AritraD11/NarrowAisleBot/data/bench_logs/README.md

# NarrowAisleBot — Bench & Ground Test Log

Every telemetry CSV pulled off the Pi, plus a full analysis (report + plots)
for each, generated with `tools/analyze_bench_log.py`. This is the running
record for the PID/feedforward calibration effort — see
`docs/PID_Calibration.md` for the derivation these runs feed, and
`docs/Research_Journal.md` Part XVI for the narrative.

**Branch:** all calibration work (CSVs, analysis, gain updates) lives on
`claude/nab-hardware-calibration`.

## Layout

```
data/bench_logs/
  bench/              wheels in the air, robot on blocks
    run_*.csv
    analysis/
      run_*.md         per-run report
      run_*_tracking.png
      run_*_error_pwm.png
  ground/              robot on the floor, real load
    run_*.csv
    analysis/
      (same structure)
```

## How a new CSV gets in here

```bash
# 1. Pull new files from the Pi (Windows, incremental — skips what you have)
tools\sync_bench_logs.ps1

# 2. Analyze it (writes <name>.md + two PNGs into ./analysis/ next to the CSV)
./tools/analyze_bench_log.py data/bench_logs/bench/run_XXXXXXXX_XXXXXX.csv

# 3. Commit CSV + analysis together, on claude/nab-hardware-calibration
git add data/bench_logs/
git commit -m "..."
```

## Bench runs (wheels in air) — summary

| Run | Date | Firmware | Type | Worst RMS error | PWM sat | Sign faults | Verdict |
|---|---|---|---|---|---|---|---|
| [`run_20260702_183233`](bench/analysis/run_20260702_183233.md) | 2 Jul 2026 | v2.0, shared CPR=93132 | live drive | RR 4.5% of peak | 0% | 0 | Loop healthy under old gains. **Not usable to tune v3.0** — predates the per-motor CPR fix and is a continuous drive, not isolated steps. |
| [`run_20260804_193703`](bench/analysis/run_20260804_193703.md) | 4 Aug 2026 | v2.0, post encoder/CPR fix | live drive | RL 2.4% of peak | 0% | 0 | First run on the corrected encoder path. Confirms hardware health, still not isolated steps. |
| [`run_20260805_140048`](bench/analysis/run_20260805_140048.md) | 5 Aug 2026 | **v3.0** — recalibrated gains, two-term FF, per-motor CPR | scripted steps | RR 1.4% of peak | 0% | 0 | **Best tracking yet.** Confirmation run before the Block 1 plant/staircase/steps calibration sequence. |

Trend: worst-motor tracking error has gone 4.5% → 2.4% → 1.4% across the three runs, tracking each firmware/hardware fix in order (encoder/CPR fix, then the v3.0 gain recalibration). None of the three is a step-response or PWM-staircase test, so none of them can be used to *fit* `Kff`/`Ki`/τ — that's what `tools/nab_pid_logger.py`'s `plant`/`staircase`/`steps` tests are for. These three are the "is the loop healthy" checkpoints along the way.

### Plant ID and `Kp` verification, 14 Sep 2026

The run that finally *is* a step-response test, plus the closed-loop sweep
that checked what it implied before anything got flashed. Full derivation
and the reasoning: `docs/PID_Calibration.md` §5.

| File | What it is | Result |
|---|---|---|
| [`plant_20260914_164105.csv`](bench/plant_20260914_164105.csv) | Open-loop, PID bypassed, 6 PWM steps per motor | `K` measured to within 0.5% of the existing feedforward fit; τ ≈ 0.09 s by the tool's pre-send timing, ≈ 0.04 s by an independent timestamp-relative refit, see the caveat below |
| [`sweep_kp45_ki250_kd0.5_20260914_164953.csv`](bench/sweep_kp45_ki250_kd0.5_20260914_164953.csv) | Closed-loop steps, shipped gains (baseline) | Mean overshoot **0.107 rad/s** |
| [`sweep_kp22_ki250_kd0.5_20260914_165007.csv`](bench/sweep_kp22_ki250_kd0.5_20260914_165007.csv) | Closed-loop steps, `Kp` recomputed from the robust τ | Mean overshoot **0.164 rad/s**, +54% |
| [`sweep_kp26_ki250_kd0.5_20260914_165022.csv`](bench/sweep_kp26_ki250_kd0.5_20260914_165022.csv) | Closed-loop steps, `Kp` recomputed from the raw τ | Mean overshoot **0.153 rad/s**, +43% |

All four overshoot and steady-state-error figures were independently
re-derived from the raw CSVs (plateau-windowed on the true setpoint sequence
rather than trusting the console printout) and matched the tool's own
output exactly. `Kp = 45` wins on overshoot in 16 of 16 setpoint-motor rows
against both candidates. **Verdict: `Kp` stays at 45.** Nothing was flashed.

**The τ discrepancy, and why it doesn't matter here.** The plant CSV's own
timestamps are heavily batched: about 69% of consecutive samples share a
near-identical arrival time, with the gap concentrated into roughly every
third sample (~60 ms), rather than the nominal 20 ms telemetry period
being evenly spaced. Refitting τ relative to when the PWM column itself
changes (immune to the Pi-side pre-send latency the tool's own timing
includes) gives τ ≈ 0.04 s, about half the tool's ≈ 0.09 s. Neither number
is resolvable to better than roughly one telemetry burst period given this
batching, and it does not change the outcome: both readings imply a `Kp`
below the shipped 45, and both implied candidates already lost the
closed-loop sweep. The open-loop number was never what closed this
objective: the sweep was.

## Ground runs (on the floor)

| Run | Date | Firmware | Type | Worst RMS error | PWM sat | Sign faults | Diagonal dev. |
|---|---|---|---|---|---|---|---|
| [`run_20260806_152810`](ground/analysis/run_20260806_152810.md) | 6 Aug 2026, 15:28 | v3.0, air-calibrated gains | live drive, full weight | RL 4.0% of peak | 0% | 0 | 0.036/0.035 rad/s |
| [`run_20260806_183540`](ground/analysis/run_20260806_183540.md) | 6 Aug 2026, 18:35 | v3.0, air-calibrated gains | live drive, full weight | RR 3.1% of peak | 0% | 0 | 0.044/0.044 rad/s |
| [`run_20260806_184938`](ground/analysis/run_20260806_184938.md) | 6 Aug 2026, 18:49 | v3.0, air-calibrated gains | live drive, full weight | FL 4.1% of peak | 0% | 0 | 0.045/0.045 rad/s |

All three: loop stable on real ground, zero saturation, zero direction-sign faults. Diagonal deviation (matched-target samples — see below) is tight and consistent across all three sessions, several hours apart: **0.035–0.045 rad/s**, no sign of a per-wheel hardware asymmetry.

**Ground-load Kff gap — confirmed real, size is noisier than the first estimate.** The first run's three matched-amplitude plateaus gave a clean +12–15% (`run_20260806_152810` report). Checking the same matched levels across the two later runs tells a messier story: individual plateaus range from **+1% to +24%** above the air baseline, not a tight band. Plausible cause: casual driving covers different physical patches of floor and headings, unlike a staircase test held in one spot — floor-texture variation is now a real suspect alongside pure weight-loading. **This is exactly the reason the structured `staircase` test matters more, not less** — it isolates the measurement from this location-dependent noise by holding position while sweeping PWM, rather than averaging over wherever the robot happened to be driving.

See the `run_20260806_152810` report for the full matched-plateau method and the steady-state ripple investigation (still unconfirmed cause, present in all three sessions — reproducible, not a one-off).

## What every analysis checks

`tools/analyze_bench_log.py` runs the same checks by hand-analysis converged
on across these three runs:

- RMS tracking error, absolute and as % of peak commanded velocity
- PWM saturation % and headroom
- Direction-sign mismatches (target/actual opposite sign at speed — the
  tell for a `MOTOR_DIR_SIGN`/`ENC_DIR_SIGN` fault)
- Diagonal-pair deviation (FR−RL, FL−RR), **restricted to matched-target
  samples** (|Δtarget| < 0.1 rad/s) — same-sign alone isn't tight enough:
  blended joystick input (forward+strafe+turn together) can put a
  same-sign diagonal pair at genuinely different targets, and the
  resulting actual-velocity gap is then correct tracking, not a fault.
  Caught twice on this project now: first as same-sign vs. opposite-sign
  (rotation), then as same-sign-but-different-magnitude (blended driving)
  — see `docs/Research_Journal.md` Part XVI §16.2. The tool applies the
  matched-target filter by default.
- Sample-rate / gap check
- Embedded-timestamp sanity: does `pi_time_s` decode to a plausible date
  that matches the filename (the Pi has no battery-backed RTC — Part XVI
  §16.4 — so this is checked on every run, not assumed)
