AritraD11/NarrowAisleBot/cad/renders/README.md

Real CAD renders exported from SolidWorks. Commit the .JPG/.PNG files here.
