AritraD11/NarrowAisleBot/docs/aps_report/v2_src/README.md

# How the restructured report was built

`../APS Report Aritra - restructured.docx` is the September document regrouped
around the three strands rather than around the sections of a methods-and-results
paper. The prose that already existed is copied out of the previous file run for
run rather than retyped, so nothing that has already been read changes by
accident; the new material is in `content.py` in quotes, and everything else is a
paragraph index into the old document.

```
content.py      the figure plan, the abstract, and the body as a list of
                elements: new prose, reused paragraphs, figures, tables, equations
build_v2.py     turns that list into the .docx, and refuses to write if a check fails
_tables_eqs.py  the four tables and four native Word equations, lifted unchanged
                from final_src/build_report.py
qa.py           the checks, run against the written file rather than the source
pages.json      the real page of every heading, measured off a rendering
headings.json   every heading in document order, written by the build
```

Build:

```
NAB_BASE=<the September .docx> NAB_MEDIA=<its unzipped word/media> \
    python3 build_v2.py
```

## Source documents

Three documents outside this folder supply the material and are read, not
guessed at:

| | |
|---|---|
| `IoT Box Project Report.docx` | Chapter 2: the bill of materials, the protocol design, the control law, the thresholds and the verified defect register |
| `BB701 Full Proposal 25D0074.docx` | Chapter 3: the framework, the hardware, the fusion design, the validation plan and the graphical abstract used as Figure 20 |
| `docs/An Omnidirectional Asymmetric Mobile Robot for Narrow Aisle Spaces.pdf` | Chapter 1: the two chassis variants and the kinematic schematic, reproduced as Figure 1, and the transformation checked against the firmware |

## Structure

| | |
|---|---|
| Abstract | new, and placed before the contents |
| Introduction | the aisle constraint, why mecanum, why asymmetric, what the prior work left open, then the two supporting strands and the five objectives |
| Chapter 1 | the narrow-aisle robot, design rationale through to its own conclusion |
| Chapter 2 | the environmental monitoring system |
| Chapter 3 | the proposed contactless fatigue work |
| Chapter 4 | what year one established, what is open, and the plan for all three |

The old Chapters 5 and 6 are Chapter 1's sections 1.3 to 1.16, in the same order
and with the same content, so every cross-reference in the reused prose had to
move. Each move is a `(find, replace)` pair in `build_v2.py`, the number of times
each one fired is printed, and the build asserts that no reference to the old
numbering survives anywhere in the finished document.

## What is new rather than moved

Section 1.6 is the only substantial new body text: the velocity loop, and where
each gain came from, written against `aislebot_esp32.ino` rather than against any
earlier description of it. It states plainly that the proportional gain was
derived from an assumed plant time constant of 0.18 s, that the measured constant
turned out to be about 0.09 s, and that the gain was kept anyway because two
recomputed values were tested against it across sixteen setpoint-and-motor
combinations and both overshot more.

Chapters 2 and 3 gain their own motivation, literature, method and conclusion
sections. The Introduction and Chapter 4 are new throughout.

## Figures

Twenty, renumbered in document order. Fourteen are the previous document's,
placed at the same widths. Six are new, and five of those are generated by
`../figure_src/`:

| | |
|---|---|
| `f_priorpaper.py` | Figure 1, the prior work's own chassis variants and kinematic schematic |
| `f_priorkin.py` | Figure 2, the two wheel layouts and the transformation each implies |
| `f_pidloop.py` | Figure 7, the velocity loop as the firmware runs it |
| `f_iotarch.py` | Figure 17, the monitoring architecture |
| `f_iotlaw.py` | Figure 18, the control law and the verified defect register |
| `f_iotphotos.py` | Figures 16 and 19, the hardware and dashboard plates |
| `f_fatigue.py` | Figure 22, the objectives and what each is measured against |

A three-strand roadmap figure was drawn and then dropped, along with a section
that described where the strands would converge. Both put dates against work
that depends on securing a test space, on a sensor arriving and on a result
that may come back negative, and both asserted a convergence the evidence does
not support. Chapter 4 now orders the work by what unblocks what, and says so.

They share `dg2.py`, which is a second diagram toolkit alongside `dg.py`. The
difference is the face: block diagrams are set in STIX serif with matching
mathtext so an equation inside a box sets the same as the same equation in a
paragraph, while the plots stay on `dg.py`'s sans, where a serif would fight the
axis labels.

Figures 20 and 21 come out of the research proposal for the fatigue strand.
Both were generated for it with an AI tool, kept at the author's request; each
caption says so, and the tool's watermark is left in place rather than cropped
out. Figure 21 replaced that proposal's graphical abstract, which covered less.

`fix_infographic.py` repairs two defects in Figure 21 before it is placed. It
read "IR thremometer", and it claimed the data-protection compliance was
"(verified)" for work whose own chapter says nothing has been built. The
replacement line is set at a size and weight matched to the neighbouring bullet
by measuring the original's glyph band and ink coverage, so the repair is not
visible at the size the figure is placed.

## Three diagrams were checked against the firmware before being redrawn

Three rendered diagrams were supplied for inclusion. Two carried errors and are
corrected here.

**The velocity loop.** The feedforward was written with its two coefficients on
the wrong terms and the velocity symbol mangled, so the static gain multiplied
the velocity and the viscous gain multiplied its sign. The firmware's model is
`Kff·ω + Kstat·sgn(ω)`. The loop rate was also missing; it is 100 Hz.

**The monitoring architecture.** It showed the MQTT broker receiving Wi-Fi, LoRa
and SMS. Nothing supports that. The long-range radio is read from its gateway by
a dedicated service that writes straight to the database, and the cellular
channel delivers a message to a person and is never ingested at all. Both are
corrected, and the radio parameters from `figure_src/f_iot.py` are added.

**The deployed electronics.** It showed `PID @ 50 Hz · Kp50 Ki30 Kd3`. Those are
the bench-calibration sketch's defaults (`firmware/nab_bench_calibration_esp32.ino`),
not the deployed firmware's, which is 100 Hz with Kp 45, Ki 250, Kd 0.5. Its
title band was also overprinted. That version was placed into the September
document as image4; Figure 5 here uses the repository's own
`docs/hardware/nab_circuit_diagram.png`, which is already correct on both
counts. The supplied version's pin map and encoder channel map were checked
against `aislebot_esp32.ino` and are right.

**A fourth correction, found later.** Once the monitoring project's own report
was available, the earlier architecture figure turned out to be wrong in two
further ways and a fifth claim turned out to be stale. The cellular channel is
bidirectional, not outbound: the node accepts the same command vocabulary on
every channel including short messages. There are two dashboard control
endpoints, not one, selected at runtime by a dashboard variable. And the claim
that the fan tachometer never divides by its sample window, which appears in an
earlier audit figure, was checked against the source and is incorrect; the
residual error is a small high bias from loop latency. Figures 17 and 18 are
drawn from the verified register rather than from the earlier summary.

## The contents

The page numbers are measured, not typed. The build writes the document, a
rendering of it is read back and the page of every heading found by its face
rather than by its words (the contents repeats every heading verbatim, so a text
match finds the contents instead), and the build runs again with those numbers.
`qa.py` then checks each printed number against the render, and the render is
confirmed to be a fixpoint: adding the numbers does not move anything.

Carlito and Caladea are installed for the rendering, so LibreOffice substitutes
metric-compatible faces for Calibri and Cambria rather than DejaVu. With Times
New Roman already metric-compatible with Liberation Serif, the render is close to
what Word will produce, though not guaranteed identical.

## What the two checkers check

`qa.py` checks the structure:

1. Figure captions run 1 to 20 with no gap and no repeat.
2. Every `Figure N` in the prose points at a caption that exists, and every
   figure is referred to at least once outside its own caption.
3. Every `Section N.M` and `Chapter N` in the prose points at a heading that exists.
4. No reference to the old numbering survives.
5. No banned wording and no em dash.
6. Every placed picture, with the density it is placed at.
7. Every page number in the contents against the render.

`proof.py` reads the same file for what a careful reader would catch: a word
typed twice, a double space, a space before a full stop, a straight apostrophe,
an em dash, a bracket left open, an American spelling in a document written in
British English, a banned word, a dangling cross-reference, and text repeated
between a caption and the prose beside it. That last check found nine
repetitions, several of them a caption restating its own paragraph verbatim.

## Picture density

Every placed picture sits between 280 and 694 dpi except two, and both have the
same cause:

- **The institute crest**, 150 dpi. No larger copy exists anywhere.
- **Figure 11**, endpoint closure, 199 dpi. The figure exists nowhere in the
  repository, only inside the September document.

The generated figures render at 260 dpi against their own canvas, which lands
between 420 and 540 dpi once placed at full text width. The appliance and
dashboard photographs, which were the two softest pictures in the previous
draft, now come out of the monitoring project's own report at their native size
and are placed inside composite plates, which took them from 115 and 192 dpi to
426.

**Word will recompress the rest on save unless it is told not to.** File, Options,
Advanced, Image Size and Quality: select this document, tick "Do not compress
images in file", set default resolution to High fidelity. Export with "Optimize
for: Standard".

## The register pass

The previous document was written to be read aloud in a review. This one is
submitted for examination, so fourteen sentences in the reused prose are
restated in the third person and without the conversational turn. They are a
list of `(find, replace)` pairs in `build_v2.py` called `POLISH`, each asserted
to fire exactly once; new prose is edited in `content.py` directly. Only
sentences are touched, never a number.

The same pass repairs reference 21, whose exporter left the publisher's name
italicised at the head of the article title rather than at the head of the
venue, and sets the two subscripts that Section 1.5 refers to in running text
as `K_o` and `K_i`, which is how they are typed and not how they are set.

## Captions, tables and equations

A figure caption is one block below its figure: the label in bold, the title
of the figure in italic, the description upright, all at 9 pt. The centred
line that used to sit between picture and caption is gone, because it was a
second and unnumbered title for the same object; the same text is now the
italic title. No caption restates the sentence beside it.

A table caption sits above its table and is numbered by chapter, Table 1.1 to
Table 2.1, and each is referred to by number in the prose rather than as "the
table below".

Display equations are numbered (1.1) to (1.4) against the right margin, set by
a centre tab at half the text width and a right tab at the margin. A set
running over two lines carries one number, on the last line, because the lines
are one statement.

## Chapter 3's figures

Figures 20 and 21 were the two images supplied with the research proposal, both
produced with a generative tool. They are redrawn here as `f_fatproblem.py` and
`f_fatpipe.py` on the same toolkit as every other drawn figure in the report.
The argument each one makes is unchanged; what changes is that the report no
longer contains an image it cannot account for line by line, and the pair no
longer sets its own type and palette against the rest of the document.
