AritraD11/NarrowAisleBot/docs/MPPI_LiDAR_Audit_2026-10-05.md

# MPPI and LiDAR settings audit, 5 Oct 2026

Read from the repo at commit `192038f`. Nothing here was checked on the live
Pi yet except what the earlier steps of this session already confirmed (the
three deployed files, their hashes, odometry at 0,0,0). Section 4 is the
live check that still has to be run.

There is no "perfect" MPPI to compare against. What can be checked is whether
each value is consistent with the measurements we have, and which values are
still guesses. That is what this lists.

## 1. MPPI (`nav2_params.yaml`, `controller_server.FollowPath`)

### Proven by a run

| Setting | Value | Evidence |
|---|---|---|
| Model | `Omni` | strafing and reversing are in scope, and the model samples vx, vy and wz together |
| Speed caps | 0.12 m/s both axes, 0.30 rad/s | the 2 Oct 0.6 m goal ran under them |
| Accel limits | ±3.0, 3.5 | 2 Oct: goal SUCCEEDED in 35 s with these live. With 0.3 / -0.5 / 0.6 the same goal crept at 4.4 mm/s and aborted. Now in the repo (`7472b5e`). |
| `odom_topic` | `/wheel_odom` | verified on the live node 30 Sep. Not the cause of the crawl. |
| Critics | Constraint, Cost, Goal, GoalAngle, PathAlign, PathFollow, Twirling | every one checked axis-agnostic against Nav2 source (header comment). PreferForward and PathAngle are left out on purpose. |
| `consider_footprint` | true | the footprint is 1.12 x 0.48 m, circumscribed radius 0.62 m. A circle would be wrong along the whole length. |
| Goal check | 5 cm, 0.05 rad | the 2 Oct run ended about 5 cm out in odometry |

### Consistent on paper, not yet measured

| Setting | Value | What is open |
|---|---|---|
| Horizon | 40 steps x 0.05 s = 2.0 s | only 0.24 m of lookahead at 0.12 m/s. Fine for a 3 m local costmap, but it was never tuned. |
| Batch | 300 | cut from 500 for the Pi (loop rate). No data on how much 300 costs in path quality. |
| Sampling std | 0.06 / 0.06 / 0.15 | about half the speed cap by design. Never swept. |
| `temperature` 0.3, `gamma` 0.015 | | 0.015 is the stock gamma. Temperature never swept. |
| Real acceleration | unknown | the robot's own limit is not measured. See 2. |

### Mismatches that are known
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
