AritraD11/NarrowAisleBot/docs/APS_10Day_Plan.md

# APS run-up plan — 12 to 23 September 2026

The APS is booked for 23 September, 2:30–3:30 PM, and doubles as the
comprehensive exam. Three objectives go up that day, each with its own repo:

| Objective | Repo | Status going in |
|---|---|---|
| 1. Narrow-aisle warehouse robot (stacking, retrieval, monitoring, disinfection) | `NarrowAisleBot` (this repo) | Priority. Draft report, deck, and study guide already exist and are current to 3–9 Sept |
| 2. IoT warehouse environment monitoring | `IoT-Box` | Not yet reviewed for this report |
| 3. IoT contactless warehouse fatigue monitoring | `Fatigue-Detection-` | Not yet reviewed for this report |

NAB goes first and gets the most days, both because it is furthest along and
because it is the objective with a physical machine a panel can ask hard
questions about.

## Day by day
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
