AritraD11/NarrowAisleBot/docs/Audit_2026-09-15_night.md

# Where this project actually stands, 15 Sep 2026, night

Eight days to APS. 23 Sep, 14:30 to 15:30.

This is an audit, not a status report, so it leads with what is wrong.

---

## 1. The three things to fix first tomorrow

**The revert is not live on the robot.** `~/ros2_ws/slam_nodom.yaml` has the
correct hash (`a6b75d36…`, `use_scan_matching: false`) but `ros2 param get`
still returns `True` because MAP was never restarted. slam_toolbox reads
that file only at launch. Anyone who drives before restarting MAP is driving
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
