AritraD11/NarrowAisleBot/cad/AislebotBasePlatform_SteelChasis.JPG

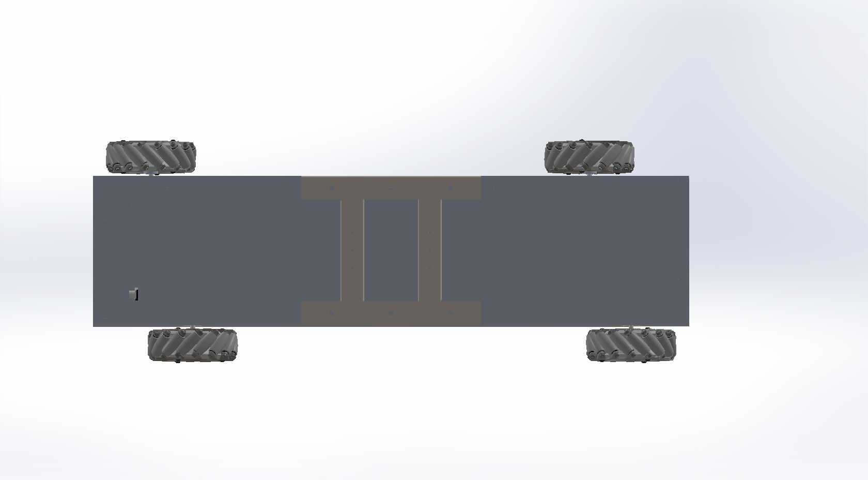
cad/AislebotBasePlatform_SteelChasis.JPG
