AritraD11/NarrowAisleBot/data/bench_logs/bench/analysis/run_20260702_183233_tracking.png

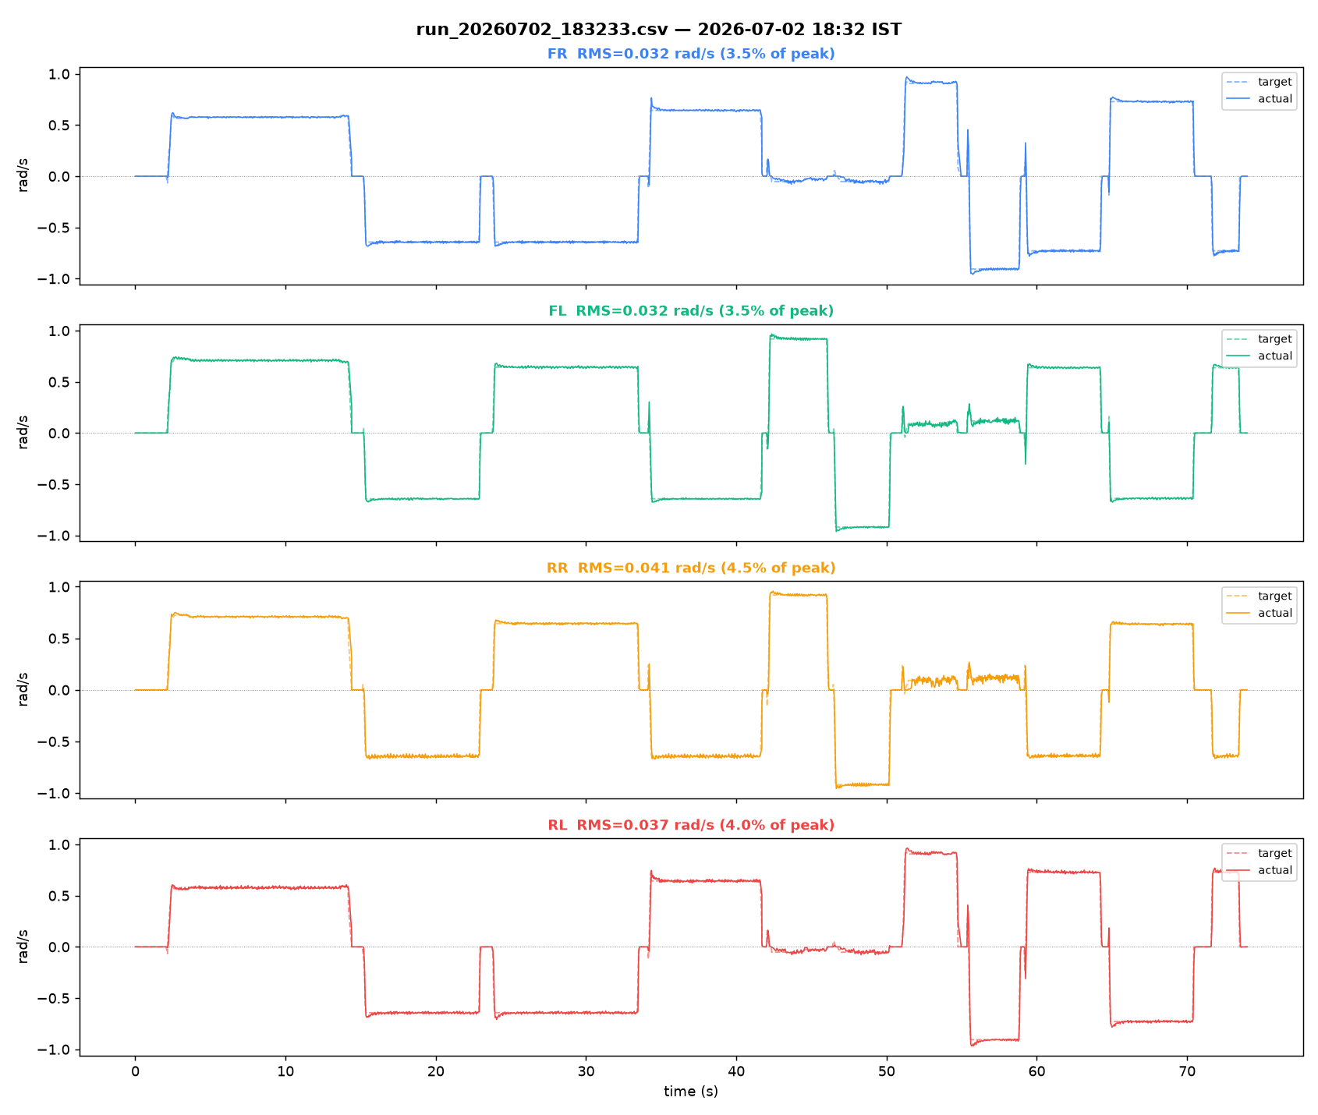
data/bench_logs/bench/analysis/run_20260702_183233_tracking.png
