AritraD11/NarrowAisleBot/data/bench_logs/bench/analysis/run_20260804_193703_error_pwm.png

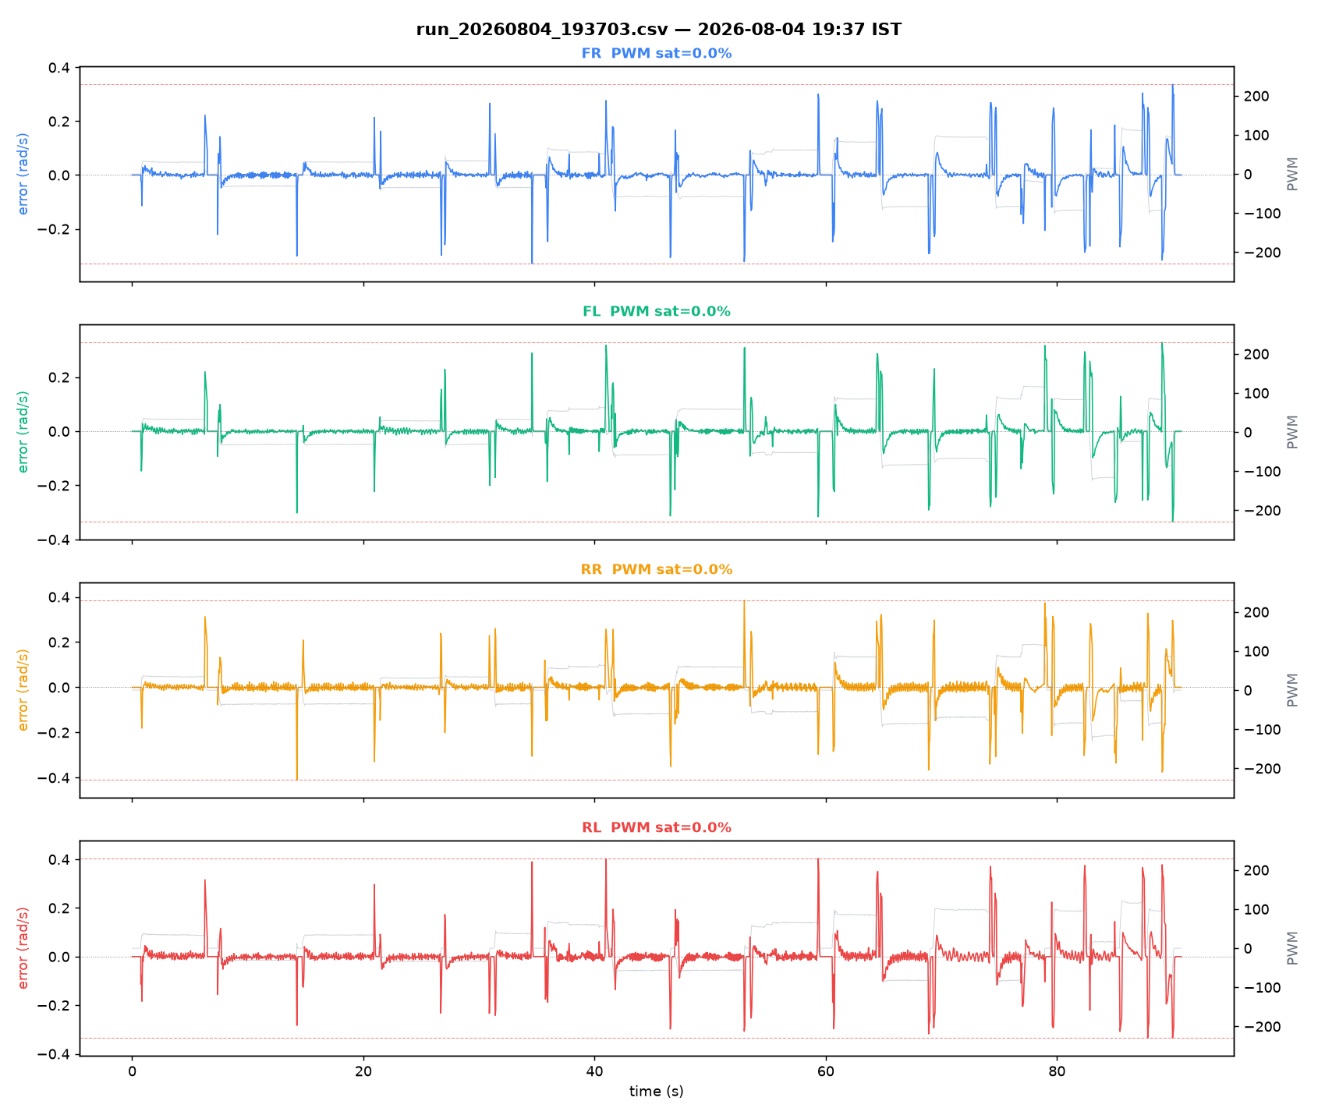
data/bench_logs/bench/analysis/run_20260804_193703_error_pwm.png
