AritraD11/NarrowAisleBot/data/bench_logs/bench/analysis/run_20260805_140048_error_pwm.png

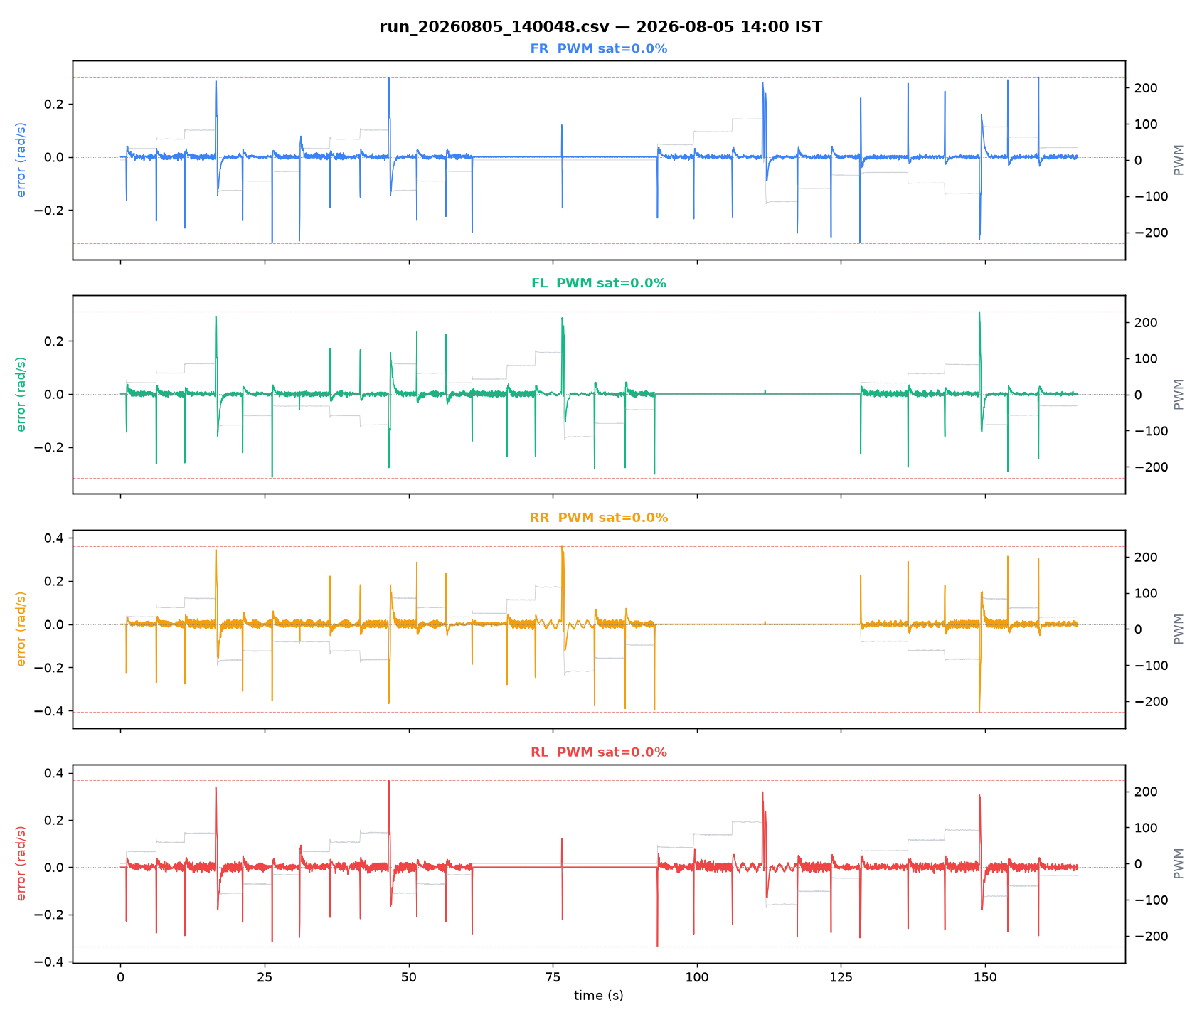
data/bench_logs/bench/analysis/run_20260805_140048_error_pwm.png
