AritraD11/NarrowAisleBot/data/bench_logs/bench/analysis/run_20260805_140048_tracking.png

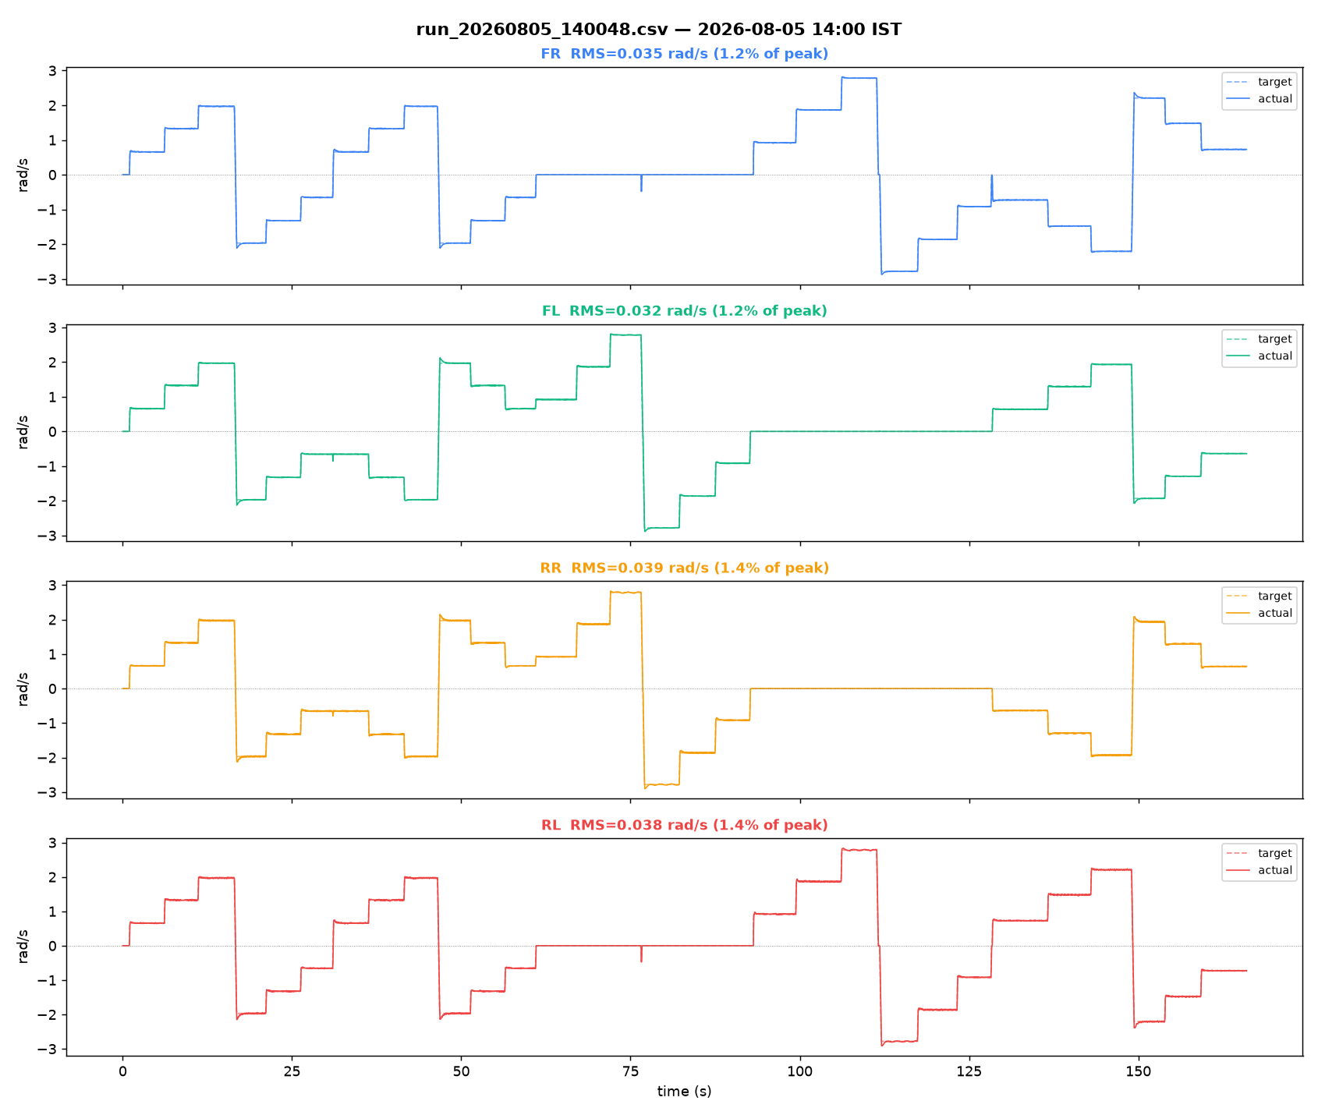
data/bench_logs/bench/analysis/run_20260805_140048_tracking.png
