AritraD11/NarrowAisleBot/data/bench_logs/ground/analysis/run_20260806_152810_error_pwm.png

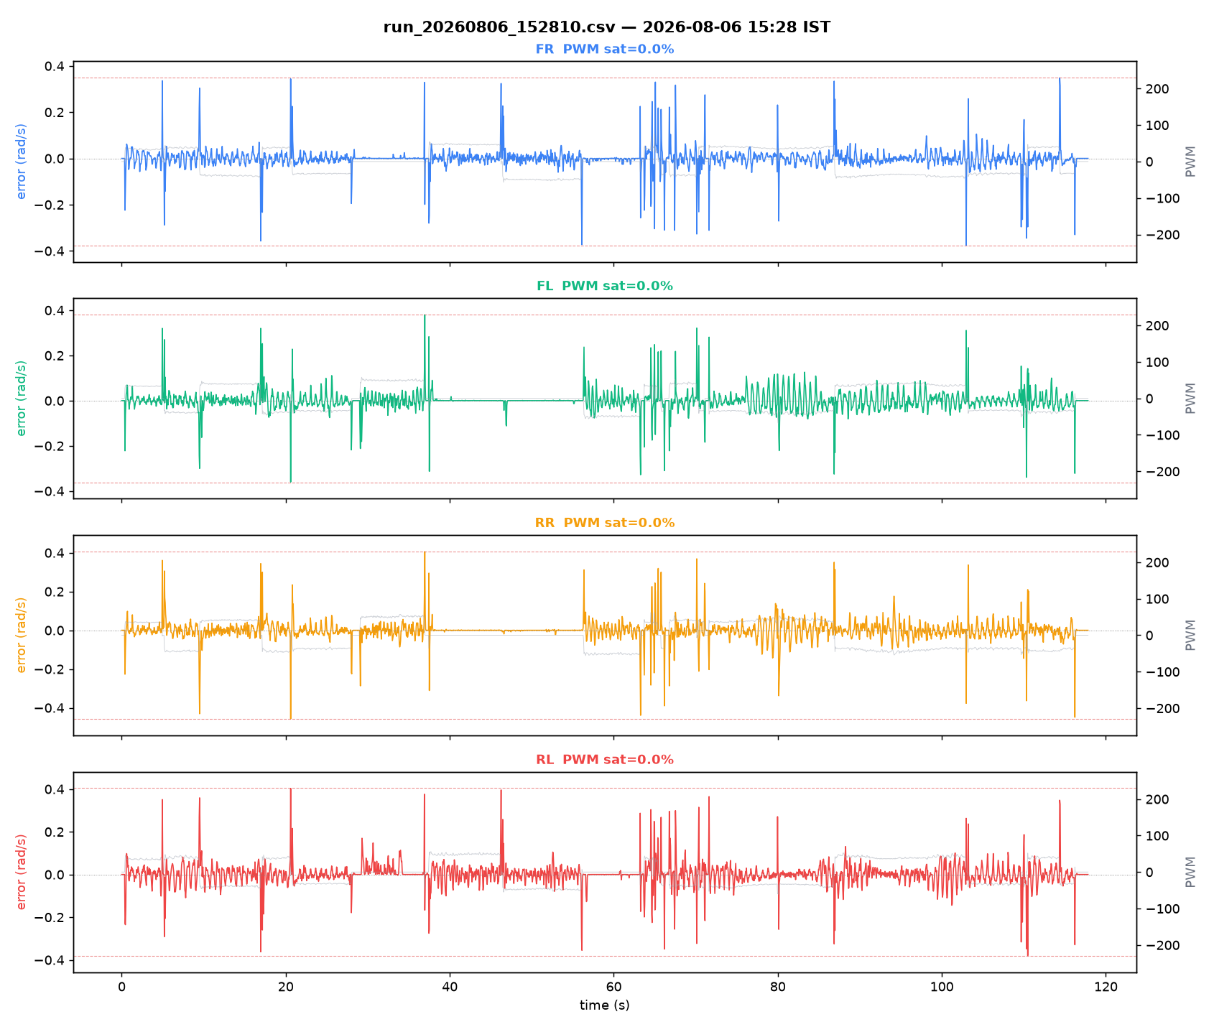
data/bench_logs/ground/analysis/run_20260806_152810_error_pwm.png
