AritraD11/NarrowAisleBot/data/bench_logs/ground/analysis/run_20260806_152810_ground_vs_air.png

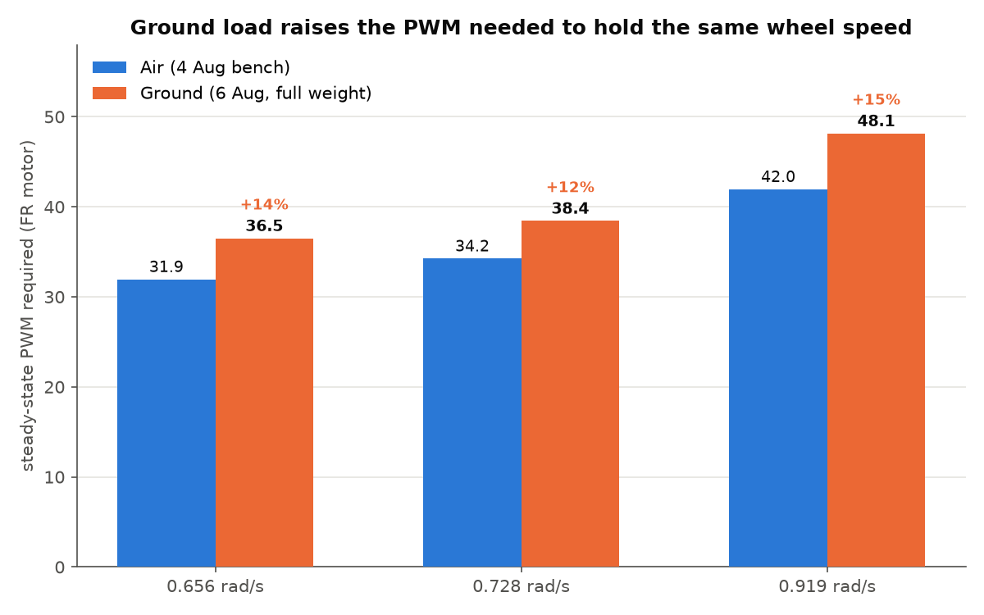
data/bench_logs/ground/analysis/run_20260806_152810_ground_vs_air.png
