AritraD11/NarrowAisleBot/data/bench_logs/ground/analysis/run_20260806_183540_tracking.png

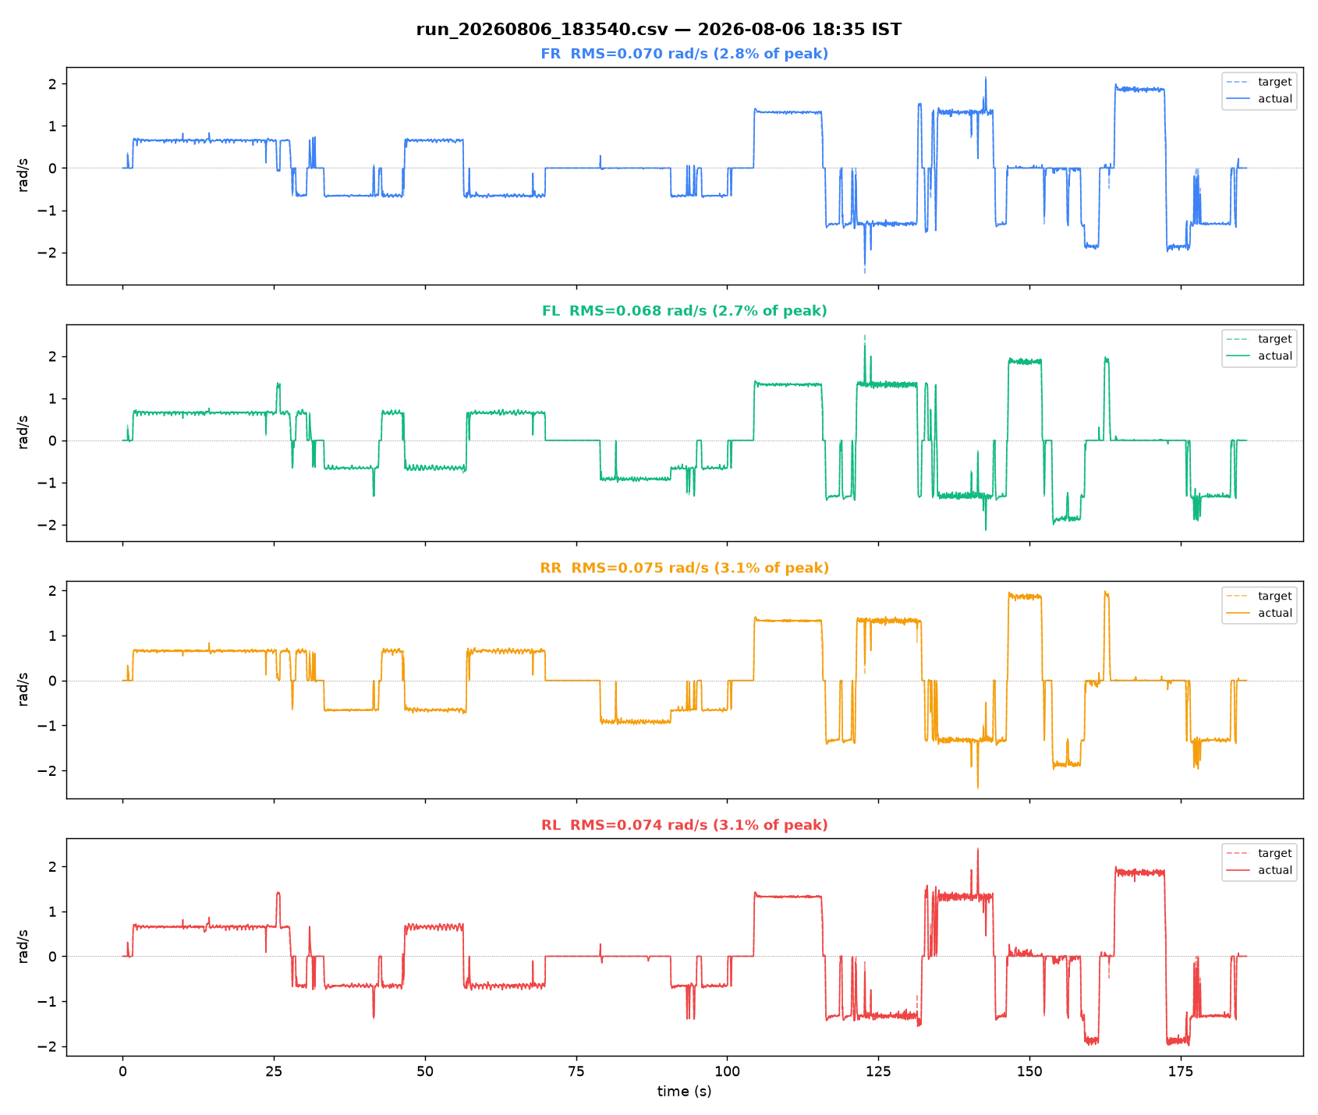
data/bench_logs/ground/analysis/run_20260806_183540_tracking.png
