AritraD11/NarrowAisleBot/docs/aps_report/figure_src/prior_kin.png

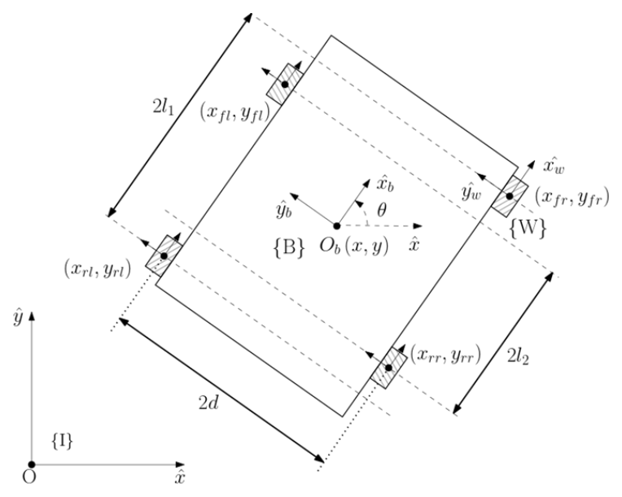
docs/aps_report/figure_src/prior_kin.png
