AritraD11/NarrowAisleBot/docs/aps_report/figure_src/prior_v2.png

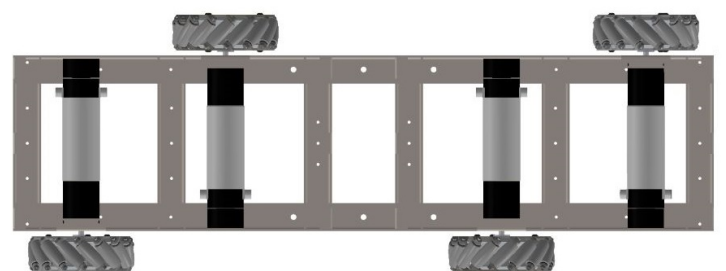
docs/aps_report/figure_src/prior_v2.png
