AritraD11/NarrowAisleBot/docs/aps_report/figures/fig04_control_loop.png

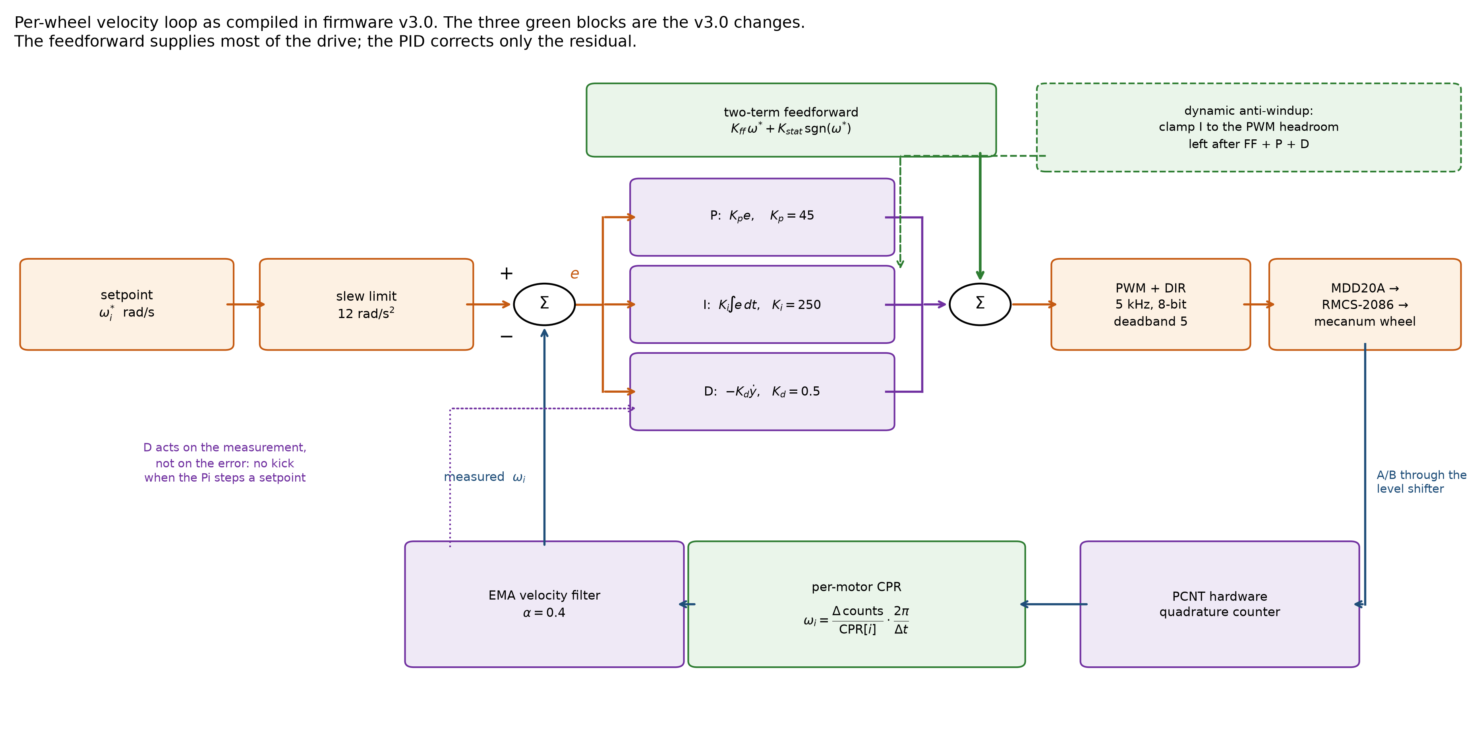
docs/aps_report/figures/fig04_control_loop.png
