AritraD11/NarrowAisleBot/docs/aps_report/figures/fig07_kff_artefact.png

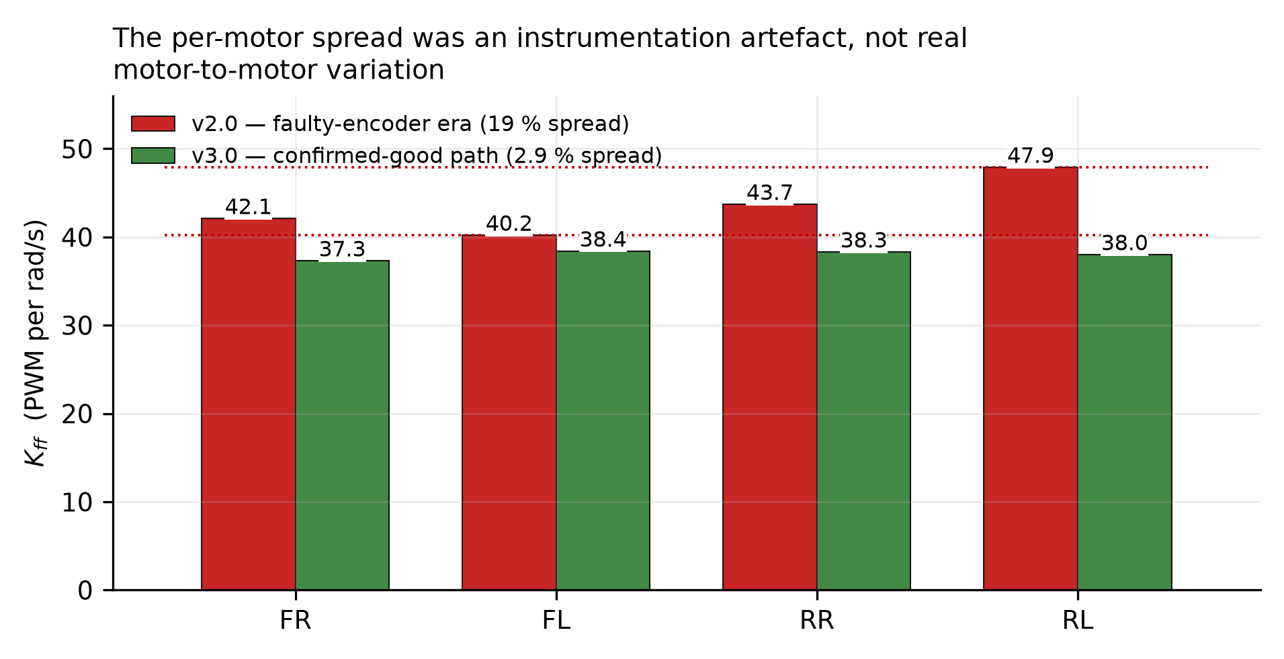
docs/aps_report/figures/fig07_kff_artefact.png
