AritraD11/NarrowAisleBot/docs/aps_report/figures/fig09_tracking_comparison.png

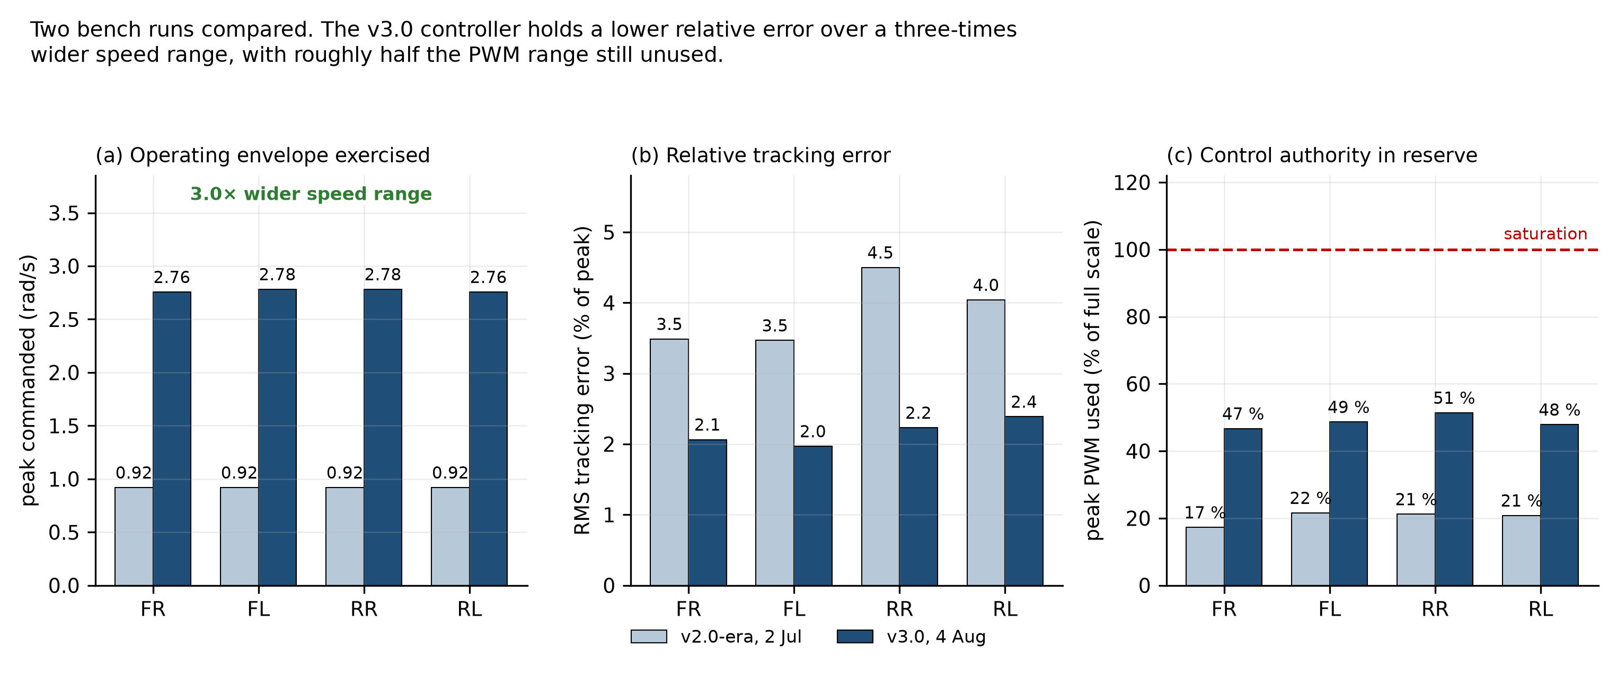
docs/aps_report/figures/fig09_tracking_comparison.png
