AritraD11/NarrowAisleBot/docs/aps_report/figures/fig11_mapping_pipeline.png

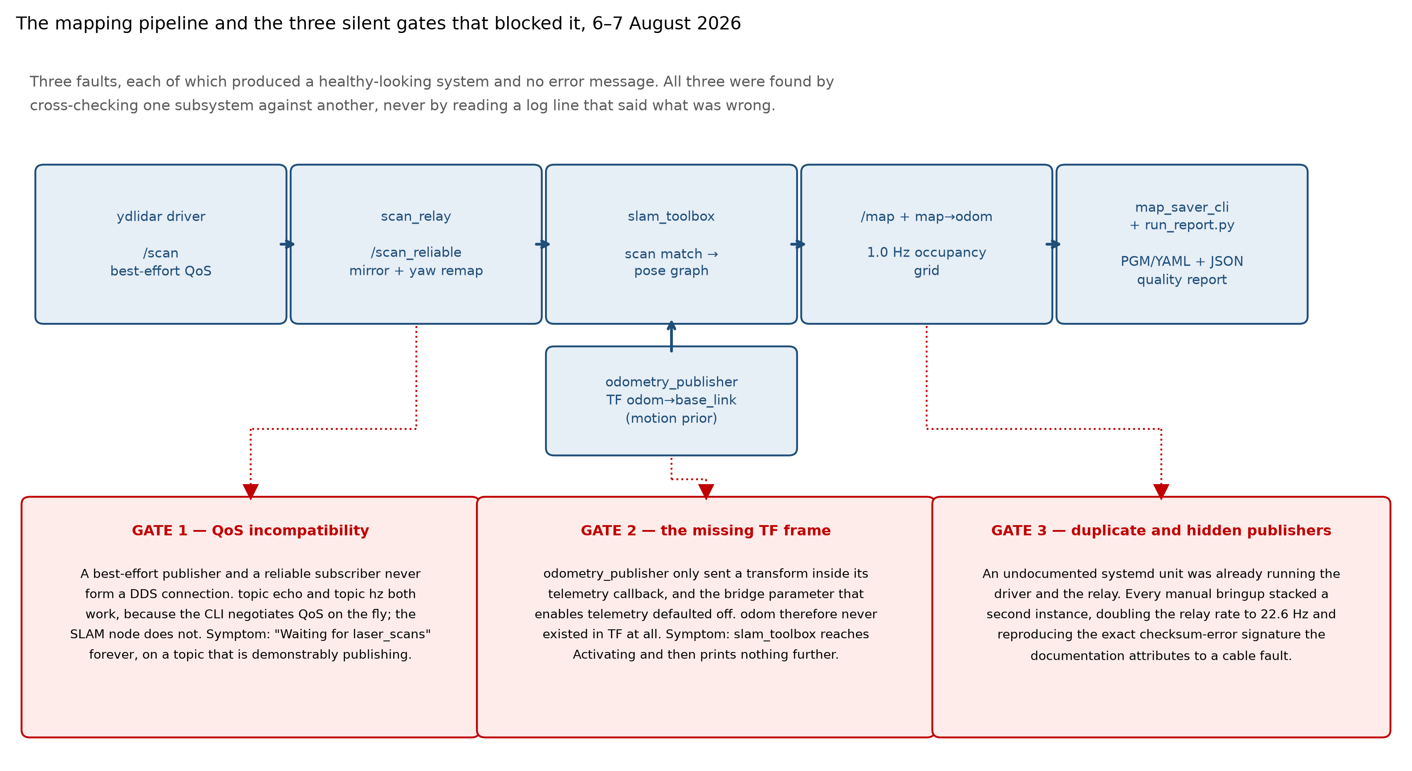
docs/aps_report/figures/fig11_mapping_pipeline.png
