AritraD11/NarrowAisleBot/docs/aps_report/figures/fig13_lidar_mirror.png

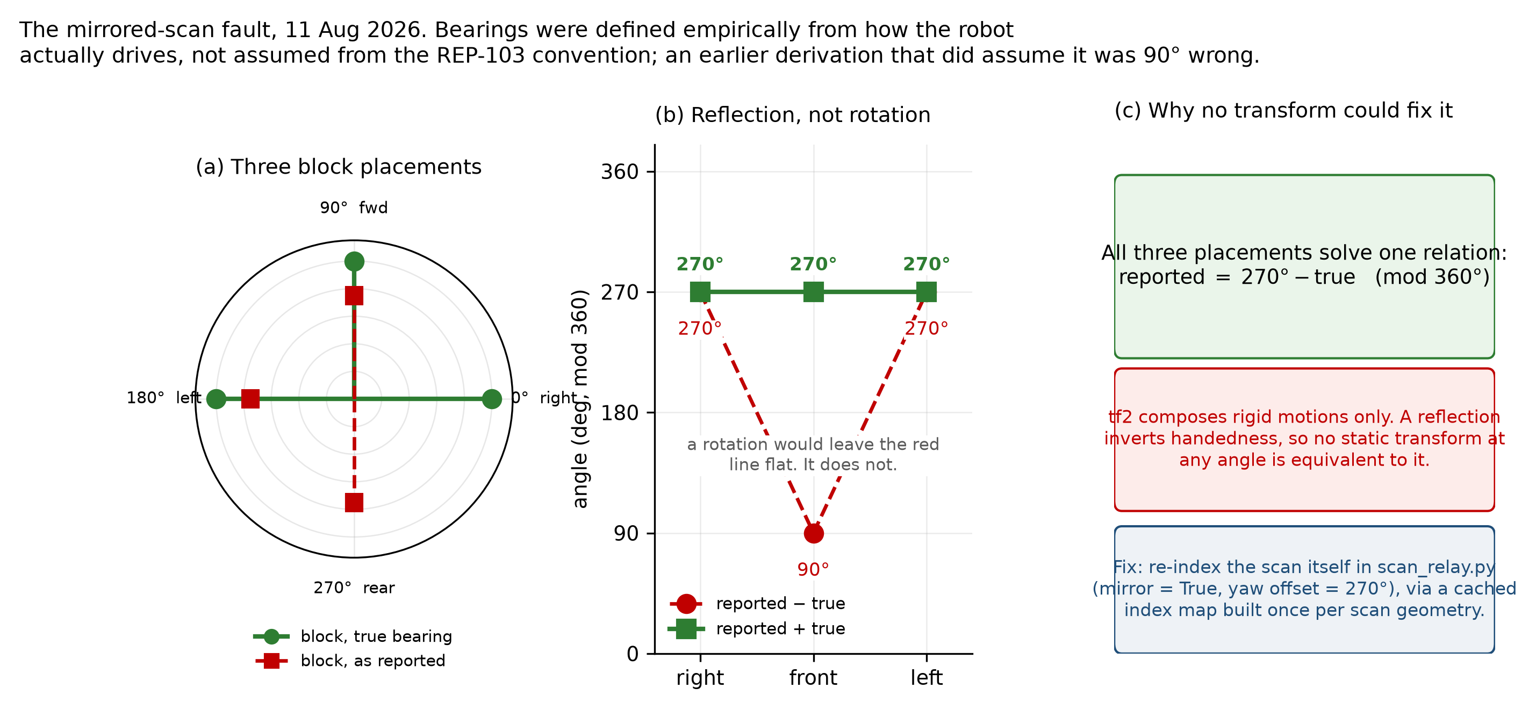
docs/aps_report/figures/fig13_lidar_mirror.png
