AritraD11/NarrowAisleBot/docs/aps_report/figures/fig14_lidar_placement.png

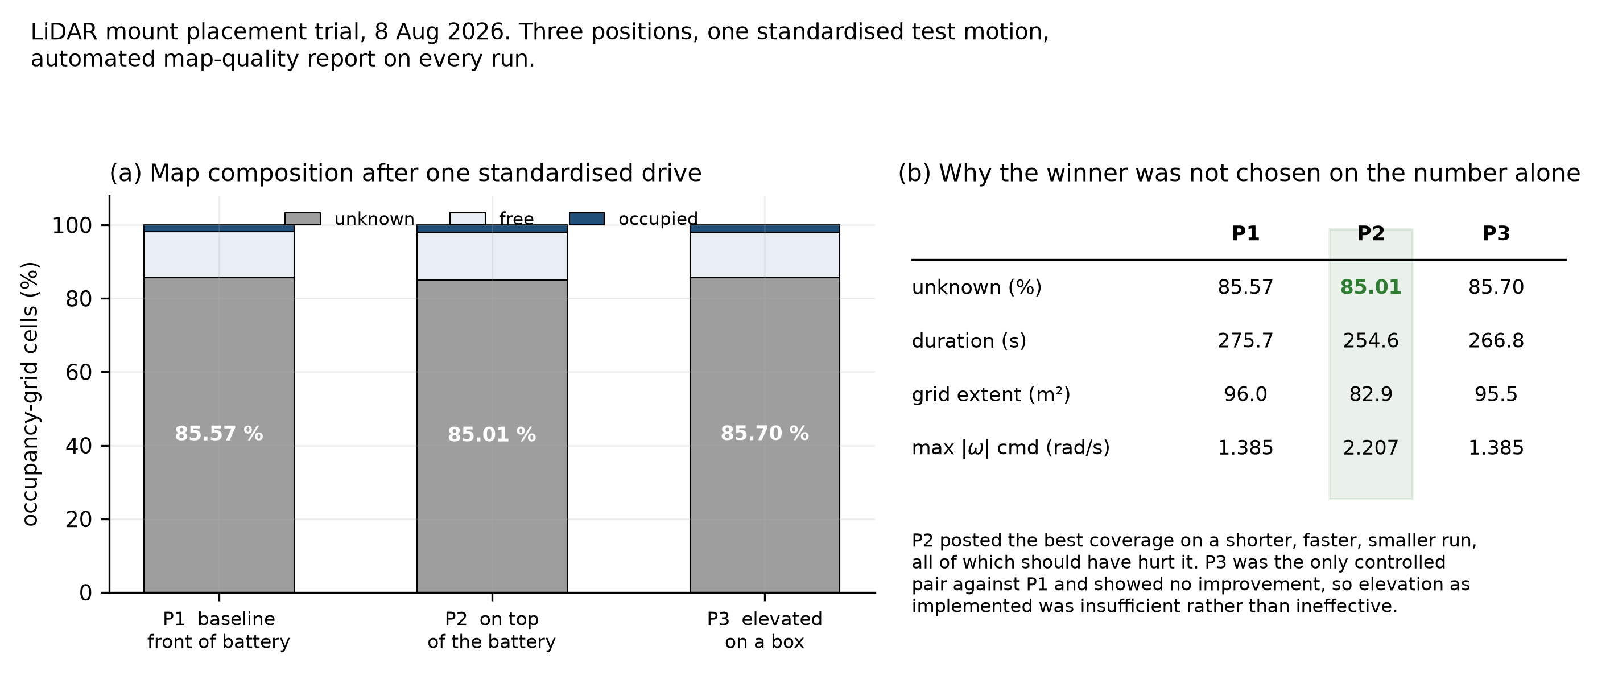
docs/aps_report/figures/fig14_lidar_placement.png
