AritraD11/NarrowAisleBot/docs/aps_report/figures/fig15_map_coverage.png

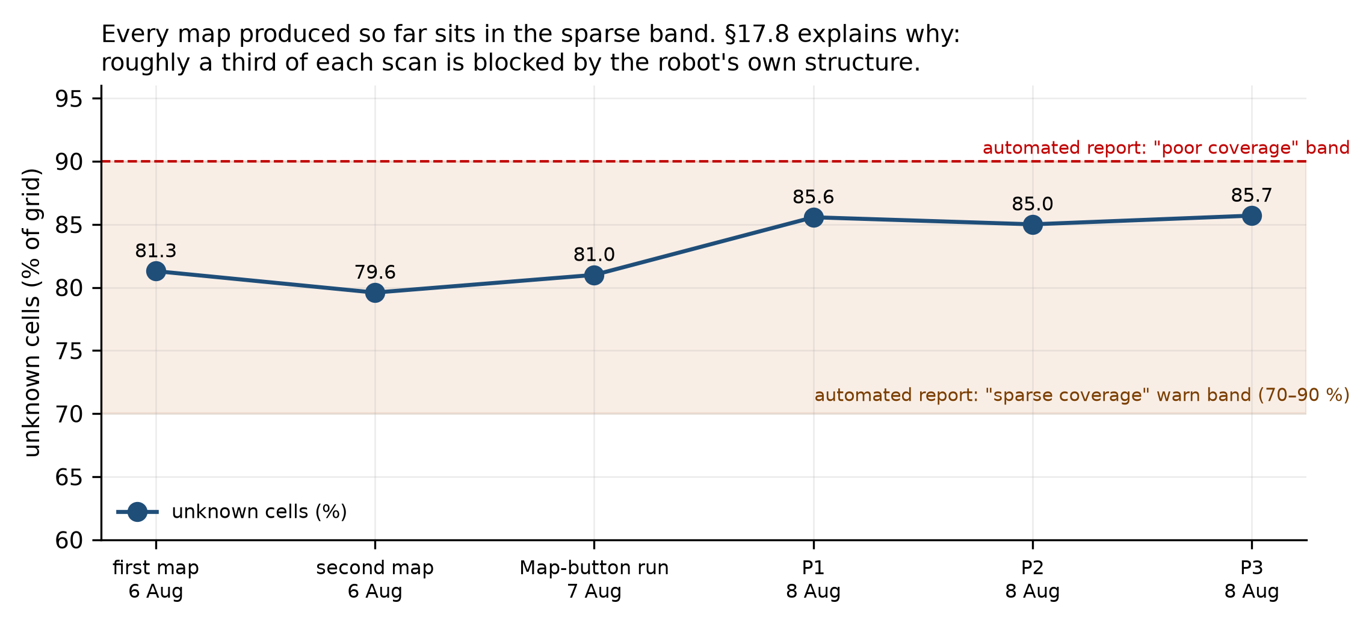
docs/aps_report/figures/fig15_map_coverage.png
