AritraD11/NarrowAisleBot/docs/aps_report/figures/fig20_costmap_inflation.png

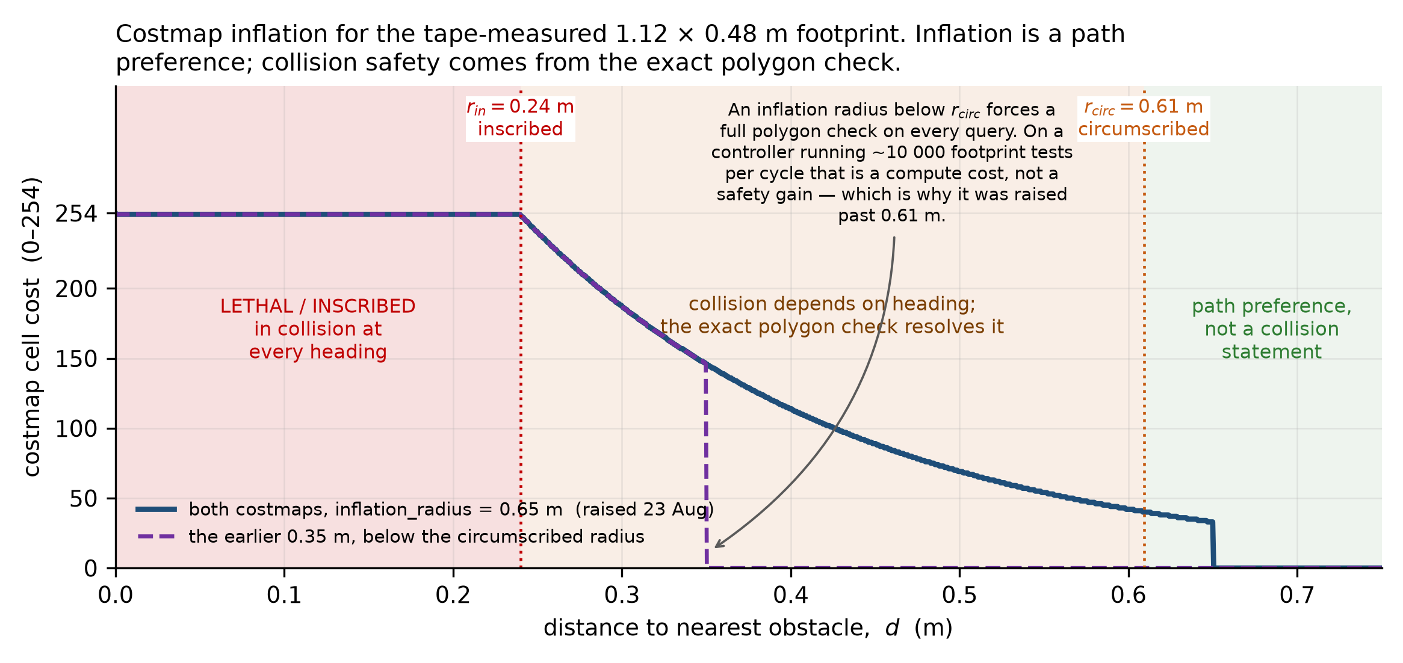
docs/aps_report/figures/fig20_costmap_inflation.png
