AritraD11/NarrowAisleBot/docs/aps_report/figures/fig30_dashboard_screenshots.png

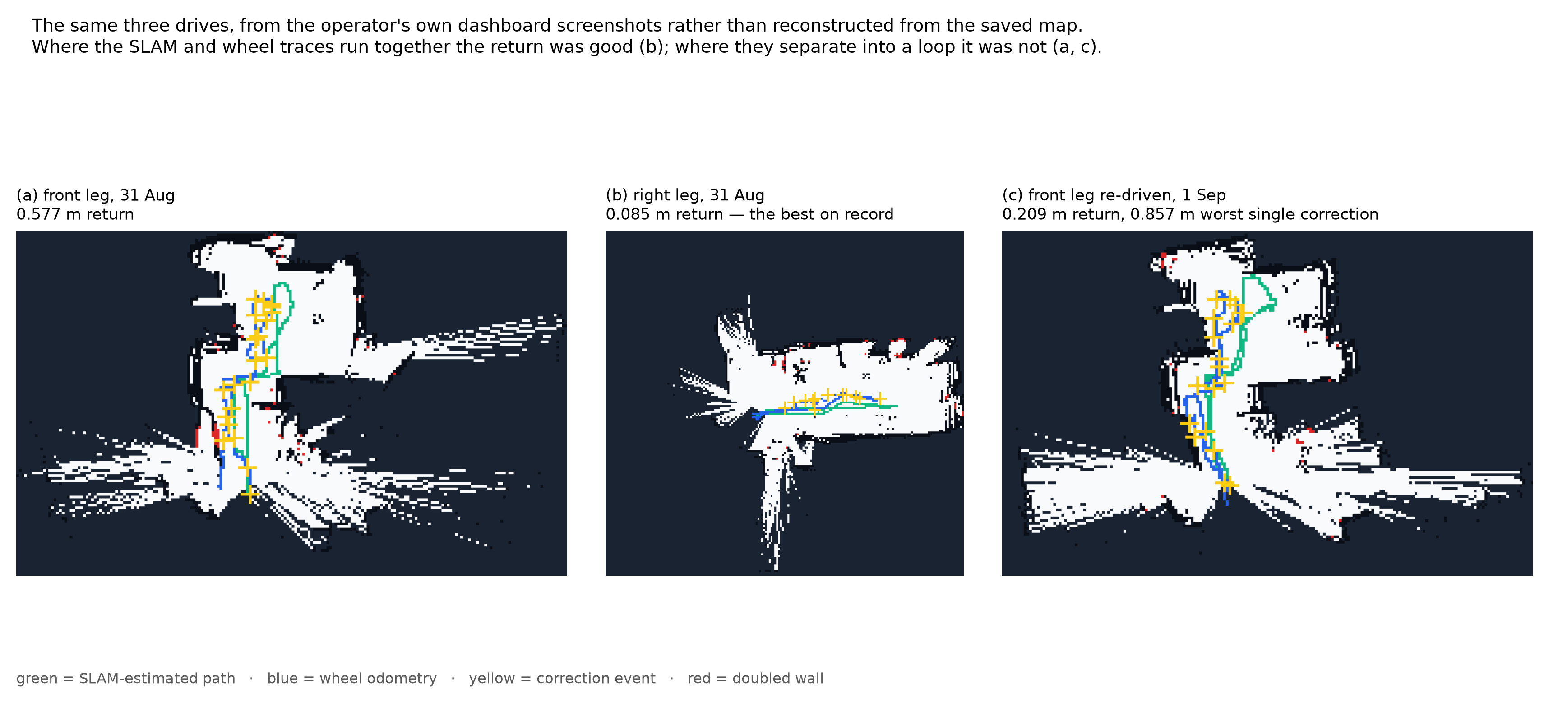
docs/aps_report/figures/fig30_dashboard_screenshots.png
