AritraD11/NarrowAisleBot/docs/aps_report/figures/fig33_pid_loop.png

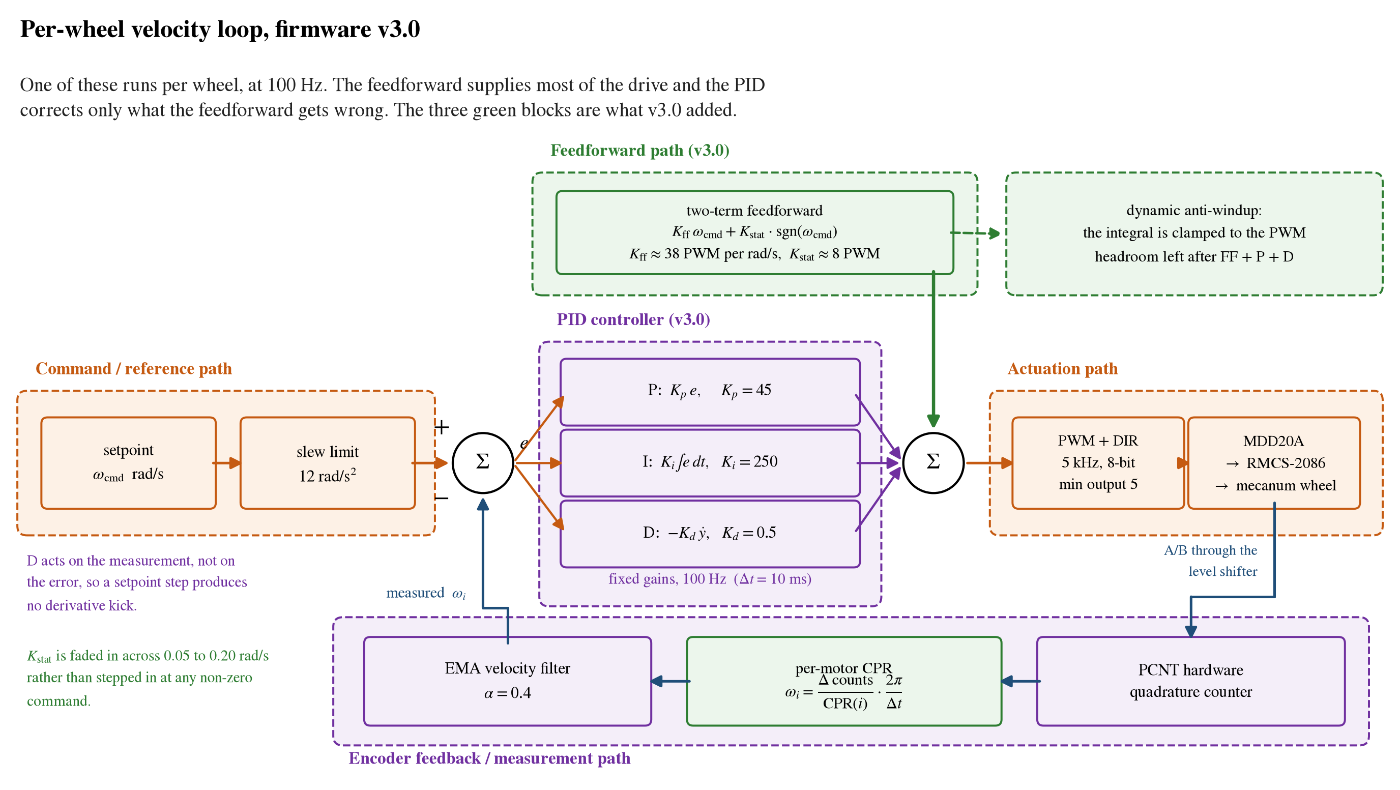
docs/aps_report/figures/fig33_pid_loop.png
