AritraD11/NarrowAisleBot/docs/aps_report/figures/fig33_pid_loop_corrected.png

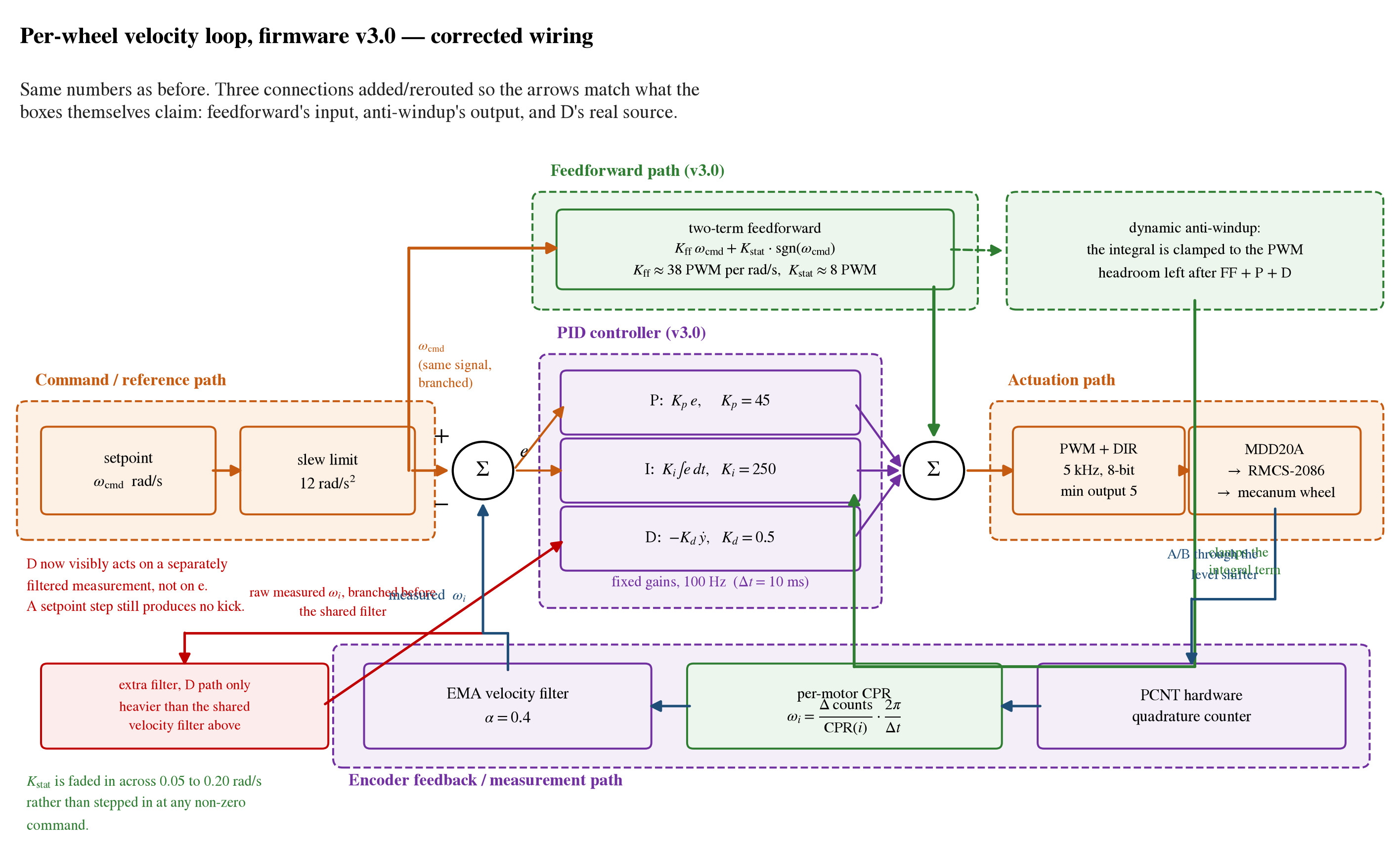
docs/aps_report/figures/fig33_pid_loop_corrected.png
