AritraD11/NarrowAisleBot/docs/aps_report/figures/fig34_iot_architecture.png

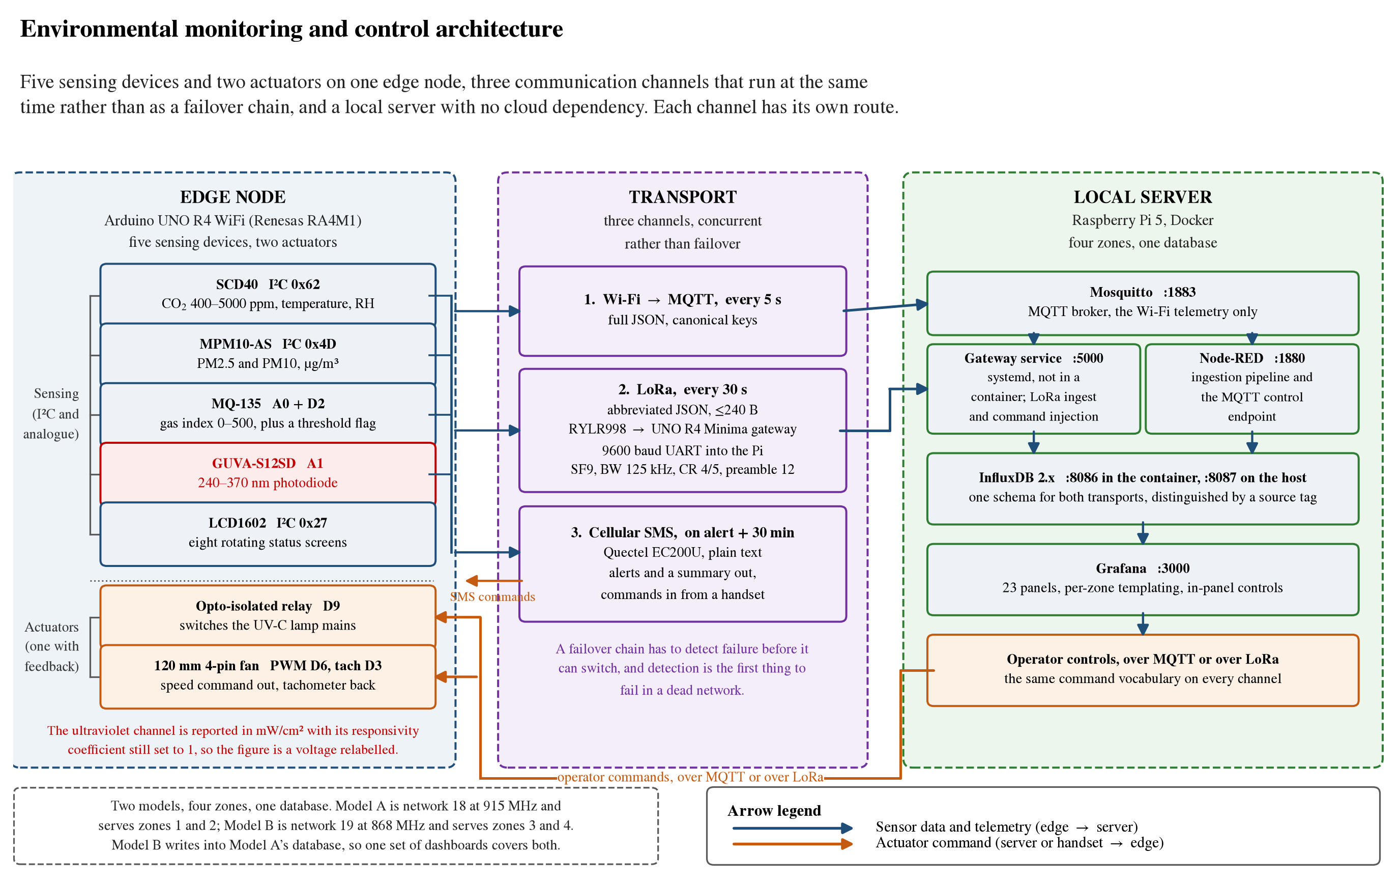
docs/aps_report/figures/fig34_iot_architecture.png
