AritraD11/NarrowAisleBot/docs/aps_report/figures/fig35_prior_kinematics.png

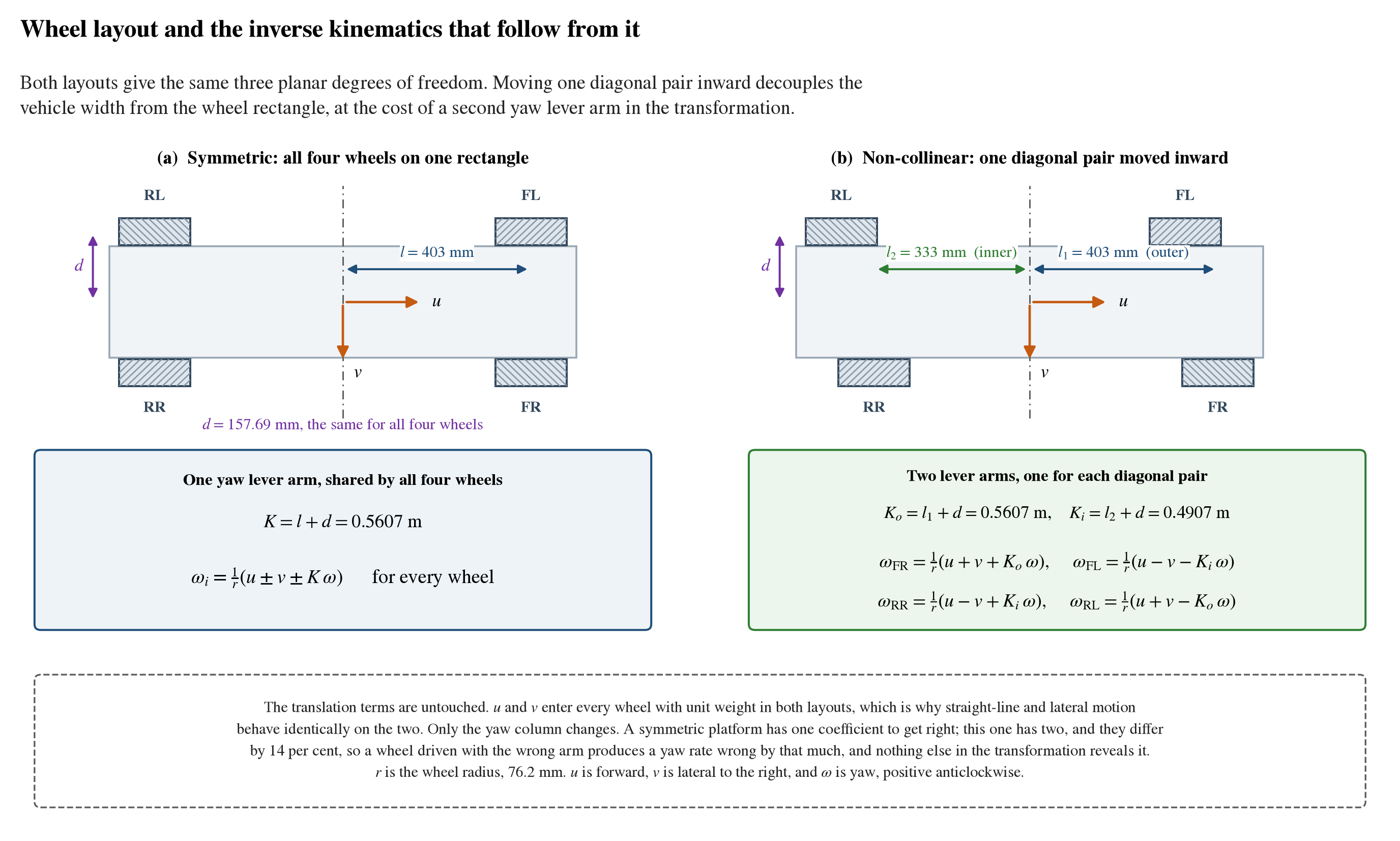
docs/aps_report/figures/fig35_prior_kinematics.png
