AritraD11/NarrowAisleBot/docs/aps_report/figures/fig36_fatigue_design.png

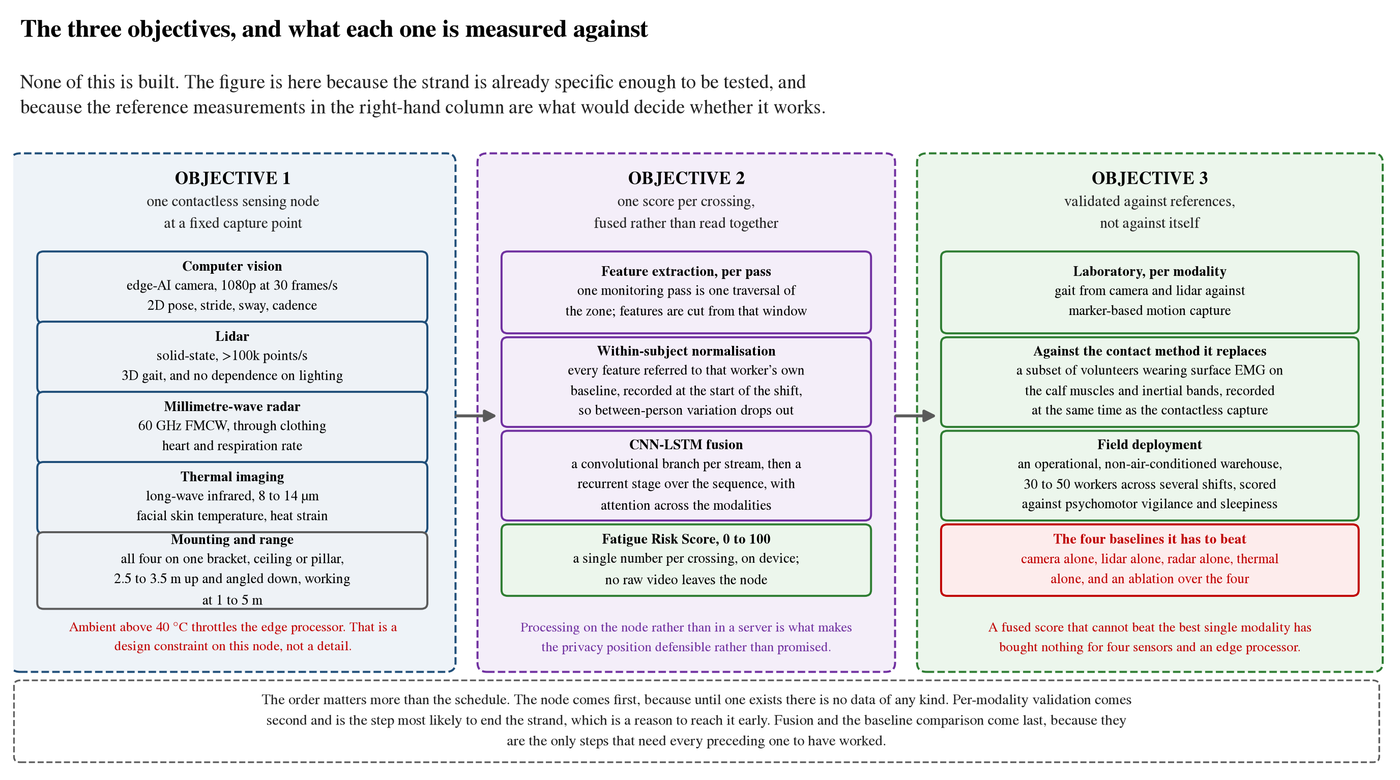
docs/aps_report/figures/fig36_fatigue_design.png
