AritraD11/NarrowAisleBot/docs/aps_report/figures/fig38_prior_chassis.png

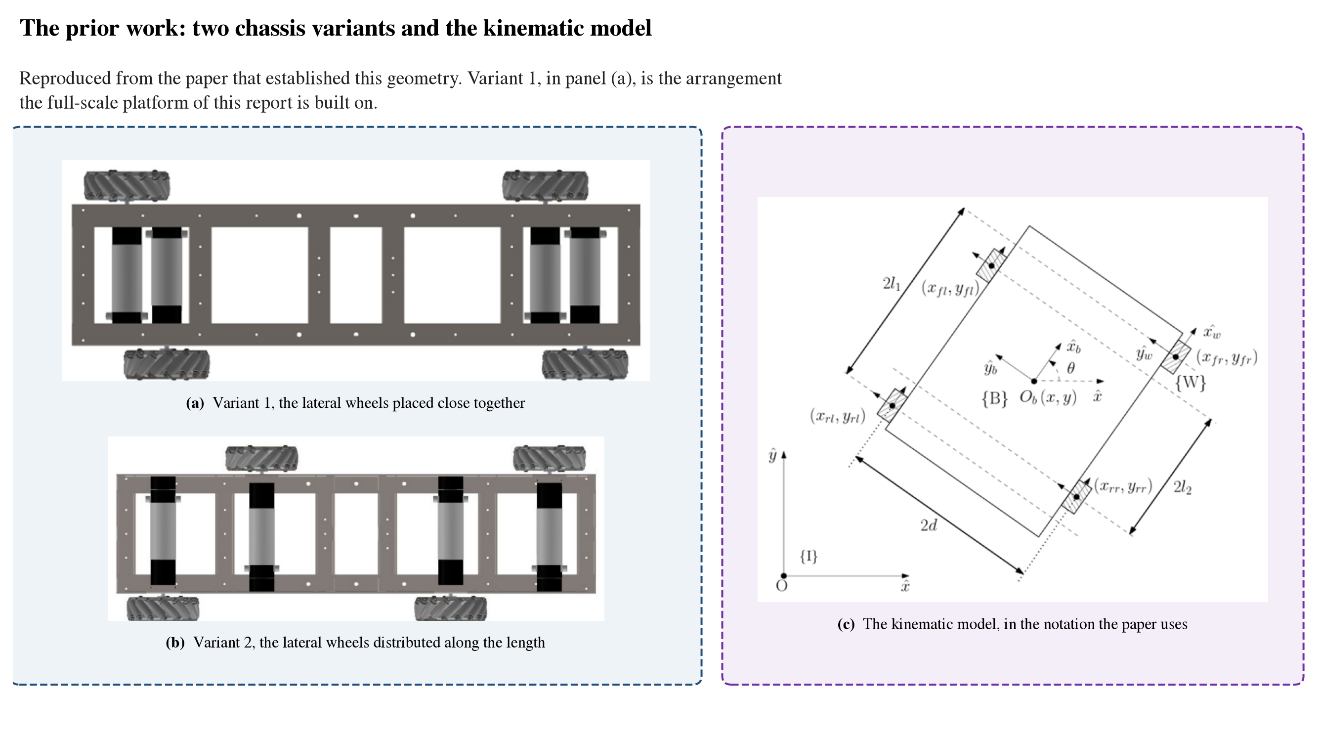
docs/aps_report/figures/fig38_prior_chassis.png
