AritraD11/NarrowAisleBot/docs/aps_report/figures/fig39_iot_control_law.png

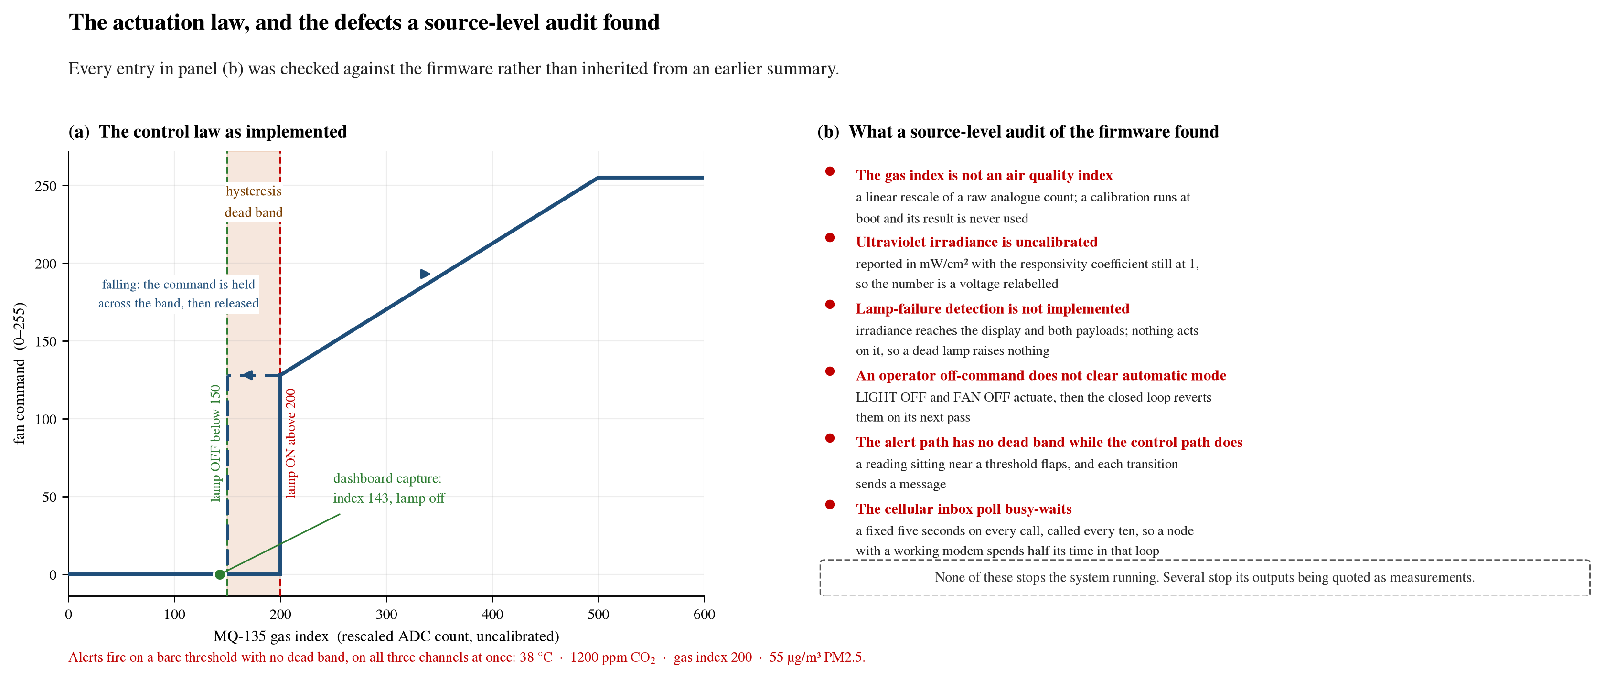
docs/aps_report/figures/fig39_iot_control_law.png
