AritraD11/NarrowAisleBot/docs/aps_report/figures/fig40_iot_hardware.png

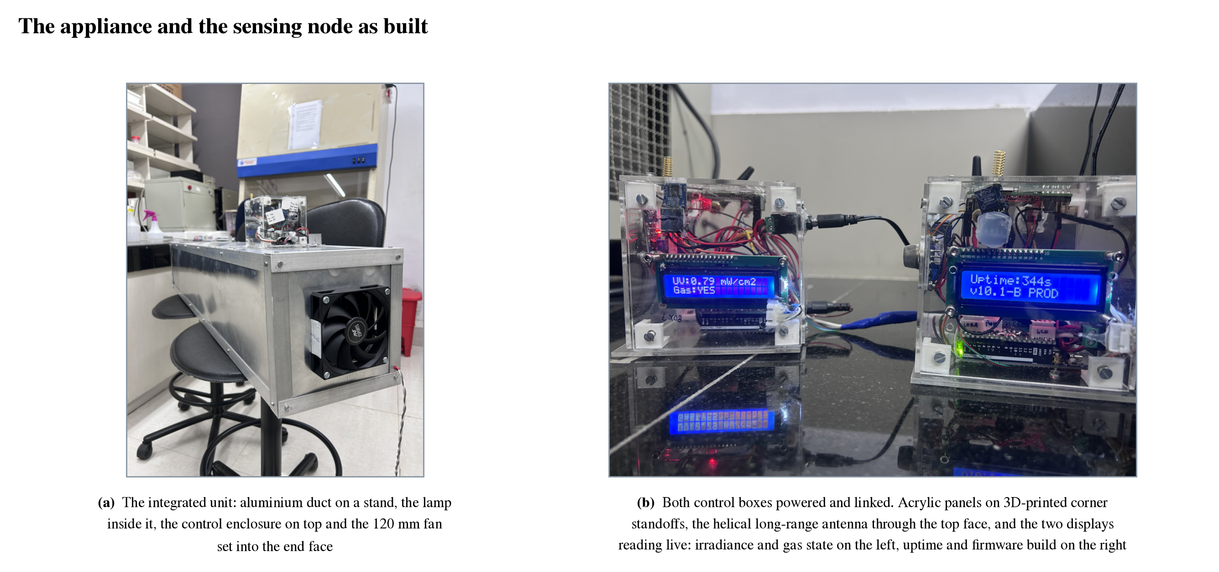
docs/aps_report/figures/fig40_iot_hardware.png
