AritraD11/NarrowAisleBot/docs/aps_report/figures/fig41_iot_dashboard.png

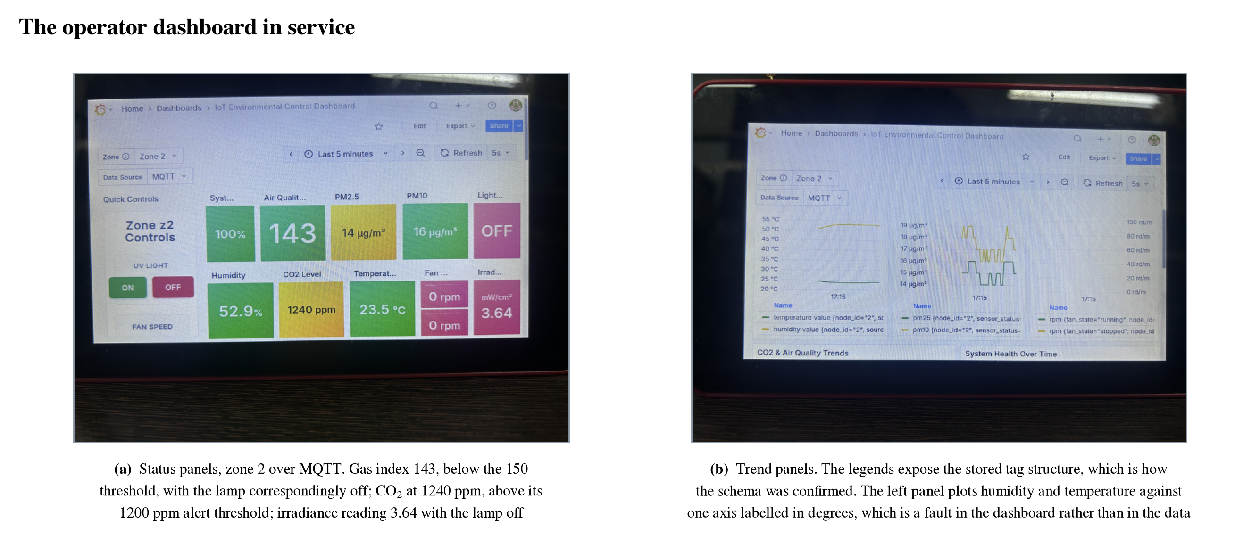
docs/aps_report/figures/fig41_iot_dashboard.png
