AritraD11/NarrowAisleBot/docs/aps_report/figures/fig44_fatigue_pipeline.png

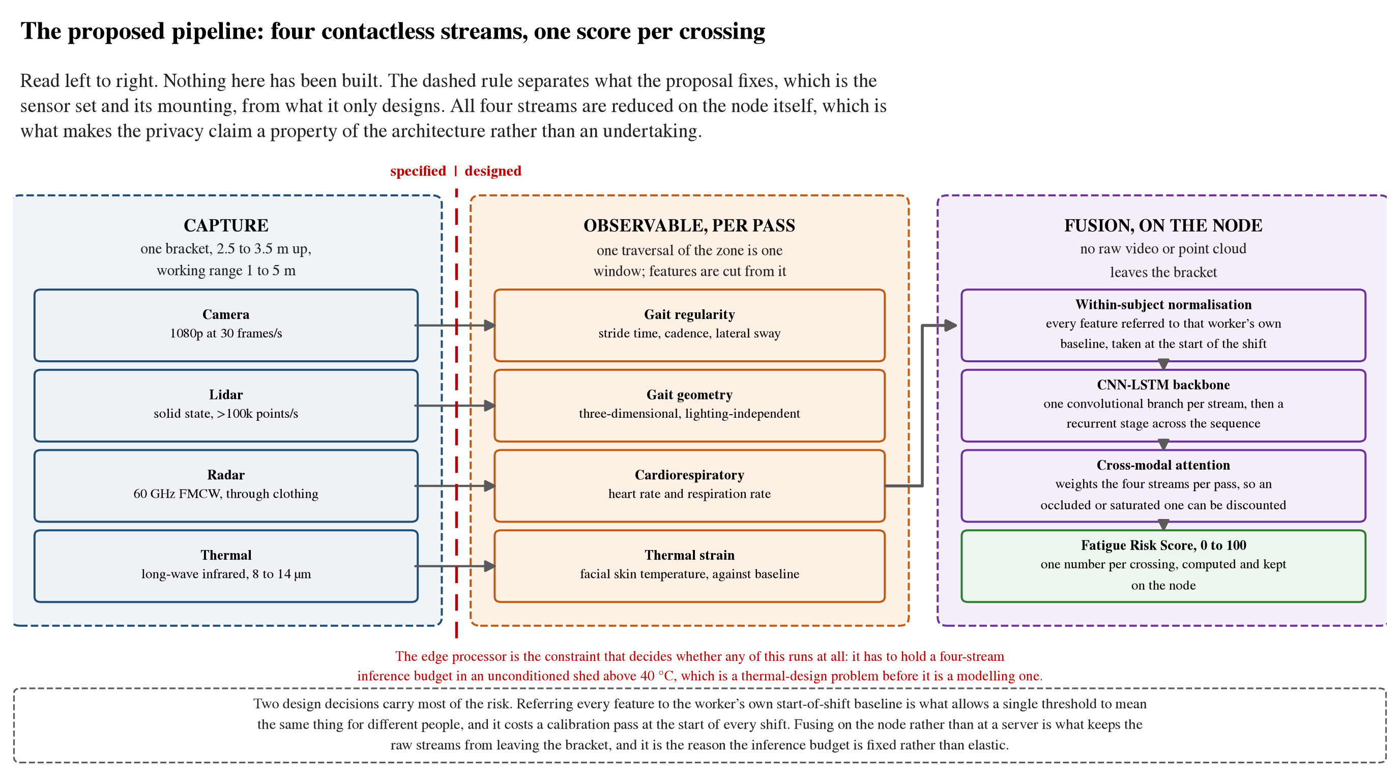
docs/aps_report/figures/fig44_fatigue_pipeline.png
