AritraD11/NarrowAisleBot/docs/aps_report/figures/status_15sep.png

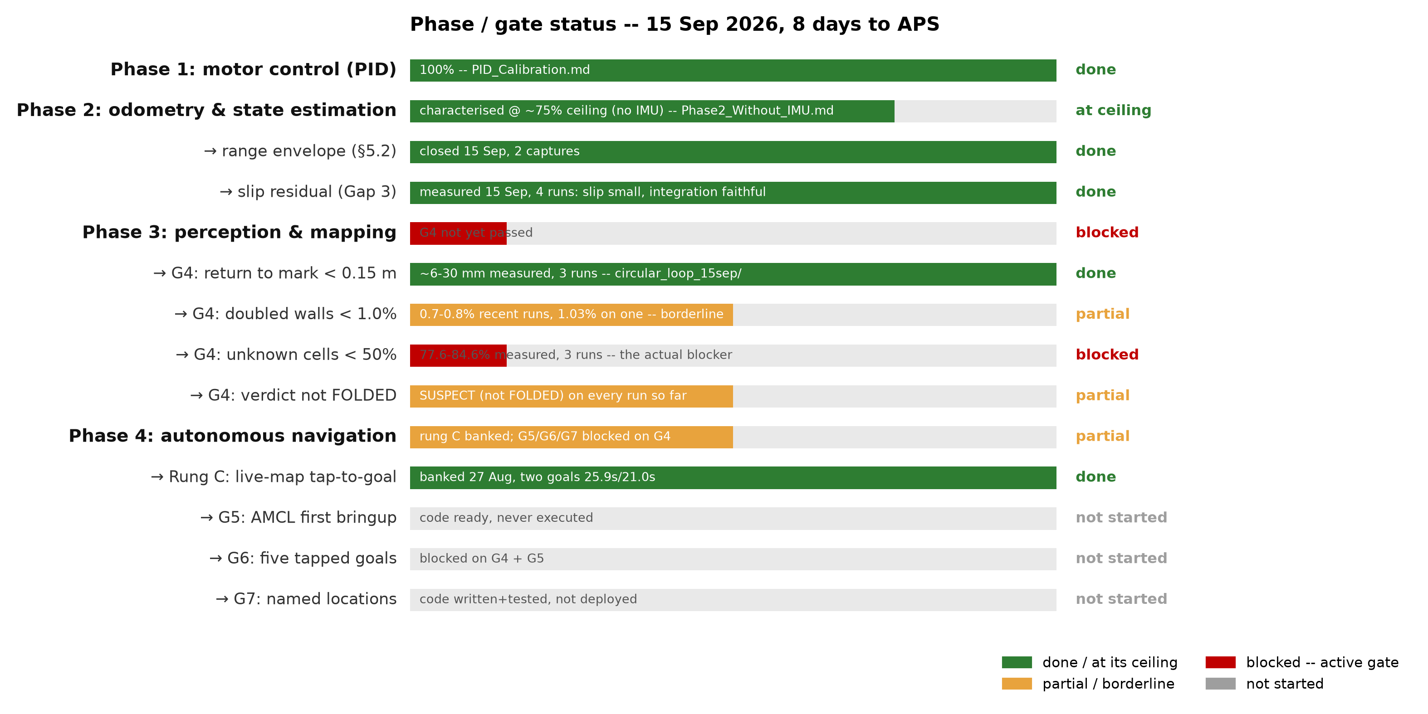
docs/aps_report/figures/status_15sep.png
