AritraD11/NarrowAisleBot/docs/aps_report/final_src/figures_from_pdf/p01_Image15.png

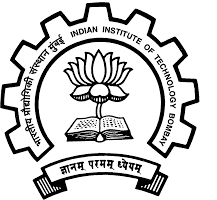
docs/aps_report/final_src/figures_from_pdf/p01_Image15.png
