AritraD11/NarrowAisleBot/docs/aps_report/final_src/figures_from_pdf/p11_Image103.jpg

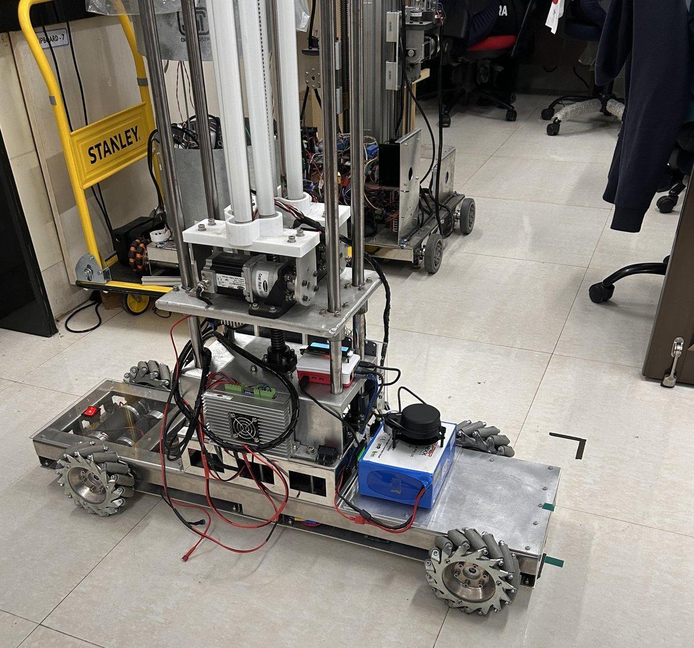
docs/aps_report/final_src/figures_from_pdf/p11_Image103.jpg
