AritraD11/NarrowAisleBot/docs/aps_report/final_src/figures_from_pdf/p14_Image108.png

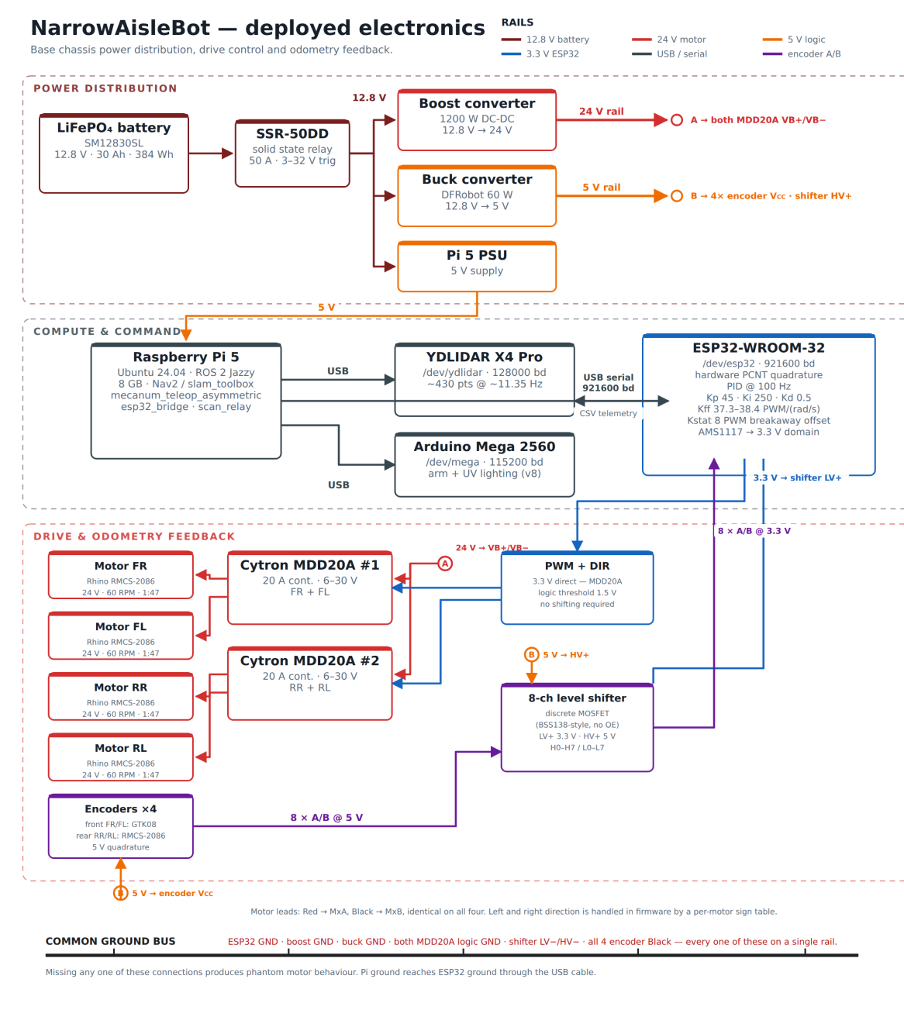
docs/aps_report/final_src/figures_from_pdf/p14_Image108.png
