AritraD11/NarrowAisleBot/docs/aps_report/final_src/figures_from_pdf/p24_Image135.png

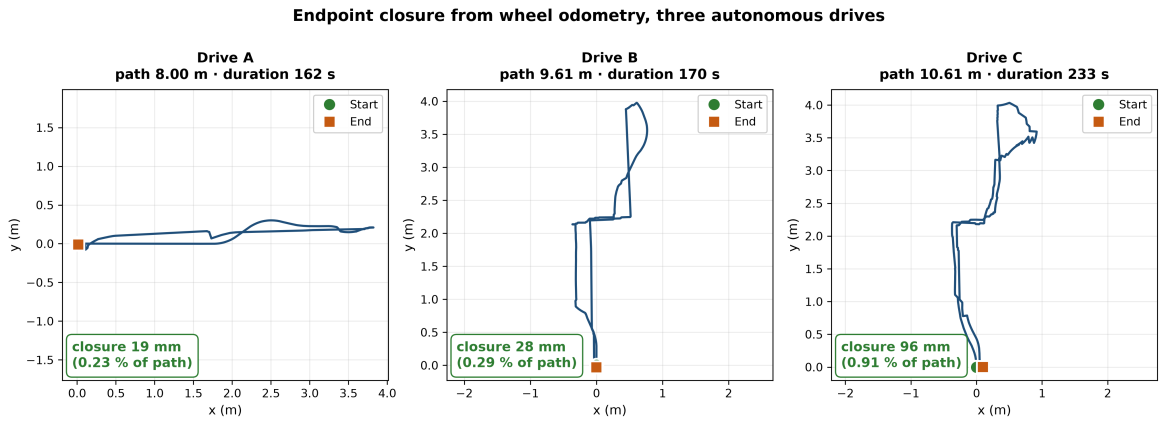
docs/aps_report/final_src/figures_from_pdf/p24_Image135.png
