AritraD11/NarrowAisleBot/docs/aps_report/final_src/figures_from_pdf/p31_Image146.jpg

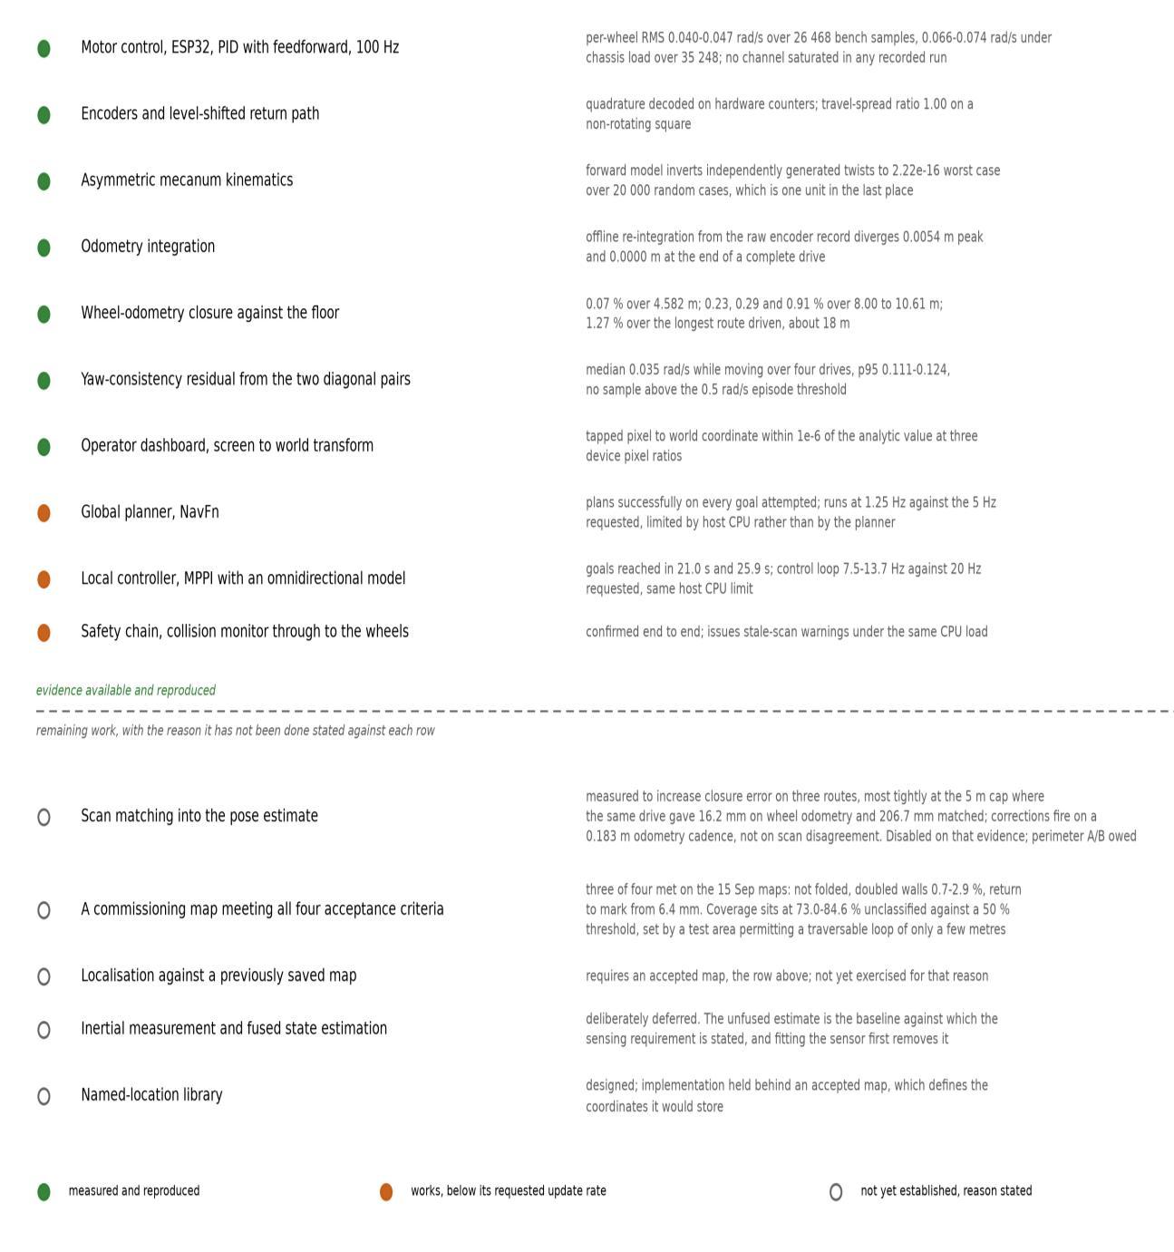
docs/aps_report/final_src/figures_from_pdf/p31_Image146.jpg
