AritraD11/NarrowAisleBot/docs/aps_report/seminar_final/assets/context/dims_schematic.png

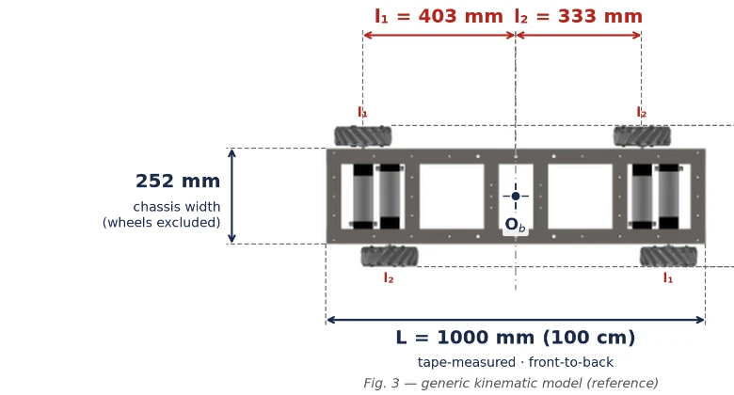
docs/aps_report/seminar_final/assets/context/dims_schematic.png
