AritraD11/NarrowAisleBot/docs/aps_report/seminar_final/assets/context/eq_inverse_kinematics.png

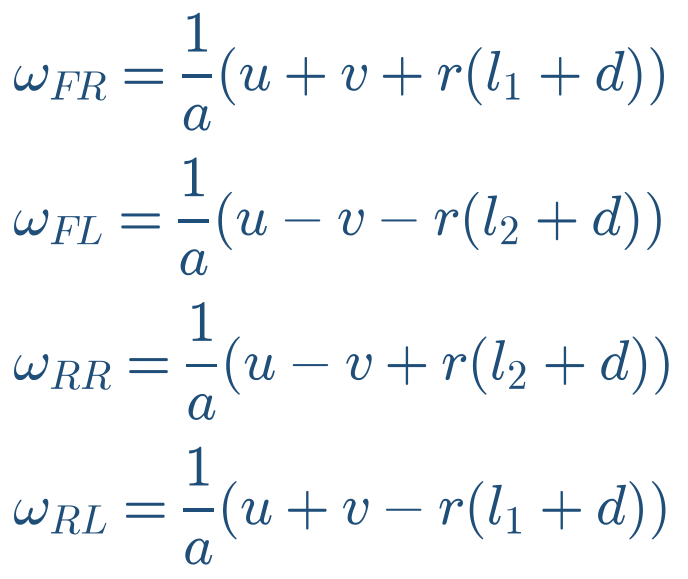
docs/aps_report/seminar_final/assets/context/eq_inverse_kinematics.png
