AritraD11/NarrowAisleBot/docs/aps_report/seminar_final/assets/context/eq_kinematics_legend.png

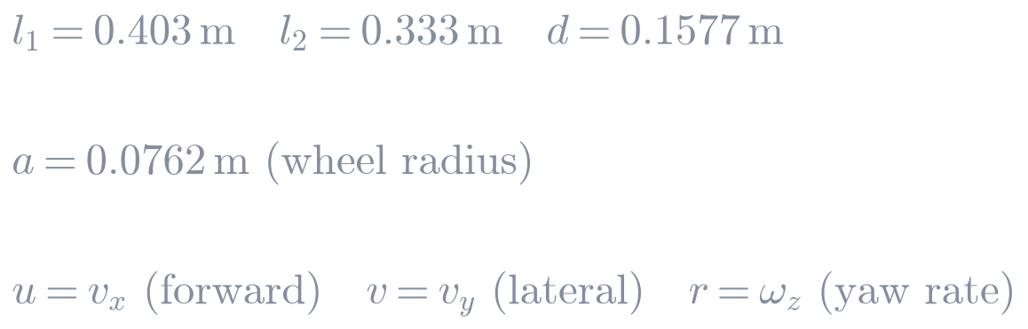
docs/aps_report/seminar_final/assets/context/eq_kinematics_legend.png
