AritraD11/NarrowAisleBot/docs/aps_report/seminar_final/assets/context/fedex_dock.jpg

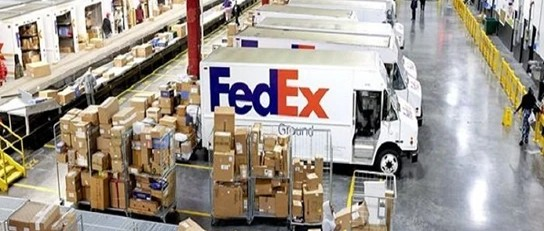
docs/aps_report/seminar_final/assets/context/fedex_dock.jpg
