AritraD11/NarrowAisleBot/docs/aps_report/seminar_final/assets/context/paper_fig3_schematic.png

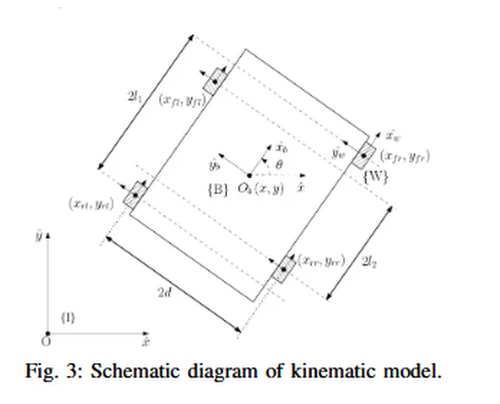
docs/aps_report/seminar_final/assets/context/paper_fig3_schematic.png
