AritraD11/NarrowAisleBot/docs/aps_report/seminar_final/assets/context/warehouse_floor.jpg

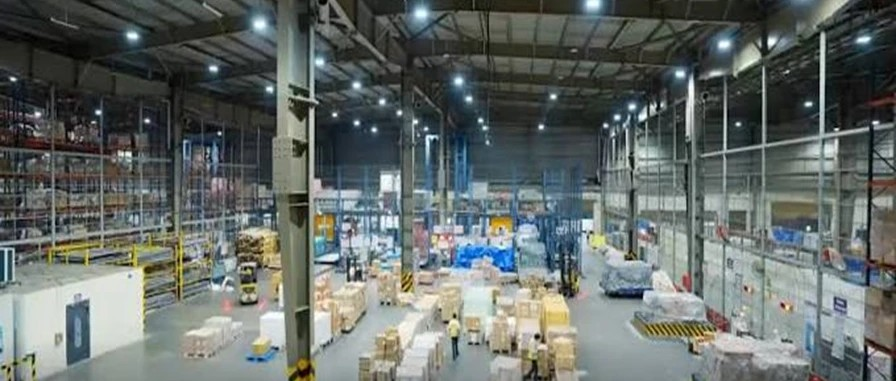
docs/aps_report/seminar_final/assets/context/warehouse_floor.jpg
