AritraD11/NarrowAisleBot/docs/evidence/monday_recon/lab_floor_sketch.png

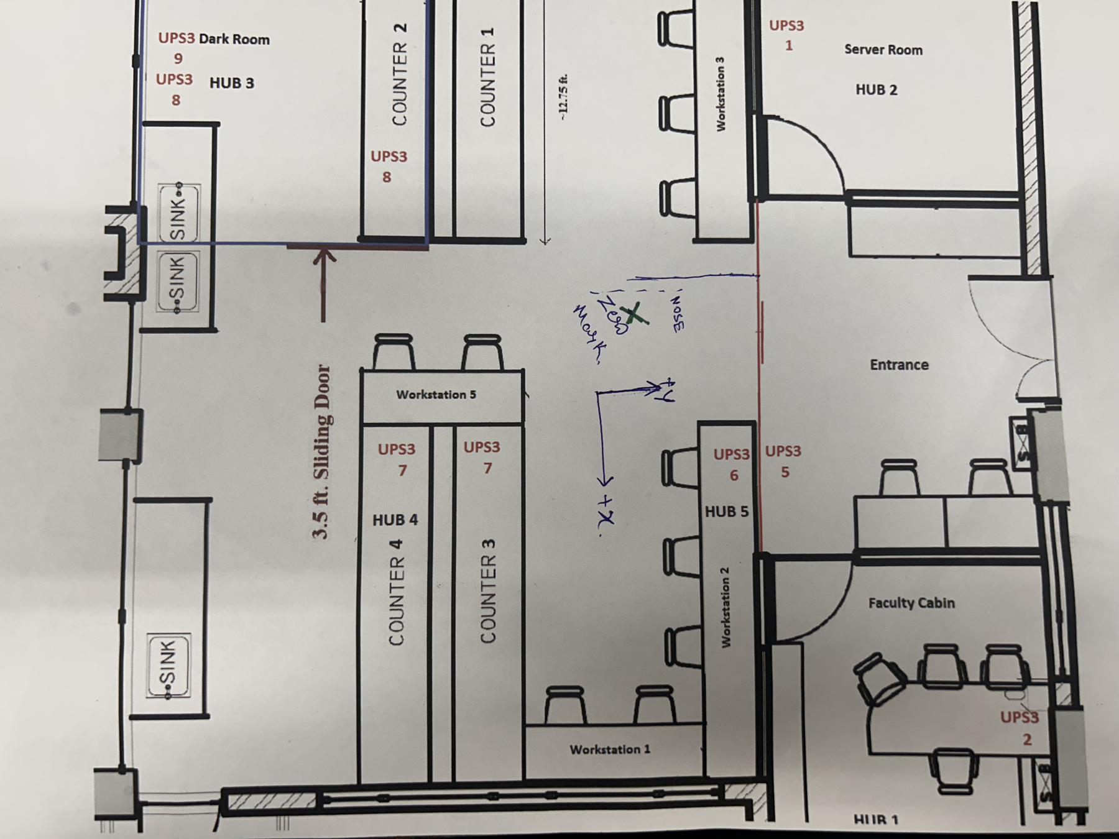
docs/evidence/monday_recon/lab_floor_sketch.png
