AritraD11/NarrowAisleBot/docs/evidence/monday_recon/right_leg_map_annotated.png

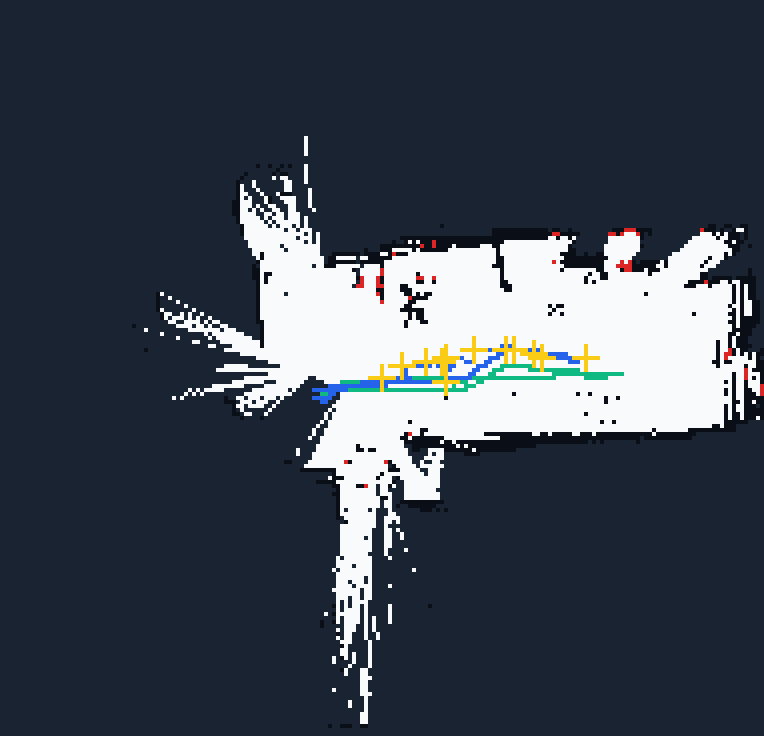
docs/evidence/monday_recon/right_leg_map_annotated.png
