AritraD11/NarrowAisleBot/docs/evidence/tuesday_repeat/front_leg_repeat_annotated.png

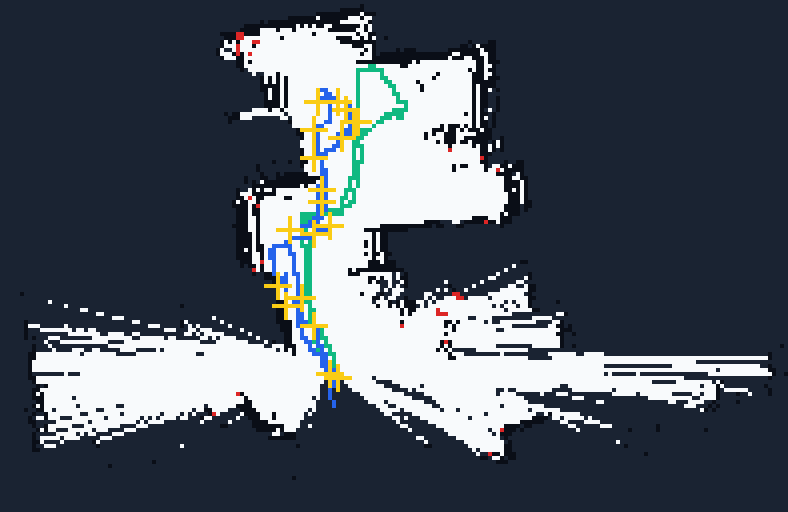
docs/evidence/tuesday_repeat/front_leg_repeat_annotated.png
