AritraD11/NarrowAisleBot/docs/hardware/photos/nab_chassis_battery_pi_top.jpg

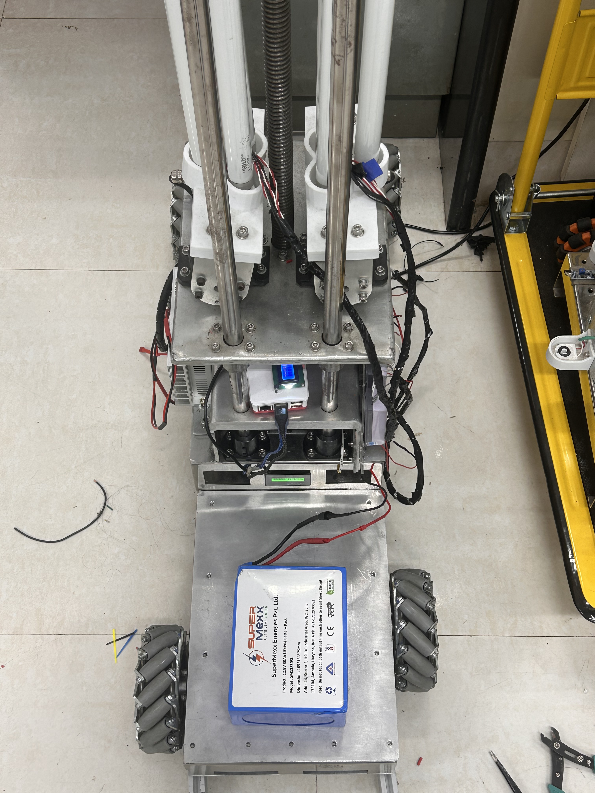
docs/hardware/photos/nab_chassis_battery_pi_top.jpg
