AritraD11/NarrowAisleBot/docs/hardware/photos/nab_chassis_drivers_wheels.jpg

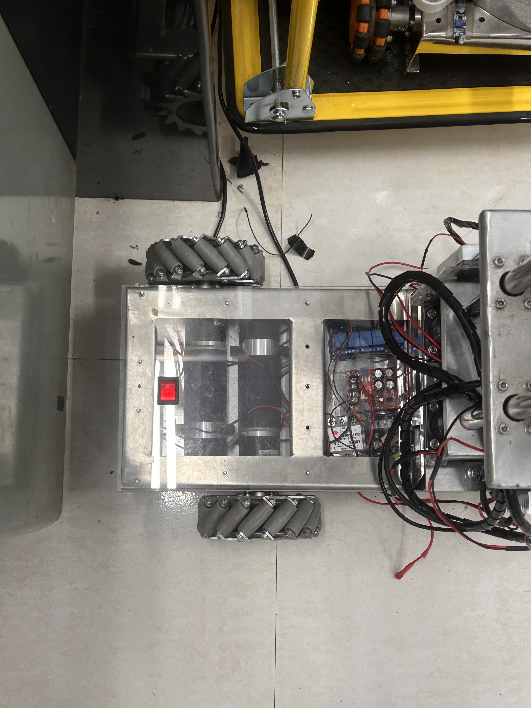
docs/hardware/photos/nab_chassis_drivers_wheels.jpg
