AritraD11/NarrowAisleBot/docs/hardware/photos/nab_full_side_arm_lab_01.jpg

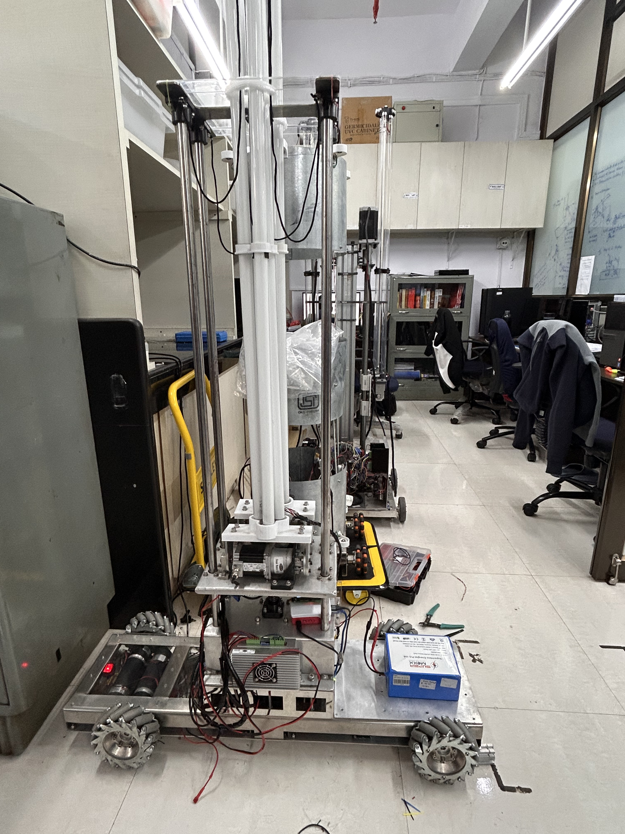
docs/hardware/photos/nab_full_side_arm_lab_01.jpg
