AritraD11/NarrowAisleBot/docs/robot_photos/2026-08-11_occlusion_trial_cw/base_position_marking.jpg

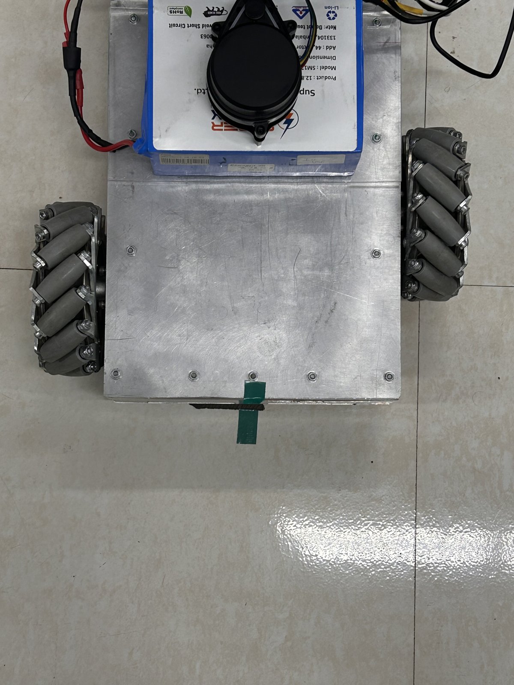
docs/robot_photos/2026-08-11_occlusion_trial_cw/base_position_marking.jpg
