AritraD11/NarrowAisleBot/docs/robot_photos/2026-08-11_occlusion_trial_cw/cw_270.jpg

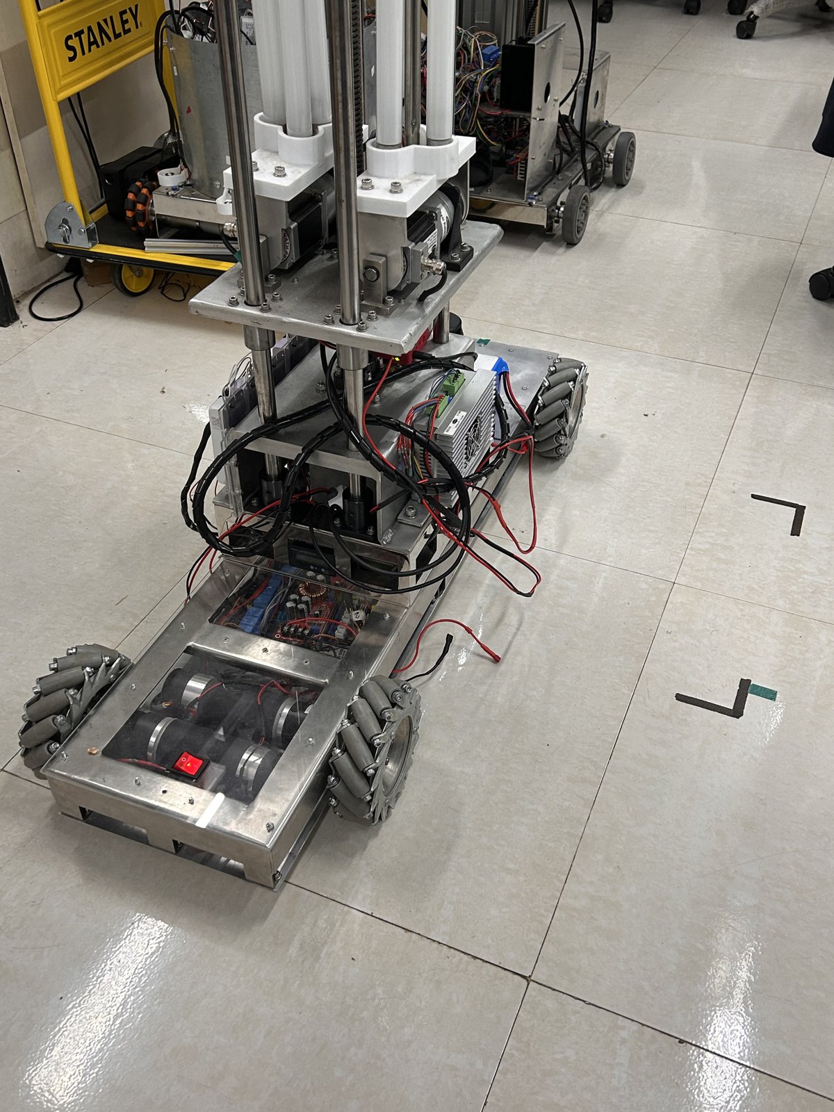
docs/robot_photos/2026-08-11_occlusion_trial_cw/cw_270.jpg
