AritraD11/NarrowAisleBot/cad/AislebotBasePlatform_SteelChasis.SLDASM

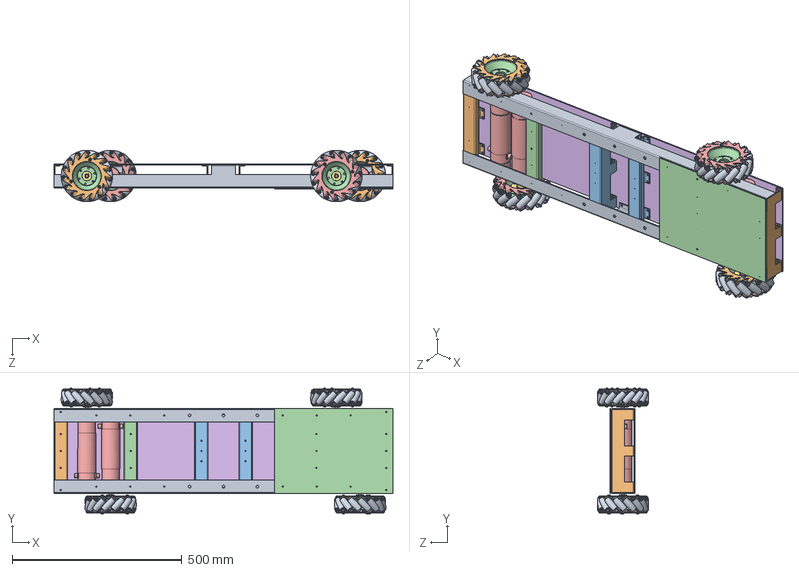
[picture p86: CAD file, 2026-09-10]
cad/AislebotBasePlatform_SteelChasis.SLDASM
1000.0 x 371.3 x 151.8 mm
SteelChasisLengthRod x 2
SteelChasisBreadthRod x 2
SteelChasisBreadthRodMiddle x 2
SteelChasisBreadthPlate x 2
geared_DC_motor x 4
AislebotChasisLowerPlate
AislebotWheelHub x 4
am-3698_core PC.STEP x 60
am-3698_skin TPU v2.STEP x 60
am-0603 MBC Bushing MU04TH04.STEP x 120
am-0701a 6IN SR Roller Axle.STEP x 60
ip-3479a_hub.STEP x 8
am-0676a Left Plate HD.STEP x 4
10-32x2250_shcs_HX-SHCS 0.19-32x1.375x1-C.STEP x 60
10-32 Nylock Jam Nut_90633A411.STEP x 60
91780A190_ALUM FEM THRDED HEX STANDOFF_91780A190.STEP x 12
BHCS 10-32 x 0.500_91255A265.STEP x 12
am-0676a Right Plate HD.STEP x 4
BHCS 10-32 x 0.625 patch_92360A219.STEP x 12
AislebotChasisUpperPlate_New
