AritraD11/NarrowAisleBot/cad/wheels/MecanumRightWithHub.SLDASM

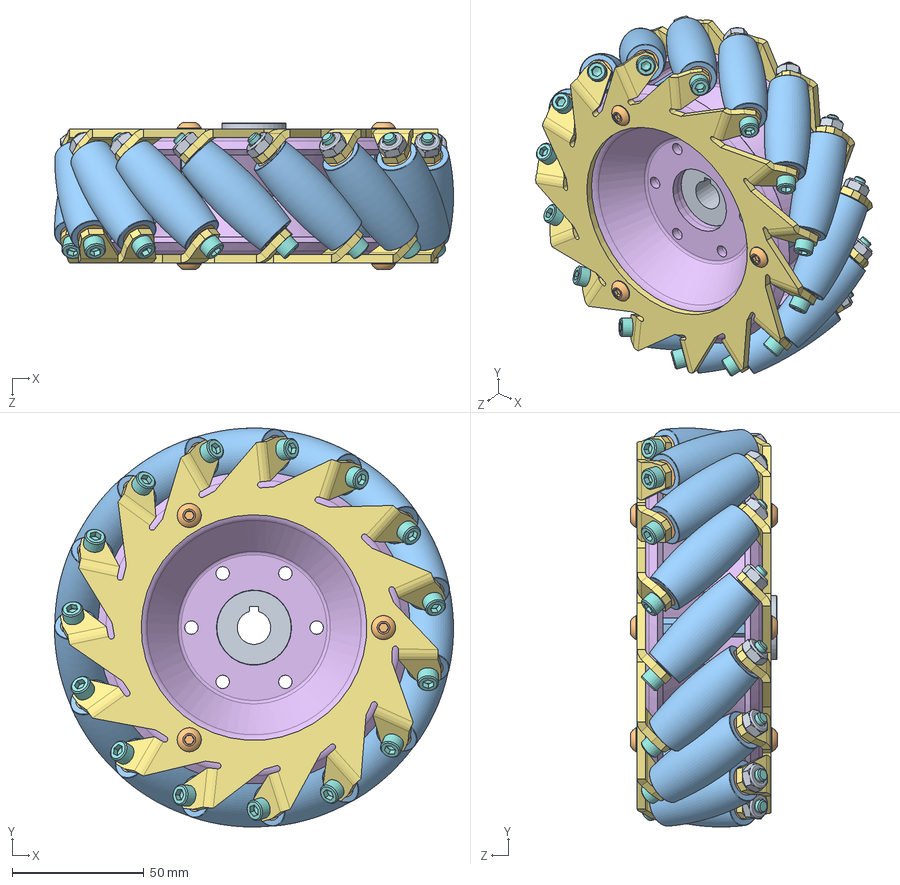
[picture p87: CAD file, 2026-09-10]
cad/wheels/MecanumRightWithHub.SLDASM
151.6 x 151.6 x 55.9 mm
AislebotWheelHub
am-3698_core PC.STEP x 15
am-3698_skin TPU v2.STEP x 15
am-0603 MBC Bushing MU04TH04.STEP x 30
am-0701a 6IN SR Roller Axle.STEP x 15
ip-3479a_hub.STEP x 2
am-0676a Right Plate HD.STEP x 2
10-32x2250_shcs_HX-SHCS 0.19-32x1.375x1-C.STEP x 15
10-32 Nylock Jam Nut_90633A411.STEP x 15
BHCS 10-32 x 0.625 patch_92360A219.STEP x 6
91780A190_ALUM FEM THRDED HEX STANDOFF_91780A190.STEP x 3
