AritraD11/NarrowAisleBot/cad/motor/geared_DC_motor.SLDPRT

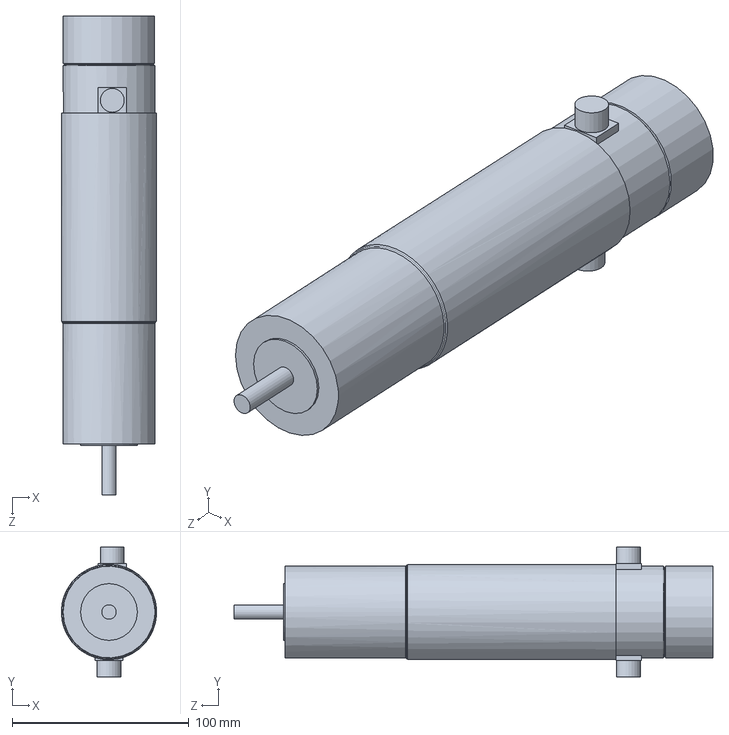
[picture p88: CAD file, 2026-09-10]
cad/motor/geared_DC_motor.SLDPRT
54.0 x 73.4 x 271.2 mm
