AritraD11/NarrowAisleBot/cad/wheels/am-3479Ra 6 SR Mecanum Right with Standoffs.STEP

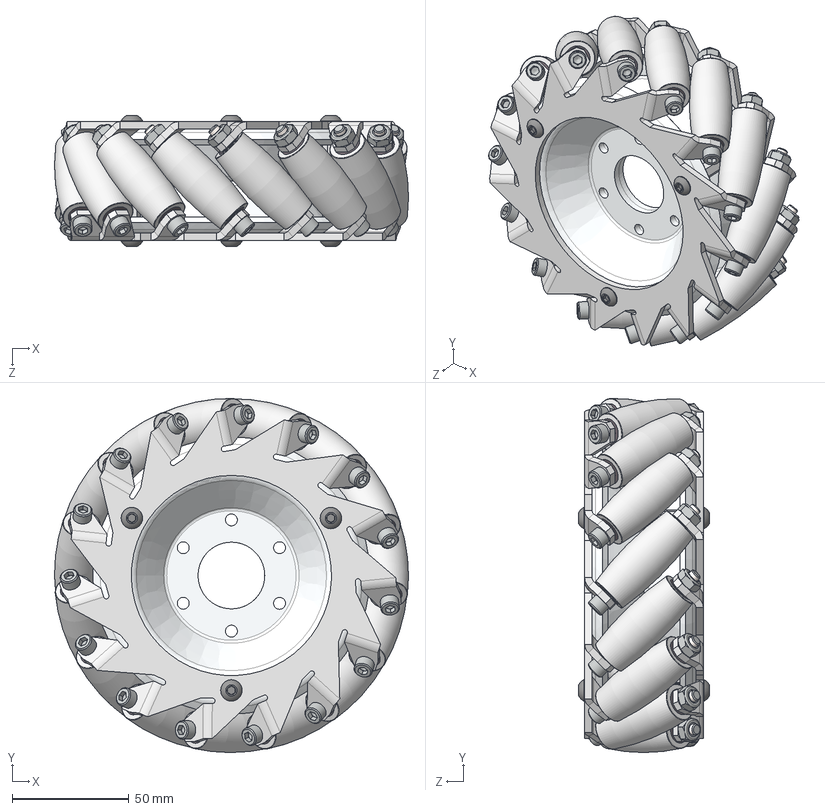
[picture p89: CAD file, 2026-09-10]
cad/wheels/am-3479Ra 6 SR Mecanum Right with Standoffs.STEP
151.6 x 151.7 x 55.9 mm
ip-3479a_hub x 2
am-0676a Right Plate HD x 2
am-3698_core PC x 15
am-3698_skin TPU v2 x 15
am-0603 MBC Bushing MU04TH04 x 30
am-0701a 6IN SR Roller Axle x 15
10-32x2250_shcs_HX-SHCS 0.19-32x1.375x1-C x 15
10-32 Nylock Jam Nut_90633A411 x 15
BHCS 10-32 x 0.625 patch_92360A219 x 6
91780A190_ALUM FEM THRDED HEX STANDOFF_91780A190 x 3
