AritraD11/NarrowAisleBot/(list of files, cad)

Other CAD files:
cad/wheels/MecanumLeftWithHub.SLDASM
cad/wheels/am-3479La 6 SR Mecanum Left with Standoffs.STEP
