AritraD11/NarrowAisleBot/docs/robot_photos/2026-08-11_recalibration_cw/nab_6cm_from_block_setup.jpg

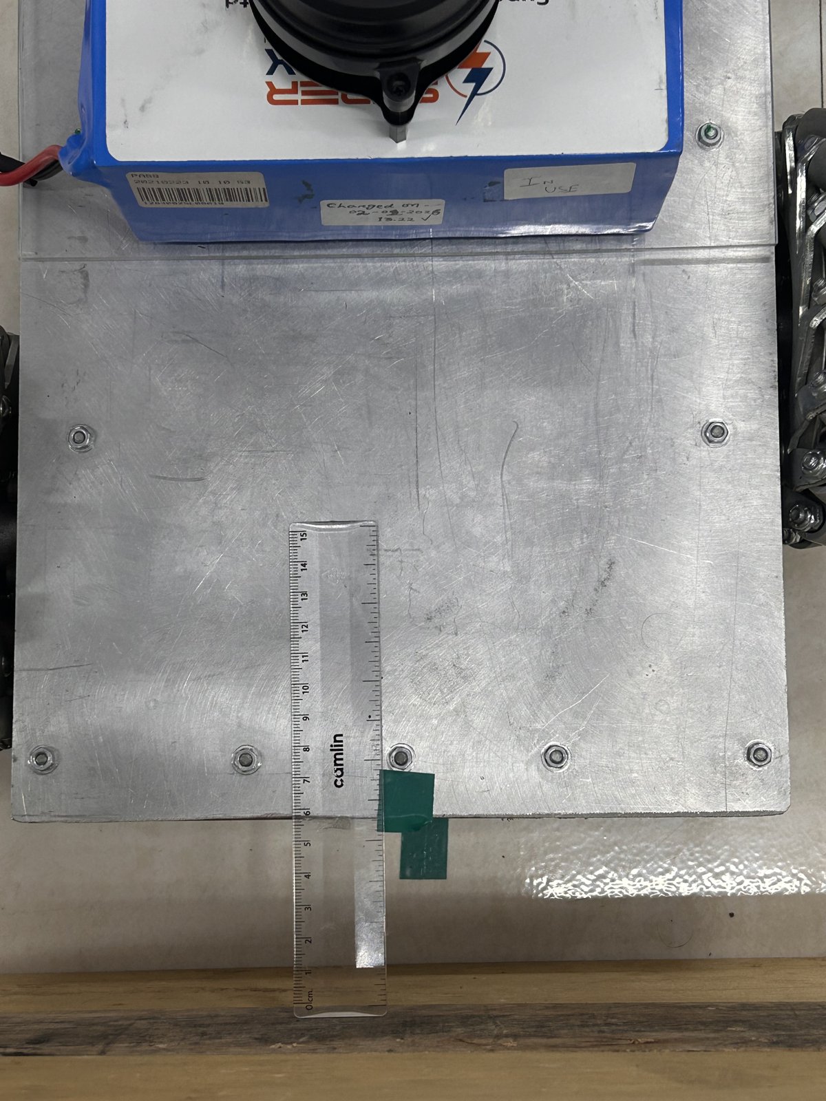
docs/robot_photos/2026-08-11_recalibration_cw/nab_6cm_from_block_setup.jpg
