AritraD11/NarrowAisleBot/docs/robot_photos/2026-08-11_recalibration_cw/nab_extra_setup_view.jpg

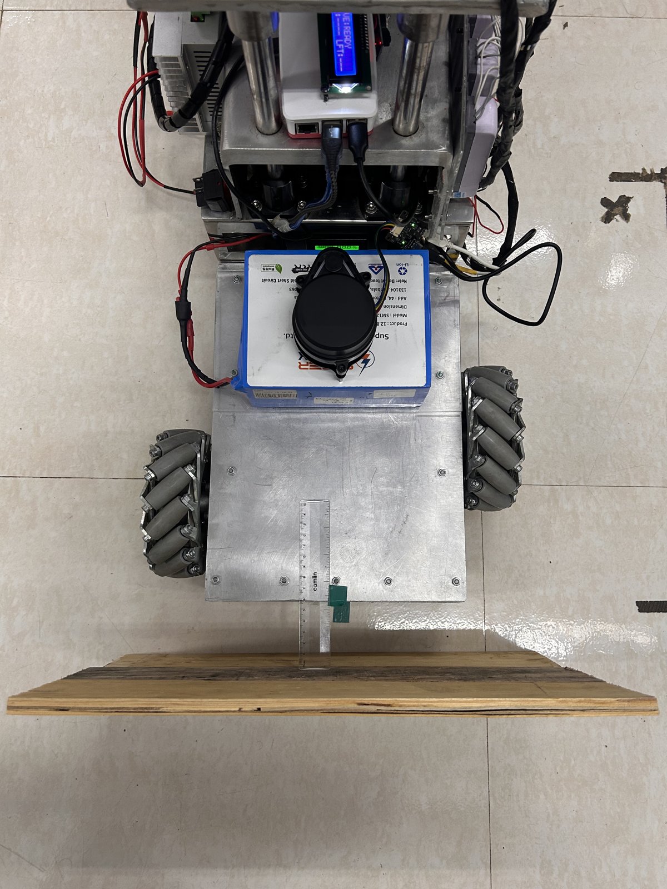
docs/robot_photos/2026-08-11_recalibration_cw/nab_extra_setup_view.jpg
