AritraD11/NarrowAisleBot/docs/aps_report/figures/fig03_openloop_characterisation.png

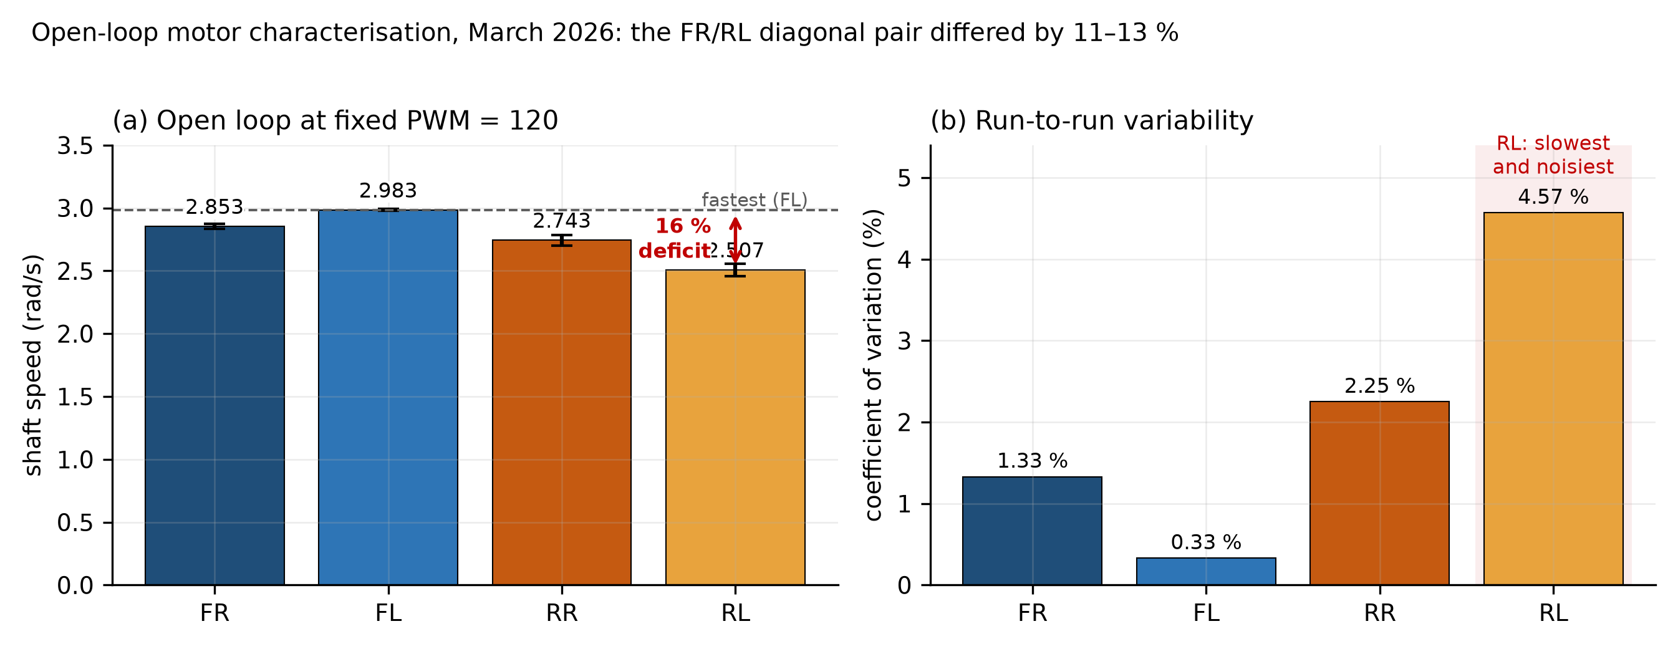
docs/aps_report/figures/fig03_openloop_characterisation.png
