AritraD11/NarrowAisleBot/docs/robot_photos/2026-08-11_orientation_fix/paper_bag_obstacle_test.jpg

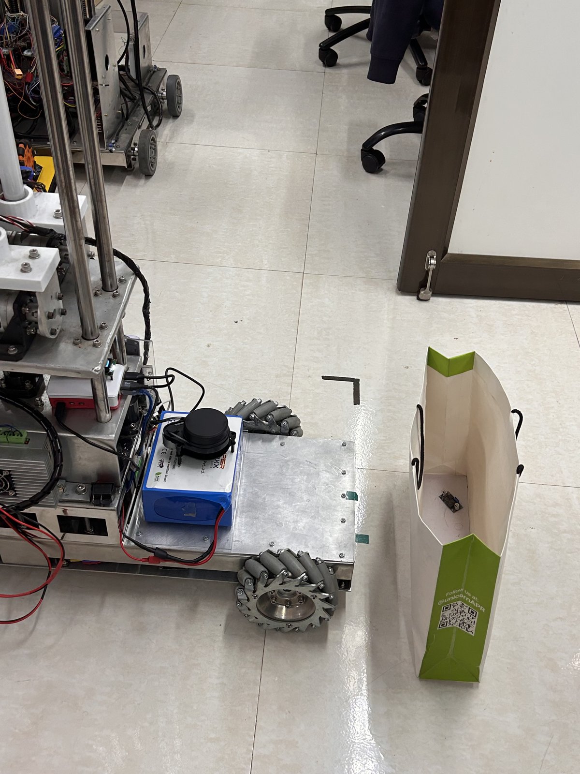
docs/robot_photos/2026-08-11_orientation_fix/paper_bag_obstacle_test.jpg
