AritraD11/NarrowAisleBot/docs/robot_photos/2026-08-11_recalibration_cw/map_block_appears_boundary.png

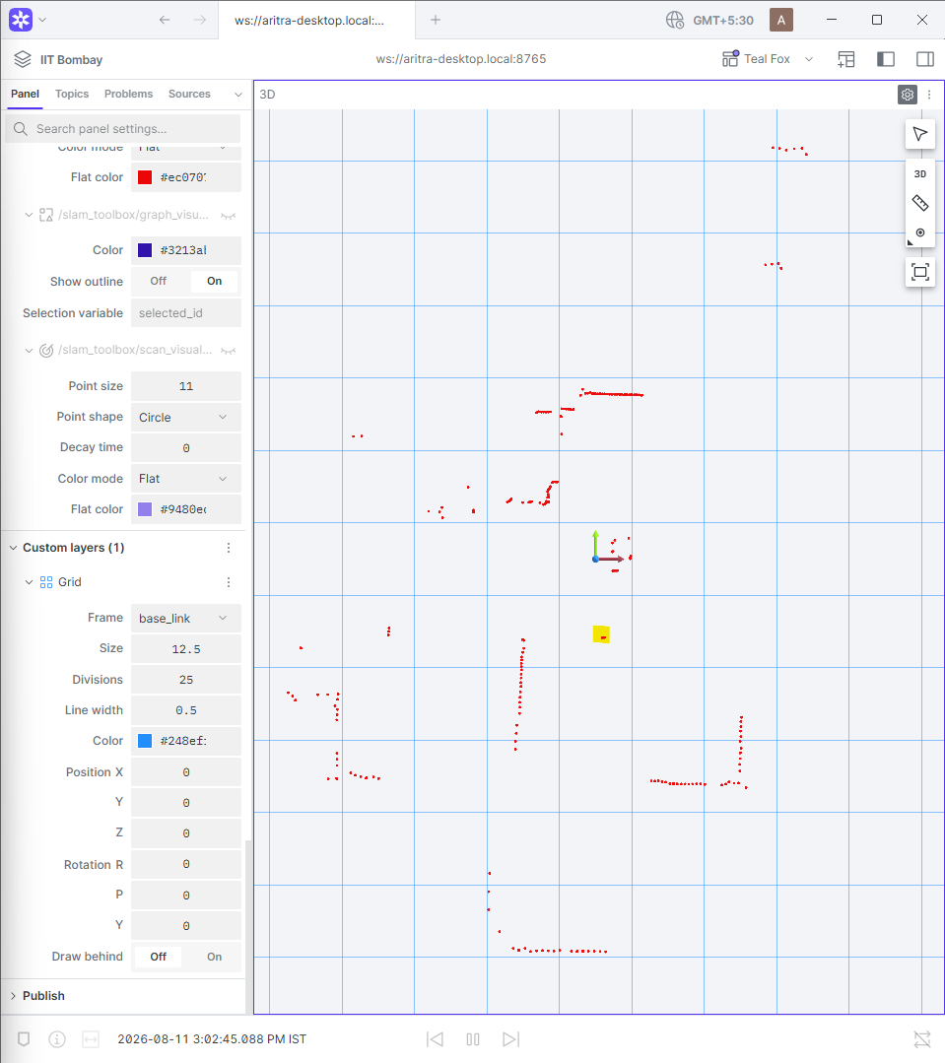
docs/robot_photos/2026-08-11_recalibration_cw/map_block_appears_boundary.png
