AritraD11/NarrowAisleBot/docs/robot_photos/2026-08-11_recalibration_cw/map_cw_000_marked.png

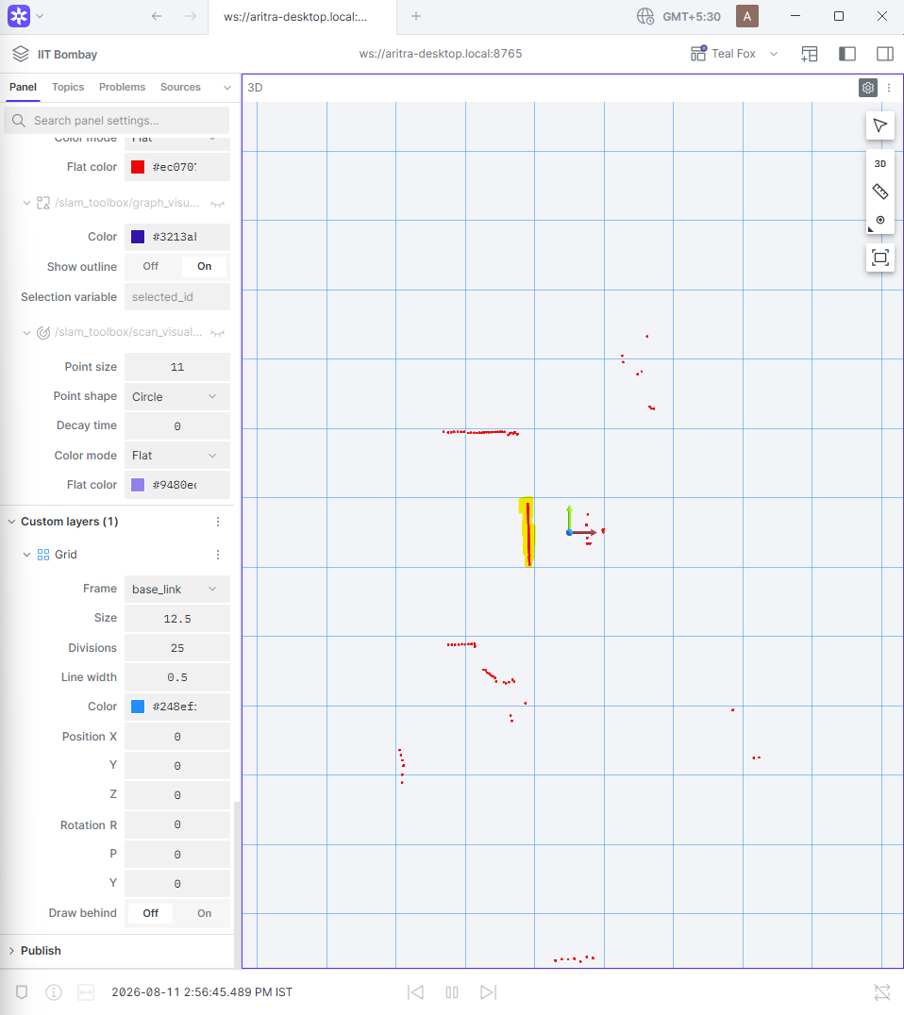
docs/robot_photos/2026-08-11_recalibration_cw/map_cw_000_marked.png
