AritraD11/NarrowAisleBot/docs/robot_photos/2026-08-11_recalibration_cw/map_cw_180.png

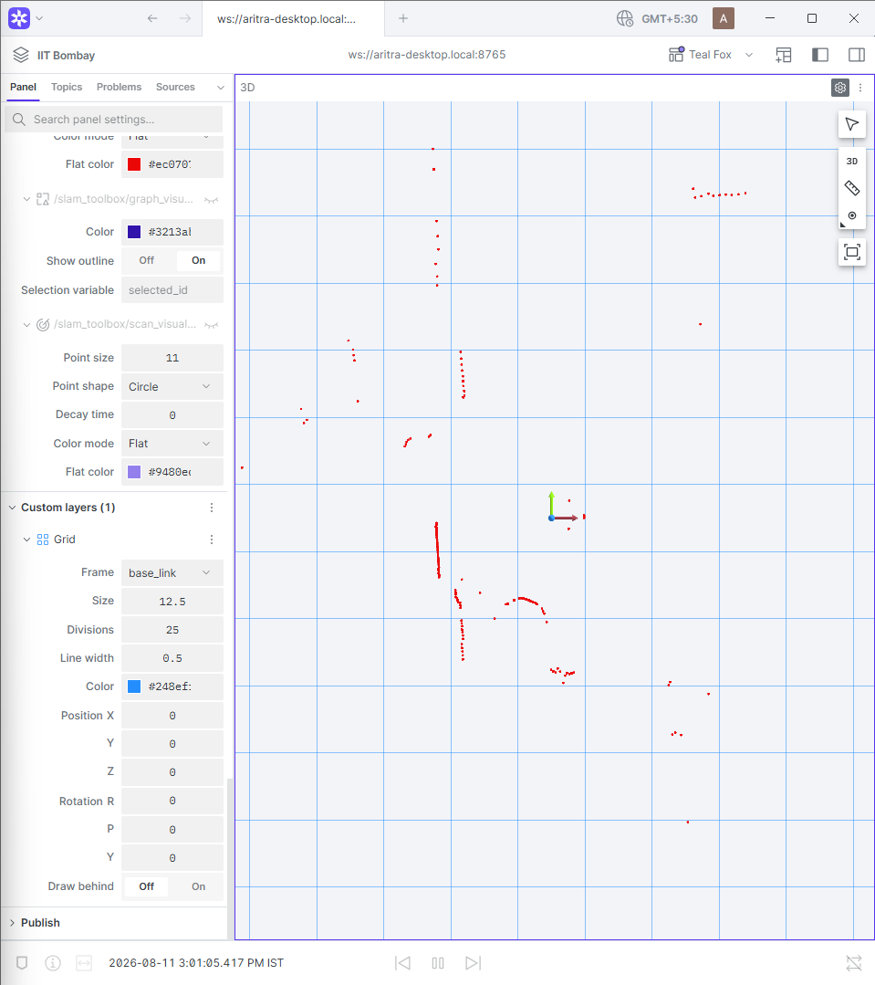
docs/robot_photos/2026-08-11_recalibration_cw/map_cw_180.png
