AritraD11/NarrowAisleBot/docs/robot_photos/2026-08-11_recalibration_cw/nab_block_disappears_cw_side.jpg

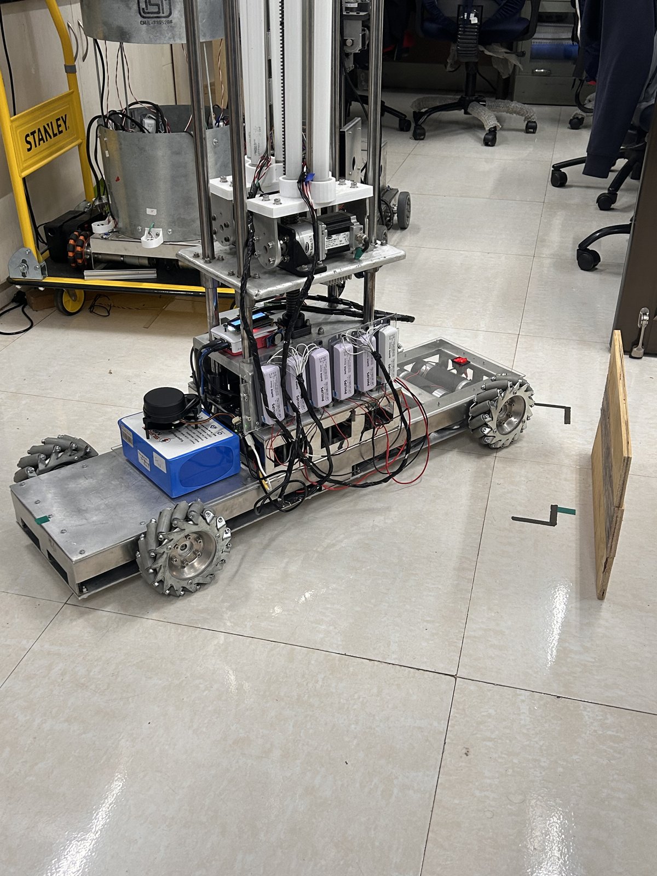
docs/robot_photos/2026-08-11_recalibration_cw/nab_block_disappears_cw_side.jpg
