AritraD11/NarrowAisleBot/docs/robot_photos/2026-08-11_recalibration_cw/nab_block_reappears_ccw_side.jpg

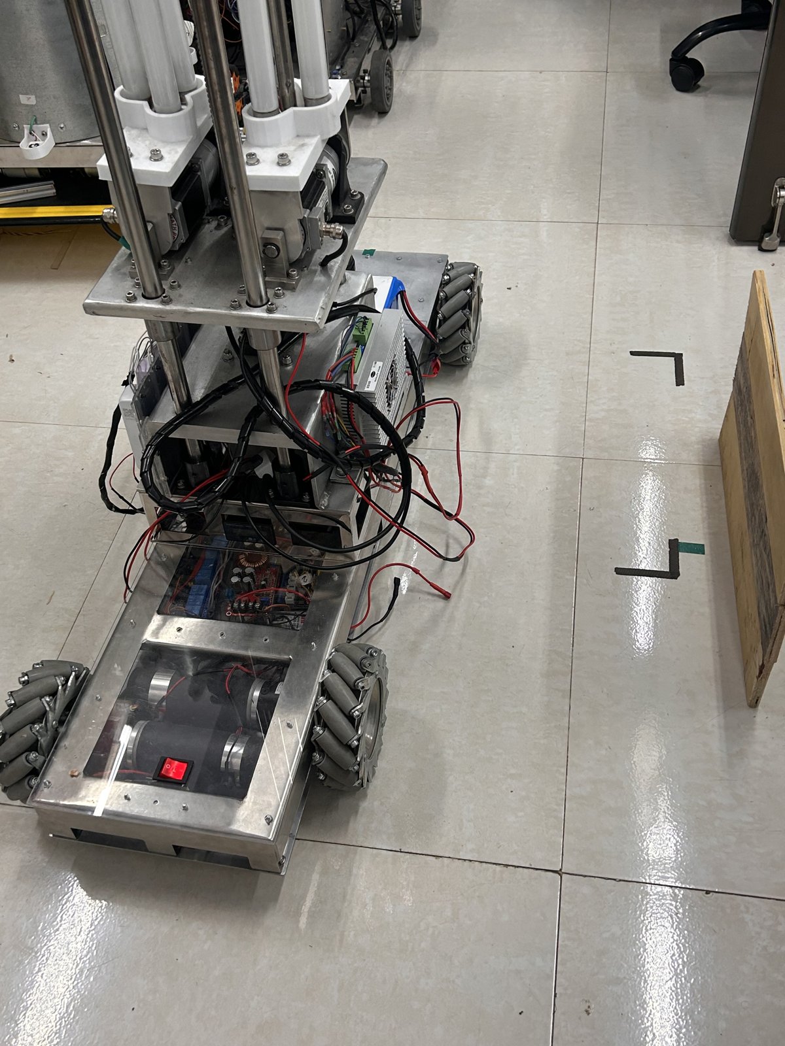
docs/robot_photos/2026-08-11_recalibration_cw/nab_block_reappears_ccw_side.jpg
