AritraD11/NarrowAisleBot/docs/robot_photos/2026-08-11_recalibration_cw/nab_cw_270.jpg

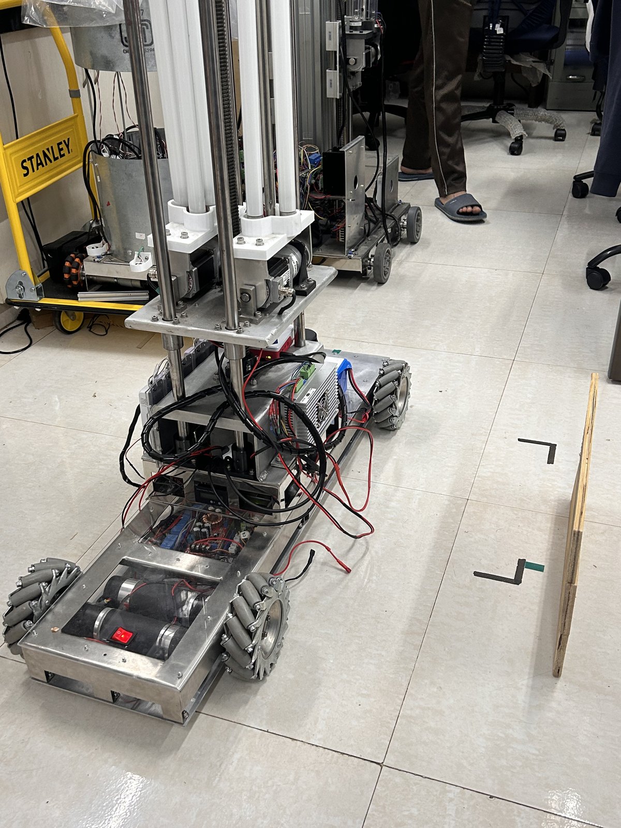
docs/robot_photos/2026-08-11_recalibration_cw/nab_cw_270.jpg
