AritraD11/NarrowAisleBot/docs/aps_report/figures/fig43_fatigue_problem.png

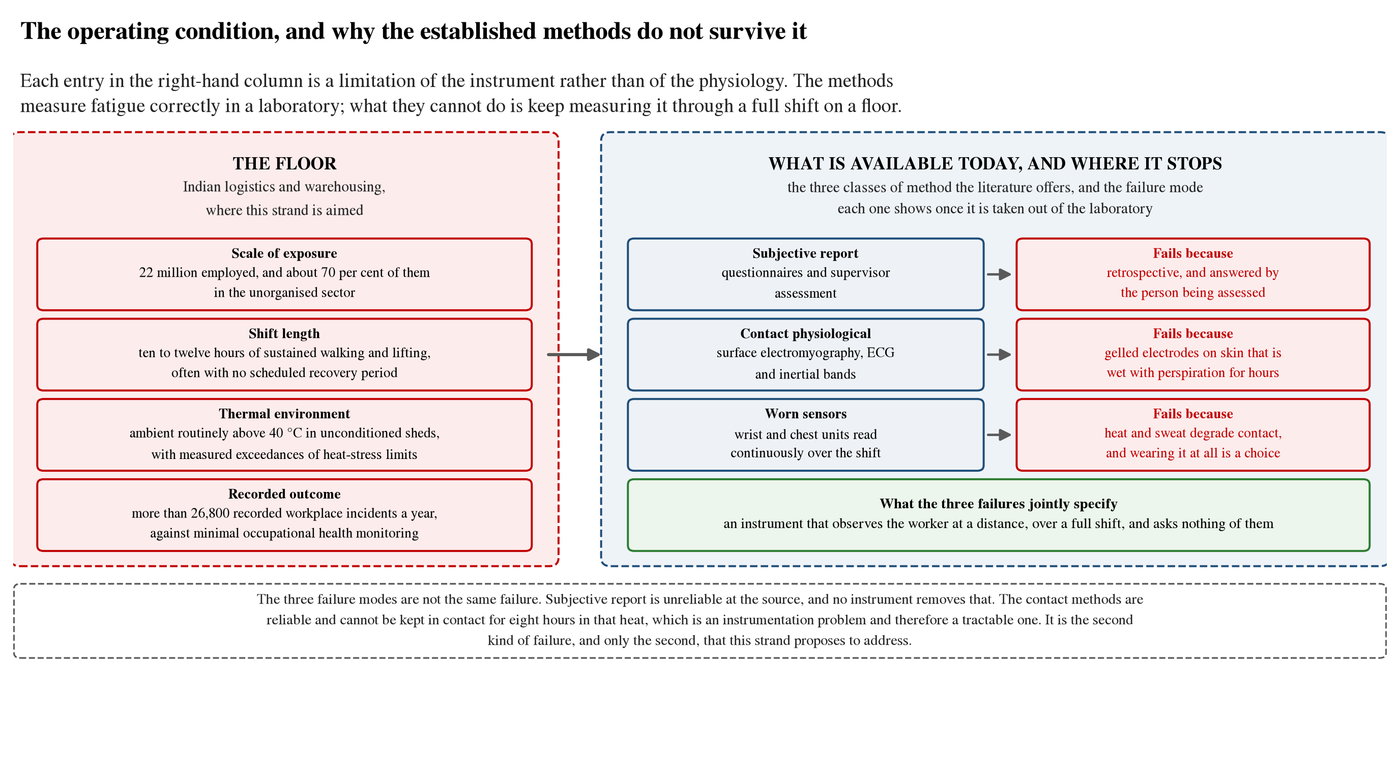
docs/aps_report/figures/fig43_fatigue_problem.png
