AritraD11/NarrowAisleBot/docs/robot_photos/2026-08-11_orientation_fix/block_at_left.jpg

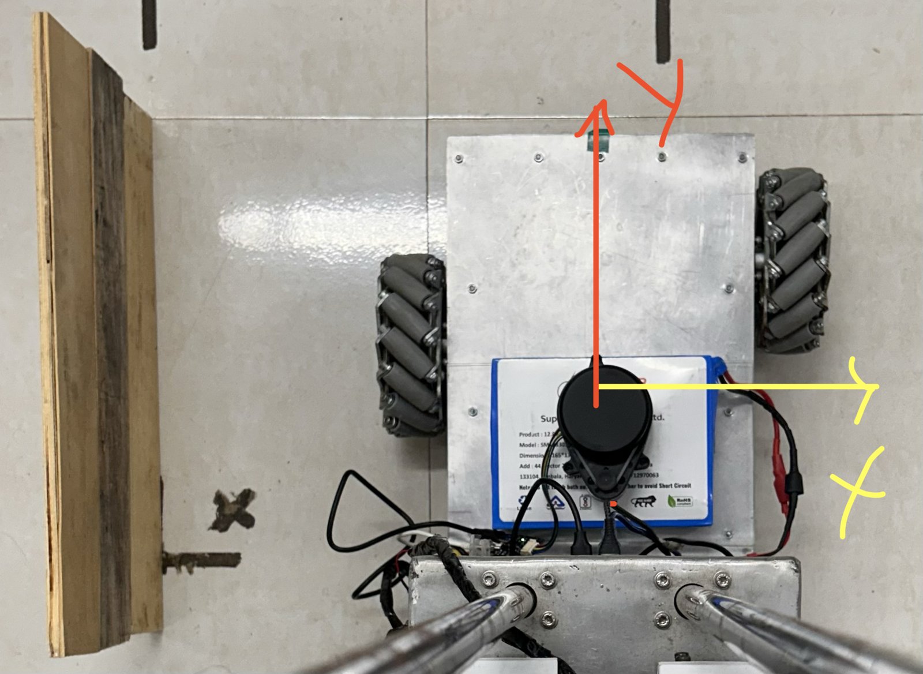
docs/robot_photos/2026-08-11_orientation_fix/block_at_left.jpg
