AritraD11/NarrowAisleBot/docs/robot_photos/2026-08-11_orientation_fix/forward_drive_frame_end.jpg

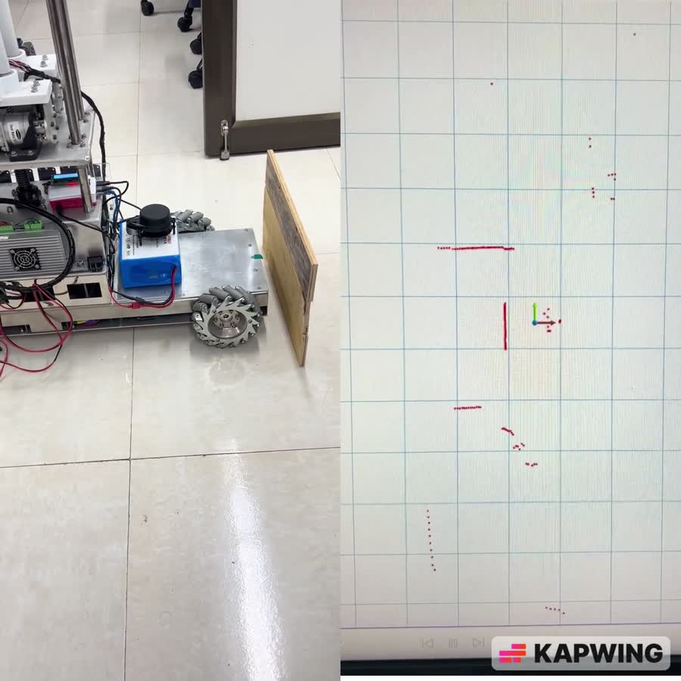
docs/robot_photos/2026-08-11_orientation_fix/forward_drive_frame_end.jpg
