AritraD11/NarrowAisleBot/docs/robot_photos/2026-08-11_orientation_fix/forward_drive_frame_start.jpg

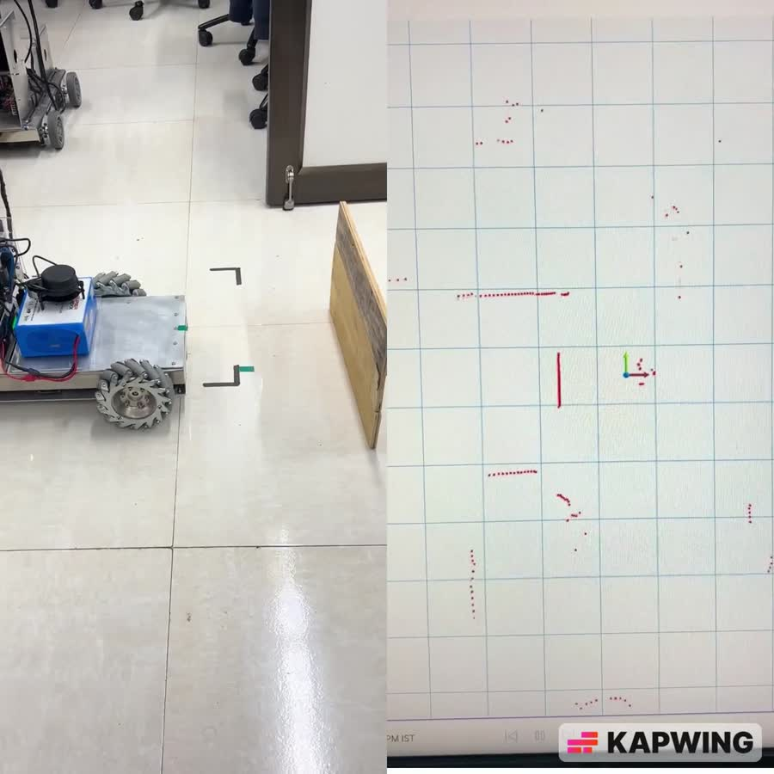
docs/robot_photos/2026-08-11_orientation_fix/forward_drive_frame_start.jpg
