AritraD11/NarrowAisleBot/docs/robot_photos/2026-08-11_orientation_fix/hand_drawn_axis_convention.jpg

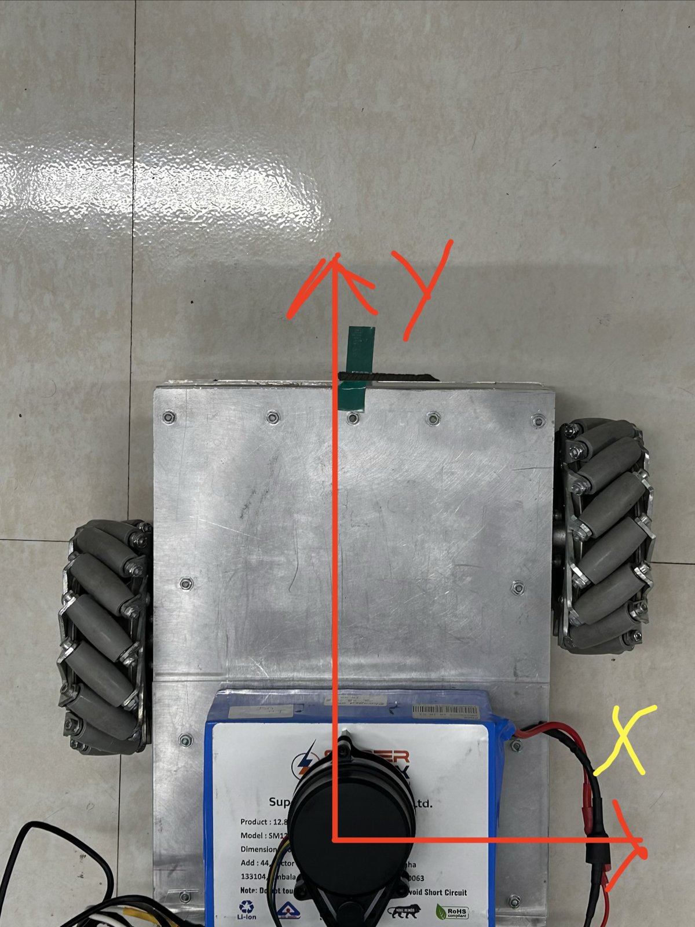
docs/robot_photos/2026-08-11_orientation_fix/hand_drawn_axis_convention.jpg
