AritraD11/NarrowAisleBot/src/mecanum_robot/urdf/aislebot.urdf

<?xml version="1.0"?>
<!--
  AisleBot URDF — Asymmetric Mecanum Mobile Robot
  IIT Bombay — Aritra Das (25D0074) — Prof. Ambarish Kunwar

  AXIS CONVENTION: standard REP-103 since 5 Oct 2026
  ===================================================
        +X = FORWARD (the nose)     +Y = LEFT     +Z = up
        yaw = angle of the nose from +X, counter-clockwise positive

  This file used to be written in the robot's old private convention
  (+X right, +Y forward, Research_Journal.md §17.10-§17.12, §17.38) and was
  converted to the standard one on 5 Oct 2026. The conversion applied to
  every number below is
        x_new =  y_old        y_new = -x_old        (yaw unchanged)
  so the chassis box and cushion swapped their X and Y extents, every joint
  origin was rotated the same way, and the wheel spin axes moved from X to
  Y. The robot did not change. Only the name of each axis did. See
  docs/Axis_Convention.md and docs/Axis_Refactor_Plan.md.

  The LiDAR is still a mirrored sensor and scan_relay still reflects its
  scan; that is a property of the sensor, not an axis choice, and it is
  handled in scan_relay (yaw_offset 180, mirror on), not here.

  Geometry (all tape-measured, not estimated):
    Chassis     : 1000mm long (X) × 360mm wide (Y) × 150mm high (Z)
                  Width is wheel-outer to wheel-outer, the widest part
                  (§17.7). Height is the model's own long-standing value,
                  never independently measured.
    base_link   : at the TRUE geometric centre of the chassis in both
                  axes — 500mm from the front edge (of 1000mm total) and
                  125mm from the chassis-plate edge (of 250mm total).
                  Located physically by rotating the robot in place and
                  marking the point that stayed fixed, then tape-measuring
                  to it (§17.12). Previously assumed; now confirmed.
    l1 = 403mm (outer: FR, RL), l2 = 333mm (inner: FL, RR)
    d  = 157.69mm (half-track), wheel_r = 76.2mm
    Total mass ≈ 45.5 kg

  NOTE the two different width numbers, which are NOT interchangeable:
    360mm = wheel outer to wheel outer — the collision-relevant width,
            what the chassis box and the Nav2 footprint use.
    250mm = the bare chassis plate — what the LiDAR's mounting position
            was measured against. Used only to derive laser_joint below.
-->
<robot name="aislebot" xmlns:xacro="http://ros.org/wiki/xacro">

  <!-- ==================== MATERIALS ==================== -->
  <material name="dark_gray">
    <color rgba="0.3 0.3 0.3 1.0"/>
  </material>
  <material name="blue">
    <color rgba="0.1 0.3 0.7 1.0"/>
  </material>
  <material name="orange">
    <color rgba="0.9 0.5 0.1 1.0"/>
  </material>
  <material name="black">
    <color rgba="0.1 0.1 0.1 1.0"/>
  </material>
  <!-- Translucent amber: the safety cushion is a boundary to look through,
       not a solid to look at. Alpha kept low enough that scan returns
       crossing into it stay readable. -->
  <material name="cushion_amber">
    <color rgba="1.0 0.65 0.0 0.28"/>
  </material>

  <!-- ==================== BASE LINK (ground reference) ==================== -->
  <link name="base_link"/>

  <link name="base_footprint"/>
  <joint name="base_footprint_joint" type="fixed">
    <parent link="base_link"/>
    <child link="base_footprint"/>
    <origin xyz="0 0 -0.0762" rpy="0 0 0"/>
  </joint>

  <!-- ==================== CHASSIS ====================
       box size is X Y Z = LENGTH WIDTH HEIGHT, the stock REP-103 order
       (+X is forward, see the axis banner at the top of this file).

       Width corrected 0.50 -> 0.36 m on 8 Aug 2026 from a tape measurement
       (Research_Journal.md §17.7). The old 0.50 was wrong: the real robot is
       36 cm across at its widest (wheel outer to wheel outer). The wheel joint
       origins below were already consistent with the measurement
       (±0.15769 ± 0.03 half-wheel-width = 0.375 m outer, within ~1 cm), so the
       error was confined to this <box> — the kinematic parameters the
       PID/odometry actually use were never affected.

       Inertia RE-DERIVED 12 Aug 2026, no longer stale. The previous values
       were computed for the pre-correction 0.50 m-wide box and were left in
       place deliberately (§17.7) on the grounds that an un-derived guess would
       be worse than a known-stale number. That reasoning no longer applies:
       the box's real dimensions are now tape-measured, so the tensor can be
       derived rather than guessed. Solid cuboid about its centre, m = 40.0 kg,
       x = 1.00, y = 0.36, z = 0.15:
         ixx = m(y² + z²)/12 = 40(0.1296 + 0.0225)/12 = 0.507
         iyy = m(x² + z²)/12 = 40(1.0000 + 0.0225)/12 = 3.408
         izz = m(x² + y²)/12 = 40(1.0000 + 0.1296)/12 = 3.765
       (ixx and iyy swapped on 5 Oct 2026 with the axes; izz is unchanged.)
       Still Gazebo-simulation-only in effect — nothing on the real robot
       reads it — but now correct rather than merely flagged.
  -->
  <link name="chassis">
    <visual>
      <geometry>
        <box size="1.0 0.36 0.15"/>
      </geometry>
      <material name="dark_gray"/>
    </visual>
    <collision>
      <geometry>
        <box size="1.0 0.36 0.15"/>
      </geometry>
    </collision>
    <inertial>
      <mass value="40.0"/>
      <inertia ixx="0.507" ixy="0" ixz="0" iyy="3.408" iyz="0" izz="3.765"/>
    </inertial>
  </link>

  <joint name="chassis_joint" type="fixed">
    <parent link="base_link"/>
    <child link="chassis"/>
    <origin xyz="0 0 0.075" rpy="0 0 0"/>
  </joint>

  <!-- ==================== SAFETY CUSHION (visual only) ====================
       The 6 cm clearance margin, drawn. This is the SAME rectangle
       nav2_params.yaml declares as the costmap footprint:

           chassis   0.36 x 1.00 m
           + 6 cm all round
           = 1.12 x 0.48 m   ->  x = +/-0.56, y = +/-0.24

       Purpose is to make the stop condition something you can SEE rather
       than infer. When a /scan_reliable return crosses inside this
       rectangle, the robot is at the cushion boundary in that direction —
       which is exactly the condition the guarded-drive feature will act on.

       ⚠ THIS IS A MIRROR, NOT A SOURCE. The numbers here are duplicated
         from nav2_params.yaml's footprint, and nothing enforces that they
         stay in step. Change one and change the other, or the picture will
         start lying about what the collision check actually does. Once Nav2
         is running, local_costmap/published_footprint is the authoritative
         live version of this same polygon — correct by construction because
         the planner publishes what it actually collision-checks against.
         This link is what gives you the picture in the meantime, and it
         stays useful afterwards for teleop, when Nav2 is not running.

       Visual only: no <collision>, so Gazebo cannot mistake a safety margin
       for a physical object. No <inertial> either — it is massless, same as
       base_footprint, and KDL folds fixed-joint links into the parent.

       Sits at floor level and 1 cm thin so it reads as a footprint decal
       under the chassis rather than a box around it, and so it cannot
       z-fight with the chassis visual above it.
  -->
  <link name="safety_cushion">
    <visual>
      <geometry>
        <box size="1.12 0.48 0.01"/>
      </geometry>
      <material name="cushion_amber"/>
    </visual>
  </link>
  <joint name="safety_cushion_joint" type="fixed">
    <parent link="base_link"/>
    <child link="safety_cushion"/>
    <origin xyz="0 0 0.005" rpy="0 0 0"/>
  </joint>

  <!-- ==================== WHEELS ==================== -->
  <!-- Wheel macro: name, parent, xyz offset -->

  <!-- Front-Right (outer: l1 forward, d right, so y is -d) -->
  <link name="wheel_fr">
    <visual>
      <geometry><cylinder radius="0.0762" length="0.06"/></geometry>
      <origin xyz="0 0 0" rpy="1.5708 0 0"/>
      <material name="orange"/>
    </visual>
    <collision>
      <geometry><cylinder radius="0.0762" length="0.06"/></geometry>
      <origin xyz="0 0 0" rpy="1.5708 0 0"/>
    </collision>
    <inertial>
      <mass value="1.385"/>
      <inertia ixx="0.002" ixy="0" ixz="0" iyy="0.004" iyz="0" izz="0.002"/>
    </inertial>
  </link>
  <joint name="wheel_fr_joint" type="continuous">
    <parent link="base_link"/>
    <child link="wheel_fr"/>
    <origin xyz="0.403 -0.15769 0" rpy="0 0 0"/>
    <axis xyz="0 1 0"/>
  </joint>

  <!-- Front-Left (inner: l2 forward, d left, so y is +d) -->
  <link name="wheel_fl">
    <visual>
      <geometry><cylinder radius="0.0762" length="0.06"/></geometry>
      <origin xyz="0 0 0" rpy="1.5708 0 0"/>
      <material name="orange"/>
    </visual>
    <collision>
      <geometry><cylinder radius="0.0762" length="0.06"/></geometry>
      <origin xyz="0 0 0" rpy="1.5708 0 0"/>
    </collision>
    <inertial>
      <mass value="1.385"/>
      <inertia ixx="0.002" ixy="0" ixz="0" iyy="0.004" iyz="0" izz="0.002"/>
    </inertial>
  </link>
  <joint name="wheel_fl_joint" type="continuous">
    <parent link="base_link"/>
    <child link="wheel_fl"/>
    <origin xyz="0.333 0.15769 0" rpy="0 0 0"/>
    <axis xyz="0 1 0"/>
  </joint>

  <!-- Rear-Right (inner: l2 backward, d right, so y is -d) -->
  <link name="wheel_rr">
    <visual>
      <geometry><cylinder radius="0.0762" length="0.06"/></geometry>
      <origin xyz="0 0 0" rpy="1.5708 0 0"/>
      <material name="orange"/>
    </visual>
    <collision>
      <geometry><cylinder radius="0.0762" length="0.06"/></geometry>
      <origin xyz="0 0 0" rpy="1.5708 0 0"/>
    </collision>
    <inertial>
      <mass value="1.385"/>
      <inertia ixx="0.002" ixy="0" ixz="0" iyy="0.004" iyz="0" izz="0.002"/>
    </inertial>
  </link>
  <joint name="wheel_rr_joint" type="continuous">
    <parent link="base_link"/>
    <child link="wheel_rr"/>
    <origin xyz="-0.333 -0.15769 0" rpy="0 0 0"/>
    <axis xyz="0 1 0"/>
  </joint>

  <!-- Rear-Left (outer: l1 backward, d left, so y is +d) -->
  <link name="wheel_rl">
    <visual>
      <geometry><cylinder radius="0.0762" length="0.06"/></geometry>
      <origin xyz="0 0 0" rpy="1.5708 0 0"/>
      <material name="orange"/>
    </visual>
    <collision>
      <geometry><cylinder radius="0.0762" length="0.06"/></geometry>
      <origin xyz="0 0 0" rpy="1.5708 0 0"/>
    </collision>
    <inertial>
      <mass value="1.385"/>
      <inertia ixx="0.002" ixy="0" ixz="0" iyy="0.004" iyz="0" izz="0.002"/>
    </inertial>
  </link>
  <joint name="wheel_rl_joint" type="continuous">
    <parent link="base_link"/>
    <child link="wheel_rl"/>
    <origin xyz="-0.403 0.15769 0" rpy="0 0 0"/>
    <axis xyz="0 1 0"/>
  </joint>

  <!-- ==================== SENSOR FRAMES ==================== -->

  <!-- LiDAR mount: on top of the battery (Position 2, Research_Journal.md §17.4).

       IN-PLANE POSITION TAPE-MEASURED 12 Aug 2026 (§17.12) — this is no
       longer the derived-from-deltas estimate it used to be. Measured to the
       marked centre point on the LiDAR housing (its true optical origin, NOT
       the robot's centre — a distinction worth keeping, they are 0.27 m apart):

         X (forward) : front edge -> base_link      = 0.500 m
                       front edge -> LiDAR centre   = 0.230 m
                       => LiDAR is 0.270 m FORWARD of base_link.

         Y (left)    : chassis-plate half-width     = 0.125 m  (of 0.250 m)
                       plate edge -> LiDAR centre   = 0.120 m
                       => 0.005 m off the centreline. Modelled as 0, which is
                          well inside tape-measure precision and inside the
                          5 cm costmap resolution this ultimately feeds.

       Z (height) IS STILL THE OLD ESTIMATE, not measured — carried over from
       the §17.4 derivation (pre-trial estimate 0.20 + the reported +0.075
       "one battery height" delta). Everything above it in this comment is
       measured; this one number is not. Measure it if the LiDAR's height ever
       matters — it does not for a 2-D occupancy grid, which is why it wasn't
       chased.

       ⚠ ydlidar_ros2_driver's own launch file publishes a COMPETING static
         base_link -> laser_frame transform, and as of §17.9 the live one is
         its stale placeholder (0, 0, 0.02) with zero rotation, not this. Two
         publishers of one transform fight. Before robot_state_publisher is
         added to aislebot_full.launch.py, the driver's must be suppressed, or
         this correct value will flicker against that wrong one. -->
  <link name="laser_frame">
    <visual>
      <geometry><cylinder radius="0.04" length="0.04"/></geometry>
      <material name="blue"/>
    </visual>
    <inertial>
      <mass value="0.2"/>
      <inertia ixx="0.0001" ixy="0" ixz="0" iyy="0.0001" iyz="0" izz="0.0001"/>
    </inertial>
  </link>
  <joint name="laser_joint" type="fixed">
    <parent link="base_link"/>
    <child link="laser_frame"/>
    <origin xyz="0.27 0 0.275" rpy="0 0 0"/>
  </joint>

  <!-- IMU (center of chassis) -->
  <link name="imu_link">
    <visual>
      <geometry><box size="0.02 0.02 0.005"/></geometry>
      <material name="blue"/>
    </visual>
    <inertial>
      <mass value="0.01"/>
      <inertia ixx="0.000001" ixy="0" ixz="0" iyy="0.000001" iyz="0" izz="0.000001"/>
    </inertial>
  </link>
  <joint name="imu_joint" type="fixed">
    <parent link="base_link"/>
    <child link="imu_link"/>
    <origin xyz="0 0 0.05" rpy="0 0 0"/>
  </joint>

  <!-- ==================== GAZEBO PLUGIN ==================== -->
  <gazebo>
    <plugin name="object_controller" filename="libgazebo_ros_planar_move.so">
      <ros>
        <namespace>/</namespace>
        <argument>cmd_vel:=cmd_vel</argument>
        <argument>odom:=sim_odom</argument>
      </ros>
      <update_rate>100</update_rate>
      <publish_rate>50</publish_rate>
      <publish_odom>true</publish_odom>
      <publish_odom_tf>false</publish_odom_tf>
      <odometry_frame>odom</odometry_frame>
      <robot_base_frame>base_link</robot_base_frame>
    </plugin>
  </gazebo>

  <!-- Gazebo colors -->
  <gazebo reference="chassis">
    <material>Gazebo/DarkGrey</material>
  </gazebo>
  <gazebo reference="wheel_fr"><material>Gazebo/Orange</material></gazebo>
  <gazebo reference="wheel_fl"><material>Gazebo/Orange</material></gazebo>
  <gazebo reference="wheel_rr"><material>Gazebo/Orange</material></gazebo>
  <gazebo reference="wheel_rl"><material>Gazebo/Orange</material></gazebo>
  <gazebo reference="laser_frame"><material>Gazebo/Blue</material></gazebo>

  <!-- Simulated LiDAR sensor -->
  <gazebo reference="laser_frame">
    <sensor type="ray" name="ydlidar">
      <pose>0 0 0 0 0 0</pose>
      <visualize>true</visualize>
      <update_rate>10</update_rate>
      <ray>
        <scan>
          <horizontal>
            <samples>360</samples>
            <resolution>1</resolution>
            <min_angle>-3.14159</min_angle>
            <max_angle>3.14159</max_angle>
          </horizontal>
        </scan>
        <!-- 0.12-10 m is the YDLIDAR X4 Pro's actual spec. The 12.0 that was
             here was inherited from the originally-planned RPLiDAR A1 and
             exceeded this hardware's real maximum, the same stale figure
             already corrected in nav2_params.yaml (§17.6). Simulation-only,
             but a simulated sensor that outranges the real one is a way to
             make the sim quietly easier than reality. -->
        <range>
          <min>0.12</min>
          <max>10.0</max>
          <resolution>0.01</resolution>
        </range>
        <noise>
          <type>gaussian</type>
          <mean>0.0</mean>
          <stddev>0.01</stddev>
        </noise>
      </ray>
      <plugin name="gazebo_ros_lidar" filename="libgazebo_ros_ray_sensor.so">
        <ros>
          <remapping>~/out:=scan</remapping>
        </ros>
        <output_type>sensor_msgs/LaserScan</output_type>
        <frame_name>laser_frame</frame_name>
      </plugin>
    </sensor>
  </gazebo>

  <!-- Simulated IMU -->
  <gazebo reference="imu_link">
    <sensor type="imu" name="imu_sensor">
      <always_on>true</always_on>
      <update_rate>100</update_rate>
      <imu>
        <angular_velocity>
          <x><noise type="gaussian"><mean>0</mean><stddev>0.0002</stddev></noise></x>
          <y><noise type="gaussian"><mean>0</mean><stddev>0.0002</stddev></noise></y>
          <z><noise type="gaussian"><mean>0</mean><stddev>0.0002</stddev></noise></z>
        </angular_velocity>
        <linear_acceleration>
          <x><noise type="gaussian"><mean>0</mean><stddev>0.017</stddev></noise></x>
          <y><noise type="gaussian"><mean>0</mean><stddev>0.017</stddev></noise></y>
          <z><noise type="gaussian"><mean>0</mean><stddev>0.017</stddev></noise></z>
        </linear_acceleration>
      </imu>
      <plugin name="imu_plugin" filename="libgazebo_ros_imu_sensor.so">
        <ros>
          <remapping>~/out:=imu/data</remapping>
        </ros>
        <initial_orientation_as_reference>false</initial_orientation_as_reference>
        <frame_name>imu_link</frame_name>
      </plugin>
    </sensor>
  </gazebo>

</robot>
