AritraD11/NarrowAisleBot/src/mecanum_robot/mecanum_robot/phone_dashboard.py

#!/usr/bin/env python3
"""
╔══════════════════════════════════════════════════════════════════╗
║  AisleBot Phone Dashboard v2.5                                   ║
║  ROS2 Node + FastAPI WebSocket on port 8080                      ║
║                                                                    ║
║  Controls:                                                       ║
║    • Drive joystick (vx / vy) + separate yaw slider              ║
║    • Speed: SLOW (33%) / NORMAL (67%) / FAST (100%)              ║
║    • Arm: LIFT / LOWER / OPEN / CLOSE (hold to move)             ║
║    • Map -> mapping_full.launch.py + telemetry recording,        ║
║      together, one action -> ~/aislebot_logs/run_*.csv           ║
║    • E-STOP (latches) / CLEAR                                    ║
║                                                                    ║
║  FIXES in v2.1:                                                  ║
║    • Speed buttons: touchstart replaces onclick (mobile fix)     ║
║    • MAX_LINEAR lowered to 0.15 m/s (prevents motor saturation)  ║
║    • Auto-ENABLE arm on WebSocket connect                        ║
║    • ESTOP CLEAR also re-enables arm                             ║
║                                                                    ║
║  NEW in v2.2 -- desktop/PC support (no touchscreen needed):      ║
║    • All controls also bound to mouse (click + drag)             ║
║    • Hidden keyboard control, not shown anywhere in the UI:      ║
║        W/A/S/D  -> drive joystick                                ║
║        Q/E      -> yaw (Q = CCW, E = CW)                         ║
║        M        -> toggle mapping                                ║
║                                                                    ║
║  NEW in v2.3 -- Map button (Research_Journal.md Part XVI 16.11): ║
║    • Replaces RECORD RUN. One press starts mapping_full.launch.py║
║      (lidar + relay + slam_toolbox, as a managed subprocess      ║
║      group) AND telemetry/PID recording together -- every run    ║
║      is recorded by default, no separate toggle.                 ║
║    • Second press (or E-STOP) SIGINTs the launch tree's process  ║
║      group and stops recording, together.                        ║
║    • Same UI slot is a deliberate placeholder for a future        ║
║      "Autonomous Drive" button once SLAM is trusted -- not built  ║
║      yet, this is trigger-only.                                   ║
║                                                                    ║
║  NEW in v2.4 -- CALIBRATE button (Research_Journal.md 17.20-17.21)║
║    • Runs tools/zero_point_scan.py as a managed subprocess: at    ║
║      each of four 90-deg headings it checks whether /map actually ║
║      grew, nudges <=0.15 m ONLY if it did not, and returns to the ║
║      exact start pose as its final action. Fills the 360-deg base ║
║      map from the zero mark without hand-driving it.              ║
║    • THIS IS THE FIRST BUTTON THAT COMMANDS AUTONOMOUS MOTION.    ║
║      Everything below exists because of that, not for polish:     ║
║        - Two-tap arm. One stray tap cannot start a 45 kg robot.   ║
║        - Refuses to start unless mapping is live AND bt_navigator ║
║          is on the graph -- without both, the script would fail   ║
║          obscurely several seconds in rather than plainly now.    ║
║        - Second press = SIGINT, which the script traps to drive   ║
║          home before exiting. E-STOP = SIGKILL + a cancel-all on  ║
║          /navigate_to_pose, because killing the script alone      ║
║          leaves Nav2 still executing its last accepted goal.      ║
║        - stdout/stderr -> ~/aislebot_logs/calib_*.log, and the    ║
║          last lines are polled back to the phone, so a run that   ║
║          misbehaves is diagnosable afterwards rather than silent. ║
║                                                                    ║
║  NEW in v2.6 -- the display compensations are GONE, because the   ║
║  frame underneath them was fixed (Research_Journal.md §17.38):    ║
║    • odometry_publisher.py used to publish rotated orientation    ║
║      but UNrotated translation, which defined odom's axes to be   ║
║      REP-103's and left a constant -90 deg seam that map          ║
║      inherited. Forward drive really did increase map X. Every    ║
║      compensation in this file existed to hide that.              ║
║    • It is fixed at the source now: odom, map and base_link all   ║
║      share one frame (then +X right, +Y forward; v2.8 made it     ║
║      REP-103). This file prints the raw map frame verbatim --     ║
║      no relabel, nothing to keep in sync.                         ║
║    • (v2.6 set DISPLAY_ROT = 0 because map +Y was forward. That  ║
║      was the old convention; v2.8 below supersedes it.)           ║
║    • NOSE prints raw yaw. The old +90 deg existed so that "on the ║
║      mark" read 0 deg while raw yaw was -90; raw yaw on the mark  ║
║      is 0, so the offset would introduce the error it removed.    ║
║    • Do NOT re-add a display-side axis fix here. If the printed   ║
║      X/Y ever disagrees with the robot again, the frame is wrong  ║
║      upstream and this is the wrong file to change -- read        ║
║      docs/Axis_Convention.md first.                               ║
║    • The Python ROS/control class below is unchanged (verified    ║
║      byte-identical against the deployed fork, 27 Aug) -- only    ║
║      this HTML/JS presentation layer ever differed.               ║
║                                                                    ║
║  NEW in v2.8 (5 Oct 2026) -- STANDARD AXES, SAME PICTURE:        ║
║    • The whole stack is REP-103 now: +X nose, +Y left, yaw CCW    ║
║      from +X. The map still draws with the nose UP the screen,    ║
║      because DISPLAY_ROT = -PI/2 spins the canvas: world +X is    ║
║      screen-up and world +Y is screen-left. Nothing printed is    ║
║      relabelled; the numbers are the real map frame.              ║
║    • vecToYaw / yawToVec are plain atan2 / (cos, sin). The robot  ║
║      footprint is 1.12 long on X, 0.48 wide on Y; the LiDAR sits  ║
║      0.27 m ahead on X. Joystick sendDrive() was already standard.║
║    • Saved goals, maps and bags from before 5 Oct are in the old  ║
║      frame: x_new = y_old, y_new = -x_old.                        ║
║                                                                    ║
║  NEW in v2.7 (5 Oct 2026) -- NAV2 button, LIDAR tuner removed:   ║
║    • NAV2 starts and stops nav2_slam.launch.py as a managed       ║
║      process group, like MAP does for mapping. It refuses until   ║
║      MAP has run 30 s (map first, then Nav2). Output goes to      ║
║      ~/aislebot_logs/nav2_*.log. Stop = cancel goals + SIGINT.    ║
║      MAP stop and E-STOP stop Nav2 first.                         ║
║    • The pose box shows Nav2 state and the latest goal (status,   ║
║      straight-line distance to the plan end, time), and folds     ║
║      down to two lines with its +/- button.                       ║
║    • The LIDAR tuner is gone. The LiDAR settings are fixed in     ║
║      scan_relay.py's defaults (2.5 m cap, no persistence gate).   ║
║                                                                    ║
║  ROS2 Topics:                                                    ║
║    Publishes  /cmd_vel_manual   geometry_msgs/Twist  (drive) —   ║
║      goes through twist_mux (config/twist_mux.yaml) before       ║
║      reaching the wheels, so it wins over Nav2 whenever this     ║
║      is actively publishing.                                     ║
║    Publishes  /arm/command      std_msgs/String       (arm)      ║
║    Publishes  /esp32/command    std_msgs/String  (<L1>/<L0>/…)   ║
║    Subscribes /motor_telemetry  std_msgs/Float64MultiArray       ║
║                                                                    ║
║  Aritra Das (25D0074) — IIT Bombay — Prof. Ambarish Kunwar        ║
╚══════════════════════════════════════════════════════════════════╝
"""

import rclpy
from rclpy.node import Node
from rclpy.qos import (QoSDurabilityPolicy, QoSHistoryPolicy, QoSProfile,
                       QoSReliabilityPolicy)
from geometry_msgs.msg import PoseStamped, Twist
from action_msgs.msg import GoalStatusArray
from nav_msgs.msg import OccupancyGrid, Path
from std_srvs.srv import Trigger
from sensor_msgs.msg import LaserScan
from std_msgs.msg import Empty, String, Float64MultiArray
import tf2_ros
from tf2_ros import TransformException

import threading
import uvicorn
from fastapi import FastAPI, WebSocket, WebSocketDisconnect
from fastapi.responses import HTMLResponse

import asyncio
import base64
import json
import csv
import math
import os
import contextlib
import shutil
import signal
import subprocess
import time
from datetime import datetime
from typing import Optional, Set

from .run_report import generate_report, write_report

# ═══════════════════════════════════════════════════════════════════
#  ROBOT CONSTANTS
#  FIX: MAX_LINEAR lowered from 0.48 → 0.15 m/s
#       At 0.48, forward drive needed 6.3 rad/s — 2x the motor cap.
#       0.15 m/s gives max wheel speed ~1.97 rad/s — safe headroom.
#       SLOW/MED/FAST are now clearly different and always within limits.
# ═══════════════════════════════════════════════════════════════════
MAX_LINEAR_SPEED  = 0.15   # m/s   — matches established working value
MAX_ANGULAR_SPEED = 0.30   # rad/s — matches joy_to_aislebot parameter

SPEED_MODES = [
    {"name": "SLOW",   "mult": 0.33, "label": "0.05 m/s"},
    {"name": "NORMAL", "mult": 0.67, "label": "0.10 m/s"},
    {"name": "FAST",   "mult": 1.00, "label": "0.15 m/s"},
]

# ═══════════════════════════════════════════════════════════════════
#  HTML DASHBOARD
# ═══════════════════════════════════════════════════════════════════
DASHBOARD_HTML = """<!DOCTYPE html>
<html lang="en">
<head>
<meta charset="UTF-8">
<meta name="viewport" content="width=device-width,initial-scale=1,maximum-scale=1,user-scalable=no">
<title>AisleBot</title>

<style>
:root{
  --bg:#f4f6f8;--panel:#ffffff;--panel-2:#f8fafc;--line:#d0d5dd;
  --text:#17202a;--muted:#667085;--blue:#1677ff;--blue-soft:#eaf2ff;
  --green:#12b76a;--green-soft:#e9f8f1;--amber:#f79009;--amber-soft:#fff4e5;
  --red:#d92d20;--red-soft:#fff0ee;--shadow:0 6px 24px rgba(16,24,40,.08);
}
*{margin:0;padding:0;box-sizing:border-box;-webkit-user-select:none;user-select:none;touch-action:none}
html,body{width:100vw;height:100vh;overflow:hidden;background:var(--bg);color:var(--text);font-family:Inter,ui-sans-serif,system-ui,-apple-system,BlinkMacSystemFont,'Segoe UI',sans-serif}
button{font:inherit}
.hdr{height:54px;display:flex;align-items:center;justify-content:space-between;padding:0 14px;
  background:rgba(255,255,255,.96);border-bottom:1px solid var(--line);gap:10px;flex-shrink:0}
.hdr-left{display:flex;align-items:center;gap:10px;min-width:0}.hdr-title{font-size:15px;font-weight:800;letter-spacing:1.4px;white-space:nowrap}.hdr-sub{font-size:9px;color:var(--muted);font-weight:700;letter-spacing:.8px;white-space:nowrap}
.status-pills{display:flex;gap:4px;overflow:hidden}.state-pill{font-size:9px;font-weight:800;border:1px solid var(--line);border-radius:999px;padding:4px 7px;background:#fff;color:var(--muted);white-space:nowrap}.state-pill.good{color:#087443;background:var(--green-soft);border-color:#b7e6d0}.state-pill.bad{color:#b42318;background:var(--red-soft);border-color:#f4c7c2}.state-pill.muted{color:#667085;background:#f2f4f7}
.hdr-right{display:flex;align-items:center;gap:8px}.speed-label{font-size:9px;color:var(--muted);font-weight:700}.spd-group{display:flex;gap:4px}.spd-btn{min-width:54px;padding:6px 8px;border-radius:7px;border:1px solid var(--line);background:#fff;color:#667085;font-size:9px;font-weight:800;cursor:pointer;touch-action:manipulation}.spd-btn.active-slow{background:#edf9f3;color:#087443;border-color:#9dd9ba}.spd-btn.active-normal{background:#fff5e8;color:#a15c00;border-color:#f2c27a}.spd-btn.active-fast{background:#fff0ee;color:#b42318;border-color:#efaaa3}
.view-btn{padding:7px 11px;border-radius:7px;border:1px solid var(--line);background:#fff;color:#344054;font-size:9px;font-weight:800;cursor:pointer;touch-action:manipulation}.view-btn.on{background:var(--blue-soft);color:#1457b9;border-color:#a8c8ff}
.map-badge{font-size:9px;font-weight:800;padding:4px 7px;border-radius:999px;background:var(--blue-soft);color:#1457b9;display:none}.map-badge.show{display:inline-block}
.status-dot{display:none}.spd-indicator{height:22px;display:flex;align-items:center;justify-content:center;background:#f8fafc;border-bottom:1px solid var(--line);font-size:9px;color:var(--muted);font-weight:700;letter-spacing:.5px;flex-shrink:0}.spd-indicator #spdValue{color:#1457b9}
.body{display:flex;height:calc(100vh - 54px - 22px - 74px);min-height:0}
.joy-area{flex:1;position:relative;display:flex;align-items:center;justify-content:center;background:var(--bg);overflow:hidden}
.drive-info{position:absolute;top:12px;left:12px;z-index:3;display:flex;gap:8px;align-items:stretch;pointer-events:none}.info-card{background:rgba(255,255,255,.94);border:1px solid var(--line);border-radius:9px;padding:7px 9px;box-shadow:var(--shadow);min-width:92px}.info-card .k{font-size:8px;color:var(--muted);font-weight:800;letter-spacing:.6px}.info-card .v{font-size:14px;font-weight:800;margin-top:2px}.info-card .s{font-size:9px;color:var(--muted);margin-top:1px}
.motion-card{position:absolute;right:12px;top:12px;z-index:3;background:rgba(255,255,255,.94);border:1px solid var(--line);border-radius:9px;padding:8px 10px;box-shadow:var(--shadow);pointer-events:none;min-width:128px}.motion-card .title{font-size:8px;color:var(--muted);font-weight:800;letter-spacing:.6px}.motion-state{font-size:12px;font-weight:900;margin:2px 0 5px}.cmd-row{display:grid;grid-template-columns:28px 1fr;gap:4px;font-size:9px;color:#475467}.cmd-row strong{font-weight:800;color:var(--text)}
.joy-ring{width:min(58vw,280px);height:min(58vw,280px);max-width:62vh;max-height:62vh;border-radius:50%;border:2px solid #b9c5d3;background:radial-gradient(circle,#fff 0%,#f7f9fb 65%,#eef2f5 100%);position:relative;flex-shrink:0;cursor:grab;box-shadow:inset 0 0 0 12px rgba(22,119,255,.025),0 10px 28px rgba(16,24,40,.06)}
.joy-ring::before,.joy-ring::after{content:'';position:absolute;background:#d7dee7;pointer-events:none}.joy-ring::before{width:1px;height:78%;left:50%;top:11%}.joy-ring::after{height:1px;width:78%;top:50%;left:11%}
.joy-thumb{width:66px;height:66px;border-radius:50%;position:absolute;top:50%;left:50%;transform:translate(-50%,-50%);background:radial-gradient(circle at 34% 30%,#5ea5ff,#1677ff 65%,#0f5fd1);box-shadow:0 7px 18px rgba(22,119,255,.28);transition:box-shadow .1s}.joy-thumb.active{box-shadow:0 10px 24px rgba(22,119,255,.42)}
.jlbl{position:absolute;font-size:8px;color:#98a2b3;font-weight:800;letter-spacing:.8px}.jlbl.t{top:6%;left:50%;transform:translateX(-50%)}.jlbl.b{bottom:6%;left:50%;transform:translateX(-50%)}.jlbl.l{left:5%;top:50%;transform:translateY(-50%)}.jlbl.r{right:5%;top:50%;transform:translateY(-50%)}
.right-panel{width:126px;display:flex;flex-direction:column;border-left:1px solid var(--line);background:#fff;flex-shrink:0;transition:width .18s ease}.right-panel .section-title{font-size:8px;color:#98a2b3;font-weight:800;letter-spacing:.8px;text-align:center}
body.map-mode .right-panel{width:70px}.yaw-wrap{flex:2;display:flex;flex-direction:column;align-items:center;justify-content:center;padding:10px 0;gap:7px;border-bottom:1px solid var(--line)}.yaw-lbl{font-size:8px;color:#98a2b3;letter-spacing:1px;font-weight:800}.yaw-track{width:24px;flex:1;max-height:120px;background:#f2f4f7;border-radius:12px;border:1px solid #c9d2dc;position:relative;cursor:pointer;touch-action:none}.yaw-thumb{width:38px;height:38px;border-radius:50%;position:absolute;left:50%;top:50%;transform:translate(-50%,-50%);background:radial-gradient(circle at 35% 30%,#ffd591,#f79009 70%);box-shadow:0 6px 14px rgba(247,144,9,.25)}
.arm-section,.lift-section{display:flex;flex-direction:column;padding:7px;gap:6px;justify-content:center}.arm-section{flex:3;border-bottom:1px solid var(--line)}.lift-section{flex:2}body.map-mode .arm-section,body.map-mode .lift-section{display:none}body.map-mode .yaw-wrap{flex:1;border-bottom:none;padding:14px 0}.arm-btn,.lift-btn{flex:1;border-radius:7px;cursor:pointer;touch-action:manipulation;font-weight:800}.arm-btn{border:1px solid #b7e6d0;background:#f1fbf6;color:#087443;font-size:9px}.arm-btn:active,.arm-btn.held{background:#dff5e9}.lift-btn{border:1px solid #b9d5ff;background:#f3f7ff;color:#1457b9;font-size:10px}.lift-btn:active,.lift-btn.held{background:#e5efff}
.bottom{height:74px;display:flex;flex-shrink:0;border-top:1px solid var(--line);background:#fff;box-shadow:0 -4px 18px rgba(16,24,40,.04)}.bottom>button{flex:1;border:none;border-right:1px solid var(--line);background:#fff;cursor:pointer;touch-action:manipulation}.map-btn,.cal-btn,.uv-btn{display:flex;flex-direction:column;align-items:center;justify-content:center;gap:4px;font-size:10px;font-weight:900}.map-btn{color:#1457b9}.map-btn.mapping{background:#edf5ff;color:#1457b9}.cal-btn{color:#a15c00}.cal-btn.disabled{color:#98a2b3;background:#f8fafc;pointer-events:none}.cal-btn.armed,.cal-btn.running{background:#fff5e8;color:#9a6700}.uv-btn{color:#7a4fb3}.uv-btn.on{background:#f7f1ff;color:#6d3ea0}.map-icon,.cal-icon,.uv-icon{font-size:18px;line-height:1}.estop-btn{flex:1;display:flex;flex-direction:column;align-items:center;justify-content:center;gap:3px}.estop-circle{width:48px;height:48px;border-radius:50%;background:#fff0ee;border:2px solid #e99b93;color:#b42318;display:flex;align-items:center;justify-content:center;font-size:9px;font-weight:900;box-shadow:0 3px 10px rgba(217,45,32,.08)}.estop-btn:active .estop-circle{transform:scale(.92)}.estop-btn.armed .estop-circle{background:#d92d20;border-color:#b42318;color:#fff;box-shadow:0 5px 18px rgba(217,45,32,.25)}.estop-lbl{font-size:8px;color:#667085;font-weight:800}
.map-view{position:absolute;inset:0;background:#f4f6f8;display:none;z-index:6}.map-view.show{display:block}#mapCanvas{width:100%;height:100%;display:block;touch-action:none}.stale{opacity:.45;filter:grayscale(1)}.map-hud{position:absolute;top:11px;left:11px;background:rgba(255,255,255,.94);border:1px solid var(--line);border-radius:9px;padding:9px 10px;box-shadow:var(--shadow);font-size:10px;color:var(--text);pointer-events:none;min-width:175px}.hud-title{font-size:8px;font-weight:900;color:var(--muted);letter-spacing:.7px;margin-bottom:6px}.hud-grid{display:grid;grid-template-columns:42px 1fr;gap:4px 8px}.hud-grid span{color:var(--muted);font-weight:800;font-size:9px}.hud-grid strong{font-size:13px}.hud-muted{font-size:9px;color:var(--muted)}.hud-sep{height:1px;background:var(--line);margin:7px 0 6px}.drift-ok{color:#087443}.drift-bad{color:#b42318}.map-status{position:absolute;left:12px;bottom:10px;background:rgba(255,255,255,.92);border:1px solid var(--line);border-radius:7px;padding:5px 8px;color:#667085;font-size:8px;font-weight:800;pointer-events:none}.map-tools{position:absolute;top:11px;right:11px;display:flex;flex-direction:column;gap:5px}.mt-btn{min-width:42px;height:30px;border-radius:7px;border:1px solid var(--line);background:rgba(255,255,255,.95);color:#344054;font-size:9px;font-weight:900;box-shadow:0 2px 8px rgba(16,24,40,.06);touch-action:manipulation}.mt-btn.armed,.mt-btn.active{background:var(--amber-soft);color:#9a6700;border-color:#f2c27a}.map-hint{position:absolute;bottom:10px;left:50%;transform:translateX(-50%);font-size:9px;font-weight:800;letter-spacing:.4px;padding:5px 10px;border-radius:999px;background:rgba(255,255,255,.94);color:#667085;border:1px solid var(--line);pointer-events:none;white-space:nowrap}.map-hint.armed{background:var(--amber-soft);color:#9a6700;border-color:#f2c27a}
.layer-panel{position:absolute;top:50px;right:58px;width:204px;background:#fff;border:1px solid var(--line);border-radius:10px;box-shadow:var(--shadow);padding:10px;display:none;z-index:12}.layer-panel.show{display:block}.layer-head{display:flex;align-items:center;justify-content:space-between;margin-bottom:8px}.layer-title{font-size:10px;font-weight:900}.layer-close{border:0;background:none;color:#667085;font-size:14px}.layer-row{display:flex;align-items:center;justify-content:space-between;padding:7px 2px;border-top:1px solid #eef2f6;font-size:9px;color:#475467}.layer-row input{accent-color:#1677ff}.layer-note{margin-top:8px;font-size:8px;line-height:1.35;color:#98a2b3}.layer-clear{width:100%;margin-top:9px;padding:7px 6px;border:1px solid var(--line);border-radius:7px;background:#fff;color:#475467;font-size:8px;font-weight:900;letter-spacing:.4px;cursor:pointer}.layer-clear:active{background:#f2f4f7}.research-chip{position:absolute;top:12px;left:50%;transform:translateX(-50%);z-index:10;background:#17202a;color:#fff;border-radius:999px;padding:5px 10px;font-size:8px;font-weight:900;letter-spacing:.5px;display:none;pointer-events:none}.research-chip.show{display:block}
.cal-status{position:absolute;top:0;left:0;right:0;z-index:20;display:none;background:rgba(255,255,255,.97);border-bottom:1px solid #f2c27a;padding:7px 9px;font-size:8px;line-height:1.35;color:#9a6700;box-shadow:0 3px 12px rgba(16,24,40,.06);font-family:inherit;max-height:82px;overflow:hidden}.cal-status.show{display:block}.cal-status .cal-hd{font-weight:900;letter-spacing:.7px;color:#a15c00}
.flash{position:fixed;inset:0;background:rgba(217,45,32,.12);pointer-events:none;opacity:0;transition:opacity .25s;z-index:999}.flash.show{opacity:1}
.hud-head{display:flex;align-items:center;justify-content:space-between;gap:8px;margin-bottom:6px}.hud-head .hud-title{margin-bottom:0}.hud-toggle{pointer-events:auto;cursor:pointer;width:22px;height:20px;padding:0;border:1px solid var(--line);border-radius:5px;background:#fff;color:#475467;font-size:13px;font-weight:900;line-height:16px;touch-action:manipulation}.hud-mini{font-size:11px;font-weight:800;font-variant-numeric:tabular-nums;margin-top:2px}.mt-btn.nav-up{background:#e7f5ec;color:#12794a;border-color:#a6dcbc}.mt-btn.nav-bad{background:#fdecec;color:#b42318;border-color:#f5b5ae}
@media (max-width:560px){.hdr-sub{display:none}.status-pills{max-width:150px}.speed-label{display:none}.spd-btn{min-width:48px;padding:6px 5px}.hdr{padding:0 9px}.drive-info{left:7px;top:7px;gap:5px}.motion-card{right:7px;top:7px;min-width:116px}.info-card{min-width:78px;padding:6px 7px}.info-card .v{font-size:12px}.motion-card{padding:7px 8px}.layer-panel{right:55px;width:190px}}
</style>

</head>
<body>
<div class="hdr">
  <div class="hdr-left">
    <div><div class="hdr-title">AISLEBOT</div><div class="hdr-sub">NARROW-CHASSIS MOBILE ROBOT</div></div>
    <div class="status-pills"><span class="state-pill bad" id="rosPill">ROS ×</span><span class="state-pill muted" id="mapPill">MAP —</span><span class="state-pill muted" id="posePill">POSE —</span></div>
  </div>
  <div class="hdr-right">
    <span class="speed-label">SPEED</span>
    <div class="spd-group"><button class="spd-btn active-slow" id="spd0">SLOW</button><button class="spd-btn" id="spd1">NORMAL</button><button class="spd-btn" id="spd2">FAST</button></div>
    <button class="view-btn" id="viewBtn">VIEW</button>
    <span class="map-badge" id="mapBadge">MAP</span>
    <span class="status-dot" id="dot"></span>
  </div>
</div>
<div class="spd-indicator">COMMAND LIMIT: <span id="spdValue">SLOW — 0.05 m/s</span></div>
<div class="body">
  <div class="joy-area" id="joyArea">
    <div class="drive-info">
      <div class="info-card"><div class="k">MAP X</div><div class="v" id="liveX">—</div></div>
      <div class="info-card"><div class="k">MAP Y</div><div class="v" id="liveY">—</div></div>
      <div class="info-card"><div class="k">NOSE</div><div class="v" id="liveNose">—</div></div>
      <div class="info-card"><div class="k">PATH</div><div class="v" id="liveDist">0.00 m</div></div>
      <div class="info-card"><div class="k">DRIFT map−odom</div><div class="v" id="liveDrift">—</div></div>
    </div>
    <div class="motion-card">
      <div class="title">MOTION COMMAND</div><div class="motion-state" id="motionState">IDLE</div>
      <div class="cmd-row"><span>Vx</span><strong id="cmdVx">0.00 m/s</strong></div>
      <div class="cmd-row"><span>Vy</span><strong id="cmdVy">0.00 m/s</strong></div>
      <div class="cmd-row"><span>Wz</span><strong id="cmdWz">0.00 rad/s</strong></div>
    </div>
    <div class="research-chip" id="researchChip">RESEARCH VIEW</div>
    <div class="joy-ring" id="joyRing"><span class="jlbl t">FWD</span><span class="jlbl b">REV</span><span class="jlbl l">LEFT</span><span class="jlbl r">RIGHT</span><div class="joy-thumb" id="joyThumb"></div></div>
    <div class="cal-status" id="calStatus"><div class="cal-hd" id="calHd">CALIBRATING</div><div id="calTail"></div></div>
    <div class="map-view" id="mapView">
      <canvas id="mapCanvas"></canvas>
      <div class="map-hud" id="mapHud">WAITING FOR /map</div>
      <div class="map-status" id="mapStatus">MAP GRID WAITING</div>
      <div class="map-tools">
        <button class="mt-btn" id="btnZoomIn" aria-label="Zoom in">+</button>
        <button class="mt-btn" id="btnZoomOut" aria-label="Zoom out">−</button>
        <button class="mt-btn" id="btnFollow">CENTER</button>
        <button class="mt-btn" id="btnGoal">GOAL</button>
        <button class="mt-btn" id="btnZero">ZERO</button>
        <button class="mt-btn" id="btnLayers">LAYERS</button>
        <button class="mt-btn" id="btnNav2">NAV2</button>
        <button class="mt-btn" id="btnResearch">RESEARCH</button>
      </div>
      <div class="layer-panel" id="layerPanel">
        <div class="layer-head"><div class="layer-title">VIEW SETTINGS</div><button class="layer-close" id="btnLayersClose">×</button></div>
        <label class="layer-row">Grid <input id="layer-grid" type="checkbox" checked></label>
        <label class="layer-row">Live LiDAR scan <input id="layer-scan" type="checkbox" checked></label>
        <label class="layer-row">Scale bar <input id="layer-scale" type="checkbox" checked></label>
        <label class="layer-row">Trajectory &mdash; current <input id="layer-trajectory" type="checkbox"></label>
        <label class="layer-row">Trajectory &mdash; past runs <input id="layer-pastTrails" type="checkbox"></label>
        <label class="layer-row">Goal markers <input id="layer-goals" type="checkbox" checked></label>
        <label class="layer-row">Robot footprint <input id="layer-footprint" type="checkbox" checked></label>
        <label class="layer-row">Map axes <input id="layer-axes" type="checkbox"></label>
        <label class="layer-row">Zero mark <input id="layer-zero" type="checkbox" checked></label>
        <label class="layer-row">Research mode <input id="researchToggle" type="checkbox"></label>
        <button class="layer-clear" id="btnClearTrails">CLEAR TRAILS &amp; GOALS</button>
        <div class="layer-note">A new run starts at MAP or re-ZERO; the previous trail moves to &ldquo;past runs&rdquo;. Clearing is display-only &mdash; it discards nothing ROS has recorded, and no option here changes ROS behavior.</div>
      </div>

      <div class="map-hint" id="mapHint">DRAG TO PAN · PINCH TO ZOOM</div>
    </div>
  </div>
  <div class="right-panel">
    <div class="yaw-wrap"><span class="section-title">YAW</span><span class="yaw-lbl">CCW</span><div class="yaw-track" id="yawTrack"><div class="yaw-thumb" id="yawThumb"></div></div><span class="yaw-lbl">CW</span></div>
    <div class="arm-section"><button class="arm-btn" id="btnOpen">ARM<br>OPEN</button><button class="arm-btn" id="btnClose">ARM<br>CLOSE</button></div>
    <div class="lift-section"><button class="lift-btn" id="btnUp">▲ LIFT</button><button class="lift-btn" id="btnDown">▼ LOWER</button></div>
  </div>
</div>
<div class="bottom">
  <button class="map-btn" id="mapBtn"><span class="map-icon" id="mapIcon">▦</span><span id="mapLabel">MAP</span></button>
  <button class="cal-btn disabled" id="calBtn"><span class="cal-icon" id="calIcon">⟳</span><span id="calLabel">CALIBRATE</span></button>
  <button class="uv-btn" id="uvBtn"><span class="uv-icon" id="uvIcon">☼</span><span id="uvLabel">UV LIGHTS</span></button>
  <button class="estop-btn" id="estopBtn"><div class="estop-circle" id="estopCircle">E-STOP</div><span class="estop-lbl" id="estopLbl">TAP TO STOP</span></button>
</div>
<div class="flash" id="flash"></div>
<script>

// ── CONFIG ────────────────────────────────────────────────────────
// FIX: MAX_LINEAR lowered from 0.48 → 0.15 m/s to prevent motor saturation.
// Old: SLOW=0.12, MED=0.29, FAST=0.48 → MED and FAST both hit the 3 rad/s
//      wheel speed cap and felt identical.
// New: SLOW=0.05, MED=0.10, FAST=0.15 → all clearly different, all safe.
const MAX_LINEAR  = 0.15;   // m/s
const MAX_ANGULAR = 0.30;   // rad/s
const DEADZONE    = 0.07;
const SPEEDS      = [0.33, 0.67, 1.00];
const SPD_LABELS  = ['SLOW — 0.05 m/s', 'MED — 0.10 m/s', 'FAST — 0.15 m/s'];
const SPD_ACTIVE  = ['active-slow', 'active-normal', 'active-fast'];

// ── STATE ─────────────────────────────────────────────────────────
let ws, wsOk = false;
let speedIdx    = 0;
let joyX = 0, joyY = 0, joyActive = false, joyTouchId = null;
let yawVal = 0, yawActive = false, yawTouchId = null;
let estopped  = false;
let mapping   = false;
let armInterval = null;

// ── Cosmetic / operator-view state (does not alter ROS commands) ──
const mapLayers = {
  grid: true,
  scale: true,
  // Live LiDAR returns. ON by default, deliberately: this is the layer
  // that shows the operator the scan instability §17.45 measured, and a
  // diagnostic nobody switches on is a diagnostic nobody uses.
  scan: true,
  trajectory: false,
  pastTrails: false,
  goals: true,
  footprint: true,
  axes: false,
  zero: true,
};
let mapResearchMode = false;

// TRAILS. `trajectory` is the CURRENT run only. Completed runs move into
// `pastTrails` as separate polylines rather than being concatenated, so a
// re-zero or a fresh MAP does not draw a straight line across the room
// between where the old run ended and the new one starts. Each is toggled
// independently: after several attempts the accumulated past trails are
// what makes the canvas unreadable, and that is exactly when you still
// want to see the live one.
let trajectory = [];
let pastTrails = [];
let lastTrajectoryPose = null;
let pathLength = 0;

// PATH is accumulated from ODOMETRY, never from the map pose. A map delta
// includes the map->odom rewrites, which are not motion: on
// run_20260902_114339 the map path came to 5.915 m against 3.227 m actually
// driven, so this card read 83% high with nothing on screen to say so.
let lastOdomPose  = null;
let haveOdomPath  = false;
// Rewrites seen in the current run. Countable on purpose -- it is the
// number that says how much of the trail is estimate rather than travel.
let jumpCount     = 0;
let lastCorr      = null;

// Did slam_toolbox rewrite map->odom on this sample? Between rewrites the
// map pose IS odometry, exactly; at one, the whole frame is redefined and
// the drawn pose moves without the robot moving. Two runs on 2 Sep gave 17
// rewrites each, 3.66 s apart, up to 0.198 m of apparent motion in a single
// 0.1 s tick against 0.005 m of real travel.
//
// Compared with a tolerance, not for equality: the transform is resampled
// every tick and arrives as floats. The thresholds -- 0.1 mm and ~0.0006 deg
// -- sit far below the smallest real correction measured across those two
// runs (translation 0.0466 m, heading 0.230 deg), so no genuine rewrite is
// missed, and far above float resampling noise, so none is invented. cyaw
// may be absent if the robot runs an older node, in which case this
// degrades to translation-only detection rather than throwing.
function corrChanged(m) {
  if (m.cx === undefined) { lastCorr = null; return false; }
  const prev = lastCorr;
  lastCorr = { x: m.cx, y: m.cy, yaw: m.cyaw };
  if (!prev) return false;
  const dyaw = Math.abs((m.cyaw === undefined ? 0 : m.cyaw) -
                        (prev.yaw === undefined ? 0 : prev.yaw));
  return Math.abs(m.cx - prev.x) > 1e-4 ||
         Math.abs(m.cy - prev.y) > 1e-4 ||
         dyaw > 1e-5;
}

// One pose sample, applied. Lifted out of ws.onmessage so the trail rules
// below can be driven directly by tools/tests/dashboard_goal_roundtrip.py:
// a renderer fault that only reproduces through a live socket is a fault
// nothing guards. ox/oy/cx/cy/cyaw are odom and map->odom (§17.49), spread
// rather than listed so a missing transform leaves them undefined and the
// DRIFT block hides itself instead of rendering NaN.
function applyPose(m) {
      robotPose = { x: m.x, y: m.y, yaw: m.yaw,
                    ox: m.ox, oy: m.oy,
                    cx: m.cx, cy: m.cy, cyaw: m.cyaw };

      // Order matters: read the rewrite flag BEFORE anything else consumes
      // the sample, because corrChanged() latches the correction it saw.
      const jumped = corrChanged(m);

      // Distance travelled is a wheel question. See lastOdomPose above.
      if (m.ox !== undefined) {
        if (lastOdomPose) {
          pathLength += Math.hypot(m.ox - lastOdomPose.x, m.oy - lastOdomPose.y);
        }
        lastOdomPose = { x: m.ox, y: m.oy };
        haveOdomPath = true;
      }

      // AFTER pathLength and jumpCount, not before: the card renders both,
      // and drawing it first left PATH one sample stale -- 3.11 m against a
      // measured 3.13 m in the guard below. Small, and exactly the kind of
      // off-by-one a card nobody cross-checks keeps forever.
      updateLivePoseCard();

      if (lastTrajectoryPose) {
        const d = Math.hypot(m.x - lastTrajectoryPose.x, m.y - lastTrajectoryPose.y);
        // `|| jumped` so a rewrite is never dropped for being small: the
        // break has to be recorded even when the frame barely moved, or the
        // trail silently reconnects across it.
        if (d >= 0.005 || jumped) {
          trajectory.push({ x: m.x, y: m.y, brk: jumped });
          if (jumped) jumpCount++;
          if (trajectory.length > MAX_TRAIL_PTS) trajectory.shift();
          lastTrajectoryPose = { x: m.x, y: m.y };
        }
      } else {
        trajectory.push({ x: m.x, y: m.y, brk: false });
        lastTrajectoryPose = { x: m.x, y: m.y };
      }
      if (mapFollow) { camX = m.x; camY = m.y; }
      if (mapView) drawMap();
}

// GOALS. goalDrag is transient (only while placing). activeGoal is the one
// actually SENT and survives the release, because "where did I tell it to
// go" is worth seeing while it drives there. Superseded goals fall back to
// pastGoals so a sequence of commands stays legible.
let activeGoal = null;
let pastGoals  = [];

// Bounded so a long session cannot grow these without limit.
const MAX_TRAIL_PTS   = 2500;
const MAX_PAST_TRAILS = 8;
const MAX_PAST_GOALS  = 12;
const MIN_TRAIL_KEEP  = 4;    // shorter than this is a twitch, not a run

// Close the current trail and start a new one. Called on the events that
// genuinely begin a new run — MAP start and re-zero — never on a goal,
// because a trail records where the robot went, not why.
function startNewTrail() {
  if (trajectory.length >= MIN_TRAIL_KEEP) {
    pastTrails.push(trajectory);
    while (pastTrails.length > MAX_PAST_TRAILS) pastTrails.shift();
  }
  trajectory = [];
  lastTrajectoryPose = null;
  pathLength = 0;
  lastOdomPose = null; haveOdomPath = false; jumpCount = 0; lastCorr = null;
}

function clearAllTrails() {
  trajectory = []; pastTrails = [];
  lastTrajectoryPose = null; pathLength = 0;
  lastOdomPose = null; haveOdomPath = false; jumpCount = 0; lastCorr = null;
  activeGoal = null; pastGoals = [];
  if (mapView) drawMap();
}

// ── Operator display helpers ──────────────────────────────────────
function updateLivePoseCard() {
  if (!robotPose) return;
  const x = document.getElementById('liveX');
  const y = document.getElementById('liveY');
  const n = document.getElementById('liveNose');
  const d = document.getElementById('liveDist');
  // Raw map frame, printed verbatim: standard REP-103 (map +X is the way the
  // nose pointed at the zero mark, +Y is its left). No relabel here or in
  // updateHud() -- if one ever looks needed, the frame upstream is wrong.
  // See docs/Axis_Convention.md.
  if (x) x.textContent = robotPose.x.toFixed(3) + ' m';
  if (y) y.textContent = robotPose.y.toFixed(3) + ' m';
  const noseDeg = ((robotPose.yaw * 180 / Math.PI + 180) % 360 + 360) % 360 - 180;
  if (n) n.textContent = noseDeg.toFixed(1) + '°';
  // Em dash, not 0.00, when there is no odom transform to measure with.
  // A confident zero would be a claim we cannot make.
  if (d) d.textContent = haveOdomPath ? (pathLength.toFixed(2) + ' m') : '\u2014';
  const dr = document.getElementById('liveDrift');
  if (dr) {
    if (robotPose.cx === undefined) { dr.textContent = '—'; dr.className = 'v'; }
    else {
      const c = Math.hypot(robotPose.cx, robotPose.cy);
      dr.textContent = c.toFixed(3) + ' m';
      dr.className = 'v ' + (c >= 0.05 ? 'drift-bad' : 'drift-ok');
    }
  }
}

function updateDriveCommandCard(vx, vy, wz) {
  const ex = document.getElementById('cmdVx');
  const ey = document.getElementById('cmdVy');
  const ew = document.getElementById('cmdWz');
  if (ex) ex.textContent = `${vx.toFixed(2)} m/s`;
  if (ey) ey.textContent = `${vy.toFixed(2)} m/s`;
  if (ew) ew.textContent = `${wz.toFixed(2)} rad/s`;
  const moving = Math.abs(vx) > 0.001 || Math.abs(vy) > 0.001 || Math.abs(wz) > 0.001;
  const ms = document.getElementById('motionState');
  if (ms) ms.textContent = moving ? (Math.abs(wz) > 0.02 && Math.hypot(vx, vy) < 0.01 ? 'ROTATING' : 'MOVING') : 'IDLE';
}

function setPill(id, state, text) {
  const el = document.getElementById(id);
  if (!el) return;
  el.className = 'state-pill ' + state;
  el.textContent = text;
}

function updateConnectionUI() {
  setPill('rosPill', wsOk ? 'good' : 'bad', wsOk ? 'ROS ●' : 'ROS ×');
  setPill('mapPill', (wsOk && mapGrid) ? 'good' : 'muted', mapGrid ? 'MAP ●' : 'MAP —');
  // POSE used to read green off `robotPose` alone, so a dropped socket left
  // the last coordinate on screen looking live -- and those numbers are what
  // the operator drives by. robotPose is deliberately NOT cleared (the trail
  // and the last known position are still worth seeing); the pill and the
  // card just stop claiming they are current.
  const fresh = wsOk && !!robotPose;
  setPill('posePill', fresh ? 'good' : 'muted',
          robotPose ? (fresh ? 'POSE ●' : 'POSE ⌛') : 'POSE —');
  document.querySelectorAll('.info-card, .map-hud')
          .forEach(el => el.classList.toggle('stale', !!robotPose && !wsOk));
}

function syncLayerPanel() {
  for (const [k, v] of Object.entries(mapLayers)) {
    const el = document.getElementById('layer-' + k);
    if (el) el.checked = v;
  }
  const research = document.getElementById('researchToggle');
  if (research) research.checked = mapResearchMode;
}

function openLayers() {
  const p = document.getElementById('layerPanel');
  if (p) p.classList.toggle('show');
}

// ── NAV2 (nav2_slam.launch.py, managed by the server) ─────────────
// The button and the pose box only ever show what the server last said
// (the 'nav' payload, 2 Hz). Tapping sends a request; the state changes
// when the server reports it, never optimistically here, so a refused
// start (MAP not running, map too young) cannot leave the button lying.
let navLast = null;   // {state, note, log, for_s, goal}
const NAV_BTN = {
  off:      ['NAV2',   ''],
  starting: ['NAV2 …', 'armed'],
  up:       ['NAV2 ●', 'nav-up'],
  stopping: ['STOP …', 'armed'],
  failed:   ['NAV2 ✕', 'nav-bad'],
  external: ['NAV2 ⓘ', 'nav-up'],
};
const NAV_WORDS = {
  starting: 'STARTING', up: 'UP', stopping: 'STOPPING',
  failed: 'FAILED', external: 'UP (terminal)',
};

function navRender(m) {
  navLast = m;
  const b = document.getElementById('btnNav2');
  if (b) {
    const st = NAV_BTN[m.state] || NAV_BTN.off;
    b.textContent = st[0];
    b.classList.remove('armed', 'nav-up', 'nav-bad');
    if (st[1]) b.classList.add(st[1]);
  }
  updateHud();
}

function navTap() {
  if (estopped) { goalHint('E-STOP ACTIVE · CLEAR FIRST', true); return; }
  const st = navLast ? navLast.state : 'off';
  if (st === 'off' || st === 'failed') {
    send({ type: 'nav2_start' });
    goalHint('NAV2 REQUESTED · WATCH THE POSE BOX', false);
  } else if (st === 'starting' || st === 'up') {
    send({ type: 'nav2_stop' });
    goalHint('NAV2 STOPPING · ANY GOAL IS CANCELLED', false);
  } else if (st === 'external') {
    goalHint('NAV2 WAS STARTED IN A TERMINAL · STOP IT THERE', true);
  }
}

// Nav rows for the pose box. Empty while Nav2 is off and no goal has run,
// so the box is no bigger than it was before this existed.
function navStateText() {
  if (!navLast || navLast.state === 'off') return '';
  let st = NAV_WORDS[navLast.state] || String(navLast.state).toUpperCase();
  if (navLast.state === 'starting' && navLast.for_s != null) st += ' ' + Number(navLast.for_s).toFixed(0) + ' s';
  return st;
}
function navGoalBits(g) {
  const dist = (g.dist == null) ? '-' : Number(g.dist).toFixed(2) + ' m';
  const secs = Number(g.elapsed ?? 0).toFixed(0) + ' s';
  return { status: g.status, dist: dist, secs: secs,
           cls: g.status === 'SUCCEEDED' ? 'drift-ok' : (g.status === 'ABORTED' ? 'drift-bad' : '') };
}
function navHudBlock() {
  if (!navLast) return '';
  const st = navStateText();
  const g = navLast.goal;
  if (!st && !g) return '';
  let rows = '';
  if (st) {
    const sCls = navLast.state === 'failed' ? 'drift-bad'
               : (navLast.state === 'up' || navLast.state === 'external') ? 'drift-ok' : '';
    rows += `<span>NAV2</span><strong class="${sCls}">${st}</strong>`;
  }
  if (g) {
    const b = navGoalBits(g);
    rows += `<span>GOAL</span><strong class="${b.cls}">${b.status}</strong>`
          + `<span>TO GO</span><strong>${b.dist}</strong>`
          + `<span>TIME</span><strong>${b.secs}</strong>`;
  }
  let foot = '';
  if (g) foot += '<div class="hud-muted">TO GO = straight line to the end of /plan</div>';
  if (navLast.state === 'failed' && navLast.log) foot += `<div class="hud-muted">log: ${navLast.log}</div>`;
  return `<div class="hud-sep"></div><div class="hud-grid">${rows}</div>${foot}`;
}
function navHudMini() {
  if (!navLast) return '';
  const st = navStateText();
  const g = navLast.goal;
  if (!st && !g) return '';
  let line = st ? 'NAV2 ' + st : 'NAV2 OFF';
  if (g) { const b = navGoalBits(g); line += ` · ${b.status} ${b.dist} · ${b.secs}`; }
  return `<div class="hud-mini">${line}</div>`;
}

// Pose box fold. Remembered per browser; storage can be missing or
// blocked (private window), so every access is guarded and the box simply
// starts unfolded if it is.
let hudMin = false;
try { hudMin = localStorage.getItem('hudMin') === '1'; } catch (e) { hudMin = false; }
function hudToggle() {
  hudMin = !hudMin;
  try { localStorage.setItem('hudMin', hudMin ? '1' : '0'); } catch (e) {}
  updateHud();
}

// ── MAP STATE ─────────────────────────────────────────────────────
// base_link is standard REP-103 (since 5 Oct 2026): +X is the NOSE, +Y is
// LEFT. nav2_params.yaml's footprint polygon
//   [[0.56, 0.24], [0.56, -0.24], [-0.56, -0.24], [-0.56, 0.24]]
// has the 0.56 (half the LENGTH) on X and the 0.24 (half the WIDTH) on Y.
// Getting this backwards draws the robot sideways in its own aisle.
const FOOT_HALF_X = 0.56;   // half length (tail..nose)
const FOOT_HALF_Y = 0.24;   // half width  (right..left)

let mapView    = false;
let mapGrid    = null;   // {w,h,res,ox,oy}
let mapBitmap  = null;   // offscreen canvas holding the rendered cells
let robotPose  = null;   // {x,y,yaw} in the map frame
let camX = 0, camY = 0, camScale = 55;   // camScale = screen px per metre
let mapFollow  = true;
let goalArmed  = false;
let goalDrag   = null;   // {wx,wy,yaw} while placing a goal
const ptrs     = new Map();
let pinchBase  = null;
let zeroArmed  = false;
let zeroTimer  = null;
let noticeTimer = null;

// ── WEBSOCKET ─────────────────────────────────────────────────────
function connect() {
  const url = 'ws://' + location.host + '/ws';
  ws = new WebSocket(url);
  ws.onopen = () => {
    wsOk = true;
    document.getElementById('dot').classList.add('on');
    updateConnectionUI();
    // Auto-enable the arm on connect so no manual ENABLE button is needed --
    // BUT NEVER BEHIND A LATCHED E-STOP. This used to send ENABLE
    // unconditionally, so a Wi-Fi blip while the operator had the robot
    // E-STOPped re-armed it with nobody touching anything, and the button
    // still read CLEAR / TAP TO RESUME. Re-assert the stop instead: if the
    // drive stack restarted during the outage its own latch is gone, so
    // re-sending is strictly safer than assuming it held.
    if (estopped) send({ type: 'estop' });
    else          send({ type: 'arm', cmd: 'ENABLE' });
  };
  ws.onmessage = (ev) => {
    let m;
    try { m = JSON.parse(ev.data); } catch (e) { return; }
    if (m.type === 'notice') {
      goalHint(m.text, /FIRST|CANNOT/.test(m.text));
      clearTimeout(noticeTimer);
      noticeTimer = setTimeout(() => goalHint(defaultHint(), false), 4000);
    } else if (m.type === 'pose') {
      applyPose(m);
    } else if (m.type === 'scan') {
      liveScan = m;
      scanStamp = performance.now();
      if (mapView && mapLayers.scan) drawMap();
    } else if (m.type === 'map') {
      ingestMap(m);
      if (mapView) drawMap();
      updateConnectionUI();
    } else if (m.type === 'nav') {
      navRender(m);
    }
  };
  ws.onclose = () => {
    wsOk = false;
    document.getElementById('dot').classList.remove('on');
    updateConnectionUI();
    setTimeout(connect, 1500);
  };
  ws.onerror = () => ws.close();
}
connect();

// Returns TRUE only if the command actually reached the socket. This used to
// be `if (wsOk) ws.send(...)` with no return and no notice, so a GOAL or an
// E-STOP tapped while the socket was down vanished silently and the UI went
// on to report success. A control surface that swallows an E-STOP and then
// says "TAP TO RESUME" is lying about the state of a 45 kg robot.
//
// wsOk alone is not enough: it is set in onopen and cleared in onclose, which
// leaves a window in CLOSING where ws.send() throws. Check readyState too.
//
// quiet=true is for the 20 Hz drive loop, which must not spam the hint line.
// A dropped socket there is already covered three ways: the ROS pill, the
// velocity_smoother's 1.0 s velocity_timeout, and esp32_bridge's own 500 ms
// watchdog, which stops the wheels when commands stop arriving (§17.14).
function send(obj, quiet) {
  if (wsOk && ws && ws.readyState === WebSocket.OPEN) {
    try { ws.send(JSON.stringify(obj)); return true; } catch (e) { /* fall through */ }
  }
  wsOk = false;
  updateConnectionUI();
  if (!quiet) goalHint('NOT CONNECTED — COMMAND NOT SENT', true);
  return false;
}

// ── SPEED MODE ────────────────────────────────────────────────────
// FIX: Speed buttons now use touchstart event listeners instead of onclick.
// onclick has a 300ms delay on mobile and fails entirely when touch-action:none
// is set globally. touchstart fires instantly and reliably.
function setSpeed(idx) {
  speedIdx = idx;
  for (let i = 0; i < 3; i++) {
    const btn = document.getElementById('spd' + i);
    SPD_ACTIVE.forEach(c => btn.classList.remove(c));
    if (i === idx) btn.classList.add(SPD_ACTIVE[i]);
  }
  document.getElementById('spdValue').textContent = SPD_LABELS[idx];
}

// Attach touchstart (not onclick) to speed buttons — phone behavior unchanged
[0, 1, 2].forEach(i => {
  const btn = document.getElementById('spd' + i);
  btn.addEventListener('touchstart', e => {
    e.preventDefault();
    e.stopPropagation();
    setSpeed(i);
  }, { passive: false });
  // Desktop: plain click. Browsers suppress the synthetic click that would
  // follow a touchstart once preventDefault() has fired, so this never
  // double-fires on the phone — it only fires for real mouse clicks.
  btn.addEventListener('click', () => setSpeed(i));
});

// ── JOYSTICK ──────────────────────────────────────────────────────
const joyArea  = document.getElementById('joyArea');
const joyRing  = document.getElementById('joyRing');
const joyThumb = document.getElementById('joyThumb');

function getJoyOffset(touch) {
  const r   = joyRing.getBoundingClientRect();
  const cx  = r.left + r.width  / 2;
  const cy  = r.top  + r.height / 2;
  const max = r.width / 2 - 32;
  let dx = touch.clientX - cx;
  let dy = touch.clientY - cy;
  const dist = Math.hypot(dx, dy);
  if (dist > max) { const s = max / dist; dx *= s; dy *= s; }
  return { dx, dy, nx: dx / max, ny: -dy / max };
}

joyArea.addEventListener('touchstart', e => {
  e.preventDefault();
  // #mapView is a CHILD of #joyArea, so every touch on the map canvas
  // bubbles here. z-index makes the map cover the joystick visually; it
  // does NOT stop event propagation. Without this guard, panning the map
  // drove the robot — confirmed on phone and desktop. The map handlers
  // also stopPropagation(); this is the second line of defence, and the
  // one that cannot be defeated by event-ordering quirks between
  // pointer* and touch* on a given browser.
  if (mapView) return;
  if (joyActive) return;
  const t = e.changedTouches[0];
  joyTouchId = t.identifier;
  joyActive  = true;
  joyThumb.classList.add('active');
  const p = getJoyOffset(t);
  joyX = p.nx; joyY = p.ny;
  joyThumb.style.transform = `translate(calc(-50% + ${p.dx}px), calc(-50% + ${p.dy}px))`;
}, { passive: false });

joyArea.addEventListener('touchmove', e => {
  e.preventDefault();
  if (mapView) return;
  for (const t of e.changedTouches) {
    if (t.identifier !== joyTouchId) continue;
    const p = getJoyOffset(t);
    joyX = p.nx; joyY = p.ny;
    joyThumb.style.transform = `translate(calc(-50% + ${p.dx}px), calc(-50% + ${p.dy}px))`;
  }
}, { passive: false });

joyArea.addEventListener('touchend', e => {
  for (const t of e.changedTouches) {
    if (t.identifier !== joyTouchId) continue;
    joyActive = false; joyTouchId = null;
    joyX = 0; joyY = 0;
    joyThumb.classList.remove('active');
    joyThumb.style.transform = 'translate(-50%, -50%)';
    sendDrive();
  }
}, { passive: false });

// Desktop: mousedown starts the drag. 'mouse' is a sentinel id that can
// never collide with a real touch.identifier (always numeric), so we can
// safely reuse joyActive/joyTouchId from the touch code above unchanged.
joyArea.addEventListener('mousedown', e => {
  if (mapView) return;          // see the touchstart guard above
  if (joyActive) return;
  joyTouchId = 'mouse';
  joyActive  = true;
  joyThumb.classList.add('active');
  const p = getJoyOffset(e);
  joyX = p.nx; joyY = p.ny;
  joyThumb.style.transform = `translate(calc(-50% + ${p.dx}px), calc(-50% + ${p.dy}px))`;
});

// ── YAW SLIDER ────────────────────────────────────────────────────
const yawTrack = document.getElementById('yawTrack');
const yawThumb = document.getElementById('yawThumb');

yawTrack.addEventListener('touchstart', e => {
  e.preventDefault();
  if (yawActive) return;
  yawActive   = true;
  yawTouchId  = e.changedTouches[0].identifier;
  updateYaw(e.changedTouches[0]);
}, { passive: false });

yawTrack.addEventListener('touchmove', e => {
  e.preventDefault();
  for (const t of e.changedTouches) {
    if (t.identifier === yawTouchId) updateYaw(t);
  }
}, { passive: false });

yawTrack.addEventListener('touchend', e => {
  for (const t of e.changedTouches) {
    if (t.identifier !== yawTouchId) continue;
    yawActive = false; yawTouchId = null; yawVal = 0;
    yawThumb.style.top = '50%';
    sendDrive();
  }
}, { passive: false });

// Desktop: mousedown starts the drag (same 'mouse' sentinel pattern as joystick)
yawTrack.addEventListener('mousedown', e => {
  if (yawActive) return;
  yawActive  = true;
  yawTouchId = 'mouse';
  updateYaw(e);
});

// ── MOUSE DRAG (desktop) — shared move/release for joystick + yaw ───
// Bound on document, not the element, so dragging past the edge of the
// joystick ring or yaw track (very normal with a mouse) still tracks.
document.addEventListener('mousemove', e => {
  if (joyTouchId === 'mouse' && joyActive) {
    const p = getJoyOffset(e);
    joyX = p.nx; joyY = p.ny;
    joyThumb.style.transform = `translate(calc(-50% + ${p.dx}px), calc(-50% + ${p.dy}px))`;
  }
  if (yawTouchId === 'mouse' && yawActive) {
    updateYaw(e);
  }
});

document.addEventListener('mouseup', () => {
  if (joyTouchId === 'mouse') {
    joyActive = false; joyTouchId = null;
    joyX = 0; joyY = 0;
    joyThumb.classList.remove('active');
    joyThumb.style.transform = 'translate(-50%, -50%)';
    sendDrive();
  }
  if (yawTouchId === 'mouse') {
    yawActive = false; yawTouchId = null; yawVal = 0;
    yawThumb.style.top = '50%';
    sendDrive();
  }
});

function updateYaw(touch) {
  const r   = yawTrack.getBoundingClientRect();
  const pct = Math.max(0, Math.min(1, (touch.clientY - r.top) / r.height));
  yawThumb.style.top = (pct * 100) + '%';
  yawVal = -(pct - 0.5) * 2;
}

// ── DRIVE SEND LOOP (20 Hz) ──────────────────────────────────────
function applyDead(v) { return Math.abs(v) < DEADZONE ? 0 : v; }

function sendDrive() {
  const m  = SPEEDS[speedIdx];
  const vx = applyDead(joyY)   * m * MAX_LINEAR;
  const vy = applyDead(-joyX)  * m * MAX_LINEAR;
  const wz = applyDead(yawVal) * m * MAX_ANGULAR;
  updateDriveCommandCard(vx, vy, wz);
  // quiet: this fires at 20 Hz; a dead socket is reported by the ROS pill,
  // not by 20 hint updates a second. See send().
  send({ type: 'drive', vx: +vx.toFixed(3), vy: +vy.toFixed(3), wz: +wz.toFixed(3) }, true);
}

setInterval(() => {
  if ((joyActive || yawActive || kbDriveActive || kbYawActive) && !estopped) sendDrive();
}, 50);

// ── ARM BUTTONS (hold to move, release stops) ─────────────────────
function armHold(cmd) {
  send({ type: 'arm', cmd });
}

function armRelease() {
  send({ type: 'arm', cmd: 'STOP' });
}

function bindHold(id, cmd) {
  const btn = document.getElementById(id);

  const start = () => {
    btn.classList.add('held');
    armHold(cmd);
    if (armInterval) clearInterval(armInterval);
    armInterval = setInterval(() => armHold(cmd), 200);
  };
  const stop = () => {
    btn.classList.remove('held');
    if (armInterval) { clearInterval(armInterval); armInterval = null; }
    armRelease();
  };

  btn.addEventListener('touchstart', e => { e.preventDefault(); start(); }, { passive: false });
  btn.addEventListener('touchend',    stop, { passive: false });
  btn.addEventListener('touchcancel', stop, { passive: false });

  // Desktop: mousedown/mouseup do the same hold-while-pressed job.
  // mouseleave covers dragging the cursor off the button while still held
  // down, which has no touch equivalent (touchcancel handles that case
  // on phones) but is a real thing with a mouse.
  btn.addEventListener('mousedown', start);
  btn.addEventListener('mouseup',   stop);
  btn.addEventListener('mouseleave', stop);
}

bindHold('btnOpen',  'OPEN');
bindHold('btnClose', 'CLOSE');
bindHold('btnUp',    'LIFT');
bindHold('btnDown',  'LOWER');

// ── MAP (mapping_full.launch.py + recording, together) ────────────
// One button: starts the lidar+relay+slam_toolbox launch tree and PID/
// telemetry recording as a single action, stops both together. Every
// mapping run is recorded by default — there's no separate record toggle.
// Placeholder slot for a future "Autonomous Drive" button once SLAM is
// trusted; this is trigger-only, no autonomy behavior here.
function mapReset() {
  mapping = false;
  document.getElementById('mapBtn').classList.remove('mapping');
  document.getElementById('mapIcon').textContent  = '▦';
  document.getElementById('mapLabel').textContent = 'MAP';
  document.getElementById('mapBadge').classList.remove('show');
  calSyncEnabled();
}

function toggleMapping() {
  if (estopped) return;
  if (mapping) {
    send({ type: 'map_stop' });
    mapReset();
  } else {
    mapping = true;
    // A new mapping session re-anchors the map frame, so the old trail is
    // no longer in the same coordinates as the new one. Close it off.
    startNewTrail();
    send({ type: 'map_start' });
    document.getElementById('mapBtn').classList.add('mapping');
    document.getElementById('mapIcon').textContent  = '⏹';
    document.getElementById('mapLabel').textContent = 'STOP MAP';
    document.getElementById('mapBadge').classList.add('show');
  }
  calSyncEnabled();
}

const mapBtnEl = document.getElementById('mapBtn');
mapBtnEl.addEventListener('touchstart', e => { e.preventDefault(); toggleMapping(); }, { passive: false });
mapBtnEl.addEventListener('click', toggleMapping);

// ── CALIBRATE (tools/zero_point_scan.py) ──────────────────────────
// The first control here that makes the robot drive itself, so it is the
// only one with a two-tap arm: tap once to arm (4 s window), tap again to
// commit. A single stray tap on a phone in a pocket cannot start it.
let calArmed = false, calRunning = false, calArmTimer = null, calPoll = null;

function calSetLabel(t) { document.getElementById('calLabel').textContent = t; }

function calDisarm() {
  calArmed = false;
  clearTimeout(calArmTimer);
  document.getElementById('calBtn').classList.remove('armed');
  if (!calRunning) calSetLabel('CALIBRATE');
}

function calReset() {
  calRunning = false;
  calDisarm();
  clearInterval(calPoll); calPoll = null;
  const b = document.getElementById('calBtn');
  b.classList.remove('running');
  document.getElementById('calIcon').textContent = '⟳';
  calSetLabel('CALIBRATE');
  document.getElementById('calStatus').classList.remove('show');
  calSyncEnabled();
}

// Enabled only while mapping is live — zero_point_scan.py measures map
// growth, so without /map it has nothing to decide on. The server enforces
// this too (calib_preflight); this just stops the tap being offered.
function calSyncEnabled() {
  const b = document.getElementById('calBtn');
  if (mapping || calRunning) b.classList.remove('disabled');
  else { b.classList.add('disabled'); calDisarm(); }
}

function calPollStatus() {
  fetch('/calib_status').then(r => r.json()).then(s => {
    document.getElementById('calHd').textContent =
      'CALIBRATING — ' + (s.state || '').toUpperCase();
    document.getElementById('calTail').innerHTML =
      (s.tail || []).map(l => l.replace(/[<>&]/g, '')).join('<br>');
    if (!s.active) {
      document.getElementById('calHd').textContent =
        'CALIBRATION ' + (s.state || '').toUpperCase();
      setTimeout(calReset, 4000);
      clearInterval(calPoll); calPoll = null;
    }
  }).catch(() => {});
}

function calTap() {
  if (estopped) return;
  if (calRunning) { send({ type: 'calib_stop' }); calSetLabel('RETURNING…'); return; }
  if (!mapping) return;
  if (!calArmed) {
    calArmed = true;
    document.getElementById('calBtn').classList.add('armed');
    calSetLabel('TAP AGAIN');
    calArmTimer = setTimeout(calDisarm, 4000);
    return;
  }
  calDisarm();
  calRunning = true;
  send({ type: 'calib_start' });
  const b = document.getElementById('calBtn');
  b.classList.add('running');
  document.getElementById('calIcon').textContent = '⏹';
  calSetLabel('STOP CAL');
  document.getElementById('calStatus').classList.add('show');
  document.getElementById('calHd').textContent = 'CALIBRATING — STARTING';
  document.getElementById('calTail').textContent = '';
  clearInterval(calPoll);
  calPoll = setInterval(calPollStatus, 1500);
  setTimeout(calPollStatus, 700);
}

const calBtnEl = document.getElementById('calBtn');
calBtnEl.addEventListener('touchstart', e => { e.preventDefault(); calTap(); }, { passive: false });
calBtnEl.addEventListener('click', calTap);

// Recover button state on load. Both MAP and CALIBRATE previously tracked
// their state only in this page's memory, so a refresh — or reopening the
// dashboard on a second device — showed "MAP" while mapping was actually
// running, and left CALIBRATE greyed out with no way to enable it short of
// stopping and restarting a healthy mapping session.
function syncFromServer() {
  fetch('/calib_status').then(r => r.json()).then(s => {
    if (s.mapping && !mapping) {
      mapping = true;
      document.getElementById('mapBtn').classList.add('mapping');
      document.getElementById('mapIcon').textContent  = '⏹';
      document.getElementById('mapLabel').textContent = 'STOP MAP';
      document.getElementById('mapBadge').classList.add('show');
    }
    if (s.active && !calRunning) {
      calRunning = true;
      document.getElementById('calBtn').classList.add('running');
      document.getElementById('calIcon').textContent = '⏹';
      calSetLabel('STOP CAL');
      document.getElementById('calStatus').classList.add('show');
      clearInterval(calPoll);
      calPoll = setInterval(calPollStatus, 1500);
    }
    calSyncEnabled();
  }).catch(() => {});
}
syncFromServer();

// ── UV LIGHTS (staged on the Mega: T1, +5s T2, +10s T3) ──────────
let uvOn = false;
let uvTimers = [];

function uvClearTimers() { uvTimers.forEach(t => clearTimeout(t)); uvTimers = []; }
function uvLabel(txt)    { document.getElementById('uvLabel').textContent = txt; }

function uvReset() {
  uvClearTimers();
  uvOn = false;
  document.getElementById('uvBtn').classList.remove('on');
  uvLabel('UV LIGHTS');
}

function toggleUv() {
  if (estopped) return;                       // no UV while latched
  uvOn = !uvOn;
  if (uvOn) {
    send({ type: 'uv', cmd: 'on' });
    document.getElementById('uvBtn').classList.add('on');
    // Cosmetic mirror of the firmware staircase — real timing lives on the Mega.
    uvLabel('TUBE 1');
    uvTimers.push(setTimeout(() => uvLabel('TUBE 1\u00b72'), 5000));
    uvTimers.push(setTimeout(() => uvLabel('ALL ON'),       10000));
  } else {
    send({ type: 'uv', cmd: 'off' });
    uvReset();
  }
}

const uvBtnEl = document.getElementById('uvBtn');
uvBtnEl.addEventListener('touchstart', e => { e.preventDefault(); toggleUv(); }, { passive: false });
uvBtnEl.addEventListener('click', toggleUv);

// ── E-STOP ────────────────────────────────────────────────────────
const estopBtn    = document.getElementById('estopBtn');
const estopCircle = document.getElementById('estopCircle');
const estopLbl    = document.getElementById('estopLbl');
const flash       = document.getElementById('flash');

function toggleEstop() {
  if (!estopped) {
    // Latch locally FIRST, unconditionally, then try to send. If the socket
    // is down the stop did not reach the robot, and the operator has to know
    // that rather than read TAP TO RESUME on a robot that is still driving.
    // The latch still sets, so the reconnect handler re-asserts it the
    // moment the socket returns.
    estopped = true;
    const stopSent = send({ type: 'estop' });
    uvReset();                       // firmware drops UV on <S>; mirror it here
    calReset();                      // server already SIGKILLed it; clear the UI
    joyX = 0; joyY = 0; yawVal = 0;
    joyActive = false; yawActive = false;
    joyThumb.style.transform = 'translate(-50%,-50%)';
    yawThumb.style.top = '50%';
    if (mapping) { send({ type: 'map_stop' }); mapReset(); }
    estopBtn.classList.add('armed');
    estopCircle.textContent = 'CLEAR';
    estopLbl.textContent    = stopSent ? 'TAP TO RESUME' : 'NOT SENT ×';
    if (!stopSent) goalHint('E-STOP NOT DELIVERED — NO LINK TO ROBOT', true);
    flash.classList.add('show');
    setTimeout(() => flash.classList.remove('show'), 400);
  } else {
    estopped = false;
    send({ type: 'estop_clear' });
    estopBtn.classList.remove('armed');
    estopCircle.textContent = 'E-STOP';
    estopLbl.textContent    = 'TAP TO STOP';
    // FIX: Re-enable arm after clear (ESP32 ESTOP latches, <E1> un-latches)
    send({ type: 'arm', cmd: 'ENABLE' });
  }
}

estopBtn.addEventListener('touchstart', e => {
  e.preventDefault();
  e.stopPropagation();
  toggleEstop();
}, { passive: false });
estopBtn.addEventListener('click', toggleEstop);

// ── KEYBOARD (desktop) ───────────────────────────────────────────
// Not shown anywhere in the UI on purpose. W/A/S/D drive the joystick,
// Q/E are yaw, R toggles record. Keyboard yields to an active mouse/touch
// drag on the same control rather than fighting it. UV lights stay
// click/tap-only — no keyboard shortcut for that on purpose.
const keysDown = new Set();
let kbDriveActive = false, kbYawActive = false;

function kbApplyDrive() {
  let kx = 0, ky = 0;
  if (keysDown.has('w')) ky += 1;
  if (keysDown.has('s')) ky -= 1;
  if (keysDown.has('a')) kx -= 1;
  if (keysDown.has('d')) kx += 1;
  const mag = Math.hypot(kx, ky);
  if (mag > 1) { kx /= mag; ky /= mag; }
  kbDriveActive = (kx !== 0 || ky !== 0);
  if (joyActive) return;          // a real drag on the joystick wins
  joyX = kx; joyY = ky;
  const r   = joyRing.getBoundingClientRect();
  const max = r.width / 2 - 32;
  joyThumb.style.transform = kbDriveActive
    ? `translate(calc(-50% + ${kx * max}px), calc(-50% + ${-ky * max}px))`
    : 'translate(-50%, -50%)';
  joyThumb.classList.toggle('active', kbDriveActive);
}

function kbApplyYaw() {
  let kz = 0;
  if (keysDown.has('q')) kz += 1;   // CCW
  if (keysDown.has('e')) kz -= 1;   // CW
  kbYawActive = (kz !== 0);
  if (yawActive) return;            // a real drag on the slider wins
  yawVal = kz;
  yawThumb.style.top = (50 - kz * 50) + '%';
}

window.addEventListener('keydown', e => {
  if (e.target.tagName === 'INPUT' || e.target.tagName === 'TEXTAREA') return;
  if (e.ctrlKey || e.metaKey || e.altKey) return;
  const k = e.key.toLowerCase();
  if (k === 'm') {
    if (!e.repeat) toggleMapping();
    e.preventDefault();
    return;
  }
  if (!'wasdqe'.includes(k)) return;
  e.preventDefault();
  keysDown.add(k);
  kbApplyDrive();
  kbApplyYaw();
  sendDrive();
});

window.addEventListener('keyup', e => {
  const k = e.key.toLowerCase();
  if (!'wasdqe'.includes(k)) return;
  keysDown.delete(k);
  kbApplyDrive();
  kbApplyYaw();
  sendDrive();
});

// Don't leave a key "stuck" if the window loses focus mid-press
window.addEventListener('blur', () => {
  if (keysDown.size === 0) return;
  keysDown.clear();
  kbApplyDrive();
  kbApplyYaw();
  sendDrive();
});
// ═══════════════════════════════════════════════════════════════════
//  MAP VIEW  (§17.32 — replaces Foxglove for seeing the map + pose)
// ═══════════════════════════════════════════════════════════════════

const mapCanvas = document.getElementById('mapCanvas');
const mctx      = mapCanvas.getContext('2d');
let   cssW = 0, cssH = 0, dpr = window.devicePixelRatio || 1;

function sizeCanvas() {
  const r = mapCanvas.getBoundingClientRect();
  if (!r.width || !r.height) return;
  dpr = window.devicePixelRatio || 1;
  cssW = r.width; cssH = r.height;
  mapCanvas.width  = Math.round(cssW * dpr);
  mapCanvas.height = Math.round(cssH * dpr);
  // Transform reset ONLY (no rotation here) -- drawMap() re-applies the
  // rotated transform every frame from this same baseline, since setTransform
  // replaces the matrix outright rather than composing with what came before.
  mctx.setTransform(dpr, 0, 0, dpr, 0, 0);
}
window.addEventListener('resize', () => { sizeCanvas(); if (mapView) drawMap(); });

// THE RESIZE EVENT IS NOT ENOUGH, and the gap is a real click-accuracy bug.
// sizeCanvas() caches cssW/cssH, and s2w()/w2s() work off that cache while
// the pointer handler reads a LIVE getBoundingClientRect() for r.left. The
// canvas backing store is cssW*dpr px, which the browser then rescales to
// the element's real CSS width -- so when the two disagree the marker lands
// at sx * (r.width / cssW): zero error at the left edge, growing to the
// right. That is the "goal marker sits right of my mouse" report.
//
// Two ways the cache goes stale with no resize event: the handler above
// bails out via `if (!r.width || !r.height) return` every time the map view
// is hidden (display:none => a 0x0 rect), and a devicePixelRatio change from
// dragging the window to a monitor with different scaling does not reliably
// fire resize at all. A ResizeObserver watches the element itself and closes
// both. Guarded because it is absent on very old browsers, where the
// pointerdown check below still catches it.
if (window.ResizeObserver) {
  new ResizeObserver(() => { sizeCanvas(); if (mapView) drawMap(); })
    .observe(mapCanvas);
}

// ── Map-frame display orientation ────────────────────────────────────────
// The map frame is standard REP-103: +X is where the nose pointed when odometry
// was zeroed, +Y is to its left, yaw is counter-clockwise from +X.
//
// The canvas is spun -90 deg (DISPLAY_ROT = -PI/2) so that the nose points UP
// the screen, which is how this map has always been read. World +X draws
// screen-up and world +Y draws screen-left. That is the ONLY presentation
// choice in this file: every printed number is the raw map frame, and every
// pointer is un-rotated before it becomes a world coordinate (unrotatePtr /
// unrotateDelta), so a tap and a drag land where they look.
//
// History, because the temptation to patch the display again is exactly what
// this comment is for. Until 5 Oct 2026 the whole stack used a private frame
// (+X right, +Y forward, §17.10/§17.38) and this value was 0. Before §17.38 it
// was -90 over a frame that was genuinely rotated, and every printed number
// was relabeled to hide it. If the printed X/Y ever looks wrong, do not fix it
// here: a display patch would hide a real frame fault for a third time. Read
// docs/Axis_Convention.md, then check odometry_publisher.py.
//
// drawUpright() and the labelXGridline()/labelYGridline() helpers below are
// what makes text land upright and in the right place on a rotated canvas.
// Zeroing the rotation to "fix" garbled labels is how the display once drifted
// from the frame; leave them alone.
const DISPLAY_ROT = -Math.PI / 2;

// ── THE ROBOT'S YAW CONVENTION, IN ONE PLACE ────────────────────────────
// Yaw is the standard REP-103 angle: measured from +X (the NOSE), counter-
// clockwise positive. So the direction <-> yaw conversion is plain atan2 and
// cos/sin, with no 90 deg term anywhere. (Until 5 Oct 2026 yaw was measured
// from +Y and this pair carried a 90 deg offset; that was how §17.49 happened,
// the nose drawn one way and the goal arrow another.)
//
// Route EVERY vector<->yaw conversion through these two. They are exact
// inverses, so the renderers and the command path cannot drift apart. Do NOT
// add a compensating offset anywhere else -- least of all in goal_pose_adapter,
// whose yaw_offset_deg is 0.0 and must stay 0.0.
function vecToYaw(dx, dy) { return Math.atan2(dy, dx); }
function yawToVec(yaw)    { return { x: Math.cos(yaw), y: Math.sin(yaw) }; }

// Draws text upright in real screen space at the real-screen point that
// local point (localX, localY) maps to under DISPLAY_ROT -- use this for
// any fillText() call made while the map canvas is in its rotated state.
function drawUpright(text, localX, localY, align, dxReal, dyReal) {
  const c = Math.cos(DISPLAY_ROT), s = Math.sin(DISPLAY_ROT);
  const dx = localX - cssW / 2, dy = localY - cssH / 2;
  const realX = cssW / 2 + (dx * c - dy * s) + (dxReal || 0);
  const realY = cssH / 2 + (dx * s + dy * c) + (dyReal || 0);
  mctx.save();
  mctx.setTransform(dpr, 0, 0, dpr, 0, 0);
  mctx.textAlign = align || 'left';
  mctx.fillText(text, realX, realY);
  mctx.restore();
}

function w2s(wx, wy) {
  return { x: cssW / 2 + (wx - camX) * camScale,
           y: cssH / 2 - (wy - camY) * camScale };   // canvas y grows DOWN
}
function s2w(sx, sy) {
  return { x: camX + (sx - cssW / 2) / camScale,
           y: camY - (sy - cssH / 2) / camScale };
}
// Raw pointer coords (canvas-relative) -> the local space w2s/s2w assume.
// Undoes DISPLAY_ROT around the canvas centre. Rotation is linear, so the
// same formula applied to a DELTA (no centre offset) undoes it for that too
// -- used for pan-dragging, where only the difference between two points
// matters.
function unrotatePtr(sx, sy) {
  const dx = sx - cssW / 2, dy = sy - cssH / 2;
  const c = Math.cos(DISPLAY_ROT), s = Math.sin(DISPLAY_ROT);
  // Apply the inverse canvas rotation to recover local map coordinates.
  return {
    x: cssW / 2 + c * dx + s * dy,
    y: cssH / 2 - s * dx + c * dy,
  };
}
function unrotateDelta(dx, dy) {
  const c = Math.cos(DISPLAY_ROT), s = Math.sin(DISPLAY_ROT);
  return { x: c * dx + s * dy, y: -s * dx + c * dy };
}

// ── Decode one OccupancyGrid into an offscreen bitmap ──────────────
function ingestMap(m) {
  const bin = atob(m.data);
  const n   = bin.length;
  mapGrid = { w: m.w, h: m.h, res: m.res, ox: m.ox, oy: m.oy };

  const img = new ImageData(m.w, m.h);
  const px  = img.data;
  for (let gy = 0; gy < m.h; gy++) {
    // OccupancyGrid row 0 is the LOWEST y; ImageData row 0 is the TOP.
    const irow = m.h - 1 - gy;
    for (let gx = 0; gx < m.w; gx++) {
      const v = bin.charCodeAt(gy * m.w + gx);   // int8 shipped raw: -1 -> 255
      const o = (irow * m.w + gx) * 4;
      let r, g, b;
      // Palette rule: luminance rises with occupancy probability, so the
      // map reads darkest-is-emptiest at a glance. UNKNOWN is deliberately
      // OFF-HUE (neutral slate, no blue) because it is not a low
      // probability of occupancy — it is the absence of a measurement, a
      // different kind of thing, and should not sit on the same ramp.
      //
      // The old palette put free at rgb(12,40,64) against unknown at
      // rgb(16,22,36): a WCAG contrast ratio of 1.20:1, which is why
      // drivable space and never-seen space looked identical on a phone in
      // daylight. Ratios now: free/unknown 3.8:1, occupied/free 3.6:1,
      // occupied/unknown 13.6:1.
      if (v === 255)     { r = 228; g = 231; b = 236; }   // unknown  - light neutral
      else if (v >= 65)  { r =  52; g =  64; b =  78; }   // occupied - dark structure
      else if (v <= 25)  { r = 248; g = 250; b = 252; }   // free     - clean floor
      else               { r = 152; g = 162; b = 176; }   // uncertain- between the two
      px[o] = r; px[o + 1] = g; px[o + 2] = b; px[o + 3] = 255;
    }
  }
  const off = document.createElement('canvas');
  off.width = m.w; off.height = m.h;
  off.getContext('2d').putImageData(img, 0, 0);
  mapBitmap = off;
}

// ── Draw ───────────────────────────────────────────────────────────
function drawMap() {
  if (!cssW || !cssH) { sizeCanvas(); if (!cssW) return; }

  // Paint the WHOLE canvas in real screen space first, THEN rotate. The
  // background used to be filled in the rotated frame, where the canvas
  // rectangle covers only a central square of a non-square screen: the rest
  // was never painted at all (transparent), so dark stripes showed down both
  // sides of a wide desktop (6 Oct 2026, first look on one).
  // tools/tests/dashboard_wide_render.py measures this.
  mctx.setTransform(dpr, 0, 0, dpr, 0, 0);
  mctx.fillStyle = '#f4f6f8';
  mctx.fillRect(0, 0, cssW, cssH);
  mctx.translate(cssW / 2, cssH / 2);
  mctx.rotate(DISPLAY_ROT);
  mctx.translate(-cssW / 2, -cssH / 2);

  if (mapBitmap && mapGrid) {
    const tl = w2s(mapGrid.ox, mapGrid.oy + mapGrid.h * mapGrid.res);
    mctx.imageSmoothingEnabled = false;
    mctx.drawImage(mapBitmap, tl.x, tl.y,
                   mapGrid.w * mapGrid.res * camScale,
                   mapGrid.h * mapGrid.res * camScale);
  }

  if (mapLayers.grid) drawGrid();
  if (mapLayers.axes) drawAxes();
  // Above the occupancy grid (it is the live truth the grid is built from)
  // but below every trail, goal and the footprint, which are commands and
  // history and must stay readable on top of it.
  if (mapLayers.scan) drawScan();
  // Past first, so the live trail always draws on top of the clutter.
  if (mapLayers.pastTrails) drawPastTrails();
  if (mapLayers.trajectory) drawTrajectory();

  // Zero mark is a coordinate reference, never a command.
  if (mapLayers.zero) drawZeroMark();

  if (mapLayers.goals) drawGoals();
  // The goal being placed right now is always drawn, toggle or not: it is
  // direct feedback on a gesture in progress, not a display layer.
  if (goalDrag) drawGoalMarker(goalDrag, true);
  if (mapLayers.footprint && robotPose) drawRobot(robotPose);

  updateHud();

  // Screen-fixed overlays: not rotated with the map.
  mctx.setTransform(dpr, 0, 0, dpr, 0, 0);
  if (mapLayers.scale) drawScaleBar();
  drawMapModeBadge();
}

function worldBounds() {
  const corners = [unrotatePtr(0, 0), unrotatePtr(cssW, 0),
                   unrotatePtr(0, cssH), unrotatePtr(cssW, cssH)];
  const lx = corners.map(c => c.x), ly = corners.map(c => c.y);
  const tl = s2w(Math.min(...lx), Math.min(...ly));
  const br = s2w(Math.max(...lx), Math.max(...ly));
  return { minX: tl.x, maxX: br.x, minY: br.y, maxY: tl.y };
}

function niceGridStep() {
  // Choose a physical interval that lands in a readable 70–150 px range.
  const targetPx = 105;
  const raw = targetPx / Math.max(camScale, 1);
  const powers = [0.1, 0.2, 0.5, 1, 2, 5, 10, 20, 50];
  let best = powers[powers.length - 1];
  let bestErr = Infinity;
  for (const p of powers) {
    const err = Math.abs(Math.log((p * camScale) / targetPx));
    if (err < bestErr) { bestErr = err; best = p; }
  }
  return best;
}

function formatMeters(v) {
  if (v >= 10) return `${v.toFixed(0)} m`;
  if (v >= 1) return `${v.toFixed(v % 1 === 0 ? 0 : 1)} m`;
  return `${v.toFixed(2)} m`;
}

function drawGrid() {
  if (camScale < 8) return;
  const b = worldBounds();
  const step = niceGridStep();
  const minor = step / 5;
  // Gridlines are drawn in the rotated frame, where the canvas rectangle is
  // only part of the screen on a non-square canvas. Run each line past both
  // ends by E so it crosses the whole screen; the canvas clips the excess.
  const E = Math.max(cssW, cssH);

  mctx.lineWidth = 1;
  mctx.font = '10px Inter, Arial, sans-serif';
  mctx.textBaseline = 'top';

  // Minor grid only when it remains visually useful.
  if (minor * camScale >= 18) {
    mctx.beginPath();
    mctx.strokeStyle = 'rgba(52, 73, 94, 0.10)';
    for (let x = Math.floor(b.minX / minor) * minor; x <= b.maxX + minor; x += minor) {
      const p = w2s(x, 0);
      mctx.moveTo(p.x, -E); mctx.lineTo(p.x, cssH + E);
    }
    for (let y = Math.floor(b.minY / minor) * minor; y <= b.maxY + minor; y += minor) {
      const p = w2s(0, y);
      mctx.moveTo(-E, p.y); mctx.lineTo(cssW + E, p.y);
    }
    mctx.stroke();
  }

  // Major grid.
  mctx.beginPath();
  mctx.strokeStyle = 'rgba(22, 119, 255, 0.20)';
  for (let x = Math.floor(b.minX / step) * step; x <= b.maxX + step; x += step) {
    const p = w2s(x, 0);
    mctx.moveTo(p.x, -E); mctx.lineTo(p.x, cssH + E);
  }
  for (let y = Math.floor(b.minY / step) * step; y <= b.maxY + step; y += step) {
    const p = w2s(0, y);
    mctx.moveTo(-E, p.y); mctx.lineTo(cssW + E, p.y);
  }
  mctx.stroke();

  // Coordinate labels on major gridlines. Map axes ARE display axes now
  // (§17.38), so a constant-world-X line is labelled "X <value>" and a
  // constant-world-Y line "Y <value>" -- no relabel, no sign flip.
  //
  // These are MARGIN labels (anchored to a screen EDGE, not to a world
  // point), so drawUpright()'s small-local-offset trick does not apply: a
  // small LOCAL offset is a large offset from the rotation centre on a
  // non-square viewport and lands the text somewhere else entirely. That
  // exact bug shipped and was fixed live on hardware 26 Aug. The helpers
  // below therefore clip each gridline in REAL screen space and pin the
  // label to where it actually leaves the canvas -- correct at DISPLAY_ROT
  // 0, and still correct if it is ever set non-zero again.
  mctx.fillStyle = '#3b4754';
  mctx.font = '10px Inter, Arial, sans-serif';
  for (let x = Math.ceil(b.minX / step) * step; x <= b.maxX; x += step) {
    labelXGridline(`X ${x.toFixed(x % 1 === 0 ? 0 : 1)}`, x);
  }
  for (let y = Math.ceil(b.minY / step) * step; y <= b.maxY; y += step) {
    labelYGridline(`Y ${y.toFixed(y % 1 === 0 ? 0 : 1)}`, y);
  }
}

// Real on-screen position of a local (pre-rotation) canvas point.
function localToReal(lx, ly) {
  const c = Math.cos(DISPLAY_ROT), s = Math.sin(DISPLAY_ROT);
  const dx = lx - cssW / 2, dy = ly - cssH / 2;
  return { x: cssW / 2 + (dx * c - dy * s),
           y: cssH / 2 + (dx * s + dy * c) };
}

// Clip the infinite line P + t*D to the canvas rect. Returns [tMin, tMax]
// or null when the line misses the canvas entirely.
function lineClipToCanvas(px, py, dx, dy) {
  let tMin = -Infinity, tMax = Infinity;
  const slabs = [[dx, -px, cssW - px], [dy, -py, cssH - py]];
  for (const [d, lo, hi] of slabs) {
    if (Math.abs(d) < 1e-9) { if (lo > 0 || hi < 0) return null; continue; }
    let a = lo / d, b2 = hi / d;
    if (a > b2) { const t = a; a = b2; b2 = t; }
    if (a > tMin) tMin = a;
    if (b2 < tMax) tMax = b2;
  }
  return tMin <= tMax ? [tMin, tMax] : null;
}

// Draws one margin label for a gridline, given a local anchor point on the
// line and the line's local direction. `preferBottom` picks which end of
// the visible span the label sits at.
function labelGridline(text, localAnchorX, localAnchorY, localDirX, localDirY,
                       preferBottom) {
  const c = Math.cos(DISPLAY_ROT), s = Math.sin(DISPLAY_ROT);
  const P = localToReal(localAnchorX, localAnchorY);
  const D = { x: localDirX * c - localDirY * s,
              y: localDirX * s + localDirY * c };
  const span = lineClipToCanvas(P.x, P.y, D.x, D.y);
  if (!span) return;
  const e0 = { x: P.x + span[0] * D.x, y: P.y + span[0] * D.y };
  const e1 = { x: P.x + span[1] * D.x, y: P.y + span[1] * D.y };
  const e = preferBottom ? (e0.y > e1.y ? e0 : e1)
                         : (e0.x < e1.x ? e0 : e1);
  mctx.save();
  mctx.setTransform(dpr, 0, 0, dpr, 0, 0);
  mctx.textAlign = 'left';
  mctx.fillText(text,
                Math.min(Math.max(e.x + 3, 3), cssW - 26),
                Math.min(Math.max(e.y - 4, 12), cssH - 10));
  mctx.restore();
}

// A constant-world-X gridline: local vertical line, labelled at the bottom.
function labelXGridline(text, worldX) {
  const p = w2s(worldX, 0);
  labelGridline(text, p.x, cssH / 2, 0, 1, true);
}
// A constant-world-Y gridline: local horizontal line, labelled at the left.
function labelYGridline(text, worldY) {
  const p = w2s(0, worldY);
  labelGridline(text, cssW / 2, p.y, 1, 0, false);
}

function drawAxes() {
  const o = w2s(0, 0);
  if (o.x < -40 || o.x > cssW + 40 || o.y < -40 || o.y > cssH + 40) return;
  // X+ is map +X (forward), Y+ is map +Y (left). With DISPLAY_ROT = -PI/2
  // the X arrow points up the screen and the Y arrow points left. They are
  // the real map axes, so the arrows point at the world coordinates they
  // are named after.
  const ax = w2s(0.65, 0);
  const ay = w2s(0, 0.65);
  mctx.lineWidth = 2;
  mctx.strokeStyle = '#3b82f6';
  mctx.beginPath(); mctx.moveTo(o.x, o.y); mctx.lineTo(ax.x, ax.y); mctx.stroke();
  mctx.strokeStyle = '#12b76a';
  mctx.beginPath(); mctx.moveTo(o.x, o.y); mctx.lineTo(ay.x, ay.y); mctx.stroke();
  mctx.font = 'bold 10px Inter, Arial, sans-serif';
  mctx.fillStyle = '#2563eb'; drawUpright('X+', ax.x + 4, ax.y, 'left');
  mctx.fillStyle = '#059669'; drawUpright('Y+', ay.x + 4, ay.y, 'left');
}

function drawZeroMark() {
  const o = w2s(0, 0);
  mctx.strokeStyle = '#f79009';
  mctx.lineWidth = 2;
  mctx.beginPath();
  mctx.moveTo(o.x - 8, o.y); mctx.lineTo(o.x + 8, o.y);
  mctx.moveTo(o.x, o.y - 8); mctx.lineTo(o.x, o.y + 8);
  mctx.stroke();
  mctx.fillStyle = '#9a6700';
  mctx.font = 'bold 10px Inter, Arial, sans-serif';
  drawUpright('ZERO (0,0)', o.x + 10, o.y + 4, 'left');
}

// A point carrying brk was sampled on the tick slam_toolbox rewrote
// map->odom. The segment leading up to it is a line the robot never
// travelled, in any frame -- the frame moved underneath a stationary robot
// -- so lift the pen across it rather than drawing motion that did not
// happen. Drawing it was the same class of fault as the 90 deg goal arrow
// in 17.49: the picture agreed with the number and both misdescribed what
// the robot did. With the pen lifted, run_20260902_114339 reads as 18 arcs
// of one circle, displaced from each other, which is what it was.
function strokePolyline(pts) {
  if (pts.length < 2) return;
  mctx.beginPath();
  let pen = false;
  for (const p of pts) {
    const q = w2s(p.x, p.y);
    if (!pen || p.brk) { mctx.moveTo(q.x, q.y); pen = true; }
    else mctx.lineTo(q.x, q.y);
  }
  mctx.stroke();
}

function drawTrajectory() {
  if (trajectory.length < 2) return;
  mctx.strokeStyle = 'rgba(22, 119, 255, 0.68)';
  mctx.lineWidth = 2.5;
  strokePolyline(trajectory);

  // One hollow tick where each rewrite landed. The gap beside it is how far
  // the ESTIMATE moved while the robot did not, and making that countable
  // by eye is the entire point of the break.
  mctx.strokeStyle = 'rgba(217, 89, 38, 0.85)';
  mctx.lineWidth = 1.4;
  for (const p of trajectory) {
    if (!p.brk) continue;
    const q = w2s(p.x, p.y);
    mctx.beginPath(); mctx.arc(q.x, q.y, 3, 0, Math.PI * 2); mctx.stroke();
  }

  const start = w2s(trajectory[0].x, trajectory[0].y);
  mctx.fillStyle = '#12b76a';
  mctx.beginPath(); mctx.arc(start.x, start.y, 4, 0, Math.PI * 2); mctx.fill();
}

// Past runs: thinner and grey, and each drawn as its OWN polyline so no
// line is ever drawn between the end of one run and the start of the next.
// Older runs fade further, so the most recent past run stays readable
// underneath the live one.
function drawPastTrails() {
  const n = pastTrails.length;
  pastTrails.forEach((pts, i) => {
    const age = n > 1 ? i / (n - 1) : 1;          // 0 = oldest, 1 = newest
    mctx.strokeStyle = 'rgba(102, 112, 133, ' + (0.16 + 0.26 * age).toFixed(3) + ')';
    mctx.lineWidth = 1.6;
    strokePolyline(pts);
  });
}

// Goal markers. The active goal is the one currently commanded; past goals
// are drawn hollow and faint so a sequence reads as a sequence.
// ── LIVE LiDAR SCAN (§17.50) ──────────────────────────────────────────
// Drawn in the ROBOT's current frame, not a frame cached with the scan.
// Pose arrives at 10 Hz and scan at 5 Hz, so binding the dots to whatever
// pose is current at DRAW time keeps them welded to the footprint instead
// of trailing half a pose-update behind it while driving.
//
// THE TRANSFORM IS DELIBERATELY THE SAME ONE drawRobot() USES. Body coords
// go (bx*c - by*s, bx*s + by*c) about robotPose, with base_link's
// standard REP-103 convention: +X is the NOSE, +Y is LEFT. Bearing 0 in
// the corrected /scan_reliable frame points along the nose (+X) and +90 deg
// along the left (+Y), so a beam lands at (r*cos, r*sin) in base_link before
// the laser's own offset is added.
// Anything that changes drawRobot()'s rotation must change this too, and
// the shared convention is why they cannot silently disagree.
let liveScan = null;
let scanStamp = 0;

// laser_frame origin in base_link, tape-measured (§17.12): 0.27 m forward
// along the NOSE axis (+X), on the centreline to within ~0.5 cm. Matches
// aislebot.urdf's laser_joint xyz="0.27 0 0.275". If the mount ever moves,
// this and the URDF change together or the dots sit off the walls.
const LASER_BX = 0.27, LASER_BY = 0.00;

function drawScan() {
  if (!liveScan || !robotPose) return;
  // A frozen scan is worse than no scan: §17.25 had /scan and slam_toolbox
  // stop publishing together while Nav2 kept driving, and the last good
  // sweep sat on screen looking authoritative. Stop drawing after 1.5 s.
  if (performance.now() - scanStamp > 1500) return;

  const c = Math.cos(robotPose.yaw), s = Math.sin(robotPose.yaw);
  const r = liveScan.r, a0 = liveScan.angle_min, da = liveScan.angle_inc;
  const trust = liveScan.trust || 1e9;
  const dot = Math.max(1.1, Math.min(2.6, camScale * 0.012));

  // Two passes so the discarded returns never paint over the trusted ones.
  for (let pass = 0; pass < 2; pass++) {
    mctx.beginPath();
    for (let i = 0; i < r.length; i++) {
      const d = r[i];
      // null = masked rear wedge, or out of the sensor's own range. Both
      // mean "no information", and neither may be drawn as a hit.
      if (d === null) continue;
      const beyond = d > trust;
      if (beyond !== (pass === 0)) continue;
      const th = a0 + i * da;
      const bx = LASER_BX + d * Math.cos(th);
      const by = LASER_BY + d * Math.sin(th);
      const pt = w2s(robotPose.x + bx * c - by * s,
                     robotPose.y + bx * s + by * c);
      mctx.moveTo(pt.x + dot, pt.y);
      mctx.arc(pt.x, pt.y, dot, 0, 6.2832);
    }
    // Pass 0 = beyond max_laser_range: published by the driver, THROWN AWAY
    // by slam_toolbox. Faint, so the cost of the 5 m precision cut is
    // visible on screen rather than taken on trust.
    // Pass 1 = what SLAM and the costmaps actually consume.
    mctx.fillStyle = pass === 0 ? 'rgba(120,130,140,.30)' : 'rgba(232,42,42,.85)';
    mctx.fill();
  }
}

function drawGoalMarker(g, active) {
  const a = w2s(g.wx, g.wy);
  mctx.strokeStyle = active ? '#f79009' : 'rgba(247, 144, 9, 0.32)';
  mctx.lineWidth = active ? 2.5 : 1.4;
  mctx.beginPath(); mctx.arc(a.x, a.y, active ? 9 : 6, 0, 6.2832); mctx.stroke();
  const r = active ? 0.6 : 0.35;
  // yawToVec, NOT cos/sin -- this arrow and drawRobot()'s nose line must
  // come from the same function or they disagree by 90 deg (§17.49).
  const v = yawToVec(g.yaw);
  const b = w2s(g.wx + v.x * r, g.wy + v.y * r);
  mctx.beginPath(); mctx.moveTo(a.x, a.y); mctx.lineTo(b.x, b.y); mctx.stroke();
}

function drawGoals() {
  pastGoals.forEach(g => drawGoalMarker(g, false));
  if (activeGoal) drawGoalMarker(activeGoal, true);
}

function drawScaleBar() {
  const candidates = [0.1, 0.2, 0.5, 1, 2, 5, 10];
  let step = candidates[candidates.length - 1];
  for (const c of candidates) {
    const px = c * camScale;
    if (px >= 70 && px <= 170) { step = c; break; }
  }
  const px = step * camScale;
  const x = 18, y = cssH - 34;
  mctx.strokeStyle = '#17202a';
  mctx.fillStyle = 'rgba(255,255,255,.88)';
  mctx.lineWidth = 3;
  mctx.beginPath(); mctx.moveTo(x, y); mctx.lineTo(x + px, y); mctx.stroke();
  mctx.lineWidth = 1;
  mctx.beginPath();
  mctx.moveTo(x, y - 5); mctx.lineTo(x, y + 5);
  mctx.moveTo(x + px, y - 5); mctx.lineTo(x + px, y + 5);
  mctx.stroke();
  mctx.font = 'bold 11px Inter, Arial, sans-serif';
  mctx.fillText(formatMeters(step), x + px / 2 - 18, y - 22);
}

function drawMapModeBadge() {
  const pad = 10;
  const label = mapResearchMode ? 'RESEARCH VIEW' : 'OPERATOR VIEW';
  mctx.fillStyle = 'rgba(255,255,255,.92)';
  mctx.strokeStyle = '#d0d5dd';
  mctx.lineWidth = 1;
  mctx.beginPath(); mctx.roundRect(cssW - 142, 10, 132, 28, 7); mctx.fill(); mctx.stroke();
  mctx.fillStyle = '#344054';
  mctx.font = '700 10px Inter, Arial, sans-serif';
  mctx.fillText(label, cssW - 132, 20);
}

function drawRobot(p) {
  const c = Math.cos(p.yaw), s = Math.sin(p.yaw);
  const corners = [[ FOOT_HALF_X,  FOOT_HALF_Y], [ FOOT_HALF_X, -FOOT_HALF_Y],
                   [-FOOT_HALF_X, -FOOT_HALF_Y], [-FOOT_HALF_X,  FOOT_HALF_Y]];
  mctx.beginPath();
  corners.forEach(([bx, by], i) => {
    const pt = w2s(p.x + bx * c - by * s, p.y + bx * s + by * c);
    i ? mctx.lineTo(pt.x, pt.y) : mctx.moveTo(pt.x, pt.y);
  });
  mctx.closePath();
  mctx.fillStyle = 'rgba(22,119,255,.18)';
  mctx.strokeStyle = '#1677ff';
  mctx.lineWidth = 2.2;
  mctx.fill(); mctx.stroke();

  const ctr = w2s(p.x, p.y);
  // Same helper the goal marker uses, so the two can never diverge.
  const nv = yawToVec(p.yaw), nl = FOOT_HALF_X + 0.22;
  const nose = w2s(p.x + nv.x * nl, p.y + nv.y * nl);
  mctx.beginPath();
  mctx.moveTo(ctr.x, ctr.y); mctx.lineTo(nose.x, nose.y);
  mctx.strokeStyle = '#17202a'; mctx.lineWidth = 2.5; mctx.stroke();
  mctx.beginPath(); mctx.arc(nose.x, nose.y, 3.8, 0, 6.2832);
  mctx.fillStyle = '#17202a'; mctx.fill();
}

function updateHud() {
  const hud = document.getElementById('mapHud');
  if (!mapGrid && !robotPose) { hud.innerHTML = '<strong>WAITING FOR /map</strong>'; return; }
  const status = document.getElementById('mapStatus');
  if (robotPose) {
    // Raw map frame, verbatim: standard REP-103, map +X is the way the nose
    // pointed at the ZERO mark and +Y is its left. NOSE is raw yaw, so on the
    // ZERO mark it reads 0 deg and turning left (counter-clockwise) increases
    // it.
    const noseDeg = ((robotPose.yaw * 180 / Math.PI + 180) % 360 + 360) % 360 - 180;
    // DRIFT block (§17.49). The map pose alone cannot tell you the robot is
    // in the wrong place: on 1 Sep it read (-0.011, 0.013) with the robot
    // 9 cm off the mark, because map->odom carried -0.114 m and the estimate
    // is self-consistent by construction. odom is the independent witness --
    // it agreed with the tape to ~1 cm on both runs -- so show the gap.
    // This is NOT a correction applied to anything; nothing here changes a
    // published value. It is the raw third transform, displayed.
    let drift = '';
    if (robotPose.cx !== undefined) {
      const c = Math.hypot(robotPose.cx, robotPose.cy);
      // 0.05 m is a deliberate operator threshold, not a spec: below it the
      // estimate and the odometry agree to about the goal tolerance, above
      // it the robot is somewhere the map does not think it is.
      const cls = c >= 0.05 ? 'drift-bad' : 'drift-ok';
      drift = `
      <div class="hud-sep"></div>
      <div class="hud-grid">
        <span>ODOM</span><strong>${robotPose.ox.toFixed(3)}, ${robotPose.oy.toFixed(3)}</strong>
        <span>DRIFT</span><strong class="${cls}">${c.toFixed(3)} m</strong>
        <span>JUMPS</span><strong>${jumpCount}</strong>
      </div>
      <div class="hud-muted">map−odom ${robotPose.cx.toFixed(3)}, ${robotPose.cy.toFixed(3)}</div>`;
    }
    // SCAN block (§17.50). The two numbers §17.45 had to recover offline
    // from a recording, shown live while driving. VALID is the fraction of
    // rays returning anything at all (measured 47.4% parked). FLICKER is
    // the fraction that changed valid<->invalid since the previous sweep
    // (measured 74.8-78% parked, i.e. with nothing moving).
    //
    // Park on the mark and watch FLICKER for sixty seconds: that number,
    // on a stationary robot, is the project's primary suspect for why
    // every map folds, and it is now readable without a post-hoc script.
    // These are DIAGNOSTICS. Nothing here feeds a publisher.
    let scanLine = '';
    if (liveScan) {
      // Denominator is LIVE beams, not total. The ~107-beam rear wedge is
      // NaN by design (§17.15) and can never be valid, so counting it makes
      // every percentage look worse than the sensor is. 215 of 430 reads as
      // 50%; the honest figure is 215 of 323 = 67%.
      const live = Math.max(1, liveScan.live ?? liveScan.total);
      const vPct = 100 * liveScan.valid / live;
      const cPct = liveScan.churn == null ? null : 100 * liveScan.churn;
      // Operator thresholds, not specs.
      const vCls = vPct < 50 ? 'drift-bad' : 'drift-ok';
      const cCls = (cPct !== null && cPct > 35) ? 'drift-bad' : 'drift-ok';
      // CHURN, never "flicker". scan_quality.py's flicker_pct is a windowed
      // cumulative metric over rays-ever-valid; this is a per-sweep rate
      // over live beams. Different denominators, different windows, not
      // comparable — §17.45's 74.8-78% must NOT be read against this.
      scanLine = `
      <div class="hud-sep"></div>
      <div class="hud-grid">
        <span>VALID</span><strong class="${vCls}">${vPct.toFixed(0)}% of ${live}</strong>
        <span>CHURN</span><strong class="${cCls}">${cPct === null ? '—' : cPct.toFixed(0) + '%/sweep'}</strong>
      </div>
      <div class="hud-muted">${liveScan.masked ?? 0} masked (rear wedge) · grey = past ${Number(liveScan.trust ?? 0).toFixed(1)} m</div>
      <div class="hud-muted">CHURN ≠ scan_quality flicker — different metric</div>`;
    }
    const head = `<div class="hud-head"><span class="hud-title">ROBOT POSE · MAP FRAME</span>`
      + `<button class="hud-toggle" aria-label="${hudMin ? 'Expand' : 'Fold'} pose box">${hudMin ? '+' : '−'}</button></div>`;
    if (hudMin) {
      // Folded: the two lines worth glancing at mid-drive, nothing else.
      hud.innerHTML = head
        + `<div class="hud-mini">${robotPose.x.toFixed(3)}, ${robotPose.y.toFixed(3)} · ${noseDeg.toFixed(1)}°</div>`
        + navHudMini();
    } else {
      hud.innerHTML = head + `
      <div class="hud-grid">
        <span>X</span><strong>${robotPose.x.toFixed(3)} m</strong>
        <span>Y</span><strong>${robotPose.y.toFixed(3)} m</strong>
        <span>NOSE</span><strong>${noseDeg.toFixed(1)}°</strong>
      </div>${navHudBlock()}${drift}${scanLine}`;
    }
    if (status) status.textContent = mapGrid ? `${mapGrid.w} × ${mapGrid.h} · ${mapGrid.res.toFixed(2)} m/cell` : 'MAP GRID WAITING';
  } else {
    hud.innerHTML = '<div class="hud-title">ROBOT POSE</div><div class="hud-muted">NO POSE (map → base_link)</div>';
  }
}

// ── View toggle ────────────────────────────────────────────────────
function setMapView(on) {
  mapView = on;
  document.body.classList.toggle('map-mode', on);
  if (on) {
    // Entering map view with a drag in flight would otherwise leave the
    // joystick latched at its last value and the robot rolling.
    if (joyActive || yawActive) {
      joyActive = false; joyTouchId = null; joyX = 0; joyY = 0;
      yawActive = false; yawTouchId = null; yawVal = 0;
      joyThumb.classList.remove('active');
      joyThumb.style.transform = 'translate(-50%, -50%)';
      sendDrive();
    }
  }
  document.getElementById('mapView').classList.toggle('show', on);
  document.getElementById('viewBtn').classList.toggle('on', on);
  document.getElementById('viewBtn').textContent = on ? 'DRIVE' : 'VIEW';
  if (on) {
    if (mapFollow && robotPose) { camX = robotPose.x; camY = robotPose.y; }
    sizeCanvas(); drawMap();
  } else {
    goalDisarm();
  }
}
document.getElementById('viewBtn').addEventListener('click',
  () => setMapView(!mapView));

// Research/display controls are cosmetic only: they change rendering layers,
// never ROS publishers or command semantics.
document.getElementById('btnLayers').addEventListener('click', openLayers);
document.getElementById('btnResearch').addEventListener('click', () => {
  mapResearchMode = !mapResearchMode;
  document.getElementById('btnResearch').classList.toggle('active', mapResearchMode);
  mapLayers.trajectory = mapResearchMode;
  mapLayers.axes = mapResearchMode;
  syncLayerPanel();
  if (mapView) drawMap();
});
for (const key of Object.keys(mapLayers)) {
  const el = document.getElementById('layer-' + key);
  if (el) el.addEventListener('change', () => {
    mapLayers[key] = el.checked;
    if (mapView) drawMap();
  });
}
document.getElementById('researchToggle').addEventListener('change', (e) => {
  mapResearchMode = e.target.checked;
  document.getElementById('btnResearch').classList.toggle('active', mapResearchMode);
  mapLayers.trajectory = mapResearchMode;
  mapLayers.axes = mapResearchMode;
  syncLayerPanel();
  if (mapView) drawMap();
});
document.getElementById('btnClearTrails').addEventListener('click', (e) => {
  e.preventDefault();
  clearAllTrails();
  goalHint('TRAILS AND GOAL MARKERS CLEARED', false);
});

document.getElementById('btnLayersClose').addEventListener('click', () => {
  document.getElementById('layerPanel').classList.remove('show');
});


// ── NAV2 + pose-box fold bindings ──────────────────────────────────
document.getElementById('btnNav2').addEventListener('click', navTap);
// The box is rebuilt by innerHTML on every pose update, so the fold button
// is a new element each time; listen on the box and match the button.
// The box itself stays pointer-events:none so it never eats a map pan.
document.getElementById('mapHud').addEventListener('click', e => {
  if (e.target && e.target.closest && e.target.closest('.hud-toggle')) hudToggle();
});


// ── Zoom / centre ──────────────────────────────────────────────────
function zoom(f) {
  camScale = Math.max(6, Math.min(400, camScale * f));
  drawMap();
}
document.getElementById('btnZoomIn').addEventListener('click',  () => zoom(1.35));
document.getElementById('btnZoomOut').addEventListener('click', () => zoom(1 / 1.35));
document.getElementById('btnFollow').addEventListener('click', () => {
  mapFollow = true;
  if (robotPose) { camX = robotPose.x; camY = robotPose.y; }
  drawMap();
});

// ── Click-to-goal ──────────────────────────────────────────────────
// Two-tap arm, exactly like CALIBRATE: one stray tap must never start a
// 45 kg robot. Gesture then matches Foxglove's 2D Pose tool, which the
// operator already knows: tap to place, drag to aim the NOSE, release.
function defaultHint() { return 'DRAG TO PAN · PINCH TO ZOOM'; }
function goalHint(txt, armed) {
  const h = document.getElementById('mapHint');
  if (!h) return;   // send() can call this before the map view exists
  h.textContent = txt;
  h.classList.toggle('armed', !!armed);
}
function goalDisarm() {
  goalArmed = false; goalDrag = null;
  document.getElementById('btnGoal').classList.remove('armed');
  goalHint(defaultHint(), false);
  if (mapView) drawMap();
}
document.getElementById('btnGoal').addEventListener('click', () => {
  if (estopped) { goalHint('E-STOP ACTIVE — CLEAR FIRST', true); return; }
  goalArmed = !goalArmed;
  document.getElementById('btnGoal').classList.toggle('armed', goalArmed);
  goalHint(goalArmed ? 'TAP MAP TO PLACE · DRAG TO AIM NOSE'
                     : defaultHint(), goalArmed);
});

// ── Re-zero (Important_Commands.md §8, without a terminal) ─────────
// Two-tap armed like CALIBRATE and GOAL. It doesn't move the robot, but it
// redefines what every coordinate on this map means, so a stray tap must
// not do it.
function zeroDisarm() {
  zeroArmed = false;
  clearTimeout(zeroTimer);
  document.getElementById('btnZero').classList.remove('armed');
}
document.getElementById('btnZero').addEventListener('click', () => {
  if (!zeroArmed) {
    zeroArmed = true;
    document.getElementById('btnZero').classList.add('armed');
    goalHint('TAP ZERO AGAIN — MAKES THIS SPOT MAP (0,0)', true);
    zeroTimer = setTimeout(() => { zeroDisarm(); goalHint(defaultHint(), false); }, 5000);
    return;
  }
  zeroDisarm();
  // Re-zero redefines what every coordinate on this map means, so points
  // recorded before it cannot be plotted against points recorded after.
  startNewTrail();
  send({ type: 'rezero' });   // server replies over the notice channel
});

// ── Pointer handling: pan, pinch, or place-a-goal ──────────────────
mapCanvas.addEventListener('pointerdown', (e) => {
  e.stopPropagation();
  mapCanvas.setPointerCapture(e.pointerId);
  ptrs.set(e.pointerId, { x: e.clientX, y: e.clientY });

  if (goalArmed && ptrs.size === 1) {
    const r = mapCanvas.getBoundingClientRect();
    // Belt-and-braces behind the ResizeObserver: a goal is the one gesture
    // where a stale cssW puts the commanded point somewhere the operator did
    // not click, so re-sync before converting rather than trusting the cache.
    // Costs one float compare on a gesture that happens seconds apart.
    if (Math.abs(r.width - cssW) > 0.5 || Math.abs(r.height - cssH) > 0.5) sizeCanvas();
    const p = unrotatePtr(e.clientX - r.left, e.clientY - r.top);
    const w = s2w(p.x, p.y);
    goalDrag = { wx: w.x, wy: w.y, yaw: robotPose ? robotPose.yaw : 0 };
    drawMap();
  } else if (ptrs.size === 2) {
    const p = [...ptrs.values()];
    pinchBase = { d: Math.hypot(p[0].x - p[1].x, p[0].y - p[1].y), s: camScale };
  }
});

mapCanvas.addEventListener('pointermove', (e) => {
  e.stopPropagation();
  if (!ptrs.has(e.pointerId)) return;
  const prev = ptrs.get(e.pointerId);
  ptrs.set(e.pointerId, { x: e.clientX, y: e.clientY });

  if (goalDrag && ptrs.size === 1) {
    const r = mapCanvas.getBoundingClientRect();
    const p = unrotatePtr(e.clientX - r.left, e.clientY - r.top);
    const w = s2w(p.x, p.y);
    const dx = w.x - goalDrag.wx, dy = w.y - goalDrag.wy;
    // vecToYaw, NOT a bare atan2: this writes into the same field that
    // pointerdown initialises from robotPose.yaw, so both must be in the
    // robot's convention (0 = nose along +X, CCW positive). See vecToYaw above.
    if (Math.hypot(dx, dy) > 0.05) goalDrag.yaw = vecToYaw(dx, dy);
    drawMap();
    return;
  }

  if (ptrs.size === 2 && pinchBase) {
    const p = [...ptrs.values()];
    const d = Math.hypot(p[0].x - p[1].x, p[0].y - p[1].y);
    if (pinchBase.d > 0) {
      camScale = Math.max(6, Math.min(400, pinchBase.s * (d / pinchBase.d)));
      drawMap();
    }
    return;
  }

  if (ptrs.size === 1) {                     // pan
    mapFollow = false;
    const d = unrotateDelta(e.clientX - prev.x, e.clientY - prev.y);
    camX -= d.x / camScale;
    camY += d.y / camScale;
    drawMap();
  }
});

function endPtr(e) {
  e.stopPropagation();
  if (goalDrag && ptrs.size === 1) {
    // yaw is where the NOSE should end up, already in base_link's
    // convention (0 = +X, CCW positive) via vecToYaw. goal_pose_adapter
    // adds NOTHING -- its yaw_offset_deg is 0.0 and the live node logs
    // "yaw +0.0 deg".
    const sent = !estopped &&
                 send({ type: 'goal', x: goalDrag.wx, y: goalDrag.wy,
                        yaw: goalDrag.yaw });
    if (estopped) {
      goalHint('E-STOP ACTIVE — GOAL NOT SENT', true);
    } else if (sent) {
      // Keep the sent goal on the canvas. Previously goalDrag was nulled on
      // release and the marker disappeared the instant it was commanded,
      // which is the one moment you most want to see where it is heading.
      if (activeGoal) {
        pastGoals.push(activeGoal);
        while (pastGoals.length > MAX_PAST_GOALS) pastGoals.shift();
      }
      activeGoal = { wx: goalDrag.wx, wy: goalDrag.wy, yaw: goalDrag.yaw };
      goalHint('GOAL SENT → ' + goalDrag.wx.toFixed(2) + ', ' +
               goalDrag.wy.toFixed(2), false);
    }
    // send() has already put NOT CONNECTED on the hint line. Stay ARMED in
    // that one case so a retry costs one tap instead of a re-arm; disarm on
    // success and on the E-STOP refusal, where re-arming is the point.
    goalDrag = null;
    if (sent || estopped) {
      goalArmed = false;
      document.getElementById('btnGoal').classList.remove('armed');
    }
    drawMap();
  }
  ptrs.delete(e.pointerId);
  if (ptrs.size < 2) pinchBase = null;
}
mapCanvas.addEventListener('pointerup', endPtr);
mapCanvas.addEventListener('pointercancel', endPtr);

// A pointerdown that calls preventDefault() does NOT suppress the touch*
// events that follow it, so the pointer handlers above cannot close the
// touch path on their own. These do, at the map-view boundary.
['touchstart', 'touchmove', 'touchend', 'touchcancel'].forEach(evt => {
  document.getElementById('mapView').addEventListener(
    evt, e => e.stopPropagation(), { passive: false });
});

// Desktop convenience; harmless on touch.
mapCanvas.addEventListener('wheel', (e) => {
  e.preventDefault();
  zoom(e.deltaY < 0 ? 1.12 : 1 / 1.12);
}, { passive: false });



// Initial cosmetic sync.
syncLayerPanel();
updateConnectionUI();
updateLivePoseCard();

</script>
</body>
</html>
"""
# ═══════════════════════════════════════════════════════════════════
#  NAV2 (nav2_slam.launch.py, managed from the dashboard)
# ═══════════════════════════════════════════════════════════════════
#
# The clean-start order from Session_Handoff_2026-10-01.md section 6 is
# map first, wait 30 s, then Nav2. The start button enforces the wait
# rather than trusting it to memory.
NAV2_MAP_SETTLE_S = 30.0
# SIGINT to the launch group, then SIGKILL if it is still alive after this.
NAV2_STOP_GRACE_S = 20.0
# After our own Nav2 exits, the ROS graph can still list its nodes for a few
# seconds (longer after a SIGKILL, until DDS liveliness lapses). For this
# long, a lingering bt_navigator is read as ours shutting down, not as a
# terminal launch.
NAV2_GRAPH_SETTLE_S = 30.0
# nav2_lifecycle_manager's std_srvs/Trigger: success once every managed
# node is ACTIVE. The manager's name is set in nav2_slam.launch.py.
NAV2_ACTIVE_SERVICE = '/lifecycle_manager_navigation/is_active'

# action_msgs/msg/GoalStatus codes, as the pose box words them.
NAV_GOAL_STATUS = {0: 'UNKNOWN', 1: 'ACCEPTED', 2: 'EXECUTING', 3: 'CANCELING',
                   4: 'SUCCEEDED', 5: 'CANCELED', 6: 'ABORTED'}
NAV_GOAL_TERMINAL = (4, 5, 6)
# The frame a locations file was taught in. Files written before the 5 Oct
# 2026 axis change have no marker and are in the old frame (+X right, +Y
# forward); a goto from one would send the robot to a point rotated 90 deg
# from the one that was taught, so they are ignored (and backed up, never
# deleted) rather than converted by guesswork.
LOCATIONS_FRAME = 'rep103'
LOCATIONS_LEGACY_SUFFIX = '.pre_rep103'
# How long after an operator stop a goal's terminal status still counts as
# "because of that stop". Nav2 aborts a dropped goal within a couple of
# seconds, but the launch group takes up to NAV2_STOP_GRACE_S to go down.
NAV_STOP_WINDOW_S = 30.0


def pick_latest_goal(entries):
    """entries: iterable of (goal_id_bytes, stamp_sec, stamp_nanosec, status).

    Returns (goal_id_bytes, stamp_s, status) for the goal ACCEPTED most
    recently, or None. The status array carries every goal the server still
    remembers, so "the last element" is not "the current goal"; the accept
    stamp is the only ordering it guarantees.
    """
    best = None
    for gid, sec, nsec, status in entries:
        t = float(sec) + float(nsec) * 1e-9
        if best is None or t > best[1]:
            best = (bytes(gid), t, int(status))
    return best


# ═══════════════════════════════════════════════════════════════════
#  ROS2 NODE
# ═══════════════════════════════════════════════════════════════════
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
