AritraD11/NarrowAisleBot/docs/hardware/circuit_diagram.py

"""Generate the NarrowAisleBot deployed-electronics circuit diagram as SVG.

Every part, pin, rail and baud rate below is taken from the repo's own
hardware documentation, not from memory:

  docs/Master_Reference.md  2.3, 2.5, 3.1, 3.2, 4.1, 4.2, 4.3
  docs/Bench_Test_Map.md    "Discrete MOSFET board wiring",
                            "Full 8-channel wiring - all four encoders"
  docs/RMCS-2086_Encoder_Replacement.md
  README.md                 hardware table

Two documented facts that a generic mecanum-robot diagram would get wrong,
and which this one shows explicitly:

  1. The two FRONT motors no longer use their integrated RMCS-2086 encoders
     (those failed). They run GTK08 units, whose A/B wire colours differ from
     the rear RMCS-2086 encoders. Bench_Test_Map.md flags this as having
     already corrupted a channel once.
  2. The TXS0108E level shifter described in Master_Reference 4.4 is RETIRED.
     Deployed hardware is an 8-channel discrete-MOSFET (BSS138-style) board
     with LV+/LV-/HV+/HV- rails and no OE pin.
"""
import re
import subprocess
from pathlib import Path

OUT = Path("docs/hardware/nab_circuit_diagram.svg")
PNG = Path("docs/hardware/nab_circuit_diagram.png")

W, H = 1190, 1330

# Voltage-domain colours, used consistently for every wire and rail.
C_BATT = "#7B1E1E"   # 12.8 V raw battery
C_24 = "#D32F2F"     # 24 V motor rail
C_5 = "#EF6C00"      # 5 V logic / encoder rail
C_33 = "#1565C0"     # 3.3 V ESP32 domain
C_SIG = "#37474F"    # serial / USB data
C_ENC = "#6A1B9A"    # encoder quadrature signals
C_GND = "#212121"
C_BOX = "#FFFFFF"
C_EDGE = "#455A64"
C_INK = "#17202A"
C_MUTE = "#5D6D7E"
C_WARN = "#B71C1C"

s = []
add = s.append

add(f'<svg xmlns="http://www.w3.org/2000/svg" width="{W}" height="{H}" '
    f'viewBox="0 0 {W} {H}" font-family="DejaVu Sans, Arial, sans-serif">')
add(f'<rect width="{W}" height="{H}" fill="#FFFFFF"/>')

# arrowheads, one per colour
add("<defs>")
for name, col in [("b", C_BATT), ("v24", C_24), ("v5", C_5), ("v33", C_33),
                  ("sig", C_SIG), ("enc", C_ENC)]:
    add(f'<marker id="a_{name}" viewBox="0 0 10 10" refX="9" refY="5" '
        f'markerWidth="6" markerHeight="6" orient="auto-start-reverse">'
        f'<path d="M0,0 L10,5 L0,10 z" fill="{col}"/></marker>')
add("</defs>")


def box(x, y, w, h, title, lines, accent=C_EDGE, fill=C_BOX, ts=17, ls=13.2):
    add(f'<rect x="{x}" y="{y}" width="{w}" height="{h}" rx="7" fill="{fill}" '
        f'stroke="{accent}" stroke-width="2"/>')
    add(f'<rect x="{x}" y="{y}" width="{w}" height="5" rx="2.5" fill="{accent}"/>')
    add(f'<text x="{x+w/2}" y="{y+24}" font-size="{ts}" font-weight="bold" '
        f'fill="{C_INK}" text-anchor="middle">{title}</text>')
    for i, ln in enumerate(lines):
        add(f'<text x="{x+w/2}" y="{y+43+i*15}" font-size="{ls}" fill="{C_MUTE}" '
            f'text-anchor="middle">{ln}</text>')


def wire(pts, col, marker=None, width=2.6, dash=None):
    d = "M " + " L ".join(f"{x},{y}" for x, y in pts)
    m = f' marker-end="url(#a_{marker})"' if marker else ""
    da = f' stroke-dasharray="{dash}"' if dash else ""
    add(f'<path d="{d}" fill="none" stroke="{col}" stroke-width="{width}" '
        f'stroke-linejoin="round"{da}{m}/>')


def vislen(t):
    """Rendered glyph count. Entities like &#8594; and <tspan> markup are one
    glyph or none, so len() on the raw string badly overestimates and the
    white label backing then paints over neighbouring text."""
    t = re.sub(r"<[^>]*>", "", t)
    t = re.sub(r"&(#\d+|[A-Za-z]+);", "x", t)
    return len(t)


def tag(x, y, text, col, size=12.5, anchor="middle", bold=True, bg=True):
    if bg:
        wpx = vislen(text) * size * 0.60 + 10
        add(f'<rect x="{x-wpx/2 if anchor=="middle" else x-5}" y="{y-size+1}" '
            f'width="{wpx}" height="{size+7}" rx="3" fill="#FFFFFF" opacity="0.95"/>')
    fw = "bold" if bold else "normal"
    add(f'<text x="{x}" y="{y+3}" font-size="{size}" font-weight="{fw}" '
        f'fill="{col}" text-anchor="{anchor}">{text}</text>')


def band(x, y, w, h, label, col):
    add(f'<rect x="{x}" y="{y}" width="{w}" height="{h}" rx="10" fill="none" '
        f'stroke="{col}" stroke-width="1.4" stroke-dasharray="7 6" opacity="0.55"/>')
    add(f'<text x="{x+14}" y="{y+21}" font-size="13" font-weight="bold" '
        f'fill="{col}" opacity="0.85" letter-spacing="1.5">{label}</text>')


# ----------------------------------------------------------------- title
add(f'<text x="40" y="46" font-size="27" font-weight="bold" fill="{C_INK}">'
    f'NarrowAisleBot &#8212; deployed electronics</text>')
add(f'<text x="40" y="70" font-size="13.5" fill="{C_MUTE}">'
    f'Base chassis power distribution, drive control and odometry feedback.</text>')

# legend
lx = 660
add(f'<text x="{lx}" y="34" font-size="13" font-weight="bold" fill="{C_INK}">RAILS</text>')
for i, (col, txt) in enumerate([(C_BATT, "12.8 V battery"), (C_24, "24 V motor"),
                                (C_5, "5 V logic"), (C_33, "3.3 V ESP32"),
                                (C_SIG, "USB / serial"), (C_ENC, "encoder A/B")]):
    cx = lx + (i % 3) * 172
    cy = 52 + (i // 3) * 19
    add(f'<line x1="{cx}" y1="{cy}" x2="{cx+26}" y2="{cy}" stroke="{col}" stroke-width="3.4"/>')
    add(f'<text x="{cx+33}" y="{cy+4}" font-size="11.5" fill="{C_MUTE}">{txt}</text>')

# =====================================================================
# POWER BAND
# =====================================================================
band(30, 100, 1720, 300, "POWER DISTRIBUTION", C_BATT)

box(52, 150, 196, 104, "LiFePO&#8324; battery",
    ["SM12830SL", "12.8 V &#183; 30 Ah &#183; 384 Wh"], C_BATT)
box(310, 158, 150, 88, "SSR-50DD", ["solid state relay", "50 A &#183; 3&#8211;32 V trig"], C_BATT)

box(524, 118, 208, 80, "Boost converter", ["1200 W DC-DC", "12.8 V &#8594; 24 V"], C_24)
box(524, 218, 208, 80, "Buck converter", ["DFRobot 60 W", "12.8 V &#8594; 5 V"], C_5)
box(524, 318, 208, 66, "Pi 5 PSU", ["5 V supply"], C_5)
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
