AritraD11/NarrowAisleBot/(commit log)

2026-07-08 Sync repo to current state: LiDAR bringup, docs overhaul, rename to NarrowAisleBot
    - Add docs/ with Markdown conversions (+ original .docx/.pdf preserved) of
    the Research Journal, Master Reference, LiDAR/SLAM Bringup, Network AP
    setup, and Setup Manual — journal is the authoritative living record.
    - Wire in the YDLIDAR X4 Pro: new system/ydlidar_params.yaml (confirmed
    driver params), port-pinned udev rules for esp32/ydlidar (they share a
    CP2102 VID:PID), reconstructed src/scan_relay/scan_relay.py (QoS bridge,
    flagged as reconstructed from docs pending verification against the Pi),
    install.sh now builds YDLidar-SDK + clones ydlidar_ros2_driver instead of
    installing the abandon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
    [aislebot.urdf]
2026-07-08 Sync aislebot_esp32.ino formatting with verified-current copy
    Confirmed via direct Pi cross-check: functionally identical (PID+FF,
    asymmetric IK, WiFi joystick, serial protocol all match byte-for-byte).
    Only difference was banner comment alignment and a trailing-space line.
    Claude-Session: https://claude.ai/code/session_01CSt8GsrwX7rKW19XTmbJvP
2026-07-08 Replace reconstructed scan_relay.py with verified Pi copy; add slam_nodom.yaml
    Cross-checked against the live Pi over SSH (8 July 2026):
    - scan_relay.py replaced with the exact real file (was a doc-based
    reconstruction, differed in QoS depth and had extra logging/shutdown
    handling not present in the real version).
    - system/slam_nodom.yaml added — the actual working SLAM config
    (scan-matching only, subscribes /scan_reliable), previously undocumented
    in the repo. install.sh now installs it to the ROS2 workspace root.
    - YDLidar-SDK and ydlidar_ros2_driver origin URLs in install.sh confirmed
    exact match against the Pi's real checkouts — dropped the "unverified"
    warning.
    - ESP32 U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
2026-07-08 Correct phone_dashboard.py and aislebot_full.launch.py to match live Pi exactly
    Direct SHA256 cross-check against the Pi revealed both were stale:
    - phone_dashboard.py was v2.1 (touch-only). The Pi runs v2.2, which adds
    full desktop/mouse support (click + drag on joystick, yaw, speed, arm,
    record, UV, e-stop) and a hidden keyboard control scheme (WASD drive,
    Q/E yaw, R record) for driving from a PC without a touchscreen.
    - aislebot_full.launch.py: an earlier upload (trusted last session) turned
    out to be stale — it dropped odom_pub and lcd_display and used raw
    /dev/ttyUSB* ports. The real, currently-running file keeps both nodes
    and the /dev/esp32 · /dev/mega udev symlinks.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
    [phone_dashboard.py]
2026-07-08 Update repo references for GitHub rename to NarrowAisleBot + private visibility
    - install.sh GITHUB_REPO and header comments now point at the actual
    current repo name/URL instead of the old Aislebot slug.
    - README: dropped the now-false "repo name stays Aislebot" claim, updated
    the fresh-Pi install URL, and added a note that the one-liner (and any
    anonymous clone) only works while the repo is temporarily made public,
    since raw.githubusercontent.com can't serve private content anonymously.
    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
2026-07-08 Add LICENSE + .gitattributes and polish README for a professional repo
    - LICENSE: add the MIT license text that all four package.xml/setup.py
    files already declare but that had no root file to back it.
    - .gitattributes: enforce LF on source/scripts and mark the .docx/.pdf
    source-of-record files binary so git never tries to diff or
    line-normalize them.
    - README: replace the informal rename/private aside in the header with a
    one-paragraph project description; add License and Acknowledgements
    sections.
    - Setup_Manual.md: point the two install URLs at the current repo name
    (NarrowAisleBot) so the documented one-liner isn't a dead link.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
2026-07-08 Research Journal v2.0: LiDAR/SLAM, dashboard v2.2, repo consolidation
    Brings the living journal fully up to date, in its own theory-first voice:
    - Part XIII (new): Phase 3 kickoff — YDLIDAR X4 Pro bringup. Covers the
    sensor choice vs the planned RPLiDAR, the two-USB-port adapter, the
    identical-CP2102 udev port-pinning problem and fix, the best-effort vs
    reliable QoS wall and the scan_relay solution, rf2o dropped as a
    recorded dead end, the scan-matching-only slam_nodom pipeline, the
    manual bringup sequence with its two traps, and why Nav2 waits on Phase 2.
    - Part XIV (new): dashboard v2.2 desktop mouse+keyboard controls, the
    self-hosted AisleBot-Pi AP, the CycloneDDS Jazzy syn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
2026-07-10 Add docs/tools/: telemetry analyzer and mecanum physics guide
    Two standalone, self-contained HTML tools (no server, no external
    dependencies, work offline) added under docs/tools/:
    - telemetry_analyzer.html: loads the standard 13-column telemetry CSV
    (pi_time_s + FR/FL/RR/RL target/actual/pwm) directly in the browser.
    Per-motor tracking plots, error+PWM view, RMS/saturation diagnostics,
    diagonal mismatch, multi-run comparison, JSON/CSV export. Verified
    before adding: syntax-checked, then driven end-to-end in headless
    Chromium against a synthetic run with an injected feedback dropout and
    a forced saturation window — correctly surfaced both in the findings
    panel and the tracki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
2026-07-18 Add mini-prototype architecture: ESP32 asymmetric mecanum replica
    Full small-scale (~1/3) replica of the NarrowAisleBot for PID + SLAM
    development, driven by an ESP32 with the same reused Raspberry Pi 5 and
    YDLIDAR X4 Pro. Uses PG36M555-19.2K gearmotors with built-in ME-37
    encoders (537.6 CPR) to sidestep the NAB's failed separate encoders.
    Deliverables:
    - docs/Mini_Prototype_Architecture.md — master reference: motor analysis,
    scaled asymmetric geometry (l1=0.15, l2=0.12, d=0.075, r=0.04), adapted
    kinematics, BOM, power budget, ESP32 pin map, same-Pi/same-ESP32
    decision, and a what's-right/what-to-watch review.
    - firmware/narrowaislebot_mini_esp32.ino — prototype firmware: same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
    [mini_robot.yaml]
2026-07-18 Mini arch: add §12 component decisions (SmartElex 13D, wheels, PDB-XT60)
    Resolve the specific parts on hand against their datasheets:
    - Motor driver: SmartElex 13D (dual 13A/30A peak, PWM+DIR, 3.3V logic) is a
    drop-in upgrade for the MDD10A — zero firmware change, use 2 boards.
    - Wheels: 152mm EasyMech (owned) works but coarsens odometry ~2x vs 80mm and
    uses bush rollers; 100mm bearing-roller is the better SLAM buy. Added a
    wheel-size trade table (radius, v_max, mm/count, velocity quant, traction).
    - Power: PDB-XT60's 5V BEC is only 2A — cannot power a Pi 5 (needs 5A). Keep
    the PDB for distribution + sensor 5V, add a dedicated 5V/>=5A buck for the Pi.
    Reworked the §6 power di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
2026-07-20 Add RMCS-2086 encoder replacement guide + mini power clarifications
    NAB blocker: front-motor encoders dead. New docs/RMCS-2086_Encoder_Replacement.md
    identifies the exact encoder (500-line optical quad, 5V, ~93,132 CPR at output;
    6-wire Red+5V/Black GND/Yellow A/Green B) — noting the uploaded RMCS-2077 sheet
    is the non-encoder base variant of the same motor. Ranked India-market fixes:
    diagnose-first (free), new RMCS-2086 (~Rs.6200 ea), or an AS5047P magnetic
    retrofit (3.3V ABI quadrature, drops the level shifter) on all four — with the
    firmware/ENCODER_CPR impact for each.
    Mini prototype doc: added §12.4 (skip-PDB 5V rails — Pi big buck + Lidar small
    buck, ESP32 on Pi USB) and §12.5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
2026-07-20 Encoder guide: add vendor email template + AS5047P retrofit how-to
    - §6: why the base motor's rear shaft is exposed (it's the encoder-mounting
    provision → the encoder is a separable sub-assembly they can sell).
    - §7: copy-ready professional email to Robokits/Rhino requesting the spare
    rear-shaft encoder assembly (to repair the 2 dead units and equip owned
    base motors), with the spec-confirmation questions.
    - §8: AS5047P magnetic retrofit explained end to end — how on-axis magnetic
    sensing + ABI quadrature output maps onto the existing PCNT pins, why it
    suits the exposed rear (fast) shaft, resolution matching to ~93,132 CPR,
    3.3V (drops the level shifter), step-by-step fit,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
2026-07-20 Encoder guide: confirm from physical unit — optical type + PCB part no.
    Photo of the opened RMCS-2086 encoder confirms it is a TRANSMISSIVE OPTICAL
    incremental encoder (clear codewheel + slotted photo-interrupter), and the
    encoder PCB carries its own marking: RMCS-PLNTY-108U (rhinomc.com, HDU3.8,
    dated 30/6/2K20). Added this to the spec table and cited it in the vendor
    email so Robokits can identify the exact spare. Noted that optical-path/LED
    failure (disc and board still look intact) is the likely fault mode — and why
    a magnetic AS5047P retrofit is immune to it.
    Claude-Session: https://claude.ai/code/session_01PMvyRfAdndKKqhvAXs5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
2026-07-20 Encoder email: order 6 encoders (repair 2 + equip 4 idle base motors), send from institute mail
    - Quantity updated to 6: 2 to repair the dead fronts + 4 to equip the idle
    RMCS-2077 base motors; request GST invoice + per-unit/total pricing.
    - Guidance: send from the IIT Bombay institute email (credibility, spare-part
    access, GST invoice for reimbursement); include name/roll/dept/supervisor.
    Claude-Session: https://claude.ai/code/session_01PMvyRfAdndKKqhvAXs5QA8
2026-07-20 Encoder email: rewrite in a plain human voice, drop em-dashes, add address
    Rewrote the vendor email to read naturally (no em-dashes, less templated
    phrasing), fill the IIT Bombay / Powai / Mumbai 400076 shipping address, and
    keep six-piece quantity + GST request. Personal phone/email kept as
    placeholders in the committed template.
    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
2026-07-20 Encoder email: drop specs-confirmation question, add both vendor addresses
    - Removed the "confirm encoder specs" question (already known from experience);
    renumbered so the list is sell-separately / self-fit / order-six.
    - Named both send-to addresses: support@robokits.co.in and info@rhinomc.com
    (Rhino/rhinomc.com is the design house that makes the motor + encoder board).
    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
2026-07-25 firmware: add automatic NAB bench calibration harness
    Self-contained ESP32 sketch for USB-serial bench tuning (wheels in air,
    no WiFi, no Pi). Reuses the production pin map, PCNT decode, motor driver
    logic, and PID+FF math exactly, so the numbers transfer straight back to
    aislebot_esp32.ino.
    Key change from production: per-motor ENCODER_CPR. The front two motors
    now carry GTK08 1000-PPR encoders (186,264 CPR) while the rears keep the
    RMCS-2086 500-line optical (93,132 CPR). The single global CPR constant
    would read front velocities at half scale.
    Runs a 4-phase automatic sequence and streams copy-pasteable CSV:
    A encoder + direction sanity (alive? sign matches command?)
    B feedforward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
2026-07-25 firmware: add encoder isolation test for ESP32 bench debug
    Bench calibration run showed 0 raw counts on all 4 motors, including
    the two encoders actually wired (1 front GTK08, 1 rear optical), even
    though the wheels spun under PID/PWM. That rules out a decode bug
    (identical PCNT logic ran the real robot for months) and points at the
    physical chain: encoder -> level shifter -> ESP32 pin.
    This sketch never touches the motor driver pins, so motors stay off.
    It prints live A/B digital levels plus the raw PCNT count for all 4
    channels at 4 Hz, so the wheel can be turned by hand to isolate the
    encoder+level-shifter+wiring path from any PWM/PID interaction.
    [nab_encoder_isolation_test_esp32.ino]
2026-08-03 docs: add complete TXS0108E level shifter wiring reference
    Written after the bench calibration run returned DEAD_NO_COUNTS on all
    four motors while the wheels were physically spinning.
    Covers both boards (U1 front FR/FL, U2 rear RR/RL) pin by pin, the power
    rails, and OE handling. Flags two things that match the observed symptom:
    - The documented build daisy-chains U2's VCCA/VCCB from U1. A single break
    in that shared feed kills every channel on both boards at once, which is
    exactly the all-four-dead pattern. Both May 2026 encoder failures traced
    to broken joints on this chain. Recommends point-to-point power.
    - The front GTK08 and rear RMCS encoders use different wire colour codes,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
2026-08-03 firmware: add encoder hand-turn diagnostic with float/drive test
    Supply voltages have been verified good and the front wiring diagram
    checked pin-by-pin as correct, so the open question is narrower: is a
    signal reaching the ESP32 pins at all, and if so is PCNT counting it?
    Phase 1 is the decisive new test. GPIO 32/33/25/26 have internal pull-ups
    and pull-downs, so each rear pin is probed both ways: reading 1 under
    pull-up and 0 under pull-down means the line is FLOATING and nothing is
    driving it, which would directly implicate the level shifter output.
    Holding its level against both pulls means the line is actively driven.
    GPIO 34/35/36/39 are input-only with no internal pulls, so the sketc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
    [nab_encoder_handturn_diagnostic_esp32.ino]
2026-08-03 firmware: add event-gated front-encoder speed/direction test
    Previous hand-turn diagnostic printed a fixed-interval row every 500 ms
    regardless of activity, flooding the monitor with zero rows while the
    wheel sat still. This one prints nothing while idle - a row appears only
    when a channel's software-decoded position actually changed since its
    last print, i.e. only while that wheel is being turned by hand.
    Scoped to the front pair (FR, FL / GTK08) per current testing focus. Each
    row reports direction (FWD/REV relative to the firmware's ENC_DIR_SIGN
    convention) and speed in rad/s at the wheel-equivalent shaft, computed
    from the counts-per-print-window and the 186,264 CPR. The PCNT hardware
    c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
    [nab_front_encoder_speed_direction_esp32.ino]
2026-08-03 firmware: add Mega front-encoder test through the level shifter
    Isolates whether the TXS0108E/wiring chain itself is the fault, or
    whether it's something ESP32-specific. The GTK08 encoders already tested
    clean directly on the Mega with no level shifter in the loop (21,033
    edges, 0 invalid). The ESP32 test through the level shifter came back
    noisy - sparse +/-1 blips with no real accumulation, not real rotation.
    This sketch reads the shifter's A-side output with the Mega instead,
    using the same proven quadrature decode, while VCCA/OE move to the
    Mega's 3.3V pin and VCCB stays on the existing 5V buck rail - everything
    else (encoders, B-side wiring) unchanged. Clean counts here would clear
    the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
2026-08-03 firmware: add Mega front-encoder test on relocated D4-D7 pins
    The D2/D3 swap test showed the broken oscillation stays with the D2/D3
    wiring position regardless of which physical encoder is plugged in
    there - strong evidence of a bad connection specific to that position
    (loose jumper, worn breadboard contact, or that Mega pin), not either
    encoder.
    This retires D2/D3 entirely: FR moves to D4/D5, FL to D6/D7. Same
    event-gated direct-wiring test as before, no level shifter, nothing
    prints while idle. If both channels come back clean on these pins, it
    confirms the D2/D3 position as the fault and clears both encoders.
    [nab_mega_front_encoder_pins4567.ino]
2026-08-04 docs: add breadboard bench test map for isolating the level shifters
    Consolidates the debug plan into one referenceable document with wiring
    diagrams and a decision tree, so each result points to the next action.
    Key structure is a 3-stage sequence that removes the ambiguity that has
    dogged this debug: Stage A establishes a baseline with a resistor divider
    (necessary because unlike the Mega, the ESP32 is not 5V tolerant, so the
    encoders cannot be wired direct), proving the pins and encoders are good
    before any shifter is introduced. Only then do Stages B and C swap in
    each shifter. Going straight to the shifter would leave "shifter bad" and
    "ESP32 pin bad" indistinguishable.
    Also documents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
2026-08-04 docs: cover the discrete MOSFET level shifter in the bench test map
    The board on hand is not a TXS0108E but a discrete MOSFET (BSS138-style)
    8-channel shifter - identifiable by ~16 transistors and ~32 resistors with
    no IC, and LV+/LV-/HV+/HV- power pins instead of VCCA/VCCB.
    Adds a comparison table and its wiring, and notes it is the preferable
    part here: no OE pin removes a suspected failure mode, per-channel LEDs
    give a visual activity check, and 8 channels covers all four encoders on
    one board.
    Two corrections it forces: skip the external 10k pull-ups (this board has
    its own on both sides), and re-read the float test, since built-in
    pull-ups make a dead channel sit HIGH rather than floa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
2026-08-04 docs: add full 8-channel wiring for all four encoders on one shifter board
    Datasheet for the on-hand board confirmed it as a BSS138-based 8-channel
    bidirectional shifter (LV 1.2-3.6V, HV 1.65-6V) - both sides of the
    project's actual 3.3V/5V pair sit comfortably inside spec, and I2C usage
    in the datasheet implies proven operation well above the ~47 kHz worst
    case edge rate this project needs.
    Since one board covers all four encoders, the plan simplifies from
    "test two shifters turn by turn" to a single full connection list: all
    8 channels assigned (H0-H7 / L0-L7, ordered to match the existing PCNT
    unit order in the production firmware), power wiring, and a restated
    warning about the GTK08 vs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
2026-08-04 firmware: add bench manual-drive + full encoder diagnostic
    All four encoders are now wired through the 8-channel BSS138 shifter, so
    this replaces hand-turning with keyboard-driven motor control while
    reporting every per-channel signal needed to judge the feedback path.
    Runs two counters in parallel on purpose. PCNT is hardware so it never
    misses an edge regardless of CPU load, and is treated as authoritative
    for position, speed and direction. The software GPIO-register decode can
    undercount while serial is transmitting, so it is used only for
    per-channel health - it is the only way to see A and B separately and
    catch a single dead channel, which PCNT cannot show. Divergence between
    them at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
    [nab_bench_manual_drive_diagnostic_esp32.ino]
2026-08-04 firmware: add Mega 4-encoder test through the 8-channel level shifter
    Independent confirmation path on the Mega for all four encoders and all
    eight shifter channels, hand-turned, on D4-D11 with LV+ fed from the
    Mega's own 3.3V pin.
    Samples via direct port reads (PING/PINE/PINH/PINB) rather than eight
    digitalRead calls, since the encoders sit before the 47:1 gearbox and
    even a slow hand-turn produces a fast pulse train.
    Inputs are plain INPUT, deliberately not INPUT_PULLUP: with LV+ at 3.3V
    the Mega's 5V internal pull-up would fight the shifter's own 3.3V
    pull-up and park the line at an ambiguous level. Header also records
    that 3.3V clears the ATmega2560's 3.0V VIH threshold but only by
    ~0.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
2026-08-04 docs: close out the encoder feedback diagnostic - all channels confirmed healthy
    Three consecutive AUTO TEST runs on the ESP32, driving all four motors
    through the 8-channel BSS138 shifter, all HEALTHY with edge ratios within
    0.1% of 1.00 on every channel. Front/rear count ratio lands at ~2.0x
    across every run, matching the GTK08 (186,264 CPR) vs RMCS-2086
    (93,132 CPR) ratio exactly on physically identical gearmotors - an
    independent check that the signal and the firmware's CPR constants are
    both correct, not just that counts are nonzero.
    Root cause of the entire multi-session diagnostic: a FR/FL cross-connection
    (driving FR moved FL's encoder and vice versa), not the level shifter and
    not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
2026-08-04 docs: strengthen encoder resolution with larger reconfirmation sample
    A follow-up manual-drive session ran 16 bidirectional bursts across all
    four motors (vs. 3 auto-test runs previously), every one independently
    verdict HEALTHY with edge ratio 1.00. No regression on the FR/FL
    cross-wiring fix across the whole session - every drive command was
    answered by that motor's own burst, never a neighbour's. Front/rear CPR
    ratio reconfirmed at ~2.0-2.1x on a sample two orders of magnitude larger
    than before, and all four motors converge to a narrow 1.83-1.94 rad/s
    band at identical PWM, indicating consistent drivetrain behavior across
    all four physically distinct motor units.
2026-08-04 firmware v3.0: per-motor CPR, recalibrated PID/feedforward, Pi-only control
    Calibrates the drive controller against the 4 Aug bench data, now that
    all four encoders are confirmed good through the 8-channel shifter.
    Correctness:
    - ENCODER_CPR is per-motor. Fronts carry GTK08 (186,264 CPR), rears keep
    the RMCS-2086 optical (93,132). The single shared 93,132 constant made
    the fronts read double their true speed, so they tracked at half the
    commanded velocity while the rears were correct.
    - <M> direct-PWM works. The PID task used to overwrite it on the next
    tick; there is now an explicit open-loop mode. Open-loop calibration
    depends on this.
    Calibration (see docs/PID_Calibration.md f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
    [aislebot_esp32.ino, esp32_bridge.py, nab_pid_logger.py]
2026-08-04 Add bench telemetry log run_20260702_183233.csv
    Pi-recorded drive log (v2.0 firmware, single shared ENCODER_CPR=93132),
    pulled in for reference. Not a structured calibration run — see chat
    for the read on it before using it to inform any gain.
    Claude-Session: https://claude.ai/code/session_01CU3VdE2sXvi1wRCjFGr9Xs
    [run_20260702_183233.csv]
2026-08-04 docs: log the 4 Aug bench recalibration and the Pi clock-reliability finding
    Adds Part XVI to Research_Journal.md: the encoder-fault resolution and
    resulting v3.0 firmware recalibration (cross-referencing Bench_Test_Map.md
    and PID_Calibration.md), the recovery and review of an old bench CSV, and
    a new open item — the Pi has no battery-backed RTC, so log timestamps
    aren't trustworthy unless the clock was NTP-synced since the last reboot.
    Flags Part XV as partially superseded and adds B.6 infrastructure TODOs.
    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
2026-08-04 Add bench telemetry log run_20260804_193703.csv
    Live drive session, 90.75s, clock verified correct against the filename
    and the pasted terminal login banner. RMS tracking error 2.0-2.4% of peak
    across all four motors, zero PWM saturation, zero direction-sign
    mismatches. See chat for the full read before drawing conclusions from it.
    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
    [run_20260804_193703.csv]
2026-08-04 docs: document the TXS0108E -> discrete-MOSFET level shifter swap
    The production level shifter is now a single 8-channel discrete MOSFET
    (BSS138-style) bidirectional board, replacing the dual TXS0108E design
    that failed a third time on 3 Aug. Updates Master_Reference.md (hardware
    table + retirement notes on the old §4.3/§4.4 wiring), marks
    LevelShifter_Wiring.md retired but keeps it for the still-applicable
    wiring principles, and updates the docs index accordingly.
    Also closes out Research_Journal.md Part XVI: logs today's confirmation
    run (v3.0 flashed, wheels in air, 2.0-2.4% RMS tracking error, 0%
    saturation, no direction-sign faults), and declares the encoder feedback
    loop closed on t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
2026-08-04 docs: add the eduroam round-trip runbook for CSV pulls and clock sync
    The full sequence from today's session: SSH in, switch to eduroam,
    reconnect via mDNS (eduroam's address isn't fixed like the AP's), verify
    real internet before trusting apt/ntp, force a clock resync, scp/rsync
    the CSVs down from the PC, switch back to aislebot-ap. Cross-references
    the RTC-reliability finding in Research_Journal.md Part XVI so the "sync
    the clock every time" instruction has a reason attached, not just a step.
    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
2026-08-05 docs: dual-encoder inventory, CPR normalisation, and the lost escape hatch
    Brings Part III's hardware inventory up to date: the GTK08/RMCS-2086
    dual-encoder split, the discrete-MOSFET level shifter, and the ESP32's
    current role (100 Hz, no radio).
    Documents the CPR-normalisation mechanism in PID_Calibration.md §1 --
    how two encoders 2x apart in resolution produce identical rad/s from one
    per-motor array, what actually differs (resolution, which matters for
    odometry not control), and why getting it wrong is silent.
    Records a safety-relevant consequence of the v3.0 WiFi removal that was
    not called out at the time: the ESP32 AP escape hatch for a dead Pi no
    longer exists. Network_SelfHosted_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
2026-08-05 docs: add repository branch guide
    Splits ongoing work into two clearly-scoped branches going forward:
    nab-hardware-calibration for the main NAB robot (hardware, encoders,
    level shifter, PID/feedforward, bench/ground tests, design ideas and
    models) and nab-raspi-ros for the Raspberry Pi + ROS2 side exclusively.
    Both branch from the same confirmed-working commit - firmware v3.0,
    all 4 encoders and the level shifter verified, PID calibrated.
    The original prototype-arch branch is left untouched (it carries an
    open PR) and documented as historical/frozen - it holds the mini
    prototype design plus the encoder debugging and v3.0 calibration work
    that happened on it before this split, but the mini p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
2026-08-05 docs: add first physical hardware photos of the NAB robot
    Four photos of the actual chassis, taken 5 Aug 2026 - battery, Pi + LCD,
    rear gearmotors and mecanum wheels through the acrylic panel, and the
    telescoping arm mechanism. Captioned in docs/hardware/photos/README.md
    so a future session can see the real hardware without re-deriving it
    from specs alone. Also corrects the driver-placement note from the
    in-chat discussion: the heatsink+fan visible in these shots is the
    arm's driver, not the drivetrain - the drivetrain motor drivers are
    inside the chassis plates.
2026-08-05 Set up the calibration branch: bench/ground data structure + analysis tooling
    New branch, dedicated to hardware calibration going forward: CSVs,
    analysis, and gain updates all land here from now on.
    - tools/analyze_bench_log.py: reusable analyzer, one CSV in, a markdown
    report + tracking plot + error/PWM plot out. Encodes every check that's
    been applied by hand across the three runs so far -- RMS error, PWM
    saturation/headroom, direction-sign-mismatch detection, and diagonal-pair
    deviation restricted to same-sign-target samples (computing it over
    rotation commands produces a false alarm, as already happened once and
    is documented in Research_Journal.md Part XVI 16.2) -- plus emb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
    [run_20260702_183233.csv, run_20260804_193703.csv, run_20260805_140048.csv]
2026-08-05 nab_pid_logger.py: fit Kff+Kstat together in the staircase test, not just breakaway
    test_staircase() previously only reported the first PWM step that produced
    motion -- a conservative, slightly-high proxy for Kstat, and no refinement
    of Kff at all. Added a proper least-squares line fit (v = m*pwm + c) across
    the moving-region points per motor: Kff = 1/m (viscous slope), Kstat =
    -c/m (the PWM x-intercept, a tighter breakaway estimate than "first step
    that moved"). This is the same fit the retired firmware-side calibration
    harness (nab_bench_calibration_esp32.ino phaseB) used to do in C; it
    belongs in the Python tool now that that firmware is retired. Verified the
    fit recovers exact known Kff/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
    [nab_pid_logger.py]
2026-08-05 docs: resolve the IMU host decision, flag the imu topic-name mismatch
    ESP32-hosted (G14/G13, forwarded as [IMU]... over serial) over Pi-hosted
    -- the I2C load at 100Hz doesn't compare to what motivated pulling WiFi
    in v3.0, and keeping the IMU sample on the same 100Hz loop as wheel
    velocity gives tighter time-sync for the EKF.
    Also logs a real integration bug found while reviewing this: esp32_bridge.py
    publishes to imu/data_raw, ekf_params.yaml listens on imu/data. Silent
    today since no IMU exists yet -- will silently starve the EKF the day one
    is wired up, with no obvious error. Flagged so it isn't rediscovered the
    hard way in Phase 2.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
2026-08-05 fix: launch file was overriding esp32_bridge's calibrated max_wheel_speed
    aislebot_full.launch.py hardcoded max_wheel_speed: 6.28 for the
    esp32_bridge node launch parameter, which silently overrode the node's
    own declare_parameter default of 5.20 (the documented v3.0 AIR value,
    see PID_Calibration.md §7). Confirmed via ros2 param get on the live
    Pi after deploying the updated esp32_bridge.py — the source default
    had changed but the running value hadn't, because launch parameters
    take precedence over source defaults. Aligning the two here so the
    calibrated value actually takes effect.
    Claude-Session: https://claude.ai/code/session_01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
2026-08-05 docs: work through IMU placement, axis count, and the two-IMU option
    Corrects an imprecise claim in the existing Phase 2 prep note: tangential
    acceleration does not mix into yaw rate. A gyro reads the rigid body's
    angular velocity, identical at every point, so gyro placement is
    irrelevant -- and the gyro is the channel that actually addresses the
    Galati heading-drift problem. Only the accelerometer is placement-
    sensitive, and ekf_params.yaml currently has ax/ay enabled, so this is a
    live concern rather than theoretical. Quantified against this chassis'
    geometry: mounting near FR puts rotation artifacts on the same order as
    the real translational signal.
    Records that the preferred fix is di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
2026-08-05 docs: revise the two-IMU analysis -- sequenced, not rejected
    Second pass on the diagonal two-IMU idea. The first pass undersold it and
    contained a factual error; both fixed.
    The real advantage, which the first pass missed: differencing two gyros on
    a rigid body cancels the true signal exactly, leaving pure sensor error
    observable with no external truth reference. Per-sensor magnitude follows
    as sigma_diff/sqrt(2). This offers something Allan variance on a stationary
    bench (IEEE Std 952-1997/952-2020) structurally cannot -- error
    characterisation while the robot is moving, under real motor vibration,
    g-sensitivity and thermal load. Diagonal placement additionally yields
    omega_z^2 from the ac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
2026-08-06 docs: close out the RTC open item — DS3231 wired, working, clock trustworthy offline
    Resolves the open item from Part XVI §16.4. A DS3231 (HW-084) is now
    on the shared I2C bus alongside the LCD (address-multiplexed, no
    conflict). The Pi 5 turned out to expose two RTCs — rtc0 is the SoC's
    own non-battery-backed clock (source of the bogus 1970 resets seen
    all along), rtc1 is the DS3231 — so two systemd oneshot units now
    explicitly target /dev/rtc1 for boot-restore and shutdown-save,
    bypassing the wrong /dev/rtc default. Verified against a full
    power-cycle with no network present: correct time within seconds of
    boot. Updated the eduroam round-trip runbook to reflect that clock
    sync is no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
2026-08-06 Add first ground test: quantifies the ground-load Kff gap, flags a new ripple finding
    run_20260806_152810.csv -- robot on the floor, full weight, all subsystems
    assembled, v3.0 firmware with air-calibrated gains (not yet ground-refit).
    Standard analysis: 3.4-4.0% RMS tracking error (up from 1.2-1.4% in the
    last air run, expected and modest), zero PWM saturation, zero direction-
    sign faults. Loop is stable on real ground.
    Deep analysis, beyond the standard report: this run happened to command
    the same three velocity levels as the 5 Aug air run, held for several
    seconds multiple times each -- enough for a direct matched-amplitude
    comparison without waiting for the structured staircase/plant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
    [run_20260806_152810.csv]
2026-08-06 docs: log code-drift audit and LiDAR ground test in Research Journal
    Adds Part XVI §16.7 (Pi-vs-GitHub drift: CycloneDDS syntax, max_wheel_speed
    launch override, dead Xbox wait) and §16.8 (first LiDAR ground test: the
    checksum-error data-corruption episode and the duplicate-node /map failure,
    resolved via full reboot, re-verification pending). Marks the RTC item in
    B.6 resolved and adds the two follow-on open items.
2026-08-06 nab_pid_logger.py: add --mode rotate for space-constrained ground testing
    plant and staircase both send equal PWM to all four wheels, which on the
    ground drives the robot in a straight line -- staircase in particular is
    one continuous ramp with no reversal, and can cover several metres by the
    top of its range. Not viable without a clear runway.
    Added --mode rotate: applies the mecanum sign pattern for a pure yaw
    (FR/RR positive, FL/RL negative, matching mecanumIK() in
    aislebot_esp32.ino) instead of driving all four the same way. Each wheel
    still rolls against the floor under the same load -- same friction
    physics being measured -- but the chassis spins roughly in place instead
    of crawling a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
    [nab_pid_logger.py]
2026-08-06 Fix silent odom TF gap blocking slam_toolbox; document ydlidar.service collision
    esp32_bridge's telemetry_enabled defaulted False and was never overridden in
    aislebot_full.launch.py, so the ESP32 was never told <L1> and
    odometry_publisher's only TF-publish trigger (/wheel_velocities_actual) never
    fired. odom never existed in TF at all, so slam_toolbox sat at "Activating"
    indefinitely with no error and /map never appeared. Now defaults on.
    Also document an undocumented systemd unit (ydlidar.service) found colliding
    with the manual 3-terminal bringup, which better explains the duplicate-node
    saga from Research_Journal.md §16.8 than the original terminals-not-killed
    theory. First ground-truth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
2026-08-06 sync_bench_logs.ps1: point the default folder at Ground Test specifically
    Default -LocalDir now targets the "Ground Test" subfolder the user is
    actually using (confirmed via screenshot), not the parent Reading folder.
    Every ground/calibration run lands there going forward.
    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
2026-08-06 Add two more ground runs, fix a second diagonal-check bug, add --mode rotate
    Three ground sessions now analyzed from the same day (15:28, 18:35,
    18:49). All three: loop stable, 2.7-4.1% RMS tracking error, 0% PWM
    saturation, zero direction-sign faults, hours apart.
    Fixed a real bug in analyze_bench_log.py's diagonal-pair check, found
    while reviewing run_20260806_183540: same-sign targets aren't the same
    as matched targets. Blended joystick input (forward+strafe+turn
    together) can put a same-sign diagonal pair at genuinely different
    target magnitudes, and the resulting actual-velocity gap is then correct
    tracking, not a fault -- the same-sign-only filter reported FR-RL RMS
    0.105 rad/s, which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
    [run_20260806_183540.csv, run_20260806_184938.csv]
2026-08-06 Consolidate 3-terminal LiDAR/SLAM bringup into one on-demand launch file
    Adds mapping_full.launch.py, combining the lidar driver, QoS relay, and
    slam_toolbox (previously 3 manual terminals) into a single
    `ros2 launch mecanum_robot mapping_full.launch.py`. Deliberately not wired
    into aislebot.service or any new systemd unit — kept on-demand by design,
    since an undocumented always-on service (ydlidar.service) was the root
    cause of most of today's duplicate-node debugging.
    Also logs the rest of today's session: the telemetry fix deployed and
    verified across a reboot, a third silent failure mode (ESP32-side reset not
    detected by esp32_bridge's serial layer, same manual <L1> unblock fixes it),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
2026-08-06 Make ESP32 telemetry self-healing with a periodic <L1> resend
    esp32_bridge only ever sent <L1> once, inside connect_serial(). If the
    ESP32 resets on its own (brownout is the leading suspect) fast enough that
    the Pi-side serial layer never sees a disconnect, telemetry silently stops
    while drive commands keep working normally - no error anywhere. This has
    now recurred multiple times in one session, each time needing a manual
    `ros2 topic pub --once /esp32/command ... '<L1>'` unblock.
    Adds a 5s timer that re-sends <L1> whenever connected and telemetry_enabled
    is set, so it self-heals instead of needing the manual command each time.
    Claude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
    [esp32_bridge.py]
2026-08-06 Log open telemetry self-heal issue for next session
    The periodic <L1> resend deployed this session did not resolve a
    post-reboot recurrence of the odom/telemetry gap - confirmed via the
    firmware source that <L1> is an idempotent set, not a toggle, ruling out
    the risk flagged when the fix was written. Two diagnostics (motor_telemetry_raw
    check, fresh manual <L1> retry) were identified but not run before the
    session ended. Documented as the first thing to check next time.
    Claude-Session: https://claude.ai/code/session_01Lozmyabv2tCKMdvDiwZETm
2026-08-07 Log scope for next session: bringup reliability, dashboard Map button, analysis
    Captures today's end-of-session goals before starting fresh tomorrow: finish
    diagnosing the open telemetry issue first, then build a dashboard Map button
    that starts mapping_full.launch.py and PID recording together (replacing the
    existing Record button, recording every run by default), then define and
    build a real post-run analysis pass. Full SLAM/autonomy parameter tuning and
    dynamic modeling explicitly noted as deferred to a separate discussion.
    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
2026-08-07 Extend telemetry_analyzer.html into a combined run analyzer with a Map tab
    Adds a Map tab that loads a run's .pgm + .yaml pair from map_saver_cli
    (dropped together, auto-paired), parses PGM (P5 binary and P2 ASCII) and
    the simple map_saver YAML format client-side, renders the occupancy grid
    on canvas, and reports resolution/extent/coverage stats (occupied/free/
    unknown %) with findings that flag sparse or barely-mapped runs.
    Map is attached per-run (alongside its telemetry CSV) so a single run's
    PID performance and the map it produced live in one place, matching the
    "Map button records everything, one export per run" workflow being built
    into phone_dashboard.py. JSON export now includes map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
2026-08-07 docs: citation-check and respond to the adaptive-control research proposal
    Adds docs/Adaptive_Control_Roadmap.md in response to two research documents
    proposing RLS/disturbance-observer/dynamic-modeling adaptive control as the
    path beyond static PID+feedforward.
    Verified all four named citations via Scite before building anything on
    them: Williams et al. 2002, Li & Li 2025, and Villarreal-Lopez et al. 2026
    (genuinely published this year, not a hallucinated date) all check out
    against the actual papers. "Zhang et al. 2019" does not -- the real 2019
    Zhang mecanum paper is Lyapunov-based adaptive control with no fuzzy logic,
    addressing slip, not the SMC+fuzzy+payload claims attached to that ci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
2026-08-07 Re-verify post-reboot bringup clean; add dashboard Map button
    Bringup: reran the two diagnostics queued at the end of §16.10
    (motor_telemetry_raw hz, manual <L1> retry) plus a wheel_velocities_actual
    hz and odom tf2_echo check. All healthy on this boot — the telemetry gap
    did not recur, so the telemetry_enabled launch-file fix held across the
    reboot. The resend-timer self-heal itself remains unexercised (nothing
    broke for it to heal from this session); logged as still-open with a
    concrete repro plan (§16.12).
    Dashboard: phone_dashboard.py v2.3 replaces the RECORD RUN button with a
    Map button in the same UI slot. One press launches mapping_full.launch.py
    as a managed subprocess group and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
    [phone_dashboard.py]
2026-08-07 Automate post-run analysis: headless report on every mapping stop
    Adds run_report.py, a pure-stdlib Python port of telemetry_analyzer.html's
    metrics/findings/map-stats logic (PID tracking, settling time, PWM
    saturation, dead-feedback and diagonal-mismatch diagnostics, map
    occupied/free/unknown classification) — needed because phone_dashboard.py
    runs headless on the Pi with no browser to open the HTML tool in.
    Cross-checked numerically against the actual JS functions on real bench
    data and a synthetic map/CSV pair; exact match on every field.
    phone_dashboard.py's stop_mapping() now saves the map via map_saver_cli
    before killing the launch tree (must happen while slam_toolbox is still
    alive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
2026-08-07 Log successful end-to-end hardware verification of today's work
    Map button and automated post-run report both confirmed on the real Pi:
    one press each way, subprocess pid tracking matched the actual launch
    process, all four run files (csv/pgm/yaml/report.json) landed together,
    no orphaned ros2 launch process, and the report's own findings matched
    known-good numbers from earlier manual maps. Closes out the "not
    verified on hardware" caveat from §16.13/§16.14.
    Claude-Session: https://claude.ai/code/session_019HBvcPr9CbFXmpq21Czkq1
2026-08-07 past_iterations: recover superseded ESP32/arm firmware, dead launch file, and pre-rewrite Python
    Pulls three genuinely retired artifacts out of git history rather than
    leaving them only reachable by digging through commits: the pre-v3.0
    ESP32 firmware (Ki~30, no dynamic anti-windup, superseded 4 Aug 2026),
    the pre-v8 arm firmware (no UV-C staging, superseded 23 June 2026), and
    hardware.launch.py (deleted outright 8 July 2026). Also archives the two
    clearest Python analogs from today's own session: phone_dashboard.py
    before the Map button, and esp32_bridge.py before the telemetry
    self-heal timer. Each extracted from its exact pre-rewrite commit and
    documented in past_iterations/README.md with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
2026-08-07 Important_Commands.md: use the confirmed-working scp download commands
    Replaces the generic <destination folder> placeholder with the exact
    commands and path just verified working (pgm/yaml/report.json/csv all
    pulled successfully into the ground-test folder).
    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
2026-08-08 Open Part XVII: SLAM literature review, theory doc, research articles
    Literature-reviewed the SLAM algorithm choice via Scite before touching
    any parameters, per the user's explicit standard for this phase
    (scientifically sound, PhD-grade reasoning, not assumption). Confirms
    slam_toolbox is the justified pick against GMapping/RBPF, Hector SLAM,
    and Cartographer -- not just the incumbent -- and surfaces one concrete
    recommendation: re-evaluate the no-odometry-prior scan-matching config
    now that odom-TF is confirmed reliable (§16.12/§16.15), since that
    config's original justification no longer holds.
    Adds:
    - research_articles/README.md -- ten verified, DOI-cited papers (no
    retractions), t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
2026-08-08 §17.4: LiDAR placement trial closed out — Position 2 selected
    Three mount positions compared via the Map button's automated
    per-run reports. Position 3 (elevated) was the cleanest controlled
    comparison and showed no improvement over baseline; Position 2 (on
    top of the battery) had the best unknownPct and is the only position
    that removes the battery from the LiDAR's line of sight by mechanism
    rather than degree. Selected as final. aislebot.urdf's laser_joint
    origin updated to match the reported mount deltas.
    [aislebot.urdf]
2026-08-08 §17.5: add Foxglove Bridge for live visualization
    foxglove_bridge added to install.sh and aislebot_full.launch.py
    (port 8765, always-on) since RViz-on-laptop can't reach the robot's
    topics over this network (DDS multicast doesn't cross it). Not yet
    verified on hardware.
    Also corrects SLAM_Theory.md §2.3's premise: odometry_publisher runs
    continuously via aislebot.service, so slam_toolbox has already had a
    live odom prior in every mapping run since the §16.9 TF fix, despite
    slam_nodom.yaml's name. Revises the planned odometry-prior benchmark
    to a genuine no-prior control run instead of a nonexistent second
    config.
2026-08-08 §17.5: Foxglove Bridge confirmed working on hardware
    Deployed after switching the Pi to eduroam for apt/curl access, then
    back. Live map + slam_toolbox pose-graph visualization confirmed
    during a real Map run. Visualization phase item closed.
2026-08-11 §17.6: open autonomy phase — Navigation_Theory.md + four Nav2 config fixes
    Literature-first, as with the SLAM phase. Adds docs/Navigation_Theory.md
    (costmap inflation math, global/local planning, self-occlusion as a
    navigation problem) and six papers to research_articles/.
    Fixes four latent bugs in the never-yet-run nav2_params.yaml:
    - footprint was 0.90x0.40 against a 1.0x0.50 chassis (collision bug)
    - both costmaps subscribed to best-effort /scan, not /scan_reliable
    (same QoS trap as §13.4, new consumer)
    - allow_unknown: false, unusable against ~85%-unknown SLAM maps
    - odom_topic pointed at a robot_localization EKF that never runs
    Footprint remains flagged UNVERIFIED pend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
2026-08-11 §17.7: footprint measured — 1.12 x 0.48 m, URDF chassis box corrected
    Tape measurement gives 36 cm wide x 100 cm long. This overturns §17.6's
    caution about the 0.48 m width: the URDF's chassis <box> (0.50 m) was the
    wrong number, not the hand measurement. The URDF's wheel joint origins
    imply 0.375 m outer width and agree with the tape to within a centimetre,
    so the error was confined to the visual/collision box — the kinematic
    parameters used by the PID and odometry were never affected.
    Chassis inertia left stale on purpose (Gazebo-only impact); flagged in B.6.
    [aislebot.urdf]
2026-08-11 tools: add scan_bearing.py — measure LiDAR mounting yaw and self-occlusion
    Two numeric answers that a visualiser cannot give reliably:
    1. Bearing of the nearest return, for calibrating the base_link ->
    laser_frame static transform's yaw against a known-position object.
    2. A 15-degree sector table, so self-occlusion (fixed in the laser frame
    across headings) can be told apart from real geometry (which moves).
    Prompted by finding the live laser_frame TF at (0, 0, 0.02) with zero
    rotation — the ydlidar driver launch file's placeholder default, not the
    actual Position 2 mount. Translation error alone cannot explain an
    apparently mirrored obstacle, so the mounting yaw needs me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
    [scan_bearing.py]
2026-08-11 17.9: fix mirrored LiDAR scan in scan_relay.py
    Measured on hardware with a single block at known bearings:
    block truly FRONT ( 0 deg) -> reported 180 deg WRONG
    block truly RIGHT ( -90 deg) -> reported -90 deg correct
    block truly LEFT ( +90 deg) -> reported +90 deg correct
    Left/right correct, front/back swapped: a reflection about the robot's Y
    axis (reported = 180 - true), not a rotation. A 180 deg rotation would
    have swapped left and right too, and did not.
    This rules out a TF fix entirely — tf2 carries proper rigid motions only
    and cannot express a reflection — so the correction is applied to the scan
    data itself, in the one node already in the path. Re-indexing is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
2026-08-11 17.9: correct scan_relay yaw_offset 180 -> 270 deg
    The first pass at this fix assumed base_link's forward axis follows
    REP-103 (+X). The user measured against how the robot actually drives
    (W -> +Y, D -> +X, confirmed against Foxglove's Fixed/Display frame set
    to base_link) and got three points that all solve for yaw_offset=270,
    not 180 - a 90 degree difference from what was about to be deployed.
    block truly RIGHT (base_link +X, 0 deg) -> reported 270 deg
    block truly FRONT (base_link +Y, 90 deg) -> reported 180 deg
    block truly LEFT (base_link -X, 180 deg) -> reported 90 deg
    All three verified against the actual index-remapping function (not just
    point algebra), plus a fourth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
2026-08-11 §17.8-17.9: self-occlusion trial, LiDAR mirror bug found and fixed, full write-up
    Adds the session's complete record:
    - §17.8: self-occlusion measured directly by block-placement rather than
    inferred from map coverage — blind sector is ~1/3 of the full sweep,
    which better explains the placement trial's ~85%-unknown maps than
    battery occlusion alone.
    - §17.9: the LiDAR scan mirror bug — discovery, the ruled-out 180 deg
    hypothesis (assumed REP-103, caught before deployment), the correct
    measurement against how the robot actually drives, the reflection-vs-
    rotation derivation that ruled out a TF-based fix, and the scan_relay.py
    correction (mirror=True, yaw_offset=270 deg)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
2026-08-11 §17.10: correct scan_relay yaw_offset 270 -> 180 deg
    §17.9's deployed fix (yaw_offset=270) rested on an asserted W/D driving
    convention (forward=+Y) that was never independently checked. Immediately
    after deployment, a new symptom appeared: driving forward moved the
    accumulated map sideways instead of backward -- a translation-tracking
    problem an angle-only fix shouldn't have been able to cause.
    Checked against raw odometry rather than a screenshot: tf2_echo odom
    base_link before/after controlled forward-only and strafe-right-only
    moves. Forward put 94% of motion in dX, strafe-right put 96% in dY --
    that's REP-103 (forward=+X), the opposite of what the deployed fix
    assumed, and the same c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
2026-08-11 Revert "§17.10: correct scan_relay yaw_offset 270 -> 180 deg"
    This reverts commit 0c493877cbac7e15311b72079171294c55a89567.
2026-08-11 §17.10: fix map-drift via odometry_publisher.py published-frame rotation, not scan_relay.py
    Forward driving after §17.9's LiDAR fix made the map shift sideways
    instead of backward. Raw tf2_echo odom->base_link measurements across
    controlled single-axis moves showed standard REP-103 (+X=forward),
    contradicting the W/D convention §17.9's fix was built on -- re-solving
    that fix's block data with forward on +X reproduces the earlier
    yaw_offset=180 hypothesis exactly.
    That change was implemented in scan_relay.py, then reverted at the
    user's explicit instruction: yaw_offset=270 already had stronger
    independent confirmation (a driving-toward-a-block video predating the
    drift symptom) than odome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
    [odometry_publisher.py]
2026-08-11 Fix stray §17.11 reference in nav2_params.yaml AXES note (should be §17.10)
    Cross-reference typo caught while preparing a manual paste-block deploy
    for the Pi -- the odometry fix landed in Research_Journal.md §17.10, not
    §17.11. No behavioral change.
    Claude-Session: https://claude.ai/code/session_01QomZdMQSv4JufpZdkLvCrP
2026-08-11 §17.11: confirm map-drift fix on hardware, close out branch
    User-confirmed on the real robot: with Foxglove's 3D panel set to
    Fixed/Display frame = base_link, forward driving now shows the map
    sliding away behind the robot instead of sideways -- the §17.10 fix
    works as derived. Documents the deploy path actually used (scp from
    the user's Windows PC straight to the Pi's real ~/ros2_ws, after both
    an assumed-wrong path and a curl/eduroam TLS failure), a small residual
    LiDAR yaw misalignment noted and deferred (new B.6 item, distinct from
    §17.9's already-fixed reflection bug), and the specific Foxglove frame
    settings that make drift bugs visible -- added to Important_Commands.md
    §6 for reus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
2026-08-12 Add Nav2 SLAM-mode launch; fix three latent bugs blocking first Nav2 run
    Opens the autonomous-navigation phase. Nav2 has never been run on this
    robot, so everything below is a latent config error found by inspection
    before first bringup, in the same spirit as §17.6's four-bug pass.
    New: nav2_slam.launch.py — Nav2 navigation nodes only (planner,
    controller, behaviours, BT navigator, costmaps), for driving
    autonomously WHILE slam_toolbox maps. Deliberately uses nav2_bringup's
    navigation_launch.py rather than bringup_launch.py, since the latter
    also starts map_server + AMCL, and AMCL fights slam_toolbox over
    map->odom.
    Fix 1 — navigation.launch.py started a second odom->base_link publish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
2026-08-12 Log 12 Aug mapping/Nav2 session: workspace cleanup, zero-position convention, footprint confirmed by measurement, first mapping trials, first Nav2 bugfix pass
    Adds §17.12-§17.14 covering a single continuous session: Pi/workspace
    audit and cleanup, the physical zero-position convention and why it
    works, the footprint geometry confirmed correct by direct measurement
    (base_link located at the true chassis center via the rotation-pivot
    method), the first real mapping trials and the traversal-pattern root
    cause behind the wall-gap symptom, and the three latent Nav2 bugs found
    and fixed before first hardware bringup.
    Updates B.6 with the session's real findings, including the one
    explicitly unr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
2026-08-13 Convert aislebot.urdf to the robot's real axis convention; land measured LiDAR offset
    Clears the landmine §17.10 flagged and deferred: the URDF still modelled
    the chassis long along +X while the live TF's +X means RIGHT, so anything
    rendering /robot_description would have drawn the robot rotated 90 deg
    from reality. Applies (x, y) -> (-y, x) to every joint origin, swaps the
    chassis box's X and Y extents, and re-points the wheel spin axes and
    cylinder orientations from Y to X. Verified: front/rear wheels now on
    +/-Y, right/left on +/-X, with l1 on the outer pair and l2 on the inner
    pair as the kinematics require.
    laser_joint now carries the 12 Aug tape measurement rather than the old
    derive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
    [aislebot.urdf]
2026-08-13 Draw the real chassis in Foxglove: robot_state_publisher in, vendor's wrong laser TF out
    Closes two long-standing B.6 items together, because neither is safe
    alone.
    The vendor's ydlidar_launch.py bundles the driver node with a
    static_transform_publisher hardcoding base_link -> laser_frame as
    (0, 0, 0.02) with zero rotation. That is the stale placeholder §17.9
    found live on the robot, it is not this robot's mount, and the launch
    file exposes no argument to suppress it. mapping_full.launch.py therefore
    now starts the driver LifecycleNode directly -- declaration copied
    verbatim from the vendor file, same name, namespace and params default,
    so the driver itself behaves identically -- and simpl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
2026-08-13 Mask the rear-mast self-occlusion arc in scan_relay; supersedes 17.8's estimate
    Measured with tools/scan_bearing.py at five headings around a full 360 deg
    rotation. Six contiguous sectors from -135 to -45 deg returned the same
    nearest range at every heading -- 0.13, 0.13, 0.13, 0.24, 0.14, 0.16 m,
    spread at most 0.01 m across the whole revolution. A room-dependent
    sector over the same five headings spread 3.86 m. In every one of those
    sectors hits% equals close% exactly: every beam that returns anything
    returns something under 1 m, so nothing gets past. -90 deg is dead astern
    in this robot's frame, matching the physical rear stack.
    Two findings this settles.
    The arc is 90 deg, not the "rou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
2026-08-13 Draw the 6 cm safety cushion as a visual-only URDF link
    Makes the stop condition visible instead of inferred: a translucent
    0.48 x 1.12 m rectangle at floor level, which is the chassis plus 6 cm all
    round. When a /scan_reliable return crosses inside it, the robot is at the
    cushion boundary in that direction -- the exact condition the guarded-drive
    feature will act on.
    Verified equal to nav2_params.yaml's costmap footprint polygon on both
    costmaps, and the margin checked as exactly 6.0 cm per side on both axes.
    Flagged inline as a mirror rather than a source: the numbers are duplicated
    from the Nav2 config and nothing enforces they stay in step, so once Nav2
    runs, local_costmap/published_foo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
    [aislebot.urdf]
2026-08-13 Make the robot's LCD show a persistent network status instead of drive telemetry
    At the user's explicit request: drive/arm/lift state on the LCD is no
    longer wanted, being able to read the Pi's current IP and dashboard port
    without an already-open SSH session is. Directly motivated by tonight's
    own session -- real time lost switching between eduroam, IITB-Wireless,
    and the AisleBot-Pi AP with mDNS unreachable on at least one of them, no
    way to find the current IP except a session that was, by definition,
    already the thing that had just dropped.
    Old behaviour: _show_boot() showed the IP for the first 4 seconds after
    node start, then update_display() permanently took over showing
    DRIVE/ARM/LF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
2026-08-13 Fix lcd_display showing NO NETWORK specifically on the AisleBot-Pi AP
    Bug in the previous commit (1b20a62), caught immediately on hardware: the
    IP lookup opened a UDP socket toward 8.8.8.8 and read back which local
    address the OS would use to reach it. That trick requires a route to
    exist, even an unused one -- fine on eduroam/IITB-Wireless, which have a
    real default gateway, but the AisleBot-Pi AP deliberately has no upstream
    route at all (no internet uplink, by design, per
    Network_SelfHosted_AP.md). connect() throws Network unreachable, the
    broad except caught it, and the display showed "NO NETWORK" -- in exactly
    the one mode this whole feature exists to cover.
    Fixed by reading the IP dir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
    [lcd_display.py]
2026-08-13 Analyze the five-heading blind-sector scan data; log §17.15
    Cross-checked the five scan_bearing.py sector tables against each other
    rather than reading any one in isolation: exactly one bearing block,
    -135deg to -45deg true bearing (a 90deg wedge centred directly behind the
    robot), returns a nonzero <1m reading in all five independent headings at
    closely matching percentages each time. Every other "always close" flag
    in any single run appears in exactly that one run and nowhere else -- the
    signature of a real wall the robot happened to face at that heading,
    correctly not persisting, versus the robot's own structure, which does.
    The single nearest point across all five scans independently cl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
2026-08-13 Log §17.16: hardware deploy confirmed, block-vs-phantom left open, session closed for a clean handoff
    All three pending files (aislebot.urdf's safety cushion, scan_relay.py's
    self-occlusion mask, lcd_display.py's fix) confirmed deployed and working
    on real hardware -- clean restart (ros2 node list matches expected set,
    no duplicates), LCD reads 10.42.0.1/AP:8080 in the exact mode that broke
    the first version, and a photographed wall approach shows the cushion
    boundary and /scan_reliable aligning at a real wall edge, independent of
    17.15's tape-measured gap.
    One artefact found and deliberately left unresolved rather than guessed
    at: a black cell cluster near the robot's own footprint, ambig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
2026-08-13 Add the collision_monitor block that aborted the first Nav2 bringup
    First-ever Nav2 hardware launch died at collision_monitor: "parameter
    'observation_sources' is not initialized", after which lifecycle_manager
    correctly refused to bring up the rest. Nothing publishes /cmd_vel
    without this node, so the failure is total rather than degraded -- the
    robot could not have moved at all.
    Root cause is the same class as the missing velocity_smoother block
    found earlier on this branch, and the same underlying reason: this Nav2
    build is newer than the one nav2_params.yaml was originally written
    against. It also starts route_server and opennav_docking, neither of
    which existed then. Those two configur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
2026-08-13 Start Nav2's nodes explicitly instead of including nav2_bringup
    Second bringup attempt got past collision_monitor and then died on
    docking_server: "Charging dock plugins not given!". lifecycle_manager
    brings its managed nodes up as an all-or-nothing set, so one node this
    robot has no use for -- it has no charging dock and will not acquire one
    -- aborted the entire navigation stack again.
    nav2_bringup's navigation_launch.py on this Nav2 build also starts
    route_server and opennav_docking, neither of which existed in the Nav2
    generation nav2_params.yaml was written against. Adding a dock-plugin
    config to satisfy a docking server we will never call would be ceremony,
    and would leave the identic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
2026-08-14 Log §17.17: first Nav2 hardware launch reached, two bugs fixed, origin mismatch still open
    Managed nodes are active on real hardware for the first time this
    project has run Nav2 -- the milestone this whole phase has built toward.
    Two real bringup bugs found and fixed on the way:
    1. collision_monitor had no config block at all. observation_sources has
    no sensible default (Nav2 cannot guess a robot's sensors), so the node
    failed to configure and lifecycle_manager correctly aborted the entire
    bringup rather than run degraded -- nothing would have reached
    /cmd_vel. Added a full block: velocity-aware "approach" polygon
    against /local_costmap/published_footprint (live, not duplica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
2026-08-14 Log §17.18: the zero-mark model itself was wrong, not the restart attempts
    A genuinely fresh mapping session -- confirmed via clean ps aux this
    time, not just an attempted restart -- still read map->base_link as
    [0.685, -0.219] at -90.1 deg, not [0,0,0]. This overturns the model
    stated repeatedly since §17.12 (a fresh session zeroes the map origin to
    wherever the robot physically starts), not just §17.17's specific
    non-fresh readings. That model was asserted from general SLAM/ROS
    convention and never actually verified against this project's slam_
    toolbox configuration.
    Recorded as a concrete, testable, NOT YET CONFIRMED hypothesis rather
    than asserted as fact: the yaw lands close to -90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
2026-08-14 Compute goals from the measured pose; drop the two axis-blind DWB critics
    Two changes, both needed before the first autonomous goal is sent.
    tools/nav_goal.py reads map->base_link off TF and rotates a body-frame
    offset ("N metres forward") into map coordinates, so a goal no longer
    depends on the map origin meaning what §17.12 assumed it meant. It also
    prints the robot's current pose as a ready-to-send return goal, which is
    only knowable while the robot is still standing at the start point. Read
    only: it never sends a goal or publishes anything.
    nav2_params.yaml drops GoalAlign and PathAlign from the DWB critics.
    Both score a point projected along base_link's +X, hardcoded in
    nav2_dwb_crit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
    [nav_goal.py]
2026-08-14 Fix bt_navigator's Empty Tree failure: resolve the BT xml path in the launch file, not the yaml
    First-ever goal sent on hardware today came back "Behavior tree threw
    exception: Empty Tree. Exiting with failure" -- bt_navigator built no
    tree at all. Root-caused live rather than guessed at: `ros2 param get
    /bt_navigator default_nav_to_pose_bt_xml` on the running node showed an
    empty string, not a computed default.
    nav2_params.yaml set default_nav_to_pose_bt_xml: "" on the theory
    (§17.14) that an empty string falls back to Nav2's built-in default
    file. It does not on this Nav2 build -- an explicitly-provided empty
    value isn't the same as an omitted one, and only the omitted case
    triggers the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
2026-08-14 Rotate Nav2's cmd_vel into the wheel kinematics' axes; halve speeds
    First autonomous goal drove 0.956 m at 88.4 deg to the commanded
    direction before being E-stopped. Measured from the action feedback:
    goal was 1.500 m at map bearing -0.2 deg, robot travelled at +88.3 deg.
    A clean 90 deg error, not drift.
    Cause: two individually-correct axis conventions meet at /cmd_vel and
    nothing reconciled them. Nav2 reads the pose in base_link's TF axes
    (+X=right, +Y=forward -- odometry_publisher's constant -90 deg published
    rotation, §17.10) and writes velocity in those same axes.
    mecanum_teleop_asymmetric.py reads /cmd_vel as standard REP-103
    (+X=forward, +Y=left), as do the dashboard and joy node.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
2026-08-14 Add zero_point_scan.py: self-detecting autonomous 360° base-map scan
    Automates the procedure found by hand tonight: pure rotation reliably
    adds nothing to the map under this robot's no-odometry, scan-matching-
    only SLAM config (slam_nodom.yaml) -- checked directly against
    slam_toolbox's shouldProcessScan source to rule out the obvious
    threshold explanation first. The real mechanism is almost certainly
    scan-matching ambiguity with no motion prior: a 360° lidar's rotation-
    only scan is near-identical to the last one just re-indexed by angle,
    giving the matcher little to confidently lock onto. Any translation
    introduces parallax and unlocks it immediately -- confirmed by hand,
    four times runn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
2026-08-14 Log §17.20: click-to-goal wired up, the rotation-mapping mystery root-caused, zero_point_scan.py designed but untested
    Covers the rest of tonight after §17.19: the /goal_pose topic fix for
    Foxglove click-to-goal, two wrong hypotheses chased and corrected in
    place (Fixed Frame, then the minimum_travel_heading threshold -- both
    checked against real settings/source and disproven) before landing on
    the real cause (no-odometry scan-matching-only SLAM makes pure
    rotation ambiguous without a motion prior, confirmed by the user's own
    four-times-repeated controlled experiment), zero_point_scan.py's
    design and the behavior_server/BackUp axis gap it deliberately
    sidesteps, and the manual mapping prog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
2026-08-15 Fix two chained bugs before zero_point_scan.py's first hardware run
    Found by reading nav2_params.yaml against what the script actually does,
    not by running it — same discipline as §17.14/§17.17/§17.19's latent-bug
    passes. The two faults chain into each other:
    1. SimpleProgressChecker measures progress as XY distance only, ignoring
    yaw. zero_point_scan.py is built entirely from rotate-in-place goals,
    which therefore score as zero progress however fast the robot turns.
    At max_vel_theta 0.20 rad/s a 90° step needs 7.9 s at the cap alone,
    against a 10 s allowance — so the suggested smoke test (--step-deg 90)
    would very likely abort mid-turn with "Failed to make progress".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
    [zero_point_scan.py]
2026-08-15 Add a permanent zero_point marker and document the real re-zero procedure
    Confirmed on hardware today: restarting aislebot.service with the robot
    parked on the floor mark zeroes odometry AT the mark — tf2_echo odom
    base_link read exactly [0.000, 0.000, 0.000] @ -90.000 deg. Since
    slam_toolbox sets map->odom to identity at a session's first scan
    (§17.19), a fresh mapping session started after that restart inherits
    the mark as map (0,0). That is the whole procedure the last three
    sessions were missing; pressing Map alone never set the zero point.
    mapping_full.launch.py now publishes a static map->zero_point frame at
    the origin carrying base_link's own -90 deg twist, so the two axis
    triads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
2026-08-15 Add the CALIBRATE dashboard button and a click-to-goal heading adapter
    CALIBRATE (phone_dashboard v2.4) runs tools/zero_point_scan.py as a
    managed subprocess — four 90 deg headings, map-growth check at each,
    a <=0.15 m nudge only where rotation alone did not commit new area,
    and a return to the exact start pose as the final action.
    90 deg steps are chosen, not arbitrary: the rear self-occlusion mask is
    a measured 90 deg wedge (§17.15) and a 360 deg LiDAR already sees
    everything else from any one heading, so four headings sweep the blind
    wedge across the full circle exactly once.
    This is the first dashboard control that commands autonomous motion, so
    it carries guards the other buttons d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
2026-08-15 Fix the reason zero_point_scan.py's nudges could never grow the map
    First hardware run, 15 Aug 2026: 0 headings completed, 2 skipped, every
    growth check negative. Root cause is arithmetic, not behaviour.
    slam_nodom.yaml sets minimum_travel_distance: 0.2, so slam_toolbox
    refuses to PROCESS a scan taken closer than that to the last processed
    one (~0.179 m effective, allowing its 10% correction slack). The nudge
    default was 0.15 m -- below the gate. And because the script returns to
    the anchor after every attempt, the distance from the last processed
    scan collapses back to ~0, so short nudges never accumulate past it
    either. The map could not have grown; no amount of parallax helps if the
    scan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
    [map_watch.py, zero_point_scan.py]
2026-08-15 Correct mecanum lateral slip in odometry: strafe was over-reported 25%
    Measured on hardware 15 Aug 2026, tape measure against this node's own
    published transform, driven manually with no rotation:
    forward 1.00 m -> reported 1.009 m (+0.9%, accurate)
    strafe 1.00 m -> reported 1.248 m (+24.8%)
    strafe 1.00 m -> reported 1.245 m (+24.5%) repeat run
    The drive chain itself is correct and was verified before changing
    anything: /wheel_velocities_actual during a right strafe reads
    [-0.65, +0.65, +0.65, -0.65] rad/s, which is exactly what the inverse
    kinematics prescribe, and the forward-kinematics vx and wz both come
    out at precisely zero. Nothing is miswired or mis-signed.
    T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
    [odometry_publisher.py]
2026-08-15 Read lateral_scale live so per-floor recalibration needs no rebuild
    Second surface measured: floor B reports raw 1.080/1.089 per 1.00 m tape
    (scale 0.92) against floor A's 1.248/1.245 (scale 0.80). Confirmed by the
    0.80-corrected run reading 0.871 for 1.00 m -- back-solving gives raw
    1.089, matching floor B's earlier uncorrected 1.080.
    Surface dependence is the actual result, not a footnote, so a compiled-in
    constant is wrong somewhere by construction. Reading the parameter inside
    the velocity callback instead of caching it at startup makes
    ros2 param set /odometry_publisher lateral_scale 0.92
    take effect immediately -- recalibrating for a new floor becomes a
    strafe, a tape measure and on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
    [odometry_publisher.py]
2026-08-15 Default lateral_scale to 0.92 - the floor the zero mark is on
    Confirmed twice by independent routes on the surface that matters:
    an uncorrected strafe read 1.080 m per 1.00 m tape, and a 0.80-corrected
    strafe read 0.868 m per 1.00 m tape (raw 1.085). Both give 0.92.
    The zero mark sits on floor B, so every mapping and navigation run starts
    there; that is the surface the default should serve. Floor A's 0.80
    remains documented in the parameter comment for when the robot works
    there instead.
    Also measured and left unfixed: during a 1.00 m strafe the chassis edge
    walked 2-3 cm off the tape line while odometry reported X = 0.000, i.e.
    a small forward cross-coupling the ideal kinematics cannot se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
    [odometry_publisher.py]
2026-08-18 Log §17.21: two pre-run bugs fixed, the real re-zero procedure confirmed, zero_point_scan.py's first hardware runs, a 25% odometry error found and fixed, rotation still open
2026-08-18 Log §17.22: rotation stall traced to dwb_core source, confirms Spin as the fix
2026-08-18 Add tools/pathlog.py to the repo
    Hand-typed on the Pi via a terminal heredoc during the 15 Aug session
    (§17.21) as a faster iteration path than redeploying map_watch.py over
    a flaky eduroam link. It did the actual diagnostic work that session --
    the 30-49 deg heading-swing-with-no-translation table and the 44cm/4.7cm
    believed-vs-real contradiction -- but only ever existed on the Pi's
    filesystem until now.
    Claude-Session: https://claude.ai/code/session_01PUTaiTpqPggdu2bVCeBnP6
2026-08-18 Switch controller from DWB to MPPI, configured for this robot's real axes
    DWB is replaced for the source-confirmed structural reason found in
    17.22, not a preference. dwb_critics/rotate_to_goal.cpp ELIMINATES any
    trajectory carrying x or y velocity once it judges the robot at the goal
    position, and DWB's fixed sample grid meant only ~2% of candidates could
    even reach that check -- hence "No valid trajectories out of 1343!" on
    every rotation-only goal.
    MPPI cannot reach that state by construction. Verified against
    nav2_mppi_controller source rather than assumed:
    - every critic is additive (data.costs += ...), never rejecting
    - goal_angle_critic.cpp, the RotateToGoal counterpart, is a pla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
2026-08-18 Fix two latent Nav2 bugs found at MPPI bringup
    Neither was caused by the controller switch; both were exposed by it.
    1. bt_navigator.wait_for_service_timeout was 5. The unit is MILLISECONDS,
    so bt_navigator allowed every action server five milliseconds to appear
    on the DDS graph, then failed activation and aborted the whole bringup:
    "compute_path_to_pose" action server not available after waiting
    for 0.01s -> Exception when loading BT -> Failed to bring up all
    requested nodes.
    planner_server was ACTIVE and bonded ~340 ms earlier in the same log,
    so this was discovery latency, not a missing server. Whether 5 ms is
    enough was always a race; it happened not to b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
2026-08-18 Tighten goal tolerances: MPPI stops AT the boundary, not near it
    Measured on MPPI's first three hardware goals, not chosen by taste:
    0.50 m goal -> stopped 4.6 cm short (xy tolerance 5 cm)
    0.30 m goal -> stopped 4.5 cm short (xy tolerance 5 cm)
    45 deg goal -> stopped 2.80 deg short (yaw tolerance 2.86 deg)
    The consistency is the finding. SimpleGoalChecker stops as soon as the
    robot is inside tolerance, and MPPI, a cost minimiser with no term
    rewarding "closer than required", settles exactly on that boundary. The
    configured tolerance is therefore returned as systematic error on every
    goal. A 5 cm undershoot consumes most of this robot's positioning budget
    and zero_point_scan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
2026-08-19 Add tools/repeatability_test.py: automated out-and-back with tape pauses
    Phase 1's real question (Research_Journal.md sec 17.21-17.24) is whether
    the corrected odometry now matches physical reality, and needs several
    tape-measured data points per direction, not one. This automates the
    repeat: sends a fixed out-and-back goal N times, pausing each rep for a
    physical tape reading, logging TF-vs-tape error and return-to-home error
    to a CSV.
    Built from zero_point_scan.py's already-hardware-validated pieces rather
    than new logic -- send_goal_and_wait, the TF measure_pose loop, and the
    lock-file pattern are the same code, not reimplemented. The one new
    design point: every rep's outbound goal is co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
    [repeatability_test.py]
2026-08-19 Fix goal-preemption bug: cancel a timed-out goal before sending the next
    Root cause, found from exact hardware log timestamps (Research_Journal.md
    sec 17.24): send_goal_and_wait gives up waiting after a client-side
    timeout, but never told the ROBOT to stop. The goal was still genuinely
    executing server-side -- bt_navigator's own log shows it reached
    (0.10, -0.65) under its own power and would have succeeded on its own
    87.4s in (it did: "Reached the goal!", no E-stop needed). Because the
    function returned False without cancelling, the caller's next goal
    (return-to-start) PREEMPTED the still-running first one mid-drive, from
    an intermediate pose neither goal's logic expected. NavigateToPose on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
    [repeatability_test.py, zero_point_scan.py]
2026-08-19 Add tools/trajectory_viz.py: see the actual path, not just the endpoint
    19 Aug 2026: a 1.00 m strafe-right goal landed on the 1 m floor mark in X
    but ~5 cm off in Y, and the user's direct observation was that the robot
    "moved back, moved front" getting there -- the ENDPOINT was acceptable
    but the PATH was not a straight line. Nothing in the stack could show
    that. Nav2 publishes /plan and /local_plan (what it INTENDS) but nothing
    publishes where the robot actually WENT, and pathlog.py prints numbers
    rather than something you can look at. Same gap map_watch.py was built
    for on the mapping side (sec 17.21), now closed for the driving side.
    Publishes three latched topics for Foxglove (3D panel,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
2026-08-19 Fix trajectory_viz.py: split out-and-back stats into per-leg numbers
    The original summary compared the whole recording's start to its end,
    which is meaningless for the out-and-back pattern every driving tool on
    this branch actually uses (repeatability_test.py, zero_point_scan.py's
    nudge-and-return, nav_goal.py's GO/RETURN pattern) -- start and end are
    nearly the same point by design, so "endpoint error" and "path
    efficiency" over the full recording were reporting artifacts of the
    round trip, not the drive quality. First hardware use of this tool (19
    Aug 2026, a 1.00 m strafe-right-and-back) produced exactly that:
    endpoint error 0.98 m and path efficiency 0.008, neither a real finding.
    Now s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
    [trajectory_viz.py]
2026-08-19 Add twist_mux for manual override, rewrite navigation.launch.py for map+AMCL
    Three tutorial scripts on the standard SLAM Toolbox / Nav2 workflow
    surfaced two real gaps against this project's own architecture:
    1. Three independent publishers (joy_to_aislebot, phone_dashboard,
    keyboard_teleop) and, whenever Nav2 ran, cmd_vel_axis_adapter all wrote
    straight to /cmd_vel with no arbitration -- exactly the anti-pattern
    the Nav2 tutorial warns against. There was no reliable way to grab
    manual control back from Nav2 mid-drive, which made the SLAM-crash
    collision harder to interrupt than it should have been. Fixed with
    twist_mux: manual publishers now target /cmd_vel_manual, Nav2's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
    [joy_to_aislebot.py, keyboard_teleop.py, phone_dashboard.py]
2026-08-20 Update nav theory against real deployed config; add Field Manual PDF + kickoff doc
    docs/Navigation_Theory.md: the DWB-vs-MPPI section still concluded "start
    with DWB" after the project moved to MPPI weeks ago (sec 17.23) -- fixed,
    with the source-level reasoning for why DWB's rejection mechanism doesn't
    apply to MPPI's additive critics. Stack diagram updated to include
    twist_mux, cmd_vel_axis_adapter, and the AMCL branch. New sec 6 checks three
    concepts from the reference tutorials against what's actually deployed:
    frontier exploration (not used, deliberate -- manual driving encodes
    wall-hugging/no-rotation lessons an algorithm would have to re-learn), pure
    pursuit (not a standalone module,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
    [trajectory_viz.py]
2026-08-20 Journal: first hardware confirmation of loop-closure tuning -- 50cm to 2cm
    Sec 17.27, v2.22: a controlled rotate-90-drive-straight-return test on the
    physical zero mark, the first prerequisite step from sec 17.26's chain
    actually executed. 50 cm pre-tuning drift (sec 17.25) down to ~2 cm / 0.17
    deg after the loop-closure/scan-matcher tuning (635e4b6). The continuous
    trace shows the correction mechanism visibly firing and tightening as the
    robot re-approaches the origin, not just a good final number -- and also
    the first real use of the Foxglove zero_point-fixed-frame + Grid +
    trajectory_viz.py setup as intended.
    Updated Next_Session_Kickoff.md to stop telling the next session this
    tuning is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
2026-08-20 Journal + tooling: perceptual-aliasing suspect on the drive after the good run
    Sec 17.28, v2.23: the drive immediately after sec 17.27's clean 2cm result
    showed repeated large pose jumps under pure forward motion, unlike the one
    clean correction the good run showed. Named and distinguished: this is
    perceptual aliasing (spurious loop closure against a similar-looking but
    wrong location), not the benign REP-105 correction described earlier.
    Working hypothesis grounded in the actual change made: today's
    loop-closure threshold loosening (loop_match_minimum_chain_size,
    loop_match_minimum_response_coarse/fine) fixed sec 17.25's no-closures
    problem but may now accept false matches in this map's sel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
    [trajectory_viz.py]
2026-08-20 Fix trajectory_viz.py crash on exit: _leg_stats still unpacked 4-tuples
    epoch_s made samples 5-tuples but _leg_stats's summary loop wasn't
    updated, so Ctrl-C crashed with ValueError before the CSV write --
    losing an entire hardware run's trajectory data (827s, 7117 samples).
    [trajectory_viz.py]
2026-08-20 Add tools/bag_tf_diff.py: pull one TF pair's correction history out of a rosbag
    Needed to check map->odom's actual correction sizes/timing from the
    rosbag captured alongside today's SLAM log, rather than assuming a
    redrive is required after trajectory_viz.py's crash lost its CSV.
    [bag_tf_diff.py]
2026-08-20 Journal + kickoff: pose jump captured with full data, loop-closure instrumentation confirmed absent on this slam_toolbox build
    §17.29: trajectory_viz.py crash found and fixed (cost one run's CSV before
    the fix), tools/bag_tf_diff.py added, first redrive clean (map too empty),
    second redrive reproduced a 25.5cm/2.41deg jump with full bag+log coverage.
    Traced the empty log grep to a real architectural finding rather than a
    search failure: this exact slam_toolbox install (2.8.5) has no listener
    registered for automatic loop-closure events at all -- no console output,
    no topic, confirmed against both source and the live node. Kickoff doc
    rewritten so the next session starts from the pivoted pla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
2026-08-21 Fix esp32_bridge serial reader busy-loop pegging a full CPU core
    The in_waiting>0 pre-check meant readline() (with its already-configured
    0.1s timeout) only ran when data was already buffered -- when idle, the
    loop spun with zero delay. Confirmed live: esp32_bridge at 99.9% CPU,
    ~23 minutes of accumulated time against ~23 minutes of uptime, with
    nothing running but plain teleop. Removing the pre-check lets readline's
    timeout do the blocking instead.
    [esp32_bridge.py]
2026-08-21 Add Production_Architecture.md: the self-contained dashboard product goal
    Records the target the project is building toward, so day-to-day debugging
    has something to aim at and the sequencing isn't re-argued each session.
    Key decisions captured:
    - Saved map + AMCL, not continuous SLAM -- live SLAM re-anchors the map
    origin every boot, which would break named locations across restarts.
    - "Constant mapping" is NOT required for obstacle avoidance: the local
    costmap's obstacle layer is rebuilt from live LiDAR independently of
    SLAM, so the map stays stable while avoidance stays reactive.
    - Locations are taught by driving to them and naming them, never by
    describing or measuring coordinat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
2026-08-21 Update session kickoff doc: forward/backward validated, lateral drift is next focus
    Records today's first tape-measured round-trip goal test (forward/backward
    accuracy confirmed via three independent measurements converging on ~1.2cm
    net error), the open lateral-drift and Nav2-recovery-event questions, and
    the user's body-frame (base_link-origin, +Y=forward, +X=right, cm) reporting
    convention for future sessions.
2026-08-21 Journal §17.30: recovery-event root-caused, lateral drift reframed by two round trips
    Root-causes the return-leg number_of_recoveries anomaly to Nav2's
    PoseProgressChecker (~10s movement_time_allowance), not a Spin/BackUp
    event. Two independent pure-lateral round trips give a 4-leg dataset
    showing final accuracy is tolerance-limited (~2cm) regardless of
    recovery count, while recovery count itself follows a session
    cold-start pattern (3->1->1->0). Net round-trip error for the cleaner
    attempt (1.63cm) matches the forward/back benchmark's tier, reframing
    the original lateral-drift question as likely a forward-path side
    effect rather than a lateral-axis limitation.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
2026-08-21 Map system plan: pose jumps characterised, live-SLAM role reframed
    Journal §17.31 records the day's three findings, the third being the one
    that matters:
    - The compound four-waypoint test's leg 4 failed outright: 5 progress-checker
    stalls, a timed-out Spin and a timed-out BackUp (first behaviour-server
    recovery failures in this project's history), never reaching its goal.
    Legs 2 and 4 targeted the same pose and leg 2 was clean, which rules out
    goal tolerance and points at stack state instead.
    - Foxglove click-to-goal reached a working state for the first time. Its
    three silent-failure steps are now documented in Important_Commands.md,
    including the yellow-dot signature of the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
2026-08-22 Stage E: dashboard map rendering, live pose, click-to-goal; Stage B config
    Builds the map system's software half (Dashboard_Map_System.md §E), which is
    deliberately not gated on the Stage A-D hardware work.
    phone_dashboard.py:
    - Server -> client WebSocket broadcast. Until now the socket was client ->
    server only, which was the single largest piece of missing plumbing
    between the dashboard and the map product. ROS callbacks write plain node
    attributes; one async task reads them on a timer and pushes -- one writer,
    one reader, no locks, no cross-thread asyncio from a ROS callback.
    Pose at 10 Hz, map at 1 Hz and only when it actually changed.
    - /map subscription with transient_local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
    [phone_dashboard.py]
2026-08-22 Add docs/tools/map_viewer.html: standalone .pgm+.yaml viewer
    telemetry_analyzer.html's map-drop zone only unlocks after loading a valid
    run, and wants phone_dashboard.py's 13-column motor-telemetry CSV format --
    not a bare map_saver_cli save. Found by actually trying to use it during
    Stage C's map-integrity check, not by reading.
    This is the narrower tool that check actually needs: drop a .pgm+.yaml pair,
    see the occupancy grid, nothing else required. Parses PGM (P5 binary or P2
    ascii) and the flat YAML map_saver_cli writes, entirely client-side.
    Verified headless against a synthetic P5 file with a comment line in the
    header (matching real map_saver_cli output) before shipping: pixel value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
2026-08-22 Dashboard owns the mapping workflow; /odom/reset; §17.32 journal
    The §17.25 loop-closure tuning was committed 19 Aug and never reached the
    robot: install.sh:228 is the only repo->Pi path for slam_nodom.yaml,
    mapping_full.launch.py:62 loads the Pi's copy, and that copy's mtime was
    26 June. Every drive from 19-21 Aug ran slam_toolbox stock defaults, so
    §17.28-§17.31's "the tuning is over-relaxed" hypothesis was reasoning about
    parameters that were never active. §17.27's 50cm->2cm result therefore has no
    established cause; recorded as open rather than guessed at, since the robot
    was confirmed parked on and returned to the mark.
    odometry_publisher.py: new /odom/reset topic. x/y/theta were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
    [odometry_publisher.py, phone_dashboard.py]
2026-08-22 docs: first-draft APS report with figures and regeneration scripts
    Adds docs/aps_report/ — a working draft of the year-1 Annual Progress
    Report, assembled from the project's own record rather than written
    from scratch.
    APS_Report_Draft.md (~11.5k words, 13 sections):
    - NarrowAisleBot as the primary project, with the UVGI instrumentation
    work reported separately in §10 as a parallel contribution
    - every quantitative claim traced to a repository file or a DOI
    - §9 states plainly what is validated, what is provisional and what is
    not claimed, including that Phase 2 has not started and that all
    controller gains remain air-calibrated
    - §11 sets out six research gaps and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
2026-08-22 Retract §17.31's jump attribution; fix the Stage C acceptance gate
    The 22 Aug session (§17.32) found that system/slam_nodom.yaml's §17.25
    tuning never reached the robot — install.sh:228 is the only thing that
    copies it to ~/ros2_ws/slam_nodom.yaml and the Pi's copy dated from
    26 June. Every drive from 19–21 Aug ran on slam_toolbox stock defaults,
    which are stricter than §17.25's values rather than looser.
    That falsifies the causal claim in §17.31 and in Dashboard_Map_System.md
    §2: both attributed the pose jumps to §17.25 over-relaxing the loop-closure
    gate, i.e. to parameters that were never active. The observations stand and
    reproduced; the attribution is retracted and what caus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
2026-08-24 Add MATLAB Navigation Toolbox reference, cross-checked against real config
    The user extracted MathWorks' Mapping, Motion Planning, and Localization
    Algorithms documentation (mathworks.com is blocked by this environment's
    network policy, so WebFetch/curl couldn't do it directly). This doc doesn't
    re-paste that extraction — it cross-references every piece of it against
    AisleBot's actual files and hardware, ranked by whether it's buildable now,
    later, or not applicable.
    The finding that matters most: reading navigation.launch.py's own header
    comment settles what "Phase 2 IMU fusion" actually means. esp32_bridge.py
    has a complete IMU parser and ekf_params.yaml a full fusion config, but the
    IM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
2026-08-24 Close out IMU decision; link MATLAB reference into kickoff doc
    Session-end bookkeeping so a new session doesn't reopen settled questions.
    The user considered ordering a cheap MPU-6000/6050 as an IMU shortcut and
    decided against it after checking the datasheet against ekf_params.yaml:
    no magnetometer means no absolute heading reference, which is the entire
    point of wanting an IMU here, and the EKF config fuses IMU yaw as ground
    truth -- a drifting signal there would actively hurt, not help. Recorded
    in both MATLAB_Navigation_Reference.md and the kickoff doc's deferred list
    so this isn't re-litigated: no IMU purchase, orientation continues from
    wheel odometry + SLAM alone. BNO055 stays the ri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
2026-08-24 Add tools/pi_audit.sh: read-only inventory of the deployed Pi
    No dashboard path exists for "what is actually on this robot", so this is
    one SSH paste instead of thirty. It reads only — nothing deleted, moved or
    restarted — and prints disk, network, services, deployed code, run data and
    cleanup candidates with sizes.
    Section 16 (--online) is the part that matters for this project: it fetches
    every deployed source file from GitHub and reports match / DIFFERS /
    MISSING-ON-PI / EXTRA. That is §17.32's lesson made mechanical. The tuning
    that never reached the robot was found by a hand audit; this makes the same
    check a single command, and extends it to the twenty-odd files nobody
    hand-check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
2026-08-24 pi_audit.sh rev 2: fix five bugs the first hardware run exposed
    The script's own output was wrong in three places, which is worse than no
    output. All five fixes come from one real run on the Pi:
    - Thermal read the wrong way round. `have vcgencmd` was the test, but on
    Ubuntu 24.04 / Pi 5 vcgencmd is present and /dev/vcio is not, so it took
    the vcgencmd branch and printed an error message where the temperature
    should be. Reads sysfs first (always works), adds CPU frequency, and only
    tries vcgencmd when /dev/vcio actually exists.
    - Section 11 looked for params/ydlidar_params.yaml and reported it MISSING.
    install.sh:220 renames on copy — system/ydlidar_params.yaml lands as
    params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
2026-08-24 Add tools/pi_clean.sh: dry-run-by-default cleanup for the Pi
    The audit found 16 GB used of 29 GB, most of it waste a robot has no use
    for: 3.0 GB of snaps (firefox, thunderbird, snap-store), 568 MB of
    uncapped journald, 5,267 run dirs under ~/.ros/log, a superseded kernel,
    and a build tree for an SDK that is already installed system-wide.
    Dry run by default. Every destructive line goes through a `run` wrapper
    that prints the command instead of executing it unless --apply is passed.
    What it deliberately will not touch:
    - ~/aislebot_logs — run data. Copied off the Pi first, decided separately.
    - ~/slam_tests — 128 MB, unidentified. Listed, never deleted.
    - ~/ros2_ws/build — a full rebu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
2026-08-24 Fix system/ydlidar_params.yaml: it would have broken LiDAR bringup
    The file install.sh copies over the Pi's working ydlidar.yaml was flat —
    no `ydlidar_ros2_driver_node: / ros__parameters:` nesting. ROS 2 does not
    partially apply a parameter file missing that structure; it binds nothing,
    and the driver falls back to compiled defaults with the wrong baudrate,
    lidar_type and isSingleChannel for an X4 Pro. Nothing in the failure would
    have pointed at the parameter file.
    It never fired because install.sh has not run since 26 June 2026, while
    the flat file was committed 13 Aug. A reprovision, or a fresh SD card,
    would have hit it.
    Caught by auditing the robot rather than the repo — the same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
2026-08-24 Journal §17.33 and a resume-here block: the pre-drive audit session
    The robot never moved on 24 Aug. The session went to auditing and cleaning
    the Pi first, at the user's request, and that is what found both defects.
    §17.33 records: Stage B re-confirmed by hash from a second direction; the
    Pi pinned as exactly one commit behind using file size as a commit
    fingerprint (87,320 B and 10,783 B are precisely `fe2c3be`); a second
    §17.32-class config defect caught before it fired; 133 MB of MCAP rosbags
    found outside the data folder with two never opened; and 2.0 GB reclaimed
    against a 2.9 GB estimate that ran optimistic.
    Two lessons worth more than the cleanup. `curl --retry` does not retry T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
2026-08-25 Map palette: free vs unknown was 1.20:1, now 3.81:1
    Drivable space and never-seen space were nearly the same colour on the
    live map — rgb(12,40,64) against rgb(16,22,36), a WCAG contrast ratio of
    1.20:1. On a phone screen in daylight they are indistinguishable, which
    makes the one question the map view exists to answer ("have I actually
    covered this aisle, or have I just not looked at it yet?") unanswerable
    at a glance.
    Repalletted on a rule rather than by taste: luminance rises with
    occupancy probability, so darkest reads as emptiest and the ramp is
    monotonic. UNKNOWN is deliberately taken off-hue to a neutral slate,
    because it is not a low probability of occupancy — it is the absence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
2026-08-25 Important_Commands §5: the full save-and-view map workflow
    Section 5 sent you to telemetry_analyzer.html, which cannot open a bare
    map — its map dropzone only unlocks after a valid 13-column run CSV loads.
    map_viewer.html was built in §17.32 for exactly that gap and was never
    documented here.
    Now covers the whole loop: that STOP MAP *is* the save (map_saver_cli runs
    inside stop_mapping, so any other teardown loses the map outright), the
    four files one run produces, pulling them to the PC, which viewer to use
    and why, and the acceptance gate.
    The gate is the part worth having written down. §17.32 retired "no
    single-sample step > 10 cm" because it cannot distinguish a correct loop
    closu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
2026-08-25 Fix: touching the map view drove the robot; slim the panel in map mode
    SAFETY BUG, reported from hardware on both phone and desktop: with the map
    view open and no goal armed, a plain tap or drag on the map drove the robot
    exactly as the joystick does.
    Cause: #mapView is a CHILD of #joyArea. The map covers the joystick
    visually via z-index:6 and position:absolute/inset:0 — but z-index governs
    painting and hit-testing, not event propagation. Every touch on the map
    canvas bubbled up into joyArea's touchstart/mousedown handlers, which set
    joyActive and start publishing cmd_vel. mapCanvas's pointerdown never
    called stopPropagation(), so nothing interrupted the path.
    I had previously claimed t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
    [phone_dashboard.py]
2026-08-25 Save the map on SIGTERM: the shutdown path was dead code under systemd
    A 24-minute mapping run was lost today. The map only ever existed in
    slam_toolbox's memory and `systemctl restart` threw it away.
    The cleanup that was supposed to prevent this sat after uvicorn.run() and
    never executed. Proven from ~/aislebot_boot.log rather than inferred:
    between `Mapping stopped` for the previous run at 12:29:35 and
    `Phone Dashboard v2.4 — port 8080` at 12:53:33 there is no
    `Pose log written`, no `Mapping stopped`, no map_saver line — not one line
    of the shutdown path for the run that was active.
    Mechanism: `systemctl restart` SIGTERMs the whole control group. uvicorn
    catches it and starts a *grac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
    [phone_dashboard.py]
2026-08-25 Add tools/map_corpus.py: compare every mapping run at once
    Every finding in Part XVII of the journal comes from reading exactly one
    run. 70 saved maps and 73 run reports have never been looked at as a set,
    so questions like "is this map better than the last one" have only ever
    been answered by eye.
    Reads run_<stamp>.{pgm,yaml,_report.json} sets and prints one row per run:
    extent, occupied/free/unknown fractions, and metres of wall against the
    bounding perimeter. Ranked by occupied fraction, because AMCL localises
    against walls — free space contributes nothing to a scan match.
    wall_m/perim is the metric worth having. Occupied cells are about one cell
    thick, so cells * resolution approxima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
2026-08-25 Handle uvicorn 0.46's capture_signals, not just the old API
    The guarded path fell back on hardware, and the warning named the reason:
    "uvicorn.Server has no install_signal_handlers" on uvicorn 0.46.0. That
    method existed up to roughly 0.29; newer uvicorn replaced it with
    capture_signals(), a context manager wrapped around serve().
    Stubs whichever one the installed version exposes — nullcontext() for
    capture_signals, a no-op for install_signal_handlers — and raises if
    neither is present rather than silently leaving uvicorn owning SIGTERM,
    which is the entire bug this is meant to fix.
    The fallback stays. It did exactly what it was written for: the dashboard
    came up normally, warned loudl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
    [phone_dashboard.py]
2026-08-25 Important_Commands 1-2: the two network failures that cost time today
    Both bit twice each on 25 Aug and neither was written down.
    §1 — mDNS is not reliable enough to be the documented route. Four
    consecutive "Could not resolve hostname aritra-desktop.local" from
    PowerShell while the Pi was up and reachable by IP. Says to read
    `ip -4 -br addr` off the Pi at the start of each session instead, and
    records that its eduroam lease moved 10.53.1.167 -> 10.53.3.143 in two
    days — a stale address produces a "Connection timed out" that looks
    exactly like the robot being down, and so does using 10.42.0.1 while the
    Pi is on eduroam.
    §2 — `curl --retry` does NOT retry TLS handshake failures, onl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
2026-08-25 Write the map from the cached grid when map_saver_cli cannot
    The SIGTERM handler fix worked — stop_mapping() now runs on a restart, and
    the _report.json it produces proves it, since that comes from
    stop_recording() which sits AFTER the map save. But the map was still lost.
    What fails now is map_saver_cli itself. It is a separate process that
    SUBSCRIBES to /map, so it only works while slam_toolbox is alive to publish.
    `systemctl restart` SIGTERMs the whole control group at once, so slam_toolbox
    is dying at the same instant map_saver_cli is trying to read from it, and the
    save times out. A 30-second test drive with the best return-to-mark this
    robot has recorded (1.9 cm, 0.2 deg) was lost e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
    [phone_dashboard.py]
2026-08-25 Journal §17.34 and a fresh resume block: four bugs killed, state verified
    Second hands-on day. No commissioning map accepted, but the platform under
    one stopped leaking and the robot's deployed state is now fully known.
    Recorded: the map-view drive-control leak (touching the live map drove the
    robot — z-index governs painting, not event propagation, and #mapView is a
    child of #joyArea); the map palette measuring 1.20:1 free-vs-unknown, i.e.
    invisible, now 3.81:1; ydlidar_params.yaml as a flat file that would have
    bound nothing on the next install.sh run; and the map-loss chain traced
    through four separate causes to a fix that removes the dependency rather
    than working around it.
    Two ent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
2026-08-25 Kickoff: record the MATLAB lever for measurable map reliability
    Reviewed MATLAB_Navigation_Reference.md against the system as it now stands,
    rather than citing it unread as had happened twice.
    The finding worth acting on: map quality is currently *unmeasured*. §17.29
    proved this slam_toolbox build emits no per-closure signal at all, so
    §17.32's acceptance gate reduces to a human deciding whether a grid looks
    folded. That is the weak link in any claim that mapping is reliable.
    Tier 1 #2 (pose-graph residual analysis) targets exactly that, and is
    buildable because /slam_toolbox/graph_visualization already publishes the
    nodes and edges. MATLAB's approach — analyse the solved graph for out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
2026-08-25 Measure map integrity instead of eyeballing it; fix the AMCL plugin name
    §17.34 closes with the integrity check on run_20260825_113735 and
    run_20260825_151713 still undone, because settling it "needs eyes on the
    grid, not more arithmetic". That was true of the arithmetic that existed.
    map_corpus.py counts cells; it has nothing to say about whether the cells
    are arranged as one wall or as two copies of one wall.
    tools/map_integrity.py looks for the geometry a false loop closure leaves:
    D2, doubled walls, carries the verdict. Free cells between two
    near-parallel walls mean the LiDAR returned through that space, so
    something stood between them and saw both faces -- but the gap is under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
    [map_integrity.py]
2026-08-25 graph_residuals.py: the per-closure signal, as a difference not an event
    MATLAB_Navigation_Reference.md Tier 1 #2. §17.29 established that this
    slam_toolbox build emits no per-closure signal -- no console line, no topic,
    no service -- verified against source and the live node, so "was that a good
    closure?" cannot be answered by watching for the event.
    Read slam_toolbox's publishGraph() before writing anything, and the topic
    carries less than the MATLAB item assumed. Published: node id -> solved
    (x, y), and edges as two LINE_LIST markers whose points are pairs of
    endpoint COORDINATES. Not published: node orientation (toMarker hardcodes
    orientation.w = 1), edge node IDs, the edge measurement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
    [graph_residuals.py]
2026-08-26 Log wheel odometry, and analyse a whole run instead of one file at a time
    The robot recorded where SLAM thought it was and what each wheel was doing,
    but never where the WHEELS alone thought it was -- so the one comparison
    that identifies a pose-graph jump has never been recordable from a normal
    run. §17.32 needed a rosbag and a one-off tool to measure a single 39.57 cm
    map->odom jump.
    phone_dashboard's pose sampler now logs three transforms instead of one:
    map -> base_link where SLAM believes the robot is
    odom -> base_link where the wheels alone believe it is
    map -> odom the correction SLAM has applied to the wheels
    Each is looked up independently and a missing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
    [phone_dashboard.py, run_analyzer.py]
2026-08-26 The run pipeline: bundle on the Pi, view on Windows; and the NOSE bug
    THE HUD CONTRADICTED ITSELF. base_link is +X = RIGHT, +Y = NOSE (§17.10), so
    the nose bearing in the map frame is the frame yaw PLUS 90 degrees.
    drawRobot() has always known this -- it places the nose marker at
    (-sin, cos) -- but updateHud() four functions below printed the raw frame yaw
    under the label NOSE. The same panel therefore drew the nose pointing along
    map +X while the text said -90 deg, and the user caught it by comparing the
    number against the physical robot on its mark.
    This is the sixth time this axis convention has bitten the project and the
    first time it has bitten a REPORTING path rather than a control p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
    [phone_dashboard.py, run_bundle.py]
2026-08-26 Rotate the map canvas so forward looks like forward, not sideways
    The user's own read was right: pressing W drives the robot in its true
    physical forward direction, but the map view drew that motion going
    sideways on screen. Traced to why -- base_link's +Y is NOSE (not REP-103,
    per nav2_params.yaml's AXES note, "the stack's deepest open issue"), ZERO
    fixes the reference pose at frame yaw -90 deg, and at that yaw the nose
    vector in the map frame is pure +X. w2s() draws map +X as screen-RIGHT with
    no rotation. So the moment mapping starts, the robot's physical forward is
    drawn sideways -- the DATA was always correct, only the picture was
    disorienting, by accident of which way the robot happene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
    [phone_dashboard.py]
2026-08-26 Fix drawGrid()'s bounding box: it never accounted for the display rotation
    Found live, on hardware, mid-drive: the phone showed dense clusters of
    striping instead of an even 1 m reference grid. Root cause was in
    drawGrid(), the one place in the whole rotated map view that computed a
    BOUNDING BOX rather than a single point.
    DISPLAY_ROT rotates the canvas so screen-up means "the way the robot faced
    at ZERO" instead of raw map +Y. Every other draw call (bitmap, robot, goal)
    is rotation-agnostic: w2s()/s2w() compute a single local-space point, and
    the canvas transform places it correctly regardless of the rotation. Pointer
    input already accounts for this the other way -- unrotatePtr() undoes th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
    [phone_dashboard.py]
2026-08-26 scan_quality.py: measure the scan matcher's input, which never has been
    run_20260826_120314 produced 19 correction events and every one fired while
    wheel odometry reported 0.004-0.016 m of motion. Re-reading that run, the
    odom step MEDIAN is 0.0002 m against a mean of 0.0029 m -- a 14x skew, so
    the robot was stationary for more than half the 313 s run and the pose graph
    moved anyway.
    A parked robot's scan should be near-identical frame to frame. Either the
    scan is unstable, or the geometry is ambiguous enough that different poses
    score equally. Both are measurable. Neither had been measured: this project
    has instrumented the map, the odometry, the corrections, the wheels and the
    pose graph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
    [scan_quality.py]
2026-08-26 HUD: add a screen-relative UP/RIGHT readout next to raw MAP x/y
    The recurring "why does forward change X, not Y" confusion wasn't a
    frame bug -- it's that slam_toolbox's X/Y axis *names* are an artifact
    of which way the robot faced when mapping started, and happen not to
    match the screen's up/right after DISPLAY_ROT. Compose w2s() with the
    canvas rotation: screenUp = map +X, screenRight = map -Y. Print that
    derived pair (fixed to the ZERO heading, not the robot's current one)
    alongside the raw map frame so the HUD text agrees with what the eye
    sees moving on the rotated canvas.
    Also found while testing: the dashboard's E key is bound to yaw
    (rotate CW), not a rightward strafe -- D is the st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
    [phone_dashboard.py]
2026-08-26 Relabel HUD's displayed X/Y to ordinary graph convention (right=+X, forward=+Y)
    Requested directly: what pointed as +X (forward, since slam_toolbox's
    frame happened to start at -90 deg) should read as +Y, and what
    pointed as +Y (left) should read as -X. That's a fixed relabeling --
    dispX = -raw_y, dispY = raw_x -- applied only where the number is
    printed to the human. Nothing else changes: goals, camera-follow, the
    pose CSV, and every ROS-side consumer (slam_toolbox, AMCL, the map
    frame itself) keep using robotPose.x/y raw and untouched, everywhere
    else in this file. Also drops the separate screen UP/RIGHT readout
    added earlier in the session -- it's now identical to the relabeled
    MAP x/y li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
    [phone_dashboard.py]
2026-08-26 Consolidate three diverged dashboard forks into one canonical file
    Three independently-modified copies of phone_dashboard.py existed:
    this repo (dark theme), a light-theme fork patched in-session but
    never deployed, and a second light-theme fork from a separate ChatGPT
    thread that was actually running on the Pi. The third had zeroed out
    DISPLAY_ROT to fix garbled grid-line text, which also reintroduced
    the bug that constant exists to fix -- forward drive visibly moving
    the robot sideways on screen instead of up.
    The Python class PhoneDashboard(Node) was byte-identical across all
    three; only the HTML/JS presentation layer had drifted. This adopts
    fork #3's UI (the one actually in use -- scal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
    [phone_dashboard.py]
2026-08-27 Lock down the axis convention as one authoritative, verified reference
    docs/Axis_Convention.md: the full stack traced hop-by-hop against
    source (URDF -> odometry -> teleop -> TF -> Nav2 -> dashboard, plus
    the LiDAR mirror and both goal/cmd_vel adapters), not taken from any
    external tool's description. The interesting hop -- odometry_publisher
    publishing a -90deg-rotated orientation while leaving translation
    unchanged -- is verified by re-derivation, not by reading its own
    comment: for a physical point to land at the same real position in
    odom computed either way, the published rotation must equal
    theta_internal - 90deg exactly, which is what the code does.
    Net finding: three conversion poin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
2026-08-27 Rotate the odom frame so map agrees with the robot, not with REP-103
    odometry_publisher.py applied the +Y-forward relabel to the published
    orientation and twist but not to the published translation. Publishing raw
    internal translation is what defines odom's own axes, so odom -- and map,
    which inherits it at slam_toolbox init -- ended up on REP-103's axes while
    base_link had +X=right/+Y=forward. The constant -90 deg yaw was not a
    design choice, it was the seam between two frame definitions.
    Confirmed on video against the physical robot: from the ZERO mark, W took
    map X 0.054 -> 0.207 with Y pinned at 0.000, and D held X while Y went to
    -0.211. Forward really did increase map X.
    Rotate the t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
    [aislebot.urdf]
2026-08-27 Record the hardware confirmation of the odom frame fix
    Baseline captured before deploying, which is the half that is easy to skip:
    tf2_echo odom base_link read -90.076 deg with the pre-fix file hash-verified
    in place. That is the fault measured on this robot rather than inferred from
    the video or the simulation, and it could not have been captured afterwards.
    After deploying, rebuilding and restarting: [0,0,0] at 0.000 deg, rotation
    matrix exactly identity where it had been [-0.001, 1.000; -1.000, -0.001].
    Operator table driven from the dashboard against /wheel_odom, with mapping
    deliberately not started so slam_toolbox and the map frame were out of the
    loop and only the changed code was u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
2026-08-27 Close out the frame fix: all five files deployed and verified on hardware
    The last two compensations confirmed gone on the live robot: the dashboard
    reads NOSE 0.0 deg where it read 90.0, and tf2_echo map zero_point reads
    0.000 deg with an identity rotation where it read -90.000. Each of the four
    was checked individually rather than inferred from the others.
    The rebuilt grid-label helpers were incidentally confirmed on real hardware
    at a real viewport: X labels along the bottom increasing rightward, Y up the
    left increasing upward, robot drawn tall with its heading arrow up.
    Also records a deployment lesson that cost a round trip. An scp appeared to
    succeed -- 100%, no error -- while the f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
2026-08-27 The square drive: the fix demonstrated end to end, and the problem it does not solve
    Journal 17.39, plus the hardware evidence committed alongside it.
    The drive: W -> D -> S -> A from the zero mark, forward/right/back/left,
    returning to the mark. No Q/E, so no commanded rotation anywhere, which makes
    it a pure translation test of the frame. Segmented from wheel odometry, each
    leg lands on a single axis:
    W forward +0.2741 m on Y other axis +0.0001 m dyaw -0.01 deg
    D right +0.3673 m on X other axis -0.0002 m dyaw -0.06 deg
    S back -0.3118 m on Y other axis -0.0004 m dyaw -0.04 deg
    A left -0.4065 m on X other axis +0.0012 m dyaw +0.03 deg
    Cross-axis couplin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
2026-08-27 Rewrite the kickoff around the SLAM problem, and quantify it
    The 22 Aug kickoff was organised around axis and mapping-reliability work
    that is now closed and merged. Rewritten in full (643 -> 466 lines) around
    the one thing that is not closed: loop-closure reliability.
    Adds the figure that makes the problem concrete. Computed from
    run_20260827_140207's own pose CSV, each correction against the total
    odometry path driven at the moment it fired:
    t=32.2s 0.327 m correction after 0.447 m driven 73%
    t=42.5s 0.386 m correction after 0.869 m driven 44%
    t=52.3s 0.416 m correction after 1.300 m driven 32%
    Against this robot's measured 1.5% odometry error. These are conservative
    lowe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
2026-08-27 Fix graph_residuals.py losing its log close on Ctrl-C
    First live run against the node (27 Aug) exited with
    RCLError: rcl_shutdown already called. rclpy installs its own SIGINT
    handler and shuts the context down before the KeyboardInterrupt reaches
    the except block, so the finally clause's rclpy.shutdown() always raises
    on Ctrl-C -- and log.close() was sequenced after it, so it never ran.
    Nothing was lost, because the watch writer flushes after every line, but
    the traceback made a clean stop look like a crash and left the log file
    closed only by process exit. Close the log first, then shut rclpy down
    inside a try.
    Ctrl-C is the documented way to end --watch, so this fired on every
    single us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
    [graph_residuals.py]
2026-08-27 Stage C: narrow the scan-matcher search window 0.7 -> 0.3
    The jumps are the FRONT END, not loop closure. Measured 27 Aug against
    the live node, two independent instruments agreeing leg by leg.
    graph_residuals.py met the running node for the first time and reported
    moved=0, max_shift=0.000 for all 153 s of a W/S/D/A drive -- not one
    pose-graph node was ever moved by the optimiser -- while the dashboard
    HUD threw three corrections of 0.34 / 0.30 / 0.24 m with nose steps to
    -13.4 deg on the same drive. A back-end re-solve moves nodes. Nothing
    moved. So loop closure is not the mechanism, and sec 17.28-17.32's
    framing is the wrong lever for these events.
    The two instruments also agree per leg,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
2026-08-27 Record 17.40 and reorganise the kickoff around the front end
    17.40: the pose-graph jumps are the front-end scan matcher, not loop
    closure. graph_residuals.py met the live node and reported moved=0,
    max_shift=0.000 across a whole 153 s drive -- no graph node was ever
    moved -- while the HUD threw corrections of 0.336/0.302/0.240 m with the
    nose stepping to -13.4 deg on a drive with no Q or E pressed. Two
    instruments agree leg by leg: node spacing 0.36 m on W/S where the HUD
    tracks to within 6 cm, collapsing to 0.02 m on D/A where it jumps.
    Correction magnitudes are set by correlation_search_space_dimension,
    live-verified at 0.7. At 0.10 m/s seven corrections measured 0.36-0.45 m,
    every one be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
2026-08-27 Commit the three 27 Aug recordings, and retract the strafe lead
    docs/evidence/frontend_scan_matcher/ with a README carrying the
    frame-by-frame numbers off each. These are the basis of 17.40 and the
    only durable copy -- they existed nowhere but the chat upload.
    01_ws_slow_three_resets.mp4 dashboard, W/S at 0.05 m/s
    02_wsda_med_with_odom_terminal.mp4 dashboard + tf2_echo, 0.10 m/s
    03_wsda_slow_with_graph_residuals.mp4 dashboard + graph_residuals
    01 was reviewed last and is the sharpest of the three. Its three
    corrections measure 0.340, 0.340, 0.340 m -- identical to the millimetre,
    against a correlation_search_space_dimension half-width of 0.35 m.
    Corrections that do not va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
2026-08-28 Record the two-folder transfer convention, and that the Pi never needs internet
    The Pi hosts its own AP with no uplink and cannot reach GitHub; the PC
    always does the downloading. Splits the single staging folder into one
    per direction -- "for scp download" outbound to the robot, "Encoder
    readings/Analysis" inbound for data -- so a directory listing answers
    "what did I just send" and "what did I just pull" separately.
    Also states plainly that a curl.exe line in these docs is always a
    Windows command. Pasted into the Pi it hangs and fails on DNS, which
    reads as a broken URL and is not.
    Claude-Session: https://claude.ai/code/session_017Hy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
2026-08-28 Stage C validated on hardware: lateral collapse gone, mechanism confirmed twice
    The A/B 17.40 wrote down in advance, run on the identical drive with one
    parameter changed. correlation_search_space_dimension 0.7 -> 0.3, hash
    verified on arrival and confirmed 0.3 on the live node before driving.
    Largest D/A correction 0.336 -> 0.158 m. Graph chain over the same drive
    1.50 -> 3.07 m, with the lateral node collapse (0.02/0.00/0.03 m hops)
    replaced by nine hops all between 0.30 and 0.37 m. Final map error
    0.379 -> 0.008 m, final nose -12.4 -> -1.0 deg. The forward metre now
    reads 1.013 m.
    The mechanism is confirmed a second time by the ratio rather than the
    outcome: largest correction over sear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
2026-08-28 Record 17.42: 19 loop closures, map FOLDED, angular search window found open
    First drive long enough for loop closure to be structurally possible --
    1047 s, 21.85 m, 62 nodes. Nineteen closures fired, the first ever
    observed. The map came back FOLDED and is unusable for AMCL.
    With the robot physically on the mark: wheel odometry closed to 0.229 m /
    10.53 deg (1.27% of path, dead on spec), SLAM to 0.477 m / 16.18 deg.
    SLAM roughly doubled the error and applied 11.08 m of cumulative
    correction over 21.85 m driven. 17.39 reproduced at 5x scale.
    graph_residuals reported moved=0 through all 19 closures while
    run_analyzer found 48 corrections. Both correct: the tool watches
    back-end node positio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
2026-08-28 Dashboard: split trail into current/past runs, and keep sent goals visible
    After several attempts in one session the canvas became unreadable --
    accumulated trails from earlier runs on top of the live one, with no way
    to separate them short of reloading the page.
    Trajectory was one flat array with a single on/off. It is now the CURRENT
    run only; completed runs move into pastTrails as SEPARATE polylines, each
    drawn on its own. That matters beyond tidiness: concatenating them drew a
    straight line across the room between where one run ended and the next
    began, which is not a path the robot ever took. startNewTrail() also
    clears lastTrajectoryPose so the first point of a new run cannot join the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
    [phone_dashboard.py]
2026-08-28 Add wheel_forensics.py: position and slip from the encoders alone
    The encoders are the most trustworthy instrument on this robot -- 1.27%
    over 18 m in 17.42 against SLAM 0.477 m on the same drive. This makes
    that data usable directly instead of only as a summary.
    THE SLIP RESIDUAL is the reason the tool exists. Four wheels drive three
    degrees of freedom, so the wheel-speed vector is over-determined by
    exactly one dimension. The 3-D image of the real inverse kinematics
    (mecanum_teleop_asymmetric.py:75-79) has a 1-D orthogonal complement,
    derived by Gram-Schmidt rather than guessed:
    slip = FR + (Ko/Ki)*FL - (Ko/Ki)*RR - RL [rad/s], Ko/Ki = 1.142656
    Identically zero for ANY rigid no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
    [wheel_forensics.py]
2026-08-28 Write down the deploy recipe as one reusable procedure
    Five steps, same every time: Windows downloads (the Pi has no uplink),
    Windows pushes with the full destination path typed out, Pi hashes on
    arrival per file, Pi rebuilds only if the file is under ~/ros2_ws/src, Pi
    verifies against the LIVE NODE.
    Step 5 is the one that gets skipped and the one that has caught every
    silent failure this project has had: 17.32 never-deployed config, 17.34
    inert parameter file, 17.39 mistyped scp, 17.42
    goal_checker.xy_goal_tolerance not found.
    Includes a pending-deployment table with current hashes so there is one
    place to look for what is committed but not yet on the robot.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
2026-08-29 Strategic review: audit the whole stack, name the frame mistake, write Stage D
    A no-hardware session answering one question: where does this project actually
    stand, and what is the shortest honest path to tapping a point on the map and
    having the robot drive there.
    Four documents, written as one package and indexed at the top of docs/README:
    Where_We_Stand.md full-stack audit, evidence grade on every claim
    Autonomy_Endgame.md the chain link by link, 7 gates, day-by-day to 5 Sept
    APS_Study_Guide.md derivations, numbers to memorise, tiered question bank
    Vision_Indian_Market.md the narrow-aisle thesis and what would kill it
    The finding that reorders the roadmap is archit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
2026-08-29 Rewrite the kickoff as an operational checklist: SLAM first, then Nav
    The previous version was organised around the Stage C plan, which completed.
    This one is organised around the order the work actually has to happen in --
    close the angular gate, produce one accepted commissioning map, and only then
    save it and bring up AMCL for point-and-go on a fixed frame.
    Everything is copy-paste: the paste block for a fresh session, the session
    constants (login, staging folders, Pi paths, the branch's raw URL), a
    one-block health check with a table of expected readings, the five-step
    deploy with all four pending hashes, and the per-drive instrumentation set.
    Records the two-hop transfer rule explicit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
2026-08-29 Rotation in place maps nothing: G1 and G2 passed, and the drive procedure was the bug
    First hands-on day of the endgame week. Two gates passed and one
    long-standing assumption about how to drive a commissioning map destroyed.
    G1: all four pending files deployed, hashed per file on arrival, and the
    live node confirmed at coarse_search_angle_offset 0.175. Before deployment
    it read stock 0.349 -- the debt confirmed by measurement, not by report.
    G2: max correction 0.2018 m (gate <0.30) and max heading step 4.57°
    (gate <10°), against 0.696 m / -18.40° on 28 Aug. 4.57° is 46% of the new
    10.03° window where 18.40° was 92% of the old 20° one, so the gate is a
    real lever rather than a clamp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
2026-08-29 Close out 29 Aug: the camera decision, the next measurement, and Monday's plan
    Three additions to the day's record, made at session end.
    The camera proposal is declined and the reasoning is written down so it is
    not re-opened casually. slam_toolbox is 2D laser SLAM with no camera input,
    so webcam frames reach nothing in the stack; consuming them for SLAM means
    replacing slam_toolbox days before the demo, aimed at a fault already
    diagnosed and whose remedy costs nothing. Supporting objections: the control
    loop already runs 7.5-13.7 Hz against 20 requested, two UVC devices on one
    Pi bus commonly fail to negotiate, and matching a 360°-minus-90° laser field
    would need four cameras. Same reaso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
2026-08-31 run_analyzer.py: two false-positive guards from §17.44, per Kickoff §6
    1. Turn-rate guard on the wheel-spread alarm. On a tight turn the ICR moves
    toward the inner wheels, so a large arc-travel ratio is correct geometry,
    not slip -- §17.44 measured 37-56:1 on a 0.54 m radius circle with 0%
    saturation and 0% sign mismatch on every wheel. Added turn_context(),
    which derives curvature (integrated odometry yaw / path driven) and its
    implied turn radius; the wheel-spread alarm in both print_report() and
    build_verdict() is now suppressed (and explained) when curvature says the
    drive was tight, and still fires normally otherwise.
    2. Geometry guard on the doubled-wall co-loc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
    [run_analyzer.py]
2026-08-31 Journal 17.46: run_analyzer.py guards confirmed against the exact runs that exposed the bugs
    Deployed the fixed script (hash 74387d55..., matched Windows to Pi) and
    re-ran run_20260829_155447 and run_20260829_164017 -- the same two files
    whose "before" output on the still-deployed old script is what motivated
    the fix. Both false positives are gone: the 56.08:1 and 39.59:1 wheel
    ratios now read as expected tight-turn geometry (recovering the same ~0.5 m
    radius §17.44 derived by hand, this time from odometry directly), and the
    co-location check is suppressed outright on both runs because their
    trajectory extent (0.66-0.67 m) sits under the 1.0 m coincidence radius --
    a stronger, real-data con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
2026-08-31 Journal 17.47: two recon legs, a 6.8x spread, and the first return inside the G4 gate
    The commissioning drive was not driven today. Two ~165 s reconnaissance legs
    were, and they matter more than the errand they were sent on: on the same
    deployed configuration, same afternoon, same driving style, the two legs came
    back 6.8x apart on return-to-mark.
    The right leg returned to 0.085 m -- the first drive in this project's history
    to land inside G4's <0.15 m return gate -- with max correction 0.280 m, under
    the G2 threshold. The front leg returned 0.577 m with a 0.678 m maximum
    correction and 0.562 m/m cumulative, which is worse than the 0.507 m/m
    pre-Stage-D baseline the fix was built to cure. B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
    [run_20260831_155316_pose_trimmed.csv, run_20260831_155316_trimmed.csv, run_20260831_191509.csv, run_20260831_191509_pose.csv]
2026-09-01 Journal 17.48: repeat test settles intermittency over route geometry; branching to autonomy work
    The repeat test's own prediction was reproduce-near-0.577m (route geometry) or
    move-toward-0.085m (intermittency). Neither happened: the identical front-leg
    aisle, re-driven same day same config, returned 0.209m with a 0.857m max
    correction -- the worst single correction recorded in this project's history,
    on the same route that gave 0.577m/0.678m the first time. A third distinct
    result on one route rules out geometry as the primary explanation; the
    narrow-aisle degenerate-geometry hypothesis is retracted as such (geometry may
    still bound how bad a correction gets, it doesn't explain whether one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
    [run_20260901_112335.csv, run_20260901_112335_pose.csv]
2026-09-01 Rate every layer honestly, and read two old findings against each other
    The invariance result (§17.44: cumulative correction 2.80/2.85/2.86 m across
    three parameter sets, flat to 2%) and the scan-stability result (§17.45: 75%
    of rays flicker valid/invalid while the robot is parked) have never been read
    together. Together they say the matcher is not searching badly, it is being
    handed a different point cloud every scan -- which is why five sessions of
    search-parameter tuning moved the total by 2%.
    Confirms one-correction-per-node on a Nav2 run for the first time: corrections
    arrive every 0.175 m of odometry, sd 6 mm, with magnitudes spanning 6x. Regular
    timing, random magnitude.
    Names thr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
2026-09-01 Dashboard: fix the 90-degree heading bug, two silent-failure paths, and the stale-canvas click offset -- then build the test that would have caught them
    Six defects, found by auditing the file rather than by another drive.
    THE HEADING BUG. The drag handler wrote a bare atan2 (an angle measured from
    +X) into goalDrag.yaw, the same field pointerdown initialises from
    robotPose.yaw (measured from +Y, the nose). Two conventions, one variable:
    tap without dragging and the heading was right, drag more than 5 cm and it
    went out 90 degrees wrong. drawGoalMarker() then drew the arrow from +X while
    drawRobot() drew the nose from +Y -- same canvas, same frame -- so the
    picture agreed with the wrong num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
    [phone_dashboard.py]
2026-09-01 Show the operator the divergence; fix the progress-checker floor and AMCL's initial yaw; register the Stage F ablation
    Four changes, all driven by the two tape-measured runs on 1 Sep.
    DASHBOARD -- the drift block. Both runs finished 9-10 cm off the physical
    mark while the pose card read zero, because map->odom had absorbed the error
    and Nav2 closes its loop on the map pose. Nothing on screen was wrong: the
    grid measures 76.00 px per 0.5 m with zero variance, the footprint is drawn
    to +5 mm of the URDF, the trail top to +7 mm over 2 m, and the card matches
    the raw transform to four decimals. The screen only ever held the estimate.
    odom and map->odom are already looked up on the same tick for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
    [phone_dashboard.py]
2026-09-01 Retract the Stage F took-effect check: the 0.175 m baseline was mis-measured
    The check claimed baseline corrections arrive every 0.175 +/- 0.006 m and that
    the spacing should widen toward 0.200 m with use_scan_barycenter off. The
    0.175 came from differencing hypot(odom_x, odom_y) -- displacement from the
    origin -- on an out-and-back route, which shrinks on the return leg. It was an
    artefact of the route's shape, not a property of the pose graph.
    Measured along the path instead: baseline 0.441 m (sd 0.192), Stage F run
    0.391 m (sd 0.147). Indistinguishable at every detection threshold tried
    (0.5 / 2 / 5 mm). The test cannot discriminate and is withdrawn rather than
    quietly restated -- only r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
2026-09-01 Split the LiDAR chain out of the SLAM launch, so AMCL can exist at all
    Until now the only thing that started the scanner was mapping_full.launch.py,
    which also starts slam_toolbox. And navigation.launch.py -- the AMCL path --
    carries its own warning that it must never run alongside that file, because
    both publish map->odom. So the only launcher of the LiDAR was the one thing
    AMCL forbids. AMCL would have come up, activated, and sat with no /scan
    forever, looking like an AMCL fault when it was a launch-topology fault.
    Nothing had caught it because AMCL has never once been run.
    sensors.launch.py now owns lidar + scan_relay + zero_point_tf. mapping_full
    includes it and adds slam_toolbox; navig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
2026-09-01 Journal 17.49, rewrite the kickoff around where we actually are, and teach the axis guard where ZERO_POINT_YAW moved to
    17.49 is the longest entry in a while because the day earned it: the tape
    measure closed the loop on the front-end problem from two directions, six
    dashboard defects were found by audit rather than by another drive, and three
    of the day's failures were self-inflicted and are recorded as such -- a build
    that printed "2 packages finished" while destroying two nodes, a confidently
    wrong expectation about the DRIFT card, and main sitting 27 commits stale until
    it caused an external audit to be written against a four-session-old tree.
    The kickoff is rewritten in full. The 29 Au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
    [verify_axis_chain.py]
2026-09-02 Capture the live 2 Sep runtime state, and a self-audit skill for knowing when to stop
    The stack was up and healthy — mapping session live, Nav2 all-nodes-active,
    odometry zeroed on the ground mark, nothing driven yet — and the session
    driving it was about to be restarted. None of that state lived anywhere a
    new session could read it.
    docs/Session_Handoff_2026-09-02.md records it as observation rather than
    recollection: what is running and how we know, what is merely believed and
    how to check it, and the four things that must not be done to a live
    mapping session. It also carries the obstacle-override test forward in
    enough detail to be executed cold, including the failure mode that worr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
2026-09-02 Stop the trail drawing a frame rewrite as if it were motion
    Two circle runs on 2 Sep drew a spiky starburst on a robot whose wheels
    held a 0.507 m circle to 5.2 mm RMS. The pose was never wrong: map_x is
    odometry rotated and shifted by map->odom, and slam_toolbox rewrote that
    correction 17 times per run, 3.66 s apart. The renderer joined the samples
    either side of every rewrite, painting up to 0.198 m of straight line for a
    robot that had moved 0.005 m in the same tick.
    That is a line nothing travelled, in any frame, and it is the same class of
    fault as the 90 degree goal arrow: the picture agreed with the number and
    both misdescribed what the robot did. An hour of a hardware session went o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
    [phone_dashboard.py]
2026-09-03 Stage G: the first six values ever changed upstream of the scan matcher
    Five sessions of tuning moved search parameters and §17.44 found the
    cumulative map->odom correction invariant to 2% across three of those sets
    (2.80 / 2.85 / 2.86 m). §17.45 then measured the input for the first time:
    74.8-78% of rays flip valid/invalid between consecutive scans with the
    robot stationary, 47.4% valid. A search cannot be tuned over an objective
    function that moves. These are the input-side levers.
    ydlidar_params.yaml
    frequency 10.0 -> 6.0 +67% angular density, 500 -> 833 pts/rev
    range_max 12.0 -> 10.0 correctness; Appendix B item open since §17.6
    slam_nodom_stageB.yaml
    max_l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
2026-09-03 Dashboard: draw the live LiDAR scan, and put its flicker on the HUD
    §17.45 established the central fact of the whole SLAM investigation
    offline, after the fact, from a recording: 74.8-78% of rays flip
    valid/invalid between consecutive scans WITH THE ROBOT STATIONARY, and
    only 47.4% are valid at all. That number has never been visible while
    driving. It is two integers and one comparison against the previous mask,
    so it costs nothing to compute at the source.
    Node side: subscribe /scan_reliable (not raw /scan - same QoS reasoning as
    everywhere else in this stack), decimate to ~240 beams, broadcast at 5 Hz
    over the WebSocket path that already carries pose and map. Bearings travel
    implicitly a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
    [phone_dashboard.py]
2026-09-03 Stage G: the deploy recipe, the live-node verifier, and the predictions
    docs/StageG_Deploy.md is the operational document: what changed and the
    measurement behind each value, the scp recipe with a per-file sha256, the
    two-place LiDAR params trap (mapping_full.launch.py:71 reads the INSTALL
    share, not src/, so copying to one alone changes nothing or is reverted),
    the drive procedure, and how to score it.
    Its §3 registers every prediction BEFORE the drive, per standing rule #2 -
    including the one expected to go the wrong way. Three G4 criteria should
    improve and unknown% should get WORSE than 82.9% against a gate of 50%,
    because a shorter ray paints less free space. And the falsifier is stat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
2026-09-03 Three defects found reading the Stage G diff back before deploying
    None of these would have thrown. All three would have been believed.
    1. scan_publish_hz was declared and never read. The rate was hardcoded as
    `tick % 2` in the broadcast loop, so the knob read as working and was
    not one. That is §17.32 in miniature: the difference between what a
    config says and what is running. Now computed into scan_tick_divisor
    at init and actually used.
    2. The HUD dereferenced liveScan.trust unguarded. updateHud() runs inside
    drawMap(), so a missing field would not have blanked one line, it would
    have thrown out of the whole canvas render mid-drive. The field is
    always sent today,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
    [phone_dashboard.py]
2026-09-03 The verifier failed three correct values, and found one real ceiling
    First live run of verify_live_config.sh, 3 Sep. Five failures, three of
    them the script's own bug and one of them the most useful result of the
    day.
    THE SCRIPT BUG. ros2 param get prints Python-style booleans (True/False,
    capitalised). The verifier compared them against lowercase literals with a
    plain bash =, so use_scan_matching, use_scan_barycenter and do_loop_closing
    were all reported FAIL while being correctly deployed. A verification tool
    that fails correct configuration is worse than none, because the next
    instinct is to "fix" a config that was never broken. Both sides are now
    lower-cased before comparison, and the i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
2026-09-03 CHURN is not flicker: correct a comparison that was never valid
    The dashboard read VALID 50%, FLICKER 17% against §17.45's 74.8-78%, and
    the obvious reading was a 4.5x improvement in scan stability. It is not,
    and the error was in the instrument's labelling, not the sensor.
    scan_quality.py computes flicker_pct = (ever_valid - always_valid) /
    ever_valid over a WHOLE CAPTURE WINDOW: of rays that returned anything at
    all, what fraction were not perfectly consistent across every scan. A ray
    dropping out once in 200 sweeps counts fully. The dashboard computed beams
    that changed state since the IMMEDIATELY PREVIOUS sweep, over ALL beams. A
    windowed cumulative metric is mechanically far larger th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
    [phone_dashboard.py]
2026-09-03 scan_window_sweep.py: 84.8% vs 76% was never a comparison either
    First scan measurement since Stage G came back UNSTABLE at 84.8% flicker
    against §17.45's 74.8-78%, which reads as a regression and is not evidence
    of one.
    flicker_pct = (ever_valid - always_valid) / ever_valid. always_valid needs
    a ray valid in EVERY scan of the window, a set that can only shrink as the
    window grows, so the metric rises monotonically with capture length. §17.45
    does not record the length it used, so the comparison cannot be closed from
    the journal at all.
    scan_window_sweep.py replays a saved capture at every window length and
    reports the curve, so any historical figure with a known window can be
    matched ex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
    [scan_quality.py, scan_window_sweep.py]
2026-09-03 The scan input is unchanged: 77.4% against §17.45's 74.8/78.0
    scan_quality.py's default is --seconds 10.0, which at the measured 11.45 Hz
    is 114.5 scans. The sweep gives 76.6% at 100 scans and 79.5% at 150, so the
    10 s equivalent interpolates to 77.4%. §17.45 measured 74.8% and 78.0% at
    the same mark. Today lands inside that spread, 0.6 pp from the upper one,
    while §17.45's own two captures of one unchanged spot differ by 3.2 pp.
    Not better, not worse. Identical within the instrument's demonstrated
    reproducibility. Stage G's input-side levers changed nothing about scan
    stability — unsurprising, since frequency turned out inert and range_max
    12->10 removed nothing (0.0% beyond 10 m). Th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
    [scan_window_sweep.py]
2026-09-03 17.54: map->odom did not move once, across 2225 samples and 222 seconds
    run_20260903_162401, the first drive on Stage G.
    corr_x/corr_y/corr_yaw min = max = 0.000000 over the entire run
    correction events 0
    The registered prediction was "corrections ~= 0, the 0.175 m metronome
    stops". Measured: zero to six decimal places. Baseline being replaced is
    §17.49's 9 corrections at 0.175 m +/- 6 mm and §17.42's 48 events with a
    2.80-2.86 m cumulative total invariant across three parameter sets. This is
    not an improvement in degree — use_scan_matching: false removes the
    mechanism, and the mechanism was the whole observed fault.
    Reconstructed from the pose CSV rather than the operator'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
2026-09-03 17.55: the video says the robot did not turn; the odometry says 3.85 degrees
    Photogrammetry on the run video against run_20260903_162401's endpoint.
    odometry (HUD, pose CSV) -3.85 deg 1.84 cm
    floor L-brackets (static) -0.03 deg ~0.3 cm
    floor grout orientation +0.00 deg —
    The method was validated before its result was believed, and the FIRST
    ATTEMPT FAILED, which is why the second is trustworthy. Pass one measured
    the robot's own wheels against the frame and found no rotation; a
    validation frame where the HUD read -28.3 deg also returned ~0 deg, which
    is impossible. That frame showed why: the camera is on the robot's own
    mast — the robot sits still whi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
2026-09-03 17.56: perimeter drive — zero corrections again, phantom yaw replicates
    run_20260903_174352. 482 s, 12.04 m, one full turn, out to 3.66 m and back.
    A structurally different route from §17.54's two circles, same Stage G
    config, verified live before the drive.
    map->odom zero again, exactly: corr min = max = 0.000000 across 4769
    samples, 0 events. Two runs now, 698 s and 18.5 m combined, on completely
    different geometry, not one correction. §17.54 was not an artefact of the
    tight-circle geometry §17.44 flagged as degenerate.
    Odometry closure 9.9 cm over 12.04 m = 0.83% of path, against the 1.27%
    spec. Heading closure -4.49 deg.
    THE PHANTOM YAW REPLICATES, method validated independently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
2026-09-03 docs: rewrite the APS report against the current project state
    The first draft was written at journal §17.11. The project is now at
    §17.56, 146 commits later, and the picture changed enough that the
    report needed rebuilding rather than patching.
    What changed in substance:
    - Nav2 has run. First autonomous forward-and-return round trip on
    14 Aug; DWB replaced with MPPI on a source-level argument; tapped
    goals reached in 21-26 s inside a live mapping session. The old
    draft said "configured, never run" throughout.
    - New section 8 covers the SLAM front-end investigation, which is the
    strongest research content of the year: the invariance result
    (cumulative correction 2.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
2026-09-04 Hardware roadmap: collision ring, battery %, charging docks — planning only
    docs/Hardware_Roadmap.md consolidates the IMU/optical-flow/E-stop/
    collision-ring list argued out over this session's chat, written down
    before it was lost, plus three subsystems researched at the operator's
    request:
    Collision ring: the brief was precise (full 360, ~1 m, not for
    path-planning, a hard override alongside SLAM) and it changes the part
    choice from the earlier narrower sketch. ToF (VL53L5CX, ~8-12 units) over
    ultrasonic, because ultrasonic's specular-reflection failure against
    oblique or soft cargo surfaces is a real risk for a system whose only job
    is "must not miss" — and at 1 m range, VL53L5CX's u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
2026-09-04 README: the branch table described branches that no longer exist
    Named claude/nab-hardware-calibration, claude/nab-raspi-ros and
    claude/narrowaislebot-prototype-arch-m9y94t, none of which exist in the
    remote, and claimed PR #4 was open when it has been closed for some time.
    Someone had already cleaned those branches up outside of any recorded
    session; the doc just never caught up.
    Replaced with the branches that actually exist after today's PR #11 merge:
    main (current through Stage G), claude/aps-report-draft-2nywbq (PR #12,
    untouched), and claude/nab-charging-safety-hardware (new, cut from the
    merged main). Named the three branches whose work is now fully absorbed
    into main but which the g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
2026-09-04 Branch table: nab-charging-safety-hardware -> amr-and-slam
    Renamed by create-new + retire-old, since there's no branch rename in this
    toolchain and the old branch had zero unique commits (confirmed via
    git log main..old-branch before touching anything) -- nothing lost.
    The scope changed with the name, at the operator's direction: this branch
    is reliability-of-the-AMR first (closing G4, settling whether loop closure
    fires at all under use_scan_matching: false), not charging hardware.
    Charging/battery stays in docs/Hardware_Roadmap.md as deliberately
    deferred future work -- worth automating once the vehicle itself is
    reliable enough to be worth docking, not before.
    claude/nab-charging-safety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
2026-09-04 docs: drop the stock photo from the deck's title slide
    Canva's generator placed one of its own stock robot renders on the title
    slide. It has been deleted. The deck now contains no image that did not come
    from this project: the title slide points at cw_000.jpg from the 11 August
    occlusion trial, which shows the whole platform in three-quarter view, and
    every other slide takes a figure generated from this repository's own logs.
    Also records that Canva exports this design to .pptx, so the deck can be
    edited in PowerPoint as well as in Canva.
    Claude-Session: https://claude.ai/code/session_01GdqQXT72WJbdHFT2fVEBaP
2026-09-04 docs: build the seminar deck as a PowerPoint file, with the images in it
    Canva has no way to take a file from a private repository, so the deck it
    holds has empty image panels. Building the same 16 slides locally removes
    that limit: the platform photograph from the 11 August occlusion trial and
    fifteen generated figures are embedded, and the file opens in PowerPoint,
    Keynote or Slides with speaker notes on every slide.
    The content is unchanged from the Canva deck and still matches the report
    number for number. Layout is a figure column on the left and two text cards
    on the right, which fits every figure from 1.46 to 2.44 aspect.
    deck_src/preview.py exists because LibreOffice will not run h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
2026-09-07 docs: add the HeXBuddy manipulator bridge document
    Copies over the design/research context for HeXBuddy, the cargo-picking
    arm being developed in a separate repo to sit on this chassis, so a
    session working here has the full picture. Corrects one stale citation
    on import: the drive loop is 100 Hz on the current aislebot_esp32.ino,
    not the 50 Hz of the archived v2 firmware HeXBuddy's doc cited.
    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
2026-09-07 docs: flag HeXBuddy's tipping model as pessimistic against this chassis's real mass
    The tipping-margin table anchors on a 25 kg chassis. AisleBot's measured
    mass (APS_Report_Draft.md \S5.1) is 45.54 kg, so real margins are likely
    better than modelled at every reach/payload combination. Worth a rerun
    before it drives a purchase decision.
    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
2026-09-09 Organize uploaded SolidWorks chassis CAD into cad/
    Move the chassis assembly, mecanum wheel assemblies (native + STEP),
    and motor part from the repo root into cad/{chassis,wheels,motor}/,
    with a README cataloguing what each file is, what can open it, and
    how it lines up with the dimensions already in docs/Master_Reference.md
    §2.1 — plus a discrepancy in that section worth checking against the
    model (250mm labeled as track/2d vs the table's 2*d = 315.38mm) before
    it goes into report diagrams.
    Claude-Session: https://claude.ai/code/session_01PN1XNweWgAdWc7nHXdkf3J
    [AislebotBasePlatform_SteelChasis.SLDASM, MecanumLeftWithHub.SLDASM, MecanumRightWithHub.SLDASM, am-3479La 6 SR Mecanum Left with Standoffs.STEP, am-3479Ra 6 SR Mecanum Right with Standoffs.STEP, geared_DC_motor.SLDPRT]
2026-09-09 Add dimensioned OpenSCAD chassis replica built from CAD screenshots
    Replace the abstract kinematics-only sketch with a parametric model
    that reproduces the actual shape from the SolidWorks screenshots:
    base plate, centre reinforcement bracket, and the four wheels at
    their real l1/l2/d offsets, with dimension lines, a centre mark, and
    centrelines on the model itself.
    Numbers come from two sources, tagged in the file: confirmed values
    already in docs/Master_Reference.md, and measurements taken directly
    off the screenshots and calibrated against those confirmed values
    (cross-checked to ~2%). Plate thickness, bracket standoff height,
    bolt hole diameter, and one unidentified small component are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
    [aislebot_chassis.scad]
2026-09-09 Drop the OpenSCAD reconstruction; index the CAD that lives in Drive
    The report figures should be real CAD imagery, not generated geometry,
    so the parametric OpenSCAD model and its renders are removed (still in
    history if wanted).
    In their place, cad/README.md now indexes what is actually in the Drive
    folders: the SolidWorks render JPGs of the steel chassis, the .SLDDRW
    dimensioned drawing sheets, and the DWG sheet-metal flat patterns. The
    drawing sheets are the real dimension source and would settle the two
    open questions noted there. The Monika_*.pdf files were checked and are
    patent figure sheets, not dimensioned drawings.
    Drive file contents cannot be fetched from this environment (netw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
    [aislebot_chassis.scad]
2026-09-09 docs: resolve references 3-4 and add a wheel-fault-tolerance gap
    References [3] and [4] were placeholder titles awaiting their source
    papers; both were supplied, so they're now full, DOI-verified
    citations (Lin & Shih 2013; Cao et al. 2022), closing that line on
    the pre-submission checklist. A third paper supplied alongside them
    (Vlantis et al. 2016, ICRA) was not already cited: it demonstrates
    fault-tolerant control for one or two disabled wheels on a real
    4-mecanum-wheel platform, but like the other two assumes a symmetric
    layout untested on this asymmetric one. Added as reference 21 and a
    new Gap 7 in Sec. 12.1, explicitly marked literature-motivated rather
    than measured on this platform,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
2026-09-09 Extract exact chassis geometry from the DXF exports in Drive
    DXF is plain text, so unlike the SolidWorks binaries it can be pulled
    through the Drive connector and parsed directly. Two files read:
    AislebotChasisLowerPlate.DXF is the base platform: a plain 1000 x 250 mm
    rectangle, confirming Master_Reference.md 2.1 against the CAD. Its twelve
    wheel-mount holes sit in six 54 mm pairs on rows at y = +/-112, whose
    midpoints are -333/0/+403 on one row and -403/0/+333 on the other. That
    is l1 = 403 and l2 = 333 recovered independently from the drilling, with
    the 70 mm asymmetry visible directly in the hole pattern.
    This also settles the 250 vs 315.38 mm ambiguity: the plate is 250 mm
    wide, the wh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
2026-09-09 Dimension the chassis top-view render
    Marks length, plate width, width over wheels, and the centre-to-wheel
    offsets directly on the SolidWorks render rather than on a redrawing.
    Pixel anchors were found by luminance thresholding the render, not placed
    by eye. The four wheel centres recovered that way land within half a pixel
    of where the CAD puts them (l1 = 403, l2 = 333 scaled by the plate's own
    1000 mm length), which is what establishes the render is to scale and the
    anchors are right. Width over wheels measures 374.7 mm off the render
    against 375.4 mm from the CAD geometry, a 0.2% agreement.
    The render's gradient backdrop is flattened to white so the crop leaves no
    seam. Background sits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
2026-09-10 Add the deployed-electronics circuit diagram
    Vector SVG plus a 2x PNG, generated from a script so pins and part numbers
    stay editable. Every value is taken from the repo's own hardware docs
    rather than from a generic mecanum reference: Master_Reference.md 2.3/2.5/
    3.1/3.2/4.1-4.3, Bench_Test_Map.md's 8-channel wiring tables, and
    RMCS-2086_Encoder_Replacement.md.
    Two things a generic diagram would get wrong, both shown explicitly:
    - The front motors no longer use their integrated RMCS-2086 encoders,
    which failed. They run GTK08 units whose A/B wire colours are swapped
    relative to the rear encoders. Bench_Test_Map.md records that this
    exact mix-up already corrupted a channel on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
    [circuit_diagram.py]
2026-09-10 Add a one-shot knowledge-base document for NotebookLM/Gemini ingestion
    A single dense markdown file summarizing the whole project — hardware BOM,
    exact kinematic geometry, wiring/circuit-diagram facts, firmware state,
    ROS2 architecture, the SLAM/Nav2 debugging saga condensed to its load-bearing
    findings, CAD provenance, repo map, branch state, and a glossary.
    Written to sit alongside the GitHub repo as a NotebookLM source, since a
    GitHub connector tends to ingest a repo shallowly rather than the full file
    tree. Every section names the source file(s) it was drawn from, and flags
    docs/Research_Journal.md as the actual primary record this file compresses
    rather than replaces. Also documents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
2026-09-10 docs: add the real dashboard screenshots alongside the reconstructed maps
    Figure 29 rebuilds the three commissioning maps from the saved PGM/YAML,
    which is reproducible but is a re-rendering. This adds Figure 30: the
    operator's own annotated dashboard screenshots of the same three drives
    (docs/evidence/monday_recon/, docs/evidence/tuesday_repeat/), embedded
    exactly as captured rather than regenerated, since the hand-drawn
    annotation (SLAM path, wheel path, correction events, doubled walls)
    cannot be reconstructed from source and isn't meant to be - it's the
    primary record Figure 29 was checked against, kept beside it rather than
    replaced by it, the same way Figure 24 embeds real photographs.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
2026-09-12 docs: replace Fig 1/2 with real CAD render and circuit diagram
    Fig 1 was a matplotlib reconstruction of the chassis plan view; it is now
    cad/renders/chassis_top_dimensioned.png, the actual SolidWorks export,
    dimensioned from coordinates read directly out of the DXF
    (cad/extracted_geometry.md). The caption now also notes that l1=403mm/
    l2=333mm are independently confirmed twice over (foundational paper +
    DXF hole pattern), and flags the one real discrepancy: the render's
    375.4mm over-wheels dimension vs. the 360mm tape measurement used
    elsewhere, resolved in favour of the tape measurement per the same
    precedent set in cad/README.md.
    Fig 2 was a matplotlib software-dataflow diagram; it is now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
2026-09-14 Rewrite the APS report around all three objectives
    The existing draft covers NarrowAisleBot with the UVGI work as a parallel
    section. The seminar presents three objectives, so this draft restructures
    around them: the robot, the air-disinfection node, and the contactless
    fatigue framework, with NAB dominant in length and emphasis.
    Objectives 2 and 3 are written from their own repositories (IoT-Box and
    Fatigue-Detection-) rather than summarised from memory. Objective 3 is
    reported as a formulated and audited problem statement with no hardware,
    because that is its actual state.
    Adds a claims table grading all twenty load-bearing claims as measured,
    single or reasoned, so the strong results ar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
2026-09-14 Phase 2-3-4 push: the roadmap, G7's code, and two traps removed
    The lab day should be execution, not construction, so the buildable
    parts are built here first.
    docs/Phase_234_Push.md is the plan. Its two load-bearing findings:
    1. The commissioning drive must be SHORT, which inverts the previous
    procedure. With use_scan_matching false the pose is pure wheel
    odometry, so error accumulates monotonically at the measured 1.1-1.5%
    of path with nothing to correct it. G4's return-to-mark gate is
    0.15 m, so the gate itself caps the drive at 10 m at the worst
    measured rate. Every previous attempt ran 18-22 m and was failing a
    criterion the drive length had already put out of reach.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
    [phone_dashboard.py]
2026-09-14 Phase 2 without an IMU: the argument, and the tool that validates it
    The first APS closes Phase 2 without inertial measurement. This is the
    case for that, written to be defended rather than to excuse a missing
    part, plus the measurement that backs it.
    The argument in one line: the sensing question was narrowed this year
    from "add sensors" to a measured deficit, and at the corridor scale this
    platform works in, the binding error term is LiDAR precision rather than
    odometry drift. An IMU addresses the term that is not binding.
    Supporting it:
    - Phase 2's own deliverable asks for a drift figure, a ground-truth
    comparison, and an account of WHICH SENSORS ARE REQUIRED. The third
    clause cann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
    [scan_range_envelope.py]
2026-09-14 Update the local scp folder path: mecanum robot ROS2 -> NAB
    The Windows-side folder root was renamed. Every documented Windows path
    under it (for scp download, Encoder readings/Reading, Encoder
    readings/Analysis, Encoder readings/Reading/Ground Test) moves with it.
    12 lines across tools/README.md, Autonomy_Endgame.md,
    Important_Commands.md and StageG_Deploy.md.
    Claude-Session: https://claude.ai/code/session_01CmTeJWyFJdQ3niY6pmLAQS
2026-09-14 Fix nab_pid_logger.py connecting to the LiDAR instead of the ESP32
    Live failure, 14 Sep: --test plant connected to /dev/ttyUSB2 and ran
    13.6s before erroring "device reports readiness to read but returned no
    data". ttyUSB2 is the YDLIDAR X4 Pro, not the ESP32.
    _autodetect() matched on description string (CP210/CH340/Silicon
    Labs/FTDI). The ESP32 and the LiDAR both report a CP2102 chip with the
    same factory serial (system/99-aislebot.rules' own comment says so), so
    a description match cannot tell them apart and list_ports.comports()
    has no guaranteed order. This project already solved this exact
    ambiguity months ago by pinning each device to its physical USB port in
    99-aislebot.rules, produc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
    [nab_pid_logger.py]
2026-09-14 Objective 1.3 closes: plant time constant measured, Kp recomputed
    tools/nab_pid_logger.py --test plant, 14 Sep 2026, wheels in the air,
    six PWM steps per motor, 1251 samples (plant_20260914_164105.csv on the
    Pi). tau measures ~0.09 s against the 0.18 s this project had assumed,
    landing almost exactly on PID_Calibration.md's own pre-registered 0.08 s
    row, which already predicted the shipped Kp=45 would prove over-damped
    and sluggish rather than unstable. It has.
    One measurement excluded and the reason stated: RR and RL both show
    tau=0.154 s at their smallest step (PWM +-70), which neither FR nor FL
    reproduces at the same step. Coarser encoder plus a step close to Kstat
    breakaway makes a firs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
2026-09-14 Kp=45 confirmed by closed-loop sweep; a settling-time bug found and fixed
    Live sweep, 14 Sep 2026: Kp candidates 22 and 26 (from the newly measured
    plant time constant) tested against the shipped 45, four setpoints, four
    motors, three gain sets, 48 rows. This project's own registered
    prediction was that both candidates would settle faster than 45 with
    overshoot flat or reduced. That prediction was wrong, and cleanly:
    Kp=45 posted the lowest overshoot in all 16 of 16 setpoint-motor rows,
    averaging 43-54% less overshoot than either candidate. Steady-state
    error differences were inside the encoder's own velocity quantum and
    not a real signal.
    Reasoned explanation, stated as reasoning rather th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
    [nab_pid_logger.py]
2026-09-14 Add the raw Kp verification data: plant ID + three-way closed-loop sweep
    Four CSVs from the 14 Sep 2026 session, uploaded by the operator and
    independently re-verified against the console output before filing:
    - plant_20260914_164105.csv: open-loop plant ID, 6 PWM steps per motor
    - sweep_kp{45,22,26}_ki250_kd0.5_*.csv: closed-loop step sweep, shipped
    gains vs the two candidates the plant run implied
    Independent re-derivation from raw samples (plateau-windowed on the true
    setpoint sequence, not the tool's own step-boundary bookkeeping) matched
    the console-printed overshoot and steady-state error exactly across all
    48 setpoint-motor rows. Kp=45 confirmed as the better gain.
    Also found and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
    [plant_20260914_164105.csv, sweep_kp22_ki250_kd0.5_20260914_165007.csv, sweep_kp26_ki250_kd0.5_20260914_165022.csv, sweep_kp45_ki250_kd0.5_20260914_164953.csv]
2026-09-14 Fix pi_audit.sh: stale default branch, missing launch files
    Root cause of today's sensors.launch.py confusion: it doesn't exist on
    this Pi's src/ tree at all. mapping_full.launch.py -- which the dashboard
    successfully used for a live drive today -- resolves sensors.launch.py
    through the identical get_package_share_directory() lookup that a direct
    `ros2 launch mecanum_robot sensors.launch.py` just failed on. Since that
    worked, the deployed mapping_full.launch.py is almost certainly an older,
    self-contained version predating the split into a separate sensors file,
    not the version currently in this repo.
    pi_audit.sh --online is exactly the tool for catching this and wasn't
    being used, partly b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
2026-09-14 Dashboard LiDAR tuner: live scan_relay parameters, with measurement
    §17.45 measured the sensor, not the algorithm, as this project's binding
    constraint: 47.4% of beams valid, 74.8-78% flicker, with the robot
    STATIONARY. slam_toolbox is handed a materially different point cloud
    every sweep, which on its own explains §17.44's finding that the
    correction total was invariant to 2% across three parameter sets. The
    matcher could not tell those parameter sets apart because the input noise
    dominated all three.
    There was no way to do anything about that from the robot. This adds one.
    scan_relay.py gains a quality gate and live parameters:
    range_floor_m / range_cap_m consumer-side range polic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
    [phone_dashboard.py]
2026-09-14 Update plan, cleanup fixes, and the nodding-LiDAR paper assessment
    docs/System_Update_2026-09-14.md answers the "one command that upgrades
    everything" request, including the parts of it I am not doing:
    - No mass apt/kernel upgrade nine days out. The CP2102 port pinning (the
    ESP32 and the YDLIDAR share a VID:PID AND the factory serial 0001), the
    DS3231 RTC, and the netplan AP priority are all load-bearing and all
    reachable by a kernel or udev change. Each is recoverable; none is
    recoverable in an afternoon.
    - "Go through all branches" has a short answer: there is one branch. I
    checked. Nothing is hiding anywhere.
    - "The best SLAM, the best NAV" treats the wrong cons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
2026-09-14 Add the missing navigation.launch.py row to the deploy hash table
    It was omitted because I hashed it at the wrong path the first time round
    (mecanum_robot/launch/ rather than mecanum_navigation/launch/). A deploy
    table with a hole in it is worse than no table: the one file you cannot
    check is the one you stop checking.
    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
2026-09-14 Session handoff, 14 Sep: what's deployed, what's not, tomorrow's blocker
    Written at the day's pause point. Records what got verified on the actual
    hardware this session (five files deployed and confirmed byte-identical,
    new scan_relay.py confirmed live via its own parameter list, the stray
    mapping session and the verification test both confirmed cleanly stopped)
    against what only got planned or proposed and never run (the apt upgrade,
    the log backup, pi_clean.sh, the actual LiDAR tuning session itself).
    The one item flagged ahead of everything else: slam_nodom.yaml was not
    touched today, so the Stage G scan-matcher-off configuration this whole
    project's G4 attempt depends on is not confirme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
2026-09-15 Fix a Python/JS escaping collision that killed the ENTIRE dashboard
    Found live on the robot, 15 Sep: the ROS pill read a permanent red X and
    nothing on the page responded -- no joystick, no map, no buttons. The
    server was completely healthy (HTTP 200, nothing in the service log), which
    ruled out a crash. The browser console had the real answer:
    `Uncaught SyntaxError: unexpected token: identifier`.
    The cause: a line inside DASHBOARD_HTML (a Python triple-quoted string)
    read `sensor\'s` -- a literal backslash-apostrophe, meant to be an escaped
    apostrophe inside a single-quoted JS string. That is valid PYTHON escape
    syntax, and Python's own string-literal parser consumes it while compiling
    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
    [phone_dashboard.py]
2026-09-15 Add evidence: 15 Sep circular loop drive, kept as recon not scored G4
    Operator drove a closed circle instead of the planned 8 m rectangle
    (no room for it) with the LiDAR quality gate left unconfigured. Filed
    under docs/evidence/ following the monday_recon precedent: useful and
    report-worthy, but not one of G4's three budgeted attempts since it
    deviated from the registered §4.2 procedure and had no pre-registered
    prediction.
    Claude-Session: https://claude.ai/code/session_01Ce8riBgupexkGaDbPf8bh1
2026-09-15 Update circular-loop evidence with real frame-decoded trajectory data
    Decoded the drive video with PyAV (self-contained, no system ffmpeg
    needed) and sampled 16 frames across the clip, reading pose/valid/churn
    directly off the dashboard HUD at each timestamp. Fits a clean circle,
    radius 0.50 m, path length ~3.14 m, which also settles the offset-units
    question from the operator's tape measurement: a 3.0 m offset is
    geometrically impossible on a 1 m diameter loop, so the reported -3.0
    must be centimeters, consistent with this project's own 1.1-1.5%
    closure-rate model applied to the actual path length.
    Claude-Session: https://claude.ai/co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
2026-09-15 Record G4 grading result for the circular-loop run: SUSPECT, fails on coverage
    map_integrity.py on run_20260915_121818: unknown cells 77.6% against the
    <50% G4 gate (fails badly), doubled walls 1.03% (narrowly over the 1.0%
    gate, tool's own thresholds are provisional), verdict SUSPECT on fork
    density and axis alignment, neither yet visually checked against
    map_viewer.html. Return-to-mark passes comfortably via the earlier tape
    measurement. Confirms the prediction made before running the grader: a
    3.14 m loop can't cover a 9.8x9.9 m room regardless of LiDAR gate
    settings, so the fix is more path length, not a gate change alone. Kept
    as evidence, not counted against the three budgeted G4 attem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
2026-09-15 X4 PRO datasheet review: the "<2% of range" spec is not the vendor's number
    Read the official EAI X4PRO datasheet (DOC#:01.13.001700) in full. Three
    findings, two of which touch the APS report:
    1. The "<2% of range" figure repeated in ~13 places across the docs, both
    report drafts and the deck does not appear in the datasheet. The actual
    spec is 2 cm absolute below 1 m, 3.5% relative from 1 to 6 m, and NO
    accuracy specification above 6 m. So 1.6 m is 56 mm not 32 mm, 5 m is
    175 mm not 100 mm, and the 200 mm at 10 m figure is unsupported. This
    also settles the linear-vs-quadratic discrepancy Phase2_Without_IMU
    flagged: neither model is the vendor's, which is piecewise.
    2.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
2026-09-15 Run 2 telemetry: pose is near-perfect, coverage is the only failing gate
    run_20260915_131800, same 1 m circle, 91.7 s, with pose CSV and map files.
    Pose side, computed from the supplied CSV: 3.163 m path, closure 6.4 mm
    (0.20% of path), yaw closure -0.27 deg, and map->odom correction exactly
    0.0000 m across all 885 samples. Zero corrections is Stage G's registered
    prediction landing exactly. The 0.20% closure is far better than this
    project's historical 1.1-1.5% band, which suggests a smooth continuous
    circle is much kinder to mecanum odometry than stop-start out-and-back
    routes. That is what makes multi-lap driving viable.
    Map side: doubled walls improved 1.03% -> 0.8% and now passes; for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
    [run_20260915_131800_pose.csv]
2026-09-15 Add drive_circle.py: exact-radius, exact-lap-count circle driver
    The commissioning space only fits a small circle, so the G4 coverage plan
    is repeated laps rather than a longer route. That only works if every lap
    is the same lap: a hand-driven circle varies between runs, which would
    make a coverage A/B meaningless.
    Publishes a constant Twist on /cmd_vel_manual at 20 Hz for exactly N laps
    then zeroes. Radius comes from radius = speed / yaw rate, so the script
    computes the yaw rate rather than leaving it to the operator's thumb.
    Carries the axis warning prominently: /cmd_vel_manual is REP-103 (linear.x
    forward) while the base_link/odom/map frames are +X right, +Y forward.
    Both are true, they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
2026-09-15 Run 3: deliberate wobble doesn't grow coverage, points at repetition instead
    run_20260915_140253, operator held yaw slider at mid-deflection instead of
    a fixed radius, to test whether varying radius covers more room than a
    circle. It doesn't, measurably: trajectory extent only grew from 1.0x1.0 m
    to 1.20x1.32 m despite the radius transiently reaching 0.89 m, and unknown
    cells landed at 78.3%, statistically flat against run 1's 77.6% and better
    than run 2's 84.6% only because run 2's circle was smaller. Closure got
    worse as expected with a less smooth path: 80.6 mm (2.00% of path) against
    run 2's 6.4 mm (0.20%), though still comfortably inside the 0.15 m gate.
    Fork density nearly quadrupled (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
    [run_20260915_140253.csv, run_20260915_140253_pose.csv]
2026-09-15 Add Project_Status.md: phase/gate flowchart, status chart, evidence index
    A living status document requested to track where each phase and G-gate
    stands, with a Mermaid flowchart and a regenerable matplotlib chart
    (f_status.py, following the report's existing style.py color language:
    green=done, amber=partial, red=blocked, grey=not started).
    Leads with an explicit answer to the LiDAR-configuration question: tight
    range cap (~1.5 m) is for Phase 4 navigation/obstacle-avoidance, where
    short-range trustworthiness has real safety weight; loose gate stays for
    Phase 3's G4 mapping, where coverage is the actively failing gate and a
    tight cap would make it worse. Both are correct at once for differ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
2026-09-15 Run 4: first drive under the corrected plan, best result of the day
    run_20260915_154615: RAW gate (not STRICT, not unconfigured), same
    circle, driven 3 laps instead of once. First run since reversing the
    STRICT-for-commissioning advice.
    Pose: 9.526 m path (3 laps), closure 1.9 mm (0.020% of path), better than
    run 2's single-circle 0.20% over 3x the distance. map->odom correction
    zero across all 2255 samples, consistent with use_scan_matching: false.
    Coverage: 73.0% unknown, the lowest of all four runs today (77.6, 84.6,
    78.3, 73.0), and the first data point under the actual corrected plan.
    Tied back to run 2's ray-cast finding: theoretical floor from this exact
    circle with unlimited repeti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
    [run_20260915_154615.csv, run_20260915_154615_pose.csv]
2026-09-15 Run 4 full grading: doubled walls regressed to 2.9%, tied to far-range noise
    map_integrity.py on run_20260915_154615.pgm: doubled walls jumped to 2.9%
    (from 0.7-1.03% on runs 1-3), a clear fail rather than borderline. All
    three flagged clusters sit 3-5.5 m from the zero mark, exactly the range
    band Phase2_Without_IMU.md §5.2.1 already measured as unreliable (scatter
    55-200 mm beyond ~2.5 m). Three laps means that same distant, noisy wall
    got hit three times under a fully loose RAW gate, and some fraction of
    those far returns landed differently enough to draw as doubled lines.
    This reveals a real tension: RAW's coverage benefit (73.0% unknown, best
    of 4 runs) and its cost (doubled walls) ar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
2026-09-15 Run 5: AISLE A/B against run 4, fixes doubling but breaks free-space connectivity
    run_20260915_164745: same trajectory as run 4 (odom extent matches to the
    cm), only the LiDAR gate changed, RAW -> AISLE. Clean isolate-one-variable
    comparison.
    Pose: 2.5 mm closure (0.026% of 9.53 m), matching run 4's 1.9 mm.
    Confirms pose is gate-independent, since it comes purely from wheel
    odometry with use_scan_matching: false.
    Map: doubled walls improved from 2.9% (run 4, failing) to 1.1% (near the
    gate), confirming the persistence-filter hypothesis. But the verdict got
    categorically worse: SUSPECT -> FOLDED, because the map now has 2
    disconnected free-space regions, a defect not seen in any run today.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
    [run_20260915_164745.csv, run_20260915_164745_pose.csv]
2026-09-15 Run 6 completes the RAW/AISLE/STRICT A/B/C: RAW wins outright
    run_20260915_172133: STRICT, same trajectory as runs 4-5 (odom extent
    matches). Verdict FOLDED, doubled walls 0.9% (passes, best of three,
    confirming the persistence-filter hypothesis monotonically: RAW 2.9% ->
    AISLE 1.1% -> STRICT 0.9%), but 2 disconnected free-space regions, same
    defect as AISLE, not present under RAW. Unknown cells 75.9%, statistically
    flat against RAW's 73.0% and AISLE's 74.6%.
    With all three gate settings now tested on an identical trajectory, this
    settles the question decisively rather than provisionally: RAW is the
    correct standing choice, not a lesser-evil compromise. Tightening the gate
    buys negligible u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
    [run_20260915_172133.csv, run_20260915_172133_pose.csv]
2026-09-15 Add DeepSeek_Brief.md: a second-opinion brief written to invite disagreement
    Self-contained for a model with no repo access. Carries every number from
    its own measurement, and says out loud where a number is thin.
    The parts that do not exist anywhere else in the repo:
    - The no-IMU argument is flagged as possibly post-hoc. It was written after
    the constraint existed and its own header says it is written to be
    defended in a review, which is the condition under which motivated
    reasoning hides. The error budget is also questioned directly: cumulative
    dead-reckoning drift and zero-mean per-ray scatter may not belong in one
    table as comparable quantities.
    - Closure error on a closed ci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
2026-09-15 Stage H: matching back on, and Gap 3 closes from data already on disk
    Two things, one decision and one measurement.
    STAGE H. system/slam_nodom_stageB.yaml goes use_scan_matching false -> true.
    Not yet deployed; the robot runs Stage G until it lands as
    ~/ros2_ws/slam_nodom.yaml. New sha256 recorded in the handoff for the
    deploy check.
    This does not reopen Stage G. That prediction was tested and landed: eight
    runs, map->odom corrections exactly zero, every sample. The front end was
    the fault. What is untested is different, and the config's own note already
    said so before anyone meant to act on it: the matcher has NEVER RUN WITH
    THE 5 m CAP. Stage G changed the flag and the cap in one drive,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
2026-09-15 Stage H verifier, and an answer to the outside opinion
    verify_live_config.sh still expected use_scan_matching: false. Run after a
    correct Stage H deploy it would have printed DO NOT DRIVE on a good config,
    which is the worst possible failure mode for a gate whose whole job is to
    be believed. Flipped to true, and the banner and usage line now say H.
    Section 6 replaced. It used to grep ROS headers to guess whether loop
    closure survives matching-off; that question is moot under Stage H. It now
    reads `ros2 topic info /slam_toolbox/graph_visualization` and fails if the
    publisher count is zero. That settles 17.56's open hypothesis (that
    matching-off suppressed pose-graph construction entirely) fr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
2026-09-15 Pose-graph check is a WARN, not a FAIL
    Committed it an hour ago as a hard FAIL, which was wrong. A zero publisher
    count on /slam_toolbox/graph_visualization would have exited 1 and printed
    DO NOT DRIVE on a config that is otherwise correct.
    The graph topic is one instrument for detecting loop closure. slam_toolbox's
    own log is a second and step changes in the pose CSV's corr_* columns are a
    third. A quiet graph topic costs instrumentation; it does not make the drive
    measure the wrong thing, and Stage H's other criteria (correction magnitude,
    closure at the mark, doubled walls, FOLDED verdict) are all unaffected.
    Blocking there would have been the same failure this script exists to
    prevent,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
2026-09-15 Stage H verified live; two stale expectations corrected
    Deploy verified against the running node at 20:14: use_scan_matching True,
    do_loop_closing True, max_laser_range 5.0. verify_live_config.sh reports
    12 pass, 0 fail, 1 warn, the warn being the known 11.44 Hz free-run.
    Important_Commands.md section 8 told the operator that `tf2_echo odom
    base_link` MUST read -90.000 degrees after a re-zero. It reads 0.000, and
    has since 27 Aug. The -90 was a seam, not a convention: odometry_publisher
    rotated the published yaw while leaving translation in the internal REP-103
    frame, so odom's axes disagreed with the transform it advertised. The fix
    (odometry_publisher.py:257) rotates position too and drop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
2026-09-15 MAP sends slam_toolbox's log to /dev/null; use /rosout instead
    The evening handoff's Stage H section says to watch slam_toolbox's own log
    during the drive for loop closure messages. That cannot be done through the
    dashboard. phone_dashboard.py:3270 launches mapping_full.launch.py with
    stdout=subprocess.DEVNULL, stderr=subprocess.DEVNULL, so the entire launch
    tree's logging is discarded at the source and is not recoverable after the
    fact.
    This matters more than a normal doc bug because loop closure firing is
    Stage H's single most valuable success criterion, and one of the two
    instruments named for detecting it does not exist on the path the operator
    actually uses. The pose CSV's corr_* colum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
2026-09-15 Stage H scored: REVERT. The corrections are a metronome, not a matcher
    run_20260915_202258, 82.5 s, 3.193 m, one continuous circle. Deployed and
    verified live before the drive (12 pass, 0 fail, 1 warn).
    Three of four pre-committed revert triggers fired. 14 of 17 corrections
    were >= 0.15 m with a 309 mm maximum, against a 0.15 m window half-width.
    map_integrity returned FOLDED on 6.6% doubled walls. Return to mark was
    206.7 mm. Not one keep criterion was met except the one predicted to be
    neutral: unknown held at 72.6% against 73.0%.
    The head-to-head is the headline. Same drive, same wheels, same scans:
    wheel odometry alone closed to 16.2 mm over 3.193 m; odometry plus matching
    closed to 20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
    [run_20260915_202258.csv, run_20260915_202258_pose.csv]
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2026-09-15 Report: Stage H lands in section 8; four stale datasheet claims corrected
    New section 8.5, "Putting the front end back, and measuring what it does".
    Carries the pre-registered revert criteria verbatim, the matching off/on A/B
    table (6.4 mm against 206.7 mm closure on two 3.16 m circles one percent
    apart in path length), the within-run odometry control that rules out a bad
    prior, the 0.183 m correction cadence with its 1 cm spread, and what that
    cadence implies about loop closure never having fired. Ends with the
    description of the system that can survive an examiner asking to see a loop
    close, which the report did not previously have.
    Section 8.3's closing line recorded loop-closure-survive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
2026-09-16 v2 becomes the submission draft; Stage H ported; pipeline repointed
    Operator decided v2. Ported across: the new 4.6.5 on putting the front end
    back and measuring it, the phantom-yaw table extended from two runs to three
    with the four-model proportionality analysis, the forward pointer from 4.6.3
    whose loop-closure hypothesis the Stage H drive answered, the Gap 2 paragraph
    on why a ray-scatter-against-drift error budget compares the wrong two
    quantities, and the G2/G4 gate rows. Old 4.6.5 renumbered to 4.6.6 and the one
    cross-reference to it fixed.
    Four instances of "rated at under 2 % of range" removed from v2 as well. The
    figure is absent from the X4 Pro datasheet, which gives 2 cm absolut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
2026-09-16 Regenerate fig26/fig27: source already said "four sensors", PNG still said "five"
    f_iot.py's own drawing code and caption text were already corrected to
    "four sensor packages" (SCD40, MPM10-AS, MQ-135, GUVA-S12SD), but the
    committed PNG predated that fix and still rendered "five". The report text
    already flagged this and asked for a regeneration on a machine with
    matplotlib. Ran the unmodified script and committed the output.
    Claude-Session: https://claude.ai/code/session_018Rq7SH2yyXHL25hgCc3wZN
2026-09-16 Add author-preserving-edit skill for revising evidence-bearing prose
    The academic-writing skill covers drafting. This one covers the separate
    job of rewriting text that already carries measurements, failed
    experiments, decision chains and citations, where a readability pass can
    silently delete the content.
    Rules are derived from a worked failure case: a paraphrase engine run
    over the report's Chapter 1 opening dropped the reference datum from a
    45-degree roller angle, deleted "without any change in wheel
    orientation", replaced "point-symmetric rather than mirror-symmetric"
    with a gesture, widened a bounded claim, softened "must" to "should",
    strengthened "relaxing" to "eliminates", broke a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
2026-09-16 Rebuild the tracking and layer-status figures against current data
    Two figures carried claims the repo's own logs no longer support, and both
    were redrawn from the data rather than edited.
    f_track2.py (Figure 7). The step-transient inset sat on top of the trace it
    annotated, had its x-axis ticks stripped, and was never mentioned in the
    caption, so the one thing it existed to show -- the timescale of the
    transient -- was the one thing a reader could not recover from it. Replaced
    the inset with a third panel carrying a real time axis relative to the step
    edge, and annotated it with the measured numbers: the wheel reaches within
    5 % of the commanded -2.207 rad/s in 0.20 s (four 20 Hz samples),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
2026-09-16 Correct the scan-matching row: Stage H was driven and scored
    The layer-status figure said a 5 m-cap matcher configuration was "prepared
    and not yet driven". It was driven on 15 Sep at 20:22:58 and scored against
    pre-committed criteria; docs/evidence/stageH_15sep/ carries the run, and
    Audit_2026-09-15_night.md summarises it. The claim came from reading
    Session_Handoff_2026-09-15_evening.md, which was written before that drive,
    without checking for a later document.
    The result is stronger than what the row previously claimed. Same 3.193 m of
    driving, same wheels, same scans, robot physically returned to the mark:
    wheel odometry closed 16.2 mm (0.51 %), the matched estimate 206.7 mm
    (6.47 %).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
2026-09-16 Fix three figures that contradicted the report text
    Found by inspecting the exported PDF rather than the DOCX, which is where
    these were visible.
    f_maps.py (Figure 13). The figure plotted the 31 Aug and 1 Sep drives while
    Section 6.4 quoted acceptance-criteria figures from the 15 Sep runs. Figure
    and text described different experiments and nothing said so. Rebuilt from
    docs/evidence/circular_loop_15sep/, and every number in the panel titles is
    now computed from the grid shown: 84.6, 78.3 and 73.0 % unclassified. Panel
    subtitles also switched from "% of cells observed" to "% unclassified" so the
    figure and the text state the same quantity in the same direction.
    f_campaign.py (Figure 12). T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
2026-09-17 Correct stale controller values and a band claim in three figures
    circuit_diagram.py. The ESP32 box advertised "PID @ 50 Hz, Kp50 Ki30 Kd3".
    Every value was wrong against the deployed aislebot_esp32.ino, which has
    PID_LOOP_HZ 100.0, Kp 45.0, Ki 250.0, Kd 0.5. The 50 Hz is the mini
    prototype's rate; Ki=30 is a superseded v2.0 value the firmware's own
    comments record as having failed ("the integral moved ~3 PWM per second,
    far too slow"). The box also omitted the feedforward entirely while the
    report describes the controller as PID with a two-term feedforward, so it
    now carries Kff 37.3-38.4 PWM/(rad/s) and Kstat 8 PWM per motor.
    Also stripped four internal document references from that figur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
    [circuit_diagram.py]
2026-09-17 Re-lay out the electronics diagram for a portrait page
    The diagram was landscape (1780x1310) placed in a portrait page, so it
    scaled to the text width and its body text rendered at about 2.9 pt. Page
    size alone could not fix that: even rotated to fill a page, the text reaches
    only 4.0 pt, and 6 pt would need a figure 12.9 in wide.
    The density was the problem rather than the layout. The right-hand column
    held 560 of the 1780 units and carried reference data rather than
    architecture: the ESP32 driver-pin list, the encoder channel map, and a
    deployment note about the microcontroller supply. All three moved into the
    report text, where the pin data is now a table that can be read and searched
    at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
    [circuit_diagram.py]
2026-09-17 Fix the Kff/Kstat unit label in the electronics diagram
    The ESP32 box carried "Kff 37.3-38.4 + Kstat 8 PWM/(rad/s)", which put both
    terms under one unit. They do not share one. The firmware applies
    pwm_ff = Kff[i] * w_target + Kstat[i] * sgn(w_target)
    so Kff is a slope in PWM per (rad/s) and Kstat is a plain PWM offset covering
    breakaway friction - it does not scale with velocity at all. Split them onto
    two lines with their own units. The box had room for a seventh line; the
    lowest text now sits at y+133 inside a 186-unit box, so nothing moved.
    Values re-checked against aislebot_esp32.ino: Kff {37.3, 38.4, 38.3, 38.0},
    Kstat {8.0, 8.0, 8.0, 8.0}, PID_LOOP_HZ 100, Kp 45, Ki 250, Kd 0.5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
    [circuit_diagram.py]
2026-09-17 The four fixes that matter, with paste-ready replacement text
    Six days out, the audit's ten findings are too many to act on usefully.
    Section 5 cuts it to four and writes the replacement wording, so the edits
    are a copy and paste into Word rather than a re-derivation.
    The order is by what a committee member is likely to catch and what it
    costs when they do. The photogrammetry inversion is first because as
    printed the report claims a physical heading error the measurement
    disproves, and because sections 6.6 and 7.1 already state it correctly, so
    the document disagrees with itself on the result that carries the Year-2
    plan.
    The remaining six findings are named and deferred on purpose, and th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
2026-09-17 Separate scientific weight from seminar risk in the ranking
    Section 5 orders the findings by what a committee is likely to catch in an
    hour, and says so, but it does not say that this is a different order from
    scientific severity. Asked directly whether these are scientific
    discrepancies, and the honest answer moves two items.
    The ground-load result is first on scientific grounds rather than third: a
    pre-registered prediction that holds on one floor run of three, with one of
    the other two outside the band, is a reproducibility problem and not a
    wording problem. Figure 8's step response moves up for the same reason, and
    section 5 defers it, which is correct on seminar risk and wrong on
    valid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
2026-09-17 The corrected report, rebuilt from the PDF with the audit's fixes applied
    The .docx behind the submitted PDF is not in this repository, so applying the
    corrections meant rebuilding the document from the PDF rather than retyping
    it. The build reads every text line with its font, size, position and inline
    emphasis, reassembles paragraphs, applies each edit as an asserted find and
    replace, and writes a .docx that matches the measured layout: A4 with 25.4 mm
    margins, Times New Roman 12 justified at single spacing with 9 pt after,
    Calibri Bold headings at 16 and 14, Times Italic 9 captions under a centred
    label, tables ruled only above the header, below it and under the last row,
    Cambria referenc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
2026-09-17 Correct the stale ground-load claim, and note the merges are done
    Claim 5 in v2's claim table still read "all four motors inside the band",
    which the corrected figure, the recomputation from the CSVs and the submitted
    report all contradict. The claim table is where anyone goes for a summary, so
    it is the worst place to leave a number that has moved, and slides get built
    from it. It now says what the data says: three of four inside, the rear-right
    0.3 points above, on the first of three floor runs, with the two later runs
    giving 14 % and 3 %.
    The audit's section 0 asked for the figure branch to be merged before anyone
    regenerated figures. That is done, along with the audit branch, so the not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
2026-09-19 Add a plain-language explainer for every figure in the report
    docs/aps_report/Figures Explained.docx walks through all 14 numbered
    figures in report order, each with the image (pulled from the high-resolution
    set), what it shows, the key numbers in plain English, and why it earned a
    place in the report. Written for viva preparation rather than as a
    replacement for the report itself: it explains, it does not argue.
    Two things are called out honestly rather than smoothed over, matching the
    report's own caveats: Figure 8's 0.20 s step-response figure includes some
    of the commanded value's own ramp time, and Figure 9's 24% ground-load
    increase came from one of three floor runs whose other two g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
2026-09-19 Add the proposal's two infographics to Chapter 3
    Both were generated with an AI tool from the proposal text, and both captions
    say so. The tool's watermark is left in place rather than cropped, which is the
    honest version of the same disclosure.
    Figure 20 opens 3.1 with the two halves of the problem side by side, and
    Figure 22 sits beside the graphical abstract in 3.3, reading the same framework
    left to right with each modality against the indicator it supplies. The design
    figure and the roadmap shift to 23 and 24; every reference to them moved with
    them and the checks confirm it.
    Chapter 3 now runs 42 to 47 and the document is 54 pages.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
    [content.py]
2026-09-19 Final scrutiny pass: figure repairs, three real errors, nine repetitions
    Figures. Panel (c) of Figure 1, the prior work's kinematic schematic, was
    cropped by the tightening pass and lost its arrowheads and part of the box; it
    is re-cut from the source PDF with a lower threshold and is now complete.
    Figure 18's control law was drawn as a single-valued step, which is wrong: the
    node holds its state between the two thresholds, so the law is two-valued
    there. It is now a proper hysteresis loop with a rising and a falling branch.
    Figure 21 is the fuller framework infographic, replacing the proposal's
    graphical abstract. It arrived with a misspelling ("IR thremometer") and with
    the data-protectio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
    [content.py]
2026-09-19 Second pass: academic register, chapter openings, captions, tables, equations
    The Introduction now carries the motivation for all three strands in one
    run, so the standalone Motivation section under it is gone and its prose
    sits in the argument it belongs to: the aisle constraint, why mecanum, why
    asymmetric, what the prior work left open, then the two supporting strands
    and the objectives. The chapter openings that repeated that argument no
    longer say Motivation: 1.1 is Problem and Design Rationale, 2.1 is System
    Context and Design Rationale, 3.1 is Problem Statement and Research Goal,
    and 1.1 no longer restates the scale question the Introduction has just
    made.
    Register. Fourteen sentence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
    [content.py]
2026-09-21 docs: add seminar prep Q&A log (PID derivation, formula provenance, pose-estimation on/off video check, map-blocker chain)
    Digest of a pre-seminar walkthrough of APS_Report_Draft_v2.md and
    PID_Calibration.md, including an informal frame-by-frame check of two
    phone-camera clips against the dashboard's own DRIFT readout, confirming
    the Stage G matching on/off mechanism. Not a source of record — flagged
    as such in the file, defers to the report and journal.
    Claude-Session: https://claude.ai/code/session_01D2HC1awiJZy34tJfqKKsDX
2026-09-22 APS seminar deck and study guide, built from the submitted report
    * Build the APS seminar deck from the submitted report
    51 slides for the 23 Sep seminar, generated from src/content.py rather than
    edited by hand, so the deck and the report cannot drift apart silently.
    Three stories one after another, in the order the report tells them: the
    narrow-aisle robot (slides 4-33), environmental monitoring (34-41), the
    contactless fatigue proposal (42-47), then what the year established, what is
    open and the plan. Every number on a slide was checked back against the
    submitted PDF; the one unverified token is "20,000", which the report writes
    as "twenty thousand" and its own Figure 15 writes as "20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
    [build.py, content.py, layouts.py, metrics.py, qa.py]
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2026-09-22 docs: add corrected-wiring variant of the PID/feedforward block diagram (unused, reference only)
    An exploratory rewrite of figure_src/f_pidloop.py that draws the three
    wiring gaps found during seminar-prep review: feedforward's input arrow
    from the setpoint, anti-windup's output into the integral term, and D
    sourced from a separately-filtered measurement instead of the shared
    error node. Decision was to keep the original fig33_pid_loop.png as
    submitted and defend the simplification verbally rather than resubmit
    a new figure, so this variant is kept as reference only, not wired into
    the deck or report build.
    Claude-Session: https://clau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
2026-09-22 docs: add standalone builder for the merged "Where the gains came from" slide
    The live .pptx has hand-added slides (per-wheel velocity loop, feedforward
    fit, gains provenance) that aren't in build_deck.js's SLIDES array, so
    running the full generator would overwrite them. This is a separate,
    one-off script producing a single replacement slide, same fonts/colours/
    geometry as the real deck, that merges the old "feedforward was fitted"
    and "where the gains came from" slides into one, dropping the figure and
    the superseded Kp-argument section, for manual copy-paste into the deck.
    Claude-Session: https://claude.ai/code/session_01D2HC1awiJZ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
2026-09-26 Organise the repo now that the first APS is submitted and passed
    Archives the pre-submission draft history in docs/aps_report/ (superseded
    report variants, the v1 16-slide deck and its JS pipeline, the v2 draft
    pipeline) into docs/aps_report/archive/ via git mv, so it's kept for
    provenance but no longer competes with the actual submitted PDF and the
    seminar_final/ deck pipeline for "which one is current."
    Rewrites docs/aps_report/README.md, which still described the folder as
    a pre-submission working draft, to instead point at what's actually
    current: the submitted PDF, the seminar_final/ deck, and the aps_study/
    study guide.
    Also moves two loose, unrelated project files off the repo root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
    [content.py, qa.py]
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2026-09-30 docs: add live graph check to the firmware inventory, fix wheel_odom label
    Runtime output of check_ros.sh confirms the inventory graph, finds topics not
    yet listed, and shows slam_toolbox takes odometry from TF only.
    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
2026-09-30 Nav2: controller odom_topic and MPPI accel limits; correct the BackUp reading
    controller_server listened to /odom, which nothing publishes; point it at
    /wheel_odom. MPPI's acceleration limits were its 3.0 m/s^2 defaults against
    the smoother's 0.3; match them. Docs: BackUp drives along base x, which on
    this robot is sideways (left), not into the rear wedge.
    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
2026-10-01 docs: 1 Oct hardware session, Part 2 of the handoff; add tools/bag_cmd_chain.py
    Part 2 records what the 1 Oct session established: the planner works, the
    start pose is not in collision, and a bag of the 0.6 m goal shows MPPI's own
    output is about 4 mm/s while the smoother, collision monitor, axis adapter
    and wheels pass it through unchanged. It lists the live state (MPPI
    acceleration limits set to stock values, not saved to the file), the next
    steps in order, and the rules that bit us.
    tools/bag_cmd_chain.py reads a rosbag2 .mcap and prints the speed at each
    stage of the command chain per time bin, plus collision_monitor state
    changes. Checked against the real bag: reproduces the table in t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
    [bag_cmd_chain.py]
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2026-10-05 Dashboard: NAV2 start/stop button replaces the LIDAR tuner; LiDAR fixed at a 2.5 m cap
    scan_relay: range_cap_m defaults to 2.5 m (accuracy over range: 12-32 mm
    scatter inside 2 m, 55-200 mm and unrepeatable past 2.5 m). Persistence
    stays off (the 15 Sep A/B/C showed both gates fold the map). The defaults
    are now the configuration, pinned by scan_relay_gate.py section 13.
    phone_dashboard: NAV2 launches nav2_slam.launch.py as a managed process
    group (log in ~/aislebot_logs/nav2_*.log). It refuses until MAP has run
    30 s, reports UP only when the lifecycle manager says every node is
    active, and stops with cancel + SIGINT (SIGKILL after 20 s). MAP stop,
    E-STOP and shutdown stop Nav2 before the m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
    [phone_dashboard.py]
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2026-10-05 Switch the whole stack to standard REP-103 axes (+X nose, +Y left), dashboard map still nose-up
    Stage 1 of docs/Axis_Refactor_Plan.md: offline edits only, nothing deployed.
    base_link, odom and map now share the wheel kinematics' frame. Conversion
    from the old frame: x_new = y_old, y_new = -x_old, yaw numerically unchanged.
    Core: odometry_publisher publishes its internal frame as is; scan_relay
    yaw_offset 270 -> 180 and rear mask 135..-135 (the mirror stays); URDF
    chassis, cushion, wheels, laser; both Nav2 footprints; cmd_vel_axis_adapter
    is an identity until stage 6 deletes it.
    Dashboard: DISPLAY_ROT = -PI/2 keeps the nose up the screen, vecToYaw and
    yawToVec are plain atan2 and cos/sin, f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
    [aislebot.urdf]
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2026-10-06 docs: 6 Oct handoff, Pi half-switched state, hazard and next steps
    Records what is deployed and hash-verified, what is staged but not
    deployed (stage 4), what was verified on the live node, the mixed-frame
    Nav2 hazard, the CALIBRATE warning, and the PC download fix
    (curl --tls-max 1.2). CLAUDE.md now points at it.
    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
