AritraD11/NarrowAisleBot/(notices)

Notices in the files:
docs/Research_Journal.md:
(dashboard v2.2 desktop mouse+keyboard, self-hosted AisleBot-Pi AP, CycloneDDS Jazzy syntax fix, repository consolidation + rename to NarrowAisleBot, MIT license, checksum-verified-against-Pi discipline).
